markyen001/DR3-Resubmission/example images/20180928_162810.jpg

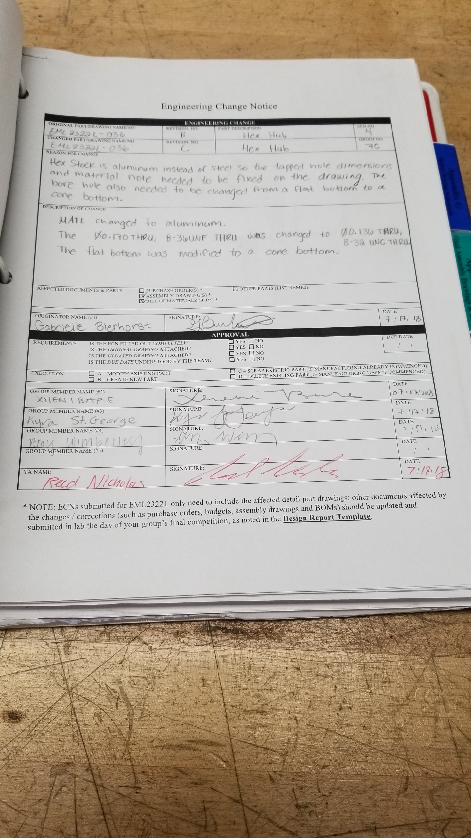
example images/20180928_162810.jpg
