markyen001/DR3-Resubmission/example images/20180928_162336.jpg

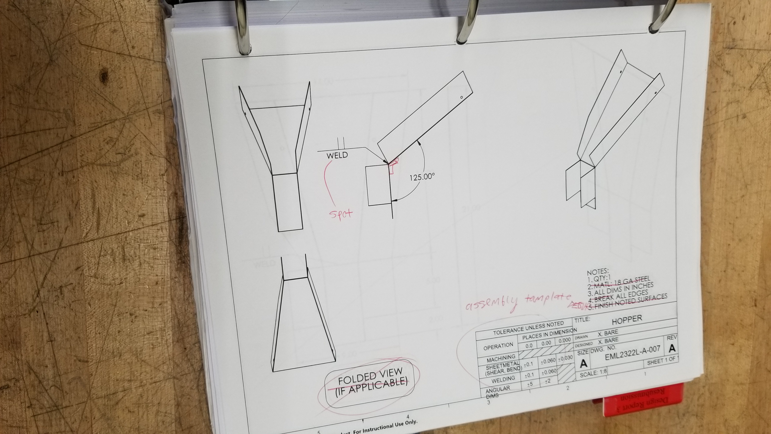
example images/20180928_162336.jpg
