markyen001/DR3-Resubmission/example images/20180928_162939.jpg

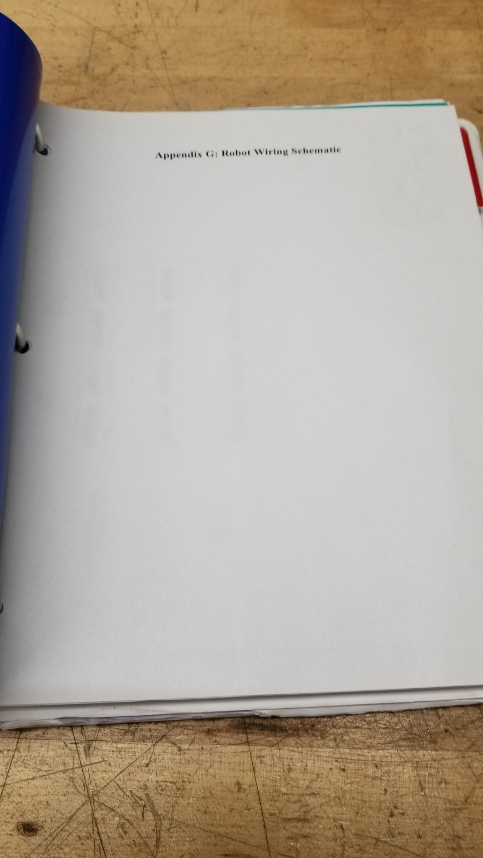
example images/20180928_162939.jpg
