markyen001/DR3-Resubmission/Documents Ready for Print/order of documents.docx

1. 0001 – 80/20 EXTRUSION
2. A9 – BALL MANIPULATOR TOTAL ASSEMBLY
  a. 0034 – BALL MANIPULATOR CHANNEL
  b. A6 – CLAW ASSEMBLY
    i. 0004 – 80/20 90 DEG ANGLE BRACKET
    ii. 0007 – 80/20 STRAIGHT BRACKET
    iii. 0036 – BALL MANIPULATOR CLAW – 5 in
    iv. 0037 – 80/20 LINEAR SLIDE
    v. 0038 – BALL MANIPULATOR CLAW – 4.5 in
    vi. 0039 – 10-24 LINEAR ACTUATOR MOUNT
    vii. 0040 – 30 IPM SPAL LINEAR ACTUATOR (2in)
  c. A7 – CLAW MOUNT
  d. A8 – GLOBE MOTOR BRACKET ASSEMBLY
  e. A19 – 4.5 RPM GLOBE MOTOR
3. A16 – PLATFORM WITH BOX/HOPPER/BUCKET
  a. A14 – HOPPER/BUCKET ASSEMBLY
    i. A5 – BUCKET MANIPULATOR TOTAL ASSEMBLY
      1. A4 – BUCKET MANIPULATOR
        a. A10 – 90-DEGREE BRACKET ASSEMBLY
        b. A11 – STRAIGHT BRACKET ASSEMBLY
        c. A18 – BUCKET GRABBER EXTRUSIONS
      2. A12 – BUCKET MANIPULATOR MOTOR ASSEMBLY
        a. 0025 – 15 RPM SEI GEAR MOTOR
        b. 0026 – BUCKET MANIPULATOR MOTOR HUB
        c. 0027 – BUCKET MANIPULATOR MOTOR MOUNT
    ii. A13 – HOPPER ASSEMBLY
      1. 0018 – BALL HOPPER – FOLDED
      2. 0019 – 11 in AL TUBING WITH HOLES FOR MOTOR
      3. 0021 – 10 in AL TUBING WITH HOLES FOR MOTOR
      4. 0022 – 10 in AL TUBING WITH NO HOLES
      5. 0023 – 11 in AL TUBING WITH NO HOLES
  b. A15 – PLATFORM WITH CONTROL BOX
    i. 0017 – CONTROL BOX
    ii. A3 – PLATFORM WITH WHEELS
      1. 0016 – 5 in CASTER WHEEL
      2. A1 – MOBILE PLATFORM FRAME
        a. A17 – MOBILE PLATFORM EXTRUSIONS
      3. A2 – WHEEL AND MOTOR ASSEMBLY
        a. 0008 – 44 RPM ENTSTORT RIGHT ANGLE MOTOR
        b. 0009 – ENTSTORT MOTOR MOUNT
        c. 0011 – DRIVE WHEEL HUB
        d. 0012 – 10 in WHEEL
