markyen001/DR3-Resubmission/Final Assembly Work/Work with This one/BM MASTER ASM.SLDASM

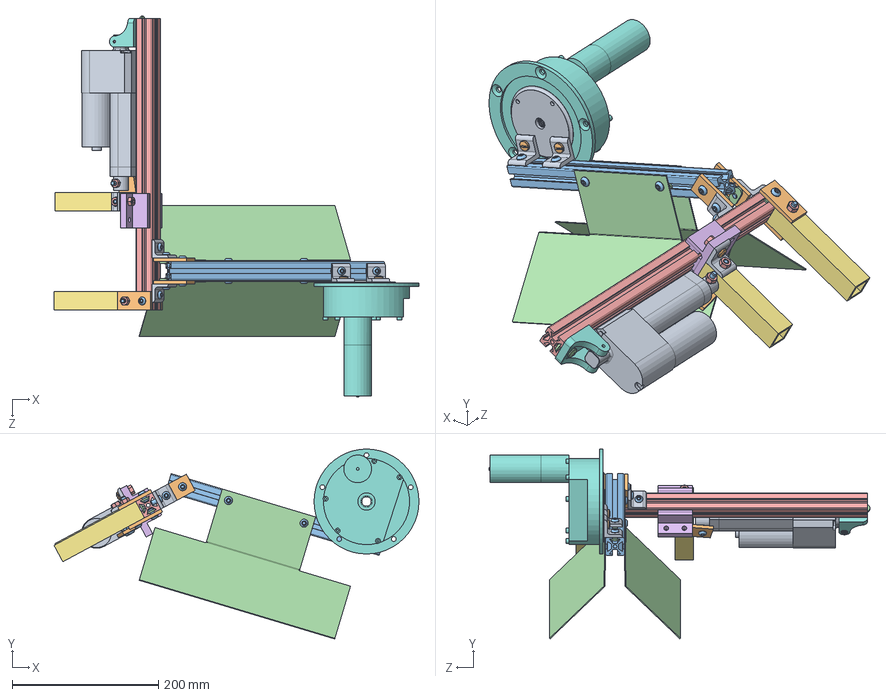
[picture p4: CAD file, 2018-10-10]
Final Assembly Work/Work with This one/BM MASTER ASM.SLDASM
499.5 x 259.9 x 521.4 mm
80-20 90 Degree Angle Bracket x 5
80-20 Straight Bracket x 5
0.25-20 Button Head Cap Screw (BHCS) x 14
80-20 0.25-20 T-NUT x 13
BM 8020
80-20 Linear Slide
BM 4.5in CLAW
Linear Actuator Mount (10-24)
30 IPM Spal Linear Actuator (2in)
90272A540_ZINC-PLTD STL PAN HEAD PHILLIPS MACHINE SCREW
91306A281_ZINC-PLATED ALLOY STEEL BUTTON-HEAD CAP SCREW x 3
90272A539_ZINC-PLTD STL PAN HEAD PHILLIPS MACHINE SCREW
94895A029_ZINC YELLOW-CHROMATE PLATED STEEL HEX NUT x 5
91251A249_BLACK-OXIDE ALLOY STEEL SOCKET HEAD SCREW
BM 5in CLAW
4.5 RPM Globe Gear Motor
4.5 RPM Globe Gear Motor Face Hub
M6x1 - 12mm GLOBE MOTOR SCREW x 2
BM ARM
BM ARM CHANNEL GM SIDE x 2
