markyen001/DR3-Resubmission/Final Assembly Work/Work with This one/GM ASM.SLDASM

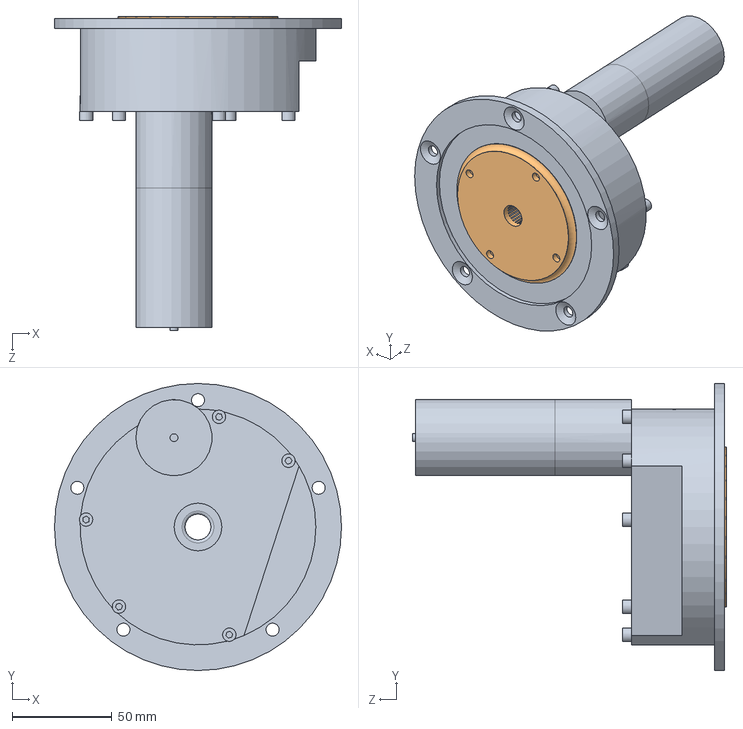
[picture p5: CAD file, 2018-10-10]
Final Assembly Work/Work with This one/GM ASM.SLDASM
143.6 x 143.6 x 157.2 mm
4.5 RPM Globe Gear Motor
4.5 RPM Globe Gear Motor Face Hub
