markyen001/DR3-Resubmission/Final Assembly Work/Work with This one/Wheel and Motor Total Assembly.SLDASM

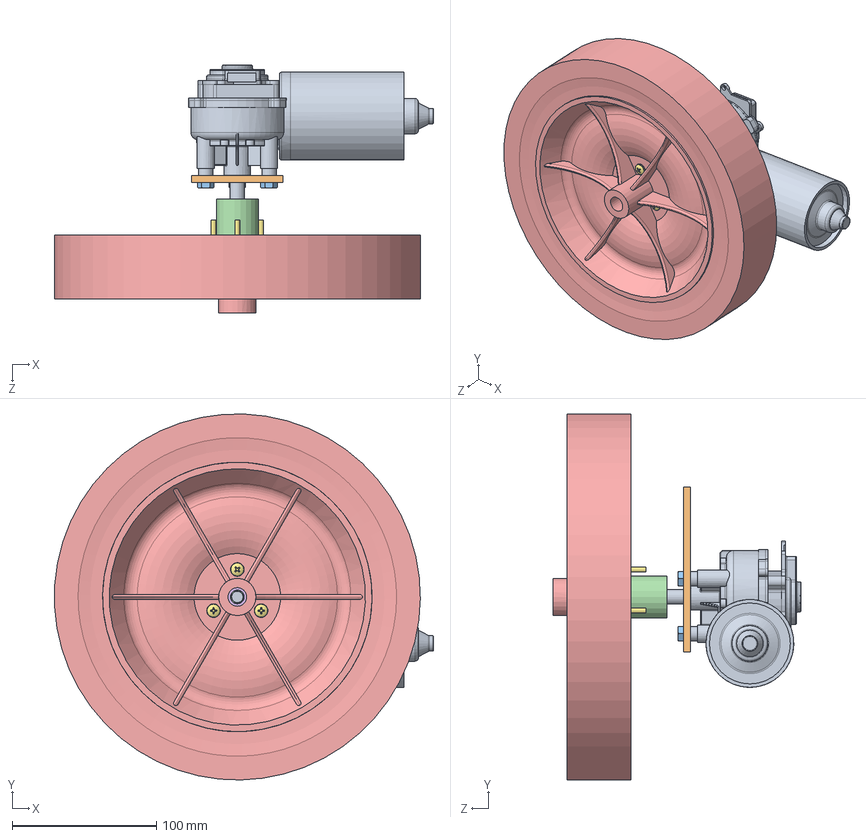
[picture p6: CAD file, 2018-10-10]
Final Assembly Work/Work with This one/Wheel and Motor Total Assembly.SLDASM
263.0 x 253.9 x 172.4 mm
44 RPM Entstort Right Angle Gear Motor
Motor Mount
Entstort Screw x 3
Wheel Hub
10 Inch Wheel
Entstort Shaft Nut
0013 10-24 x 1.25 in PHILIPS HEAD SCREW x 3
