markyen001/DR3-Resubmission/Final Assembly Work/Work with This one/MOBILE PLATFORM FRAME.SLDASM

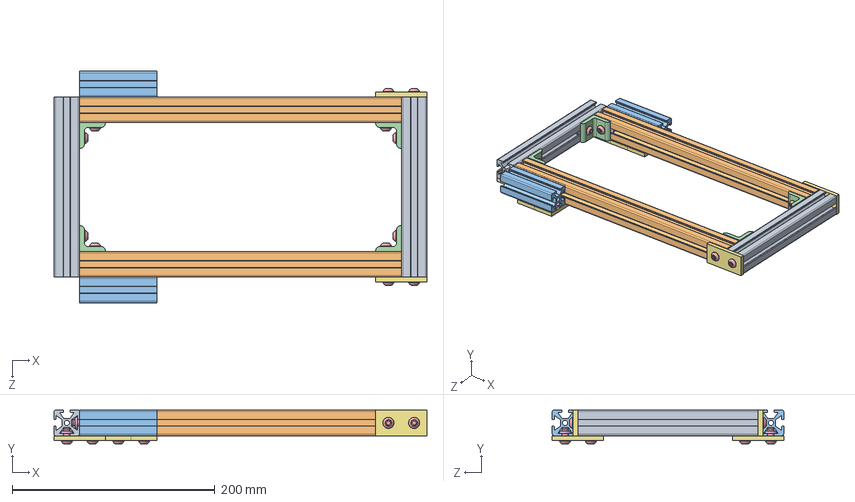
[picture p7: CAD file, 2018-10-10]
Final Assembly Work/Work with This one/MOBILE PLATFORM FRAME.SLDASM
368.3 x 33.5 x 228.6 mm
80-20 Extrusion 7 inch (simplified) x 2
80-20 Extrusion 12.5 inch (simplified) x 2
80-20 Extrusion 3 inch (simplified) x 2
80-20 90 Degree Angle Bracket x 4
0.25-20 Button Head Cap Screw (BHCS) x 24
80-20 0.25-20 T-NUT x 22
80-20 Straight Bracket x 8
