markyen001/DR3-Resubmission/Final Assembly Work/Work with This one/BM Mounting SUBASM.SLDASM

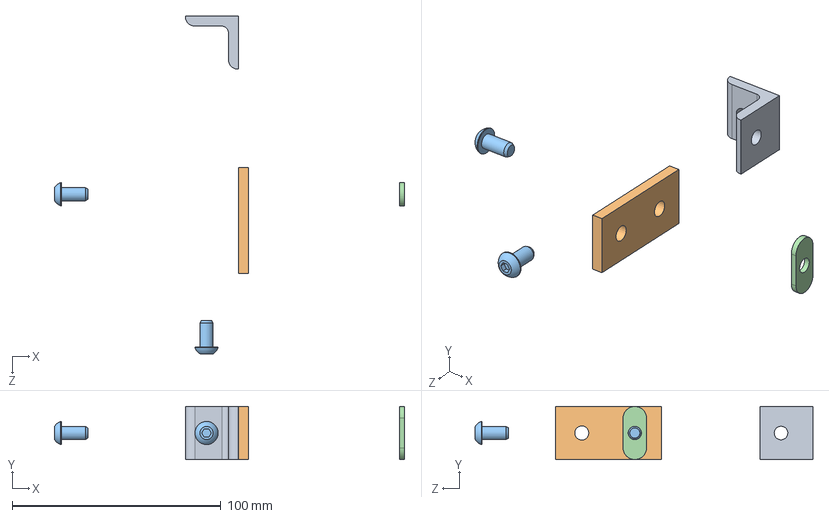
[picture p8: CAD file, 2018-10-10]
Final Assembly Work/Work with This one/BM Mounting SUBASM.SLDASM
167.6 x 25.4 x 161.7 mm
80-20 90 Degree Angle Bracket
80-20 Straight Bracket
0.25-20 Button Head Cap Screw (BHCS) x 2
80-20 0.25-20 T-NUT
