markyen001/DR3-Resubmission/Final Assembly Work/Work with This one/A013 HOPPER ASSEMBLY.SLDASM

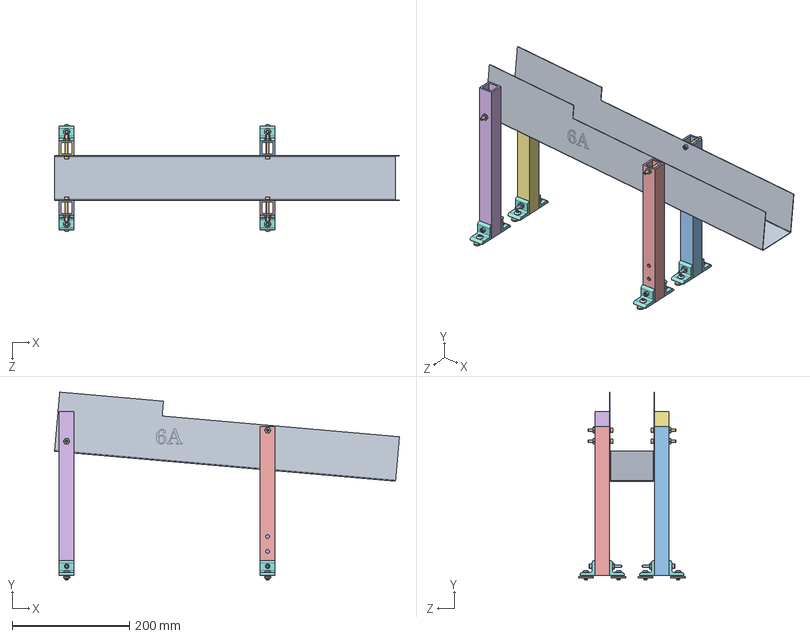
[picture p9: CAD file, 2018-10-10]
Final Assembly Work/Work with This one/A013 HOPPER ASSEMBLY.SLDASM
588.6 x 320.4 x 182.9 mm
0019 BALL HOPPER
10-24 Thread 1.5 Length Socket Head Screw x 4
10-inch AL tube - no motor holes
10-24 HEX NUT x 8
10-inch AL tube - with motor holes
11-inch AL tube - no motor hole
11-inch AL tube - with motor hole
80-20 90 Degree Angle Bracket x 8
0.25-20 Button Head Cap Screw (BHCS) x 8
80-20 0.25-20 T-NUT x 8
10-24 Thread 2 Length Socket Head Screw x 4
