markyen001/DR3-Resubmission/Final Assembly Work/Work with This one/Hopper and Bucket Manipulator Assembly.SLDASM

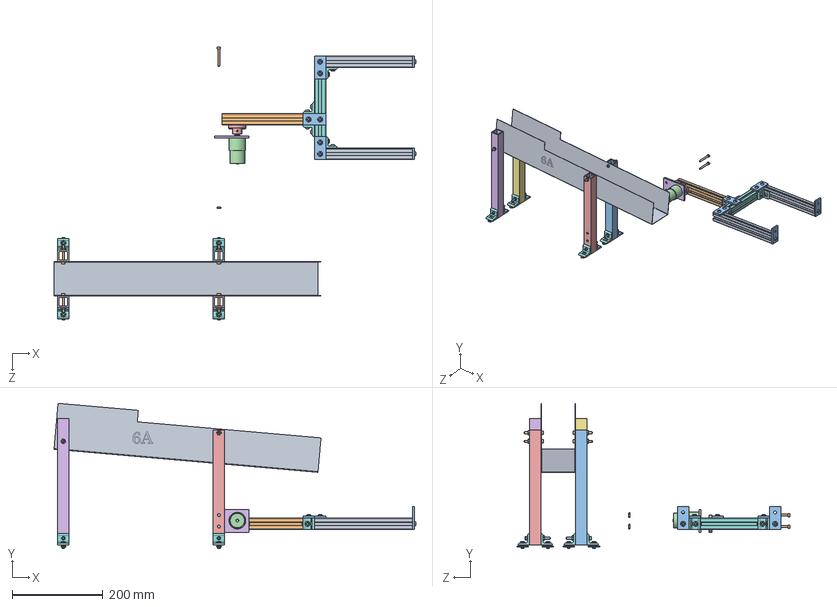
[picture p10: CAD file, 2018-10-10]
Final Assembly Work/Work with This one/Hopper and Bucket Manipulator Assembly.SLDASM
798.0 x 320.4 x 602.7 mm
0019 BALL HOPPER
10-24 Thread 1.5 Length Socket Head Screw x 6
10-inch AL tube - no motor holes
10-24 HEX NUT x 10
10-inch AL tube - with motor holes
11-inch AL tube - no motor hole
11-inch AL tube - with motor hole
80-20 90 Degree Angle Bracket x 12
0.25-20 Button Head Cap Screw (BHCS) x 24
80-20 0.25-20 T-NUT x 24
10-24 Thread 2 Length Socket Head Screw x 4
15 RPM SEI Gear Motor
Bucket Arm Hub
Bucket Motor Mount
10-24 Thread 0.25 Length Set Screw for Bucket Motor Shaft
80-20 Extrusion 7 inch (simplified)
80-20 Extrusion 8.5 inch (simplified) x 2
80-20 Extrusion 8 inch (simplified)
80-20 Straight Bracket x 5
10-24 Thread 0.5 Inch Length Screw for Motor Hub x 2
