markyen001/DR3-Resubmission/Final Assembly Work/Work with This one/STRAIGHT BRACKET ASSEMBLY.SLDASM

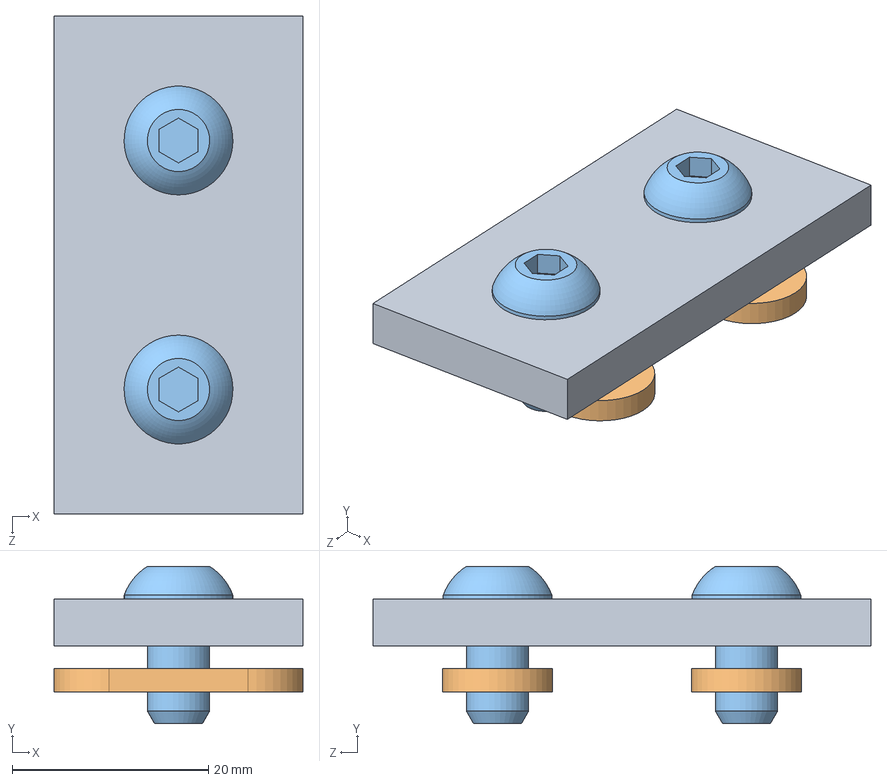
[picture p11: CAD file, 2018-10-10]
Final Assembly Work/Work with This one/STRAIGHT BRACKET ASSEMBLY.SLDASM
25.4 x 16.1 x 50.8 mm
80-20 Straight Bracket
80-20 0.25-20 T-NUT x 2
0.25-20 Button Head Cap Screw (BHCS) x 2
