markyen001/DR3-Resubmission/Final Assembly Work/Work with This one/90-DEGREE BRACKET ASSEMBLY.SLDASM

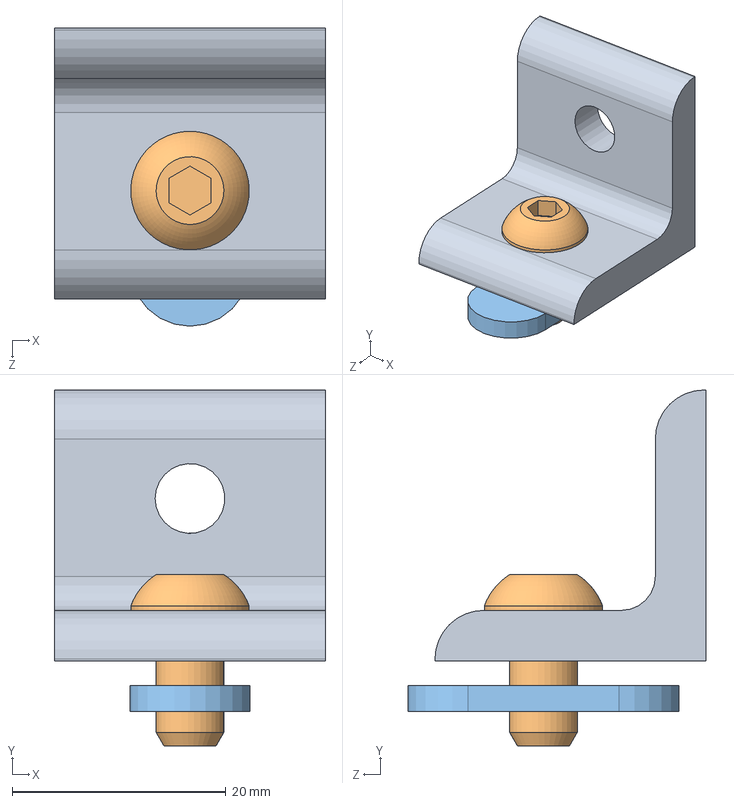
[picture p12: CAD file, 2018-10-10]
Final Assembly Work/Work with This one/90-DEGREE BRACKET ASSEMBLY.SLDASM
25.4 x 33.3 x 27.9 mm
80-20 90 Degree Angle Bracket
0.25-20 Button Head Cap Screw (BHCS)
80-20 0.25-20 T-NUT
