markyen001/DR3-Resubmission/Final Assembly Work/Work with This one/GM Mounting SUBASM.SLDASM

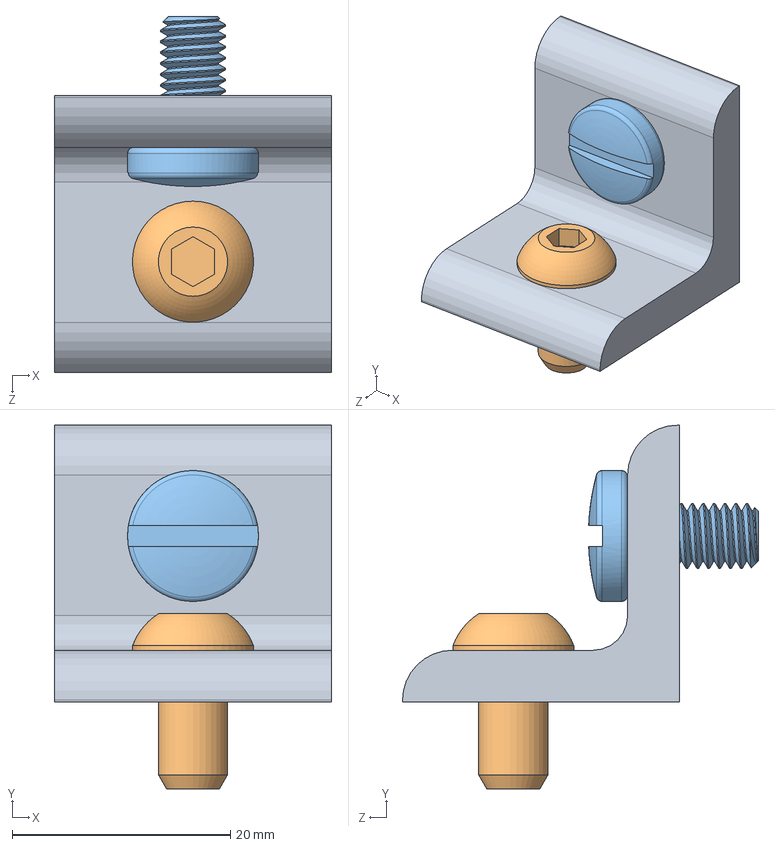
[picture p13: CAD file, 2018-10-10]
Final Assembly Work/Work with This one/GM Mounting SUBASM.SLDASM
25.4 x 33.3 x 32.6 mm
80-20 90 Degree Angle Bracket
0.25-20 Button Head Cap Screw (BHCS)
M6x1 - 12mm GLOBE MOTOR SCREW
