markyen001/DR3-Resubmission/Final Assembly Work/Work with This one/PLATFORM WITH WHEELS.SLDASM

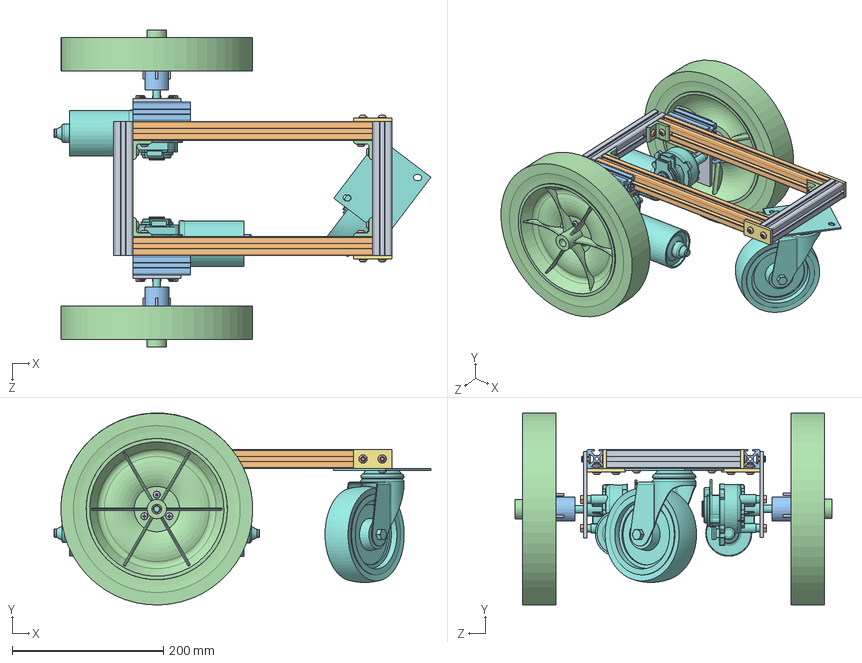
[picture p14: CAD file, 2018-10-10]
Final Assembly Work/Work with This one/PLATFORM WITH WHEELS.SLDASM
499.2 x 254.2 x 419.9 mm
80-20 Extrusion 7 inch (simplified) x 2
80-20 Extrusion 12.5 inch (simplified) x 2
80-20 Extrusion 3 inch (simplified) x 2
80-20 90 Degree Angle Bracket x 4
0.25-20 Button Head Cap Screw (BHCS) x 26
80-20 0.25-20 T-NUT x 28
80-20 Straight Bracket x 8
44 RPM Entstort Right Angle Gear Motor x 2
Motor Mount x 2
Entstort Screw x 6
Wheel Hub x 2
10 Inch Wheel x 2
Entstort Shaft Nut x 2
0013 10-24 x 1.25 in PHILIPS HEAD SCREW x 6
10-24 x 3-8 Socket Screw for Mount x 4
Caster Wheel
