markyen001/DR3-Resubmission/Final Assembly Work/Work with This one/BM Claw SUBASM.SLDASM

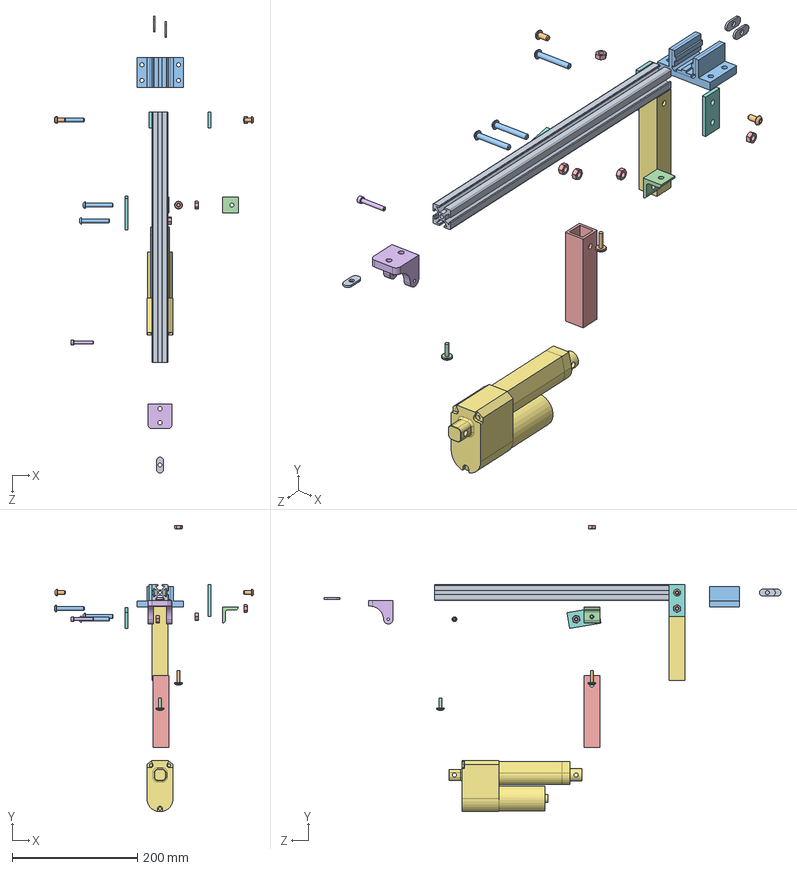
[picture p15: CAD file, 2018-10-10]
Final Assembly Work/Work with This one/BM Claw SUBASM.SLDASM
317.8 x 456.5 x 728.5 mm
BM 8020
0.25-20 Button Head Cap Screw (BHCS) x 2
80-20 Linear Slide
80-20 90 Degree Angle Bracket
BM 4.5in CLAW
Linear Actuator Mount (10-24)
30 IPM Spal Linear Actuator (2in)
80-20 Straight Bracket x 3
80-20 0.25-20 T-NUT x 3
90272A540_ZINC-PLTD STL PAN HEAD PHILLIPS MACHINE SCREW
91306A281_ZINC-PLATED ALLOY STEEL BUTTON-HEAD CAP SCREW x 3
90272A539_ZINC-PLTD STL PAN HEAD PHILLIPS MACHINE SCREW
94895A029_ZINC YELLOW-CHROMATE PLATED STEEL HEX NUT x 5
91251A249_BLACK-OXIDE ALLOY STEEL SOCKET HEAD SCREW
BM 5in CLAW
