markyen001/DR3-Resubmission/Final Assembly Work/Work with This one/BUCKET GRABBER ASSEMBLY.SLDASM

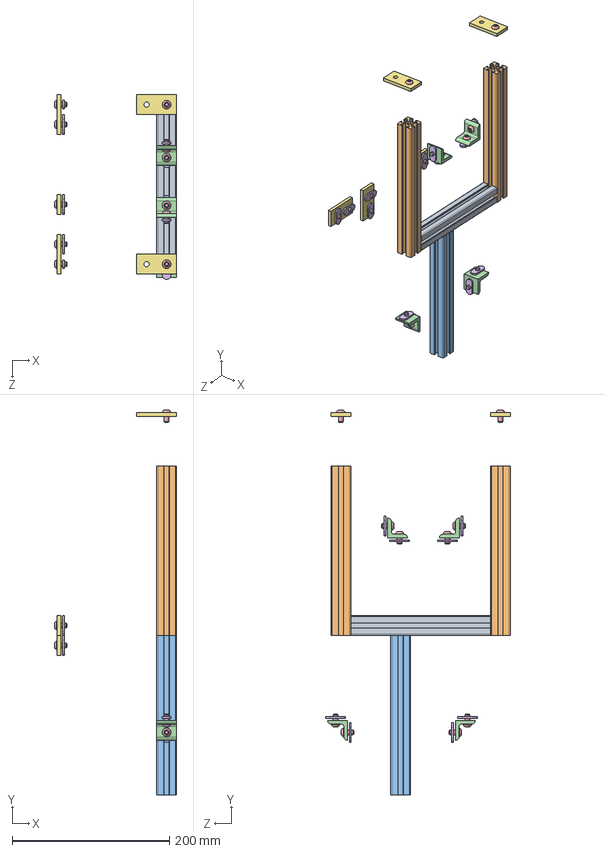
[picture p16: CAD file, 2018-10-10]
Final Assembly Work/Work with This one/BUCKET GRABBER ASSEMBLY.SLDASM
155.5 x 490.1 x 235.2 mm
80-20 Extrusion 7 inch (simplified)
80-20 Extrusion 8.5 inch (simplified) x 2
80-20 Extrusion 8 inch (simplified)
80-20 90 Degree Angle Bracket x 4
0.25-20 Button Head Cap Screw (BHCS) x 16
80-20 0.25-20 T-NUT x 14
80-20 Straight Bracket x 5
