markyen001/DR3-Resubmission/Final Assembly Work/Work with This one/Bucket Motor Total Assembly.SLDASM

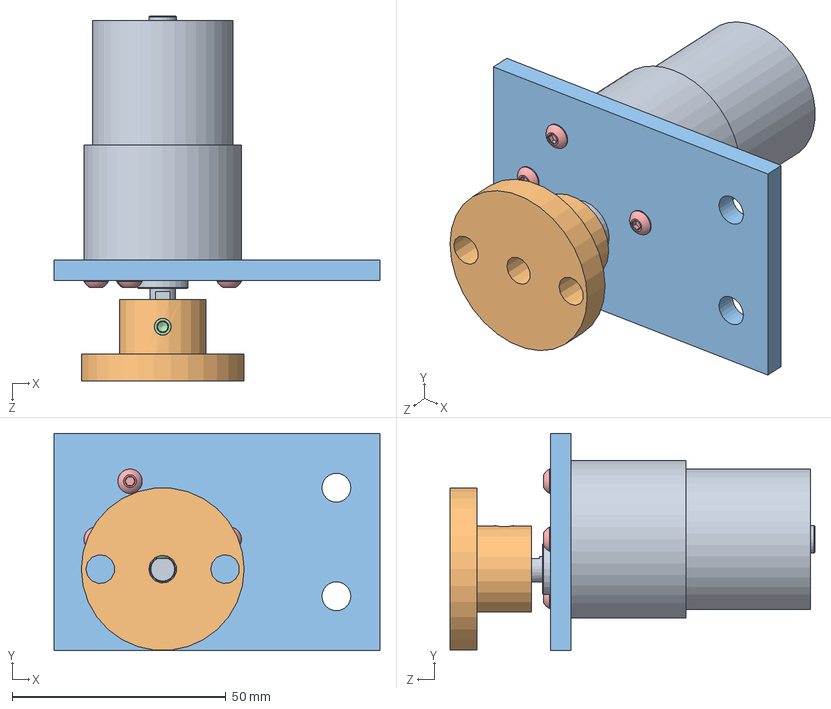
[picture p17: CAD file, 2018-10-10]
Final Assembly Work/Work with This one/Bucket Motor Total Assembly.SLDASM
76.2 x 50.8 x 85.4 mm
15 RPM SEI Gear Motor
Bucket Arm Hub
Bucket Motor Mount
10-24 Thread 0.25 Length Set Screw for Bucket Motor Shaft
M3 x 0.5 - 8 mm ROUND HEAD SCREW x 4
