markyen001/DR3-Resubmission/Final Assembly Work/Work with This one/Motor Mount Assembly.SLDASM

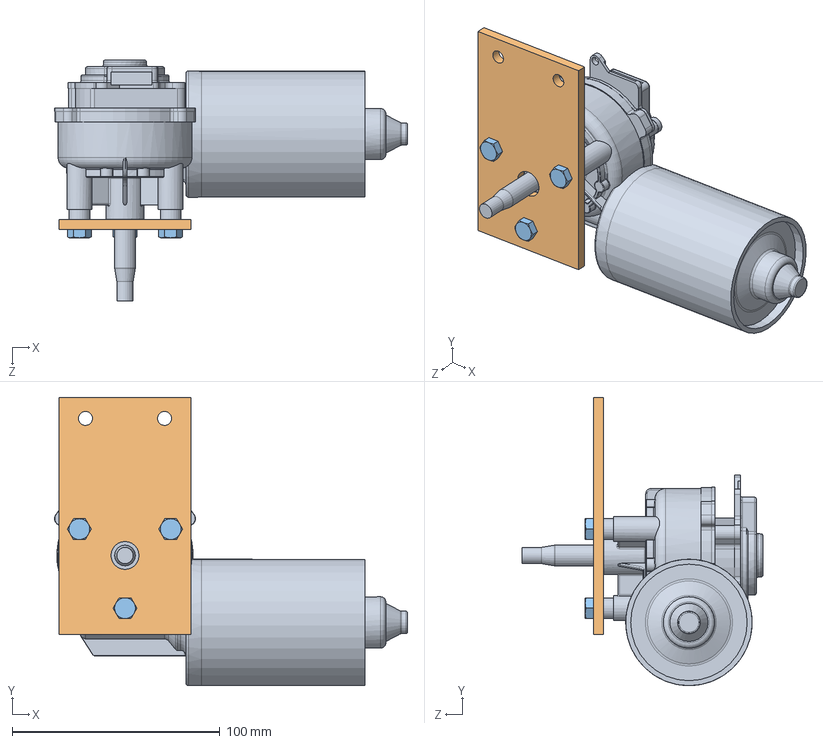
[picture p18: CAD file, 2018-10-10]
Final Assembly Work/Work with This one/Motor Mount Assembly.SLDASM
170.1 x 138.9 x 116.0 mm
44 RPM Entstort Right Angle Gear Motor
Motor Mount
Entstort Screw x 3
