markyen001/DR3-Resubmission/Final Assembly Work/Work with This one/BUCKET GRABBER EXTRUSIONS.SLDASM

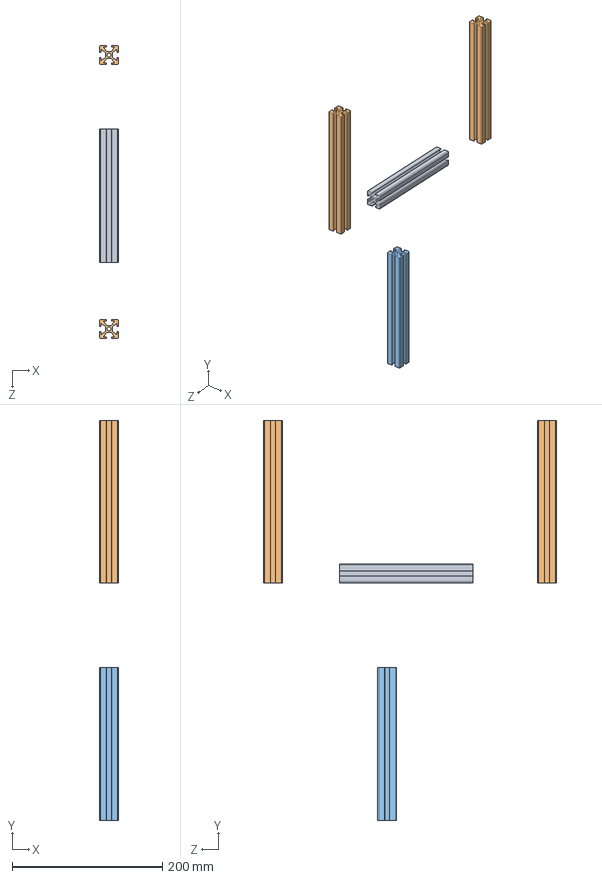
[picture p19: CAD file, 2018-10-10]
Final Assembly Work/Work with This one/BUCKET GRABBER EXTRUSIONS.SLDASM
25.4 x 531.7 x 389.6 mm
80-20 Extrusion 7 inch (simplified)
80-20 Extrusion 8.5 inch (simplified) x 2
80-20 Extrusion 8 inch (simplified)
