markyen001/DR3-Resubmission/Final Assembly Work/Work with This one/Bucket Manipulator Total Assembly.SLDASM

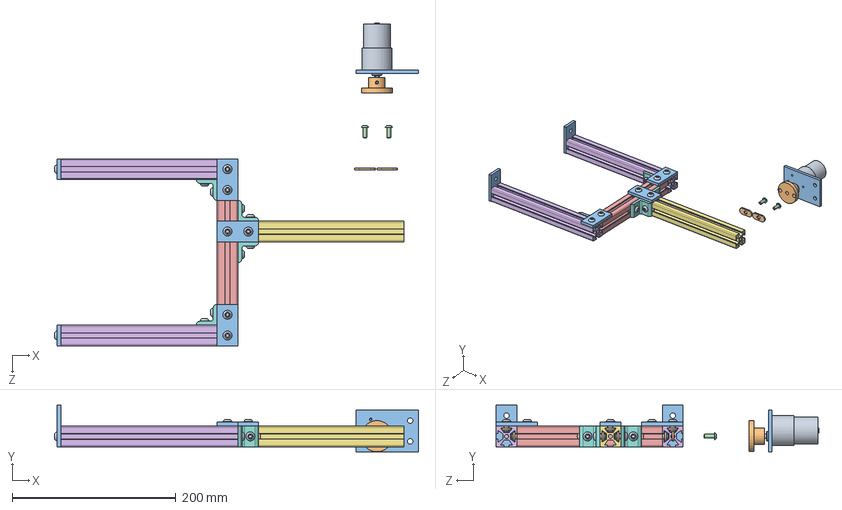
[picture p20: CAD file, 2018-10-10]
Final Assembly Work/Work with This one/Bucket Manipulator Total Assembly.SLDASM
444.6 x 56.9 x 394.3 mm
15 RPM SEI Gear Motor
Bucket Arm Hub
Bucket Motor Mount
10-24 Thread 0.25 Length Set Screw for Bucket Motor Shaft
80-20 Extrusion 7 inch (simplified)
80-20 Extrusion 8.5 inch (simplified) x 2
80-20 Extrusion 8 inch (simplified)
80-20 90 Degree Angle Bracket x 4
0.25-20 Button Head Cap Screw (BHCS) x 16
80-20 0.25-20 T-NUT x 16
80-20 Straight Bracket x 5
10-24 Thread 0.5 Inch Length Screw for Motor Hub x 2
