markyen001/DR3-Resubmission/Final Assembly Work/Work with This one/MOBILE PLATFORM EXTRUSIONS.SLDASM

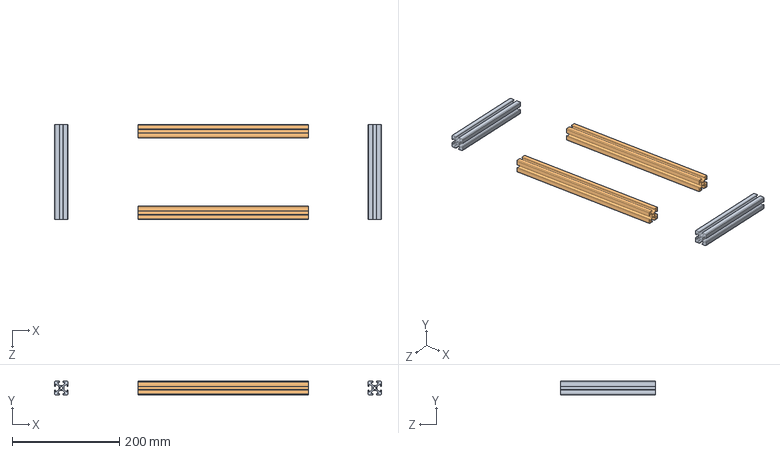
[picture p21: CAD file, 2018-10-10]
Final Assembly Work/Work with This one/MOBILE PLATFORM EXTRUSIONS.SLDASM
609.1 x 25.4 x 177.8 mm
80-20 Extrusion 7 inch (simplified) x 2
80-20 Extrusion 12.5 inch (simplified) x 2
