markyen001/DR3-Resubmission/Final Assembly Work/Work with This one/Wheel Hub Assembly.SLDASM

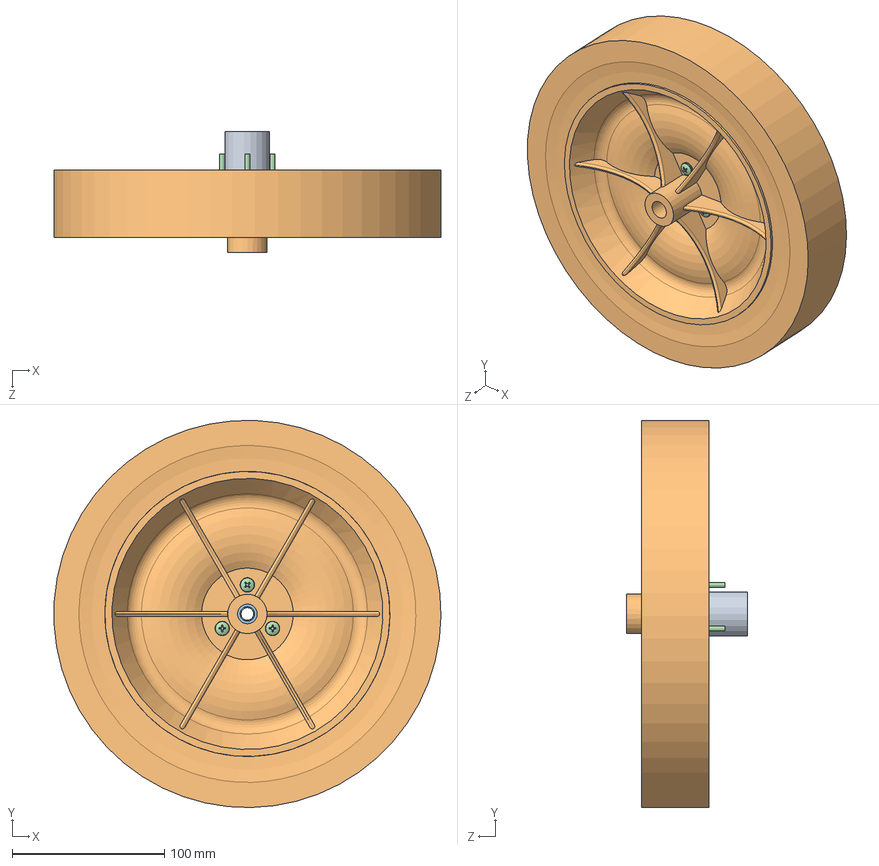
[picture p22: CAD file, 2018-10-10]
Final Assembly Work/Work with This one/Wheel Hub Assembly.SLDASM
253.8 x 253.9 x 79.4 mm
Wheel Hub
10 Inch Wheel
Entstort Shaft Nut
0013 10-24 x 1.25 in PHILIPS HEAD SCREW x 3
