markyen001/DR3-Resubmission/Part and Assembly Files/BM 5IN CLAW SUBASM.SLDASM

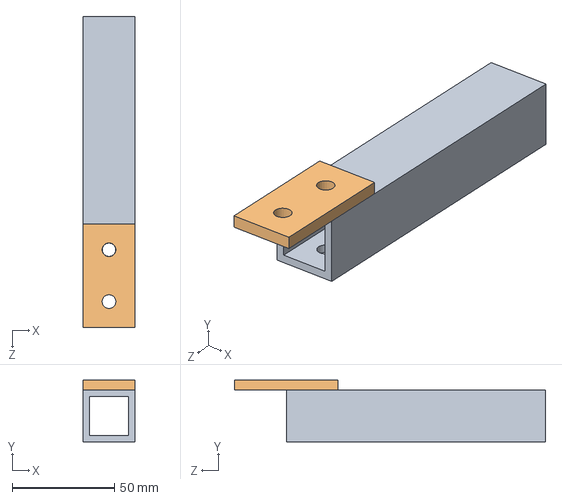
[picture p23: CAD file, 2018-10-06]
Part and Assembly Files/BM 5IN CLAW SUBASM.SLDASM
25.4 x 30.2 x 152.4 mm
BM 5in CLAW
80-20 Straight Bracket
