markyen001/DR3-Resubmission/Final Assembly Work/Work with This one/Linear Actuator Mount (10-24).SLDPRT

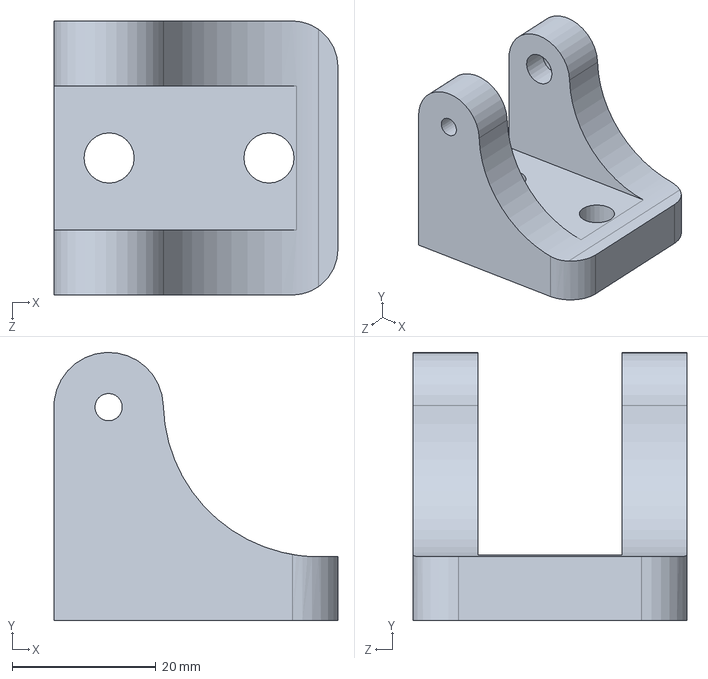
[picture p24: CAD file, 2018-10-09]
Final Assembly Work/Work with This one/Linear Actuator Mount (10-24).SLDPRT
39.5 x 37.3 x 38.1 mm
