markyen001/DR3-Resubmission/Final Assembly Work/Work with This one/4.5 RPM Globe Gear Motor Face Hub.SLDPRT

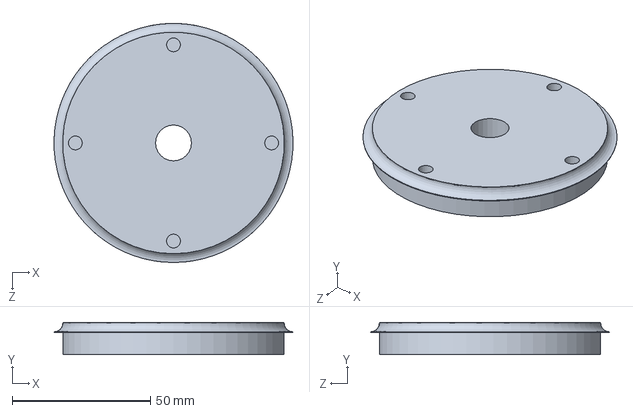
[picture p25: CAD file, 2018-10-09]
Final Assembly Work/Work with This one/4.5 RPM Globe Gear Motor Face Hub.SLDPRT
86.3 x 11.7 x 86.3 mm
