markyen001/DR3-Resubmission/Final Assembly Work/Work with This one/11-inch AL tube - no motor hole.SLDPRT

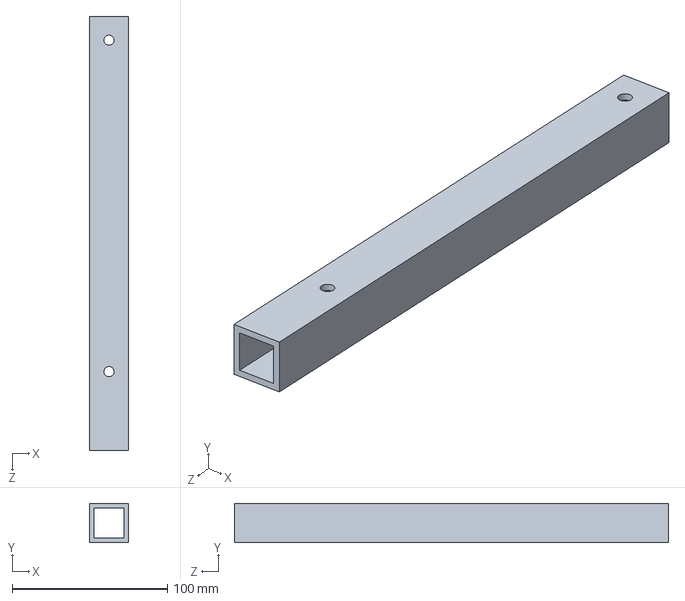
[picture p26: CAD file, 2018-10-09]
Final Assembly Work/Work with This one/11-inch AL tube - no motor hole.SLDPRT
25.4 x 25.4 x 279.4 mm
