markyen001/DR3-Resubmission/Final Assembly Work/Work with This one/10-inch AL tube - no motor holes.SLDPRT

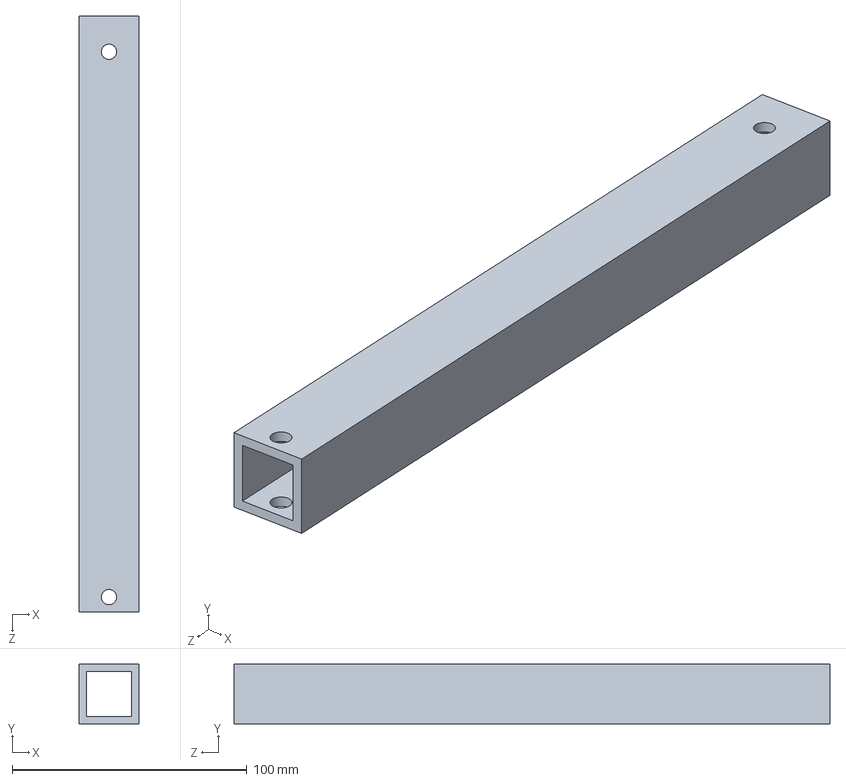
[picture p27: CAD file, 2018-10-09]
Final Assembly Work/Work with This one/10-inch AL tube - no motor holes.SLDPRT
25.4 x 25.4 x 254.0 mm
