markyen001/DR3-Resubmission/Part and Assembly Files/BM ARM CHANNEL.SLDPRT

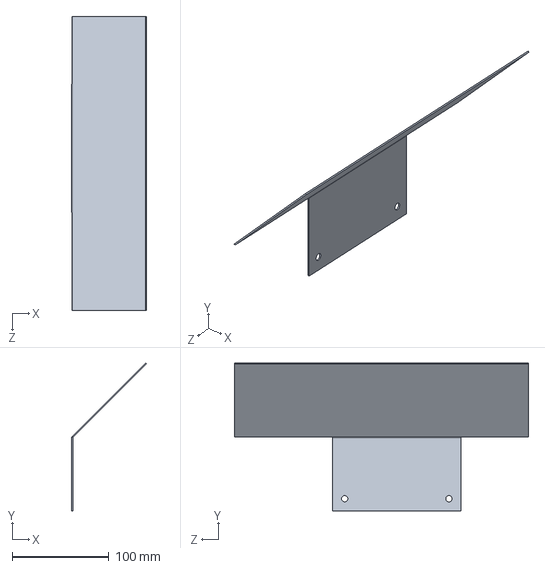
[picture p28: CAD file, 2018-10-06]
Part and Assembly Files/BM ARM CHANNEL.SLDPRT
77.4 x 153.3 x 304.8 mm
