markyen001/DR3-Resubmission/Final Assembly Work/Work with This one/Bucket Arm Hub.SLDPRT

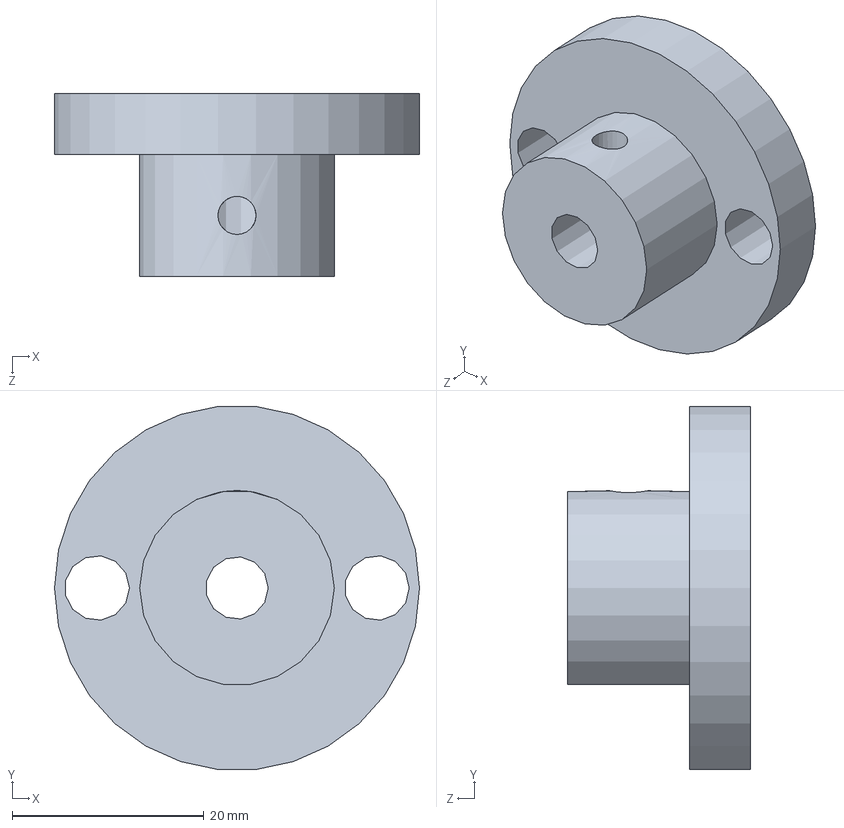
[picture p29: CAD file, 2018-10-09]
Final Assembly Work/Work with This one/Bucket Arm Hub.SLDPRT
38.1 x 37.9 x 19.1 mm
