markyen001/DR3-Resubmission/Part and Assembly Files/ALSQ TUBING.SLDPRT

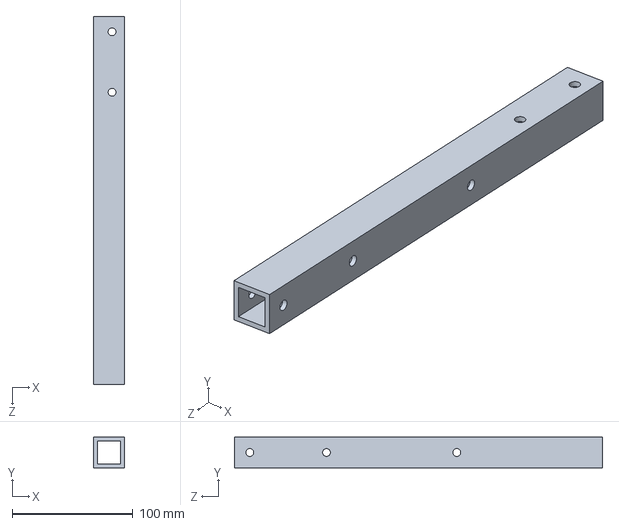
[picture p30: CAD file, 2018-10-05]
Part and Assembly Files/ALSQ TUBING.SLDPRT
25.4 x 25.4 x 304.8 mm
