markyen001/DR3-Resubmission/Final Assembly Work/Work with This one/80-20 Extrusion 8.5 inch (simplified).SLDPRT

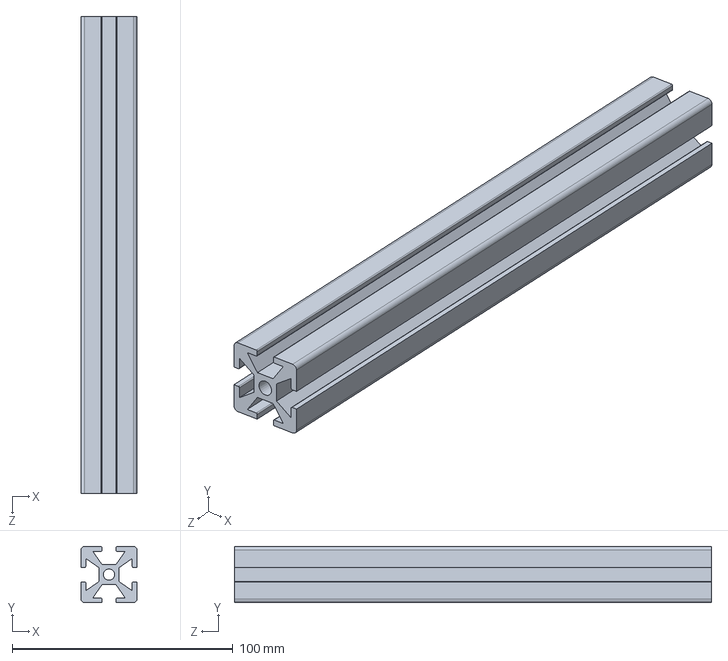
[picture p31: CAD file, 2018-10-08]
Final Assembly Work/Work with This one/80-20 Extrusion 8.5 inch (simplified).SLDPRT
25.4 x 25.4 x 215.9 mm
