markyen001/DR3-Resubmission/Final Assembly Work/Work with This one/80-20 Extrusion 8 inch (simplified).SLDPRT

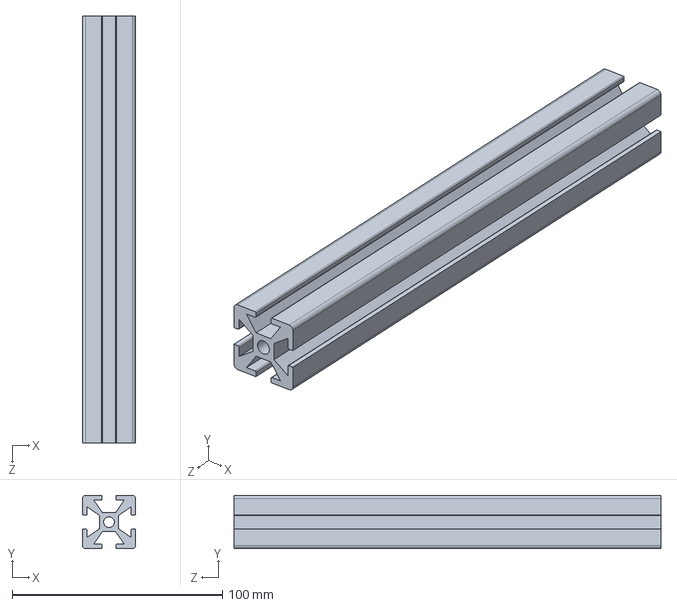
[picture p32: CAD file, 2018-10-08]
Final Assembly Work/Work with This one/80-20 Extrusion 8 inch (simplified).SLDPRT
25.4 x 25.4 x 203.2 mm
