markyen001/DR3-Resubmission/Final Assembly Work/Work with This one/0019 BALL HOPPER.SLDPRT

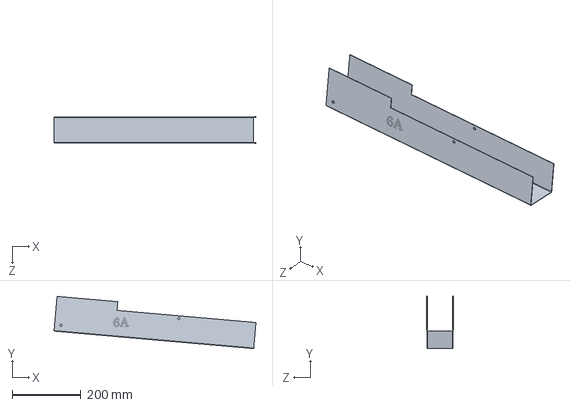
[picture p33: CAD file, 2018-10-08]
Final Assembly Work/Work with This one/0019 BALL HOPPER.SLDPRT
588.6 x 152.1 x 76.2 mm
