markyen001/DR3-Resubmission/Final Assembly Work/Work with This one/15 RPM SEI Gear Motor.SLDPRT

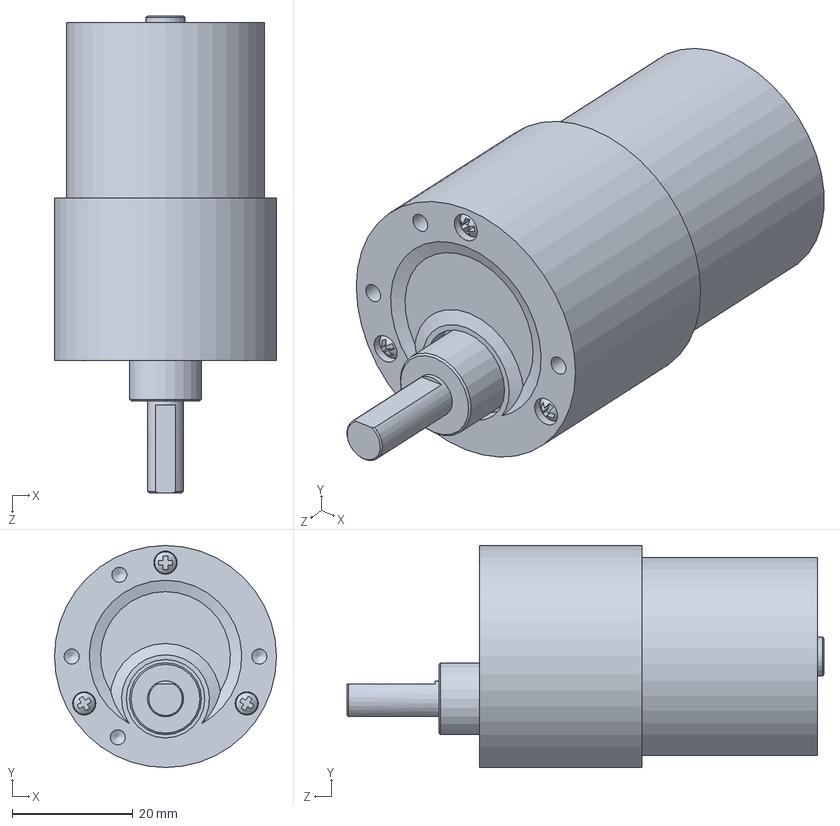
[picture p34: CAD file, 2018-10-08]
Final Assembly Work/Work with This one/15 RPM SEI Gear Motor.SLDPRT
36.8 x 36.8 x 79.1 mm
