markyen001/DR3-Resubmission/Final Assembly Work/Work with This one/BM ARM.SLDPRT

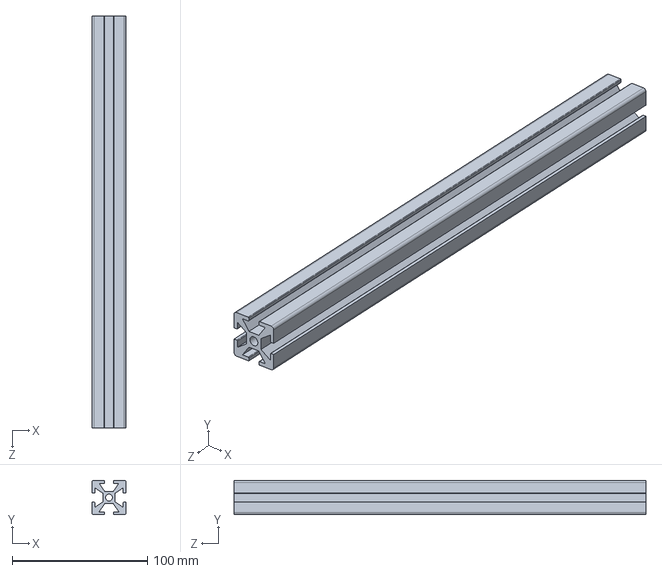
[picture p35: CAD file, 2018-10-08]
Final Assembly Work/Work with This one/BM ARM.SLDPRT
25.4 x 25.4 x 304.8 mm
