markyen001/DR3-Resubmission/Part and Assembly Files/5-inch AL tube.SLDPRT

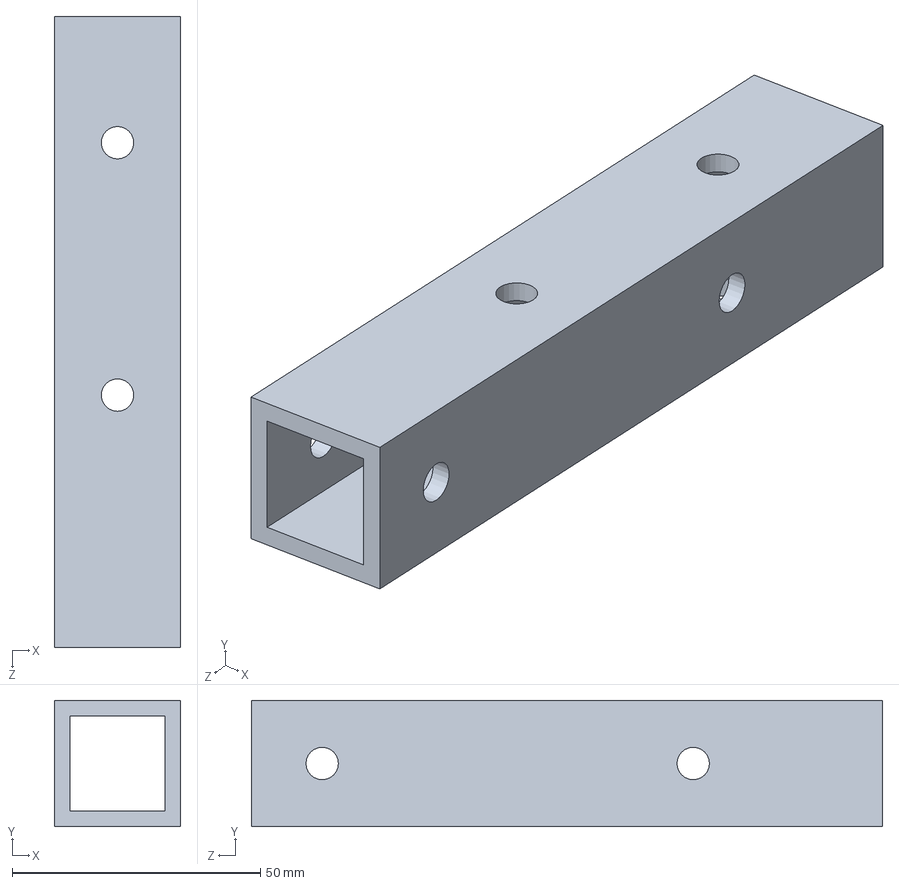
[picture p36: CAD file, 2018-10-04]
Part and Assembly Files/5-inch AL tube.SLDPRT
25.4 x 25.4 x 127.0 mm
