markyen001/DR3-Resubmission/Final Assembly Work/Work with This one/Bucket Motor Mount.SLDPRT

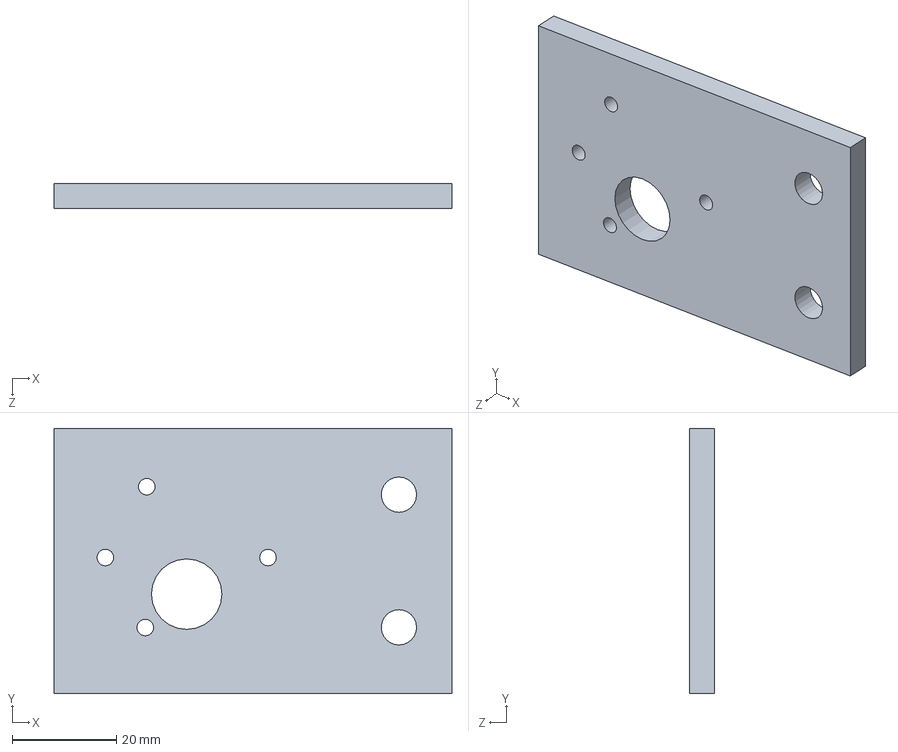
[picture p37: CAD file, 2018-10-06]
Final Assembly Work/Work with This one/Bucket Motor Mount.SLDPRT
76.2 x 50.8 x 4.76 mm
