markyen001/DR3-Resubmission/Final Assembly Work/Work with This one/BM ARM CHANNEL UNFOLDED.SLDPRT

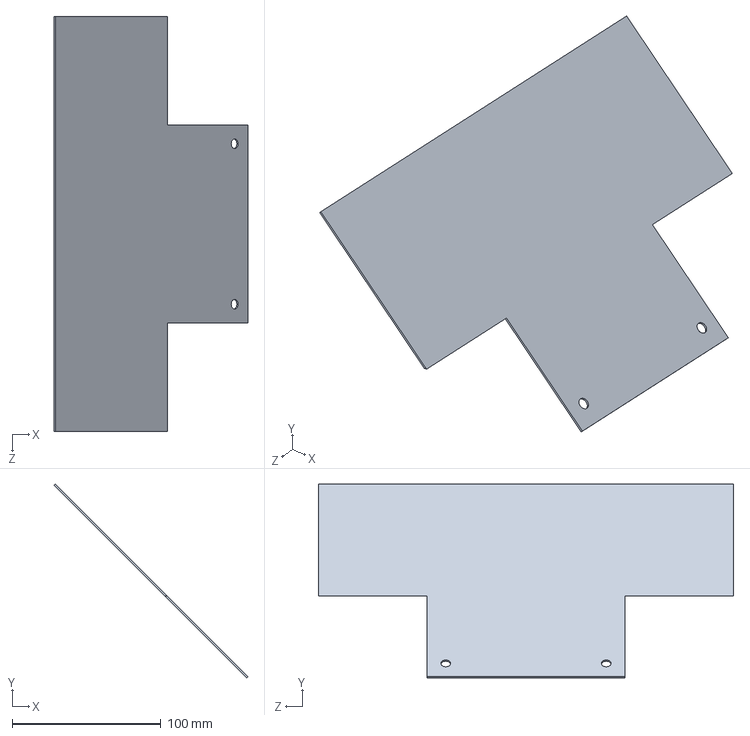
[picture p38: CAD file, 2018-10-06]
Final Assembly Work/Work with This one/BM ARM CHANNEL UNFOLDED.SLDPRT
130.5 x 130.5 x 279.4 mm
