markyen001/DR3-Resubmission/Final Assembly Work/Work with This one/BM ARM CHANNEL GM SIDE.SLDPRT

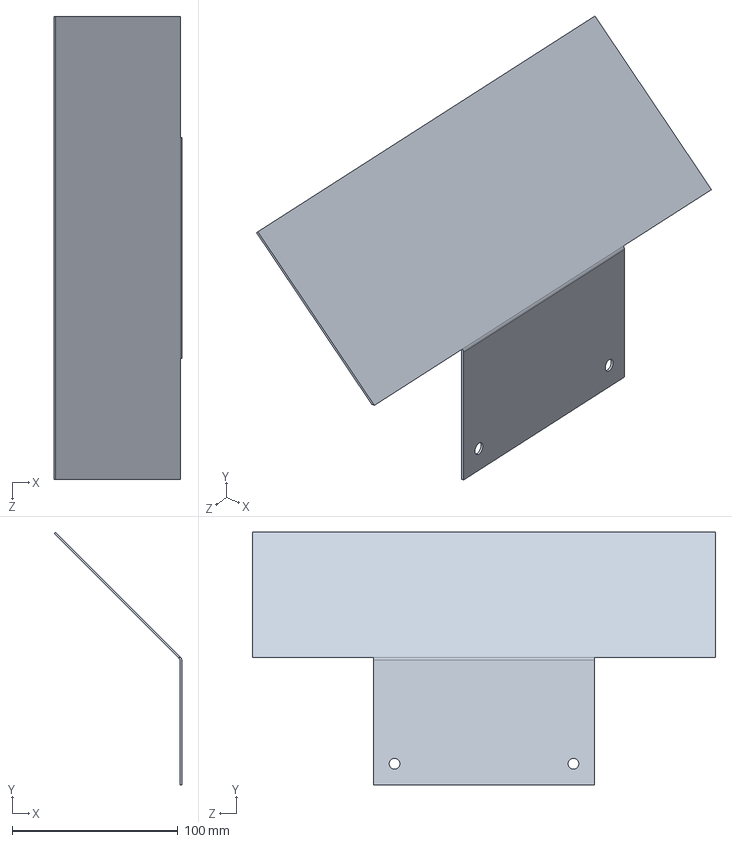
[picture p39: CAD file, 2018-10-06]
Final Assembly Work/Work with This one/BM ARM CHANNEL GM SIDE.SLDPRT
77.1 x 152.4 x 279.4 mm
