markyen001/DR3-Resubmission/Final Assembly Work/Work with This one/Caster Wheel.SLDPRT

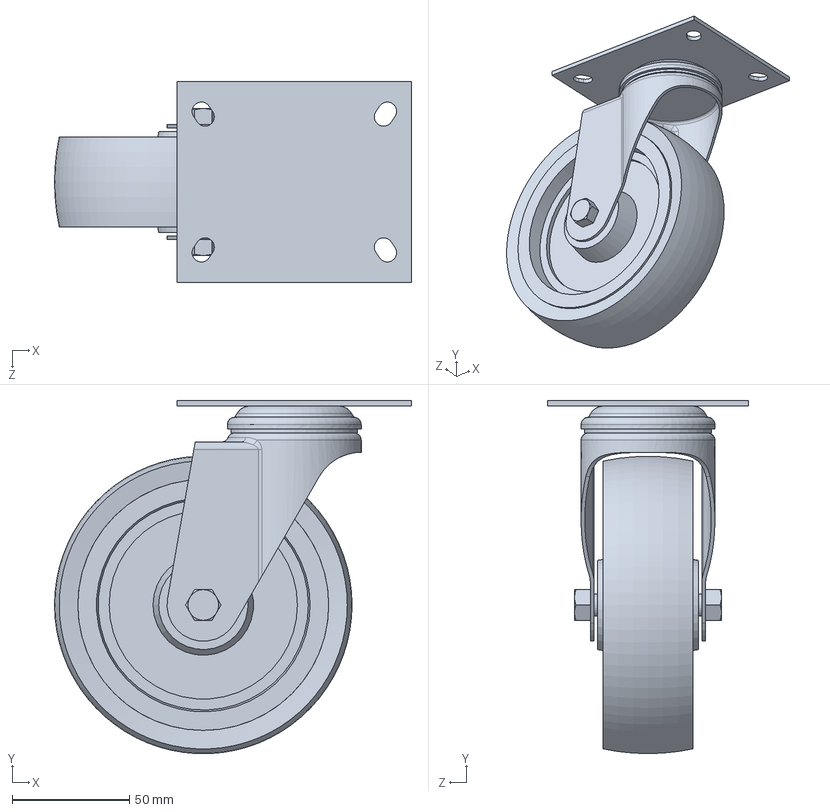
[picture p40: CAD file, 2018-10-06]
Final Assembly Work/Work with This one/Caster Wheel.SLDPRT
152.4 x 150.8 x 85.7 mm
