markyen001/DR3-Resubmission/Final Assembly Work/Work with This one/BM ARM CHANNEL GM SIDE UNFOLDED.SLDPRT

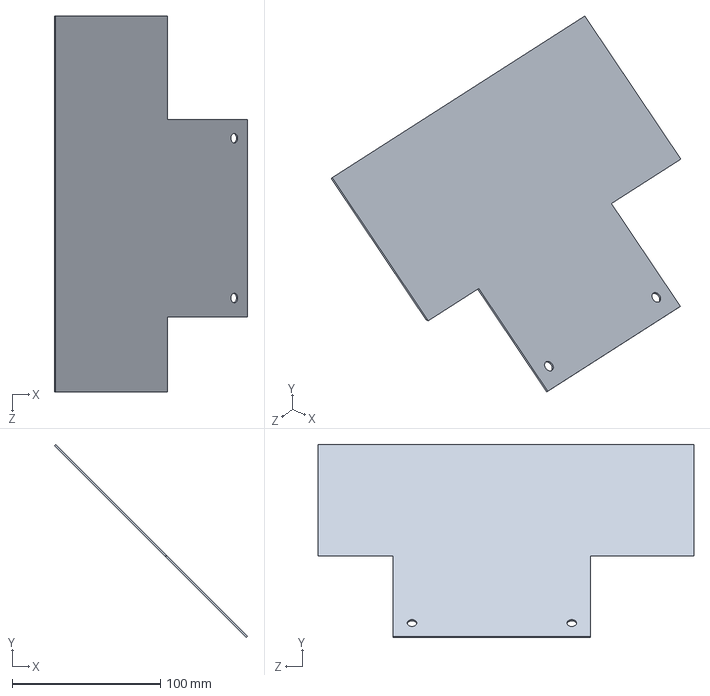
[picture p41: CAD file, 2018-10-06]
Final Assembly Work/Work with This one/BM ARM CHANNEL GM SIDE UNFOLDED.SLDPRT
130.5 x 130.5 x 254.0 mm
