markyen001/DR3-Resubmission/Final Assembly Work/Work with This one/Wheel Hub.SLDPRT

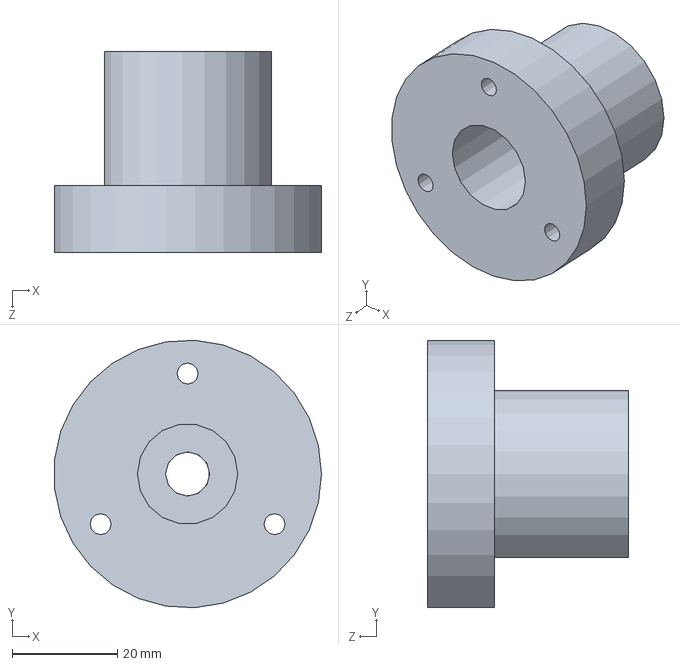
[picture p42: CAD file, 2018-10-06]
Final Assembly Work/Work with This one/Wheel Hub.SLDPRT
50.7 x 50.7 x 38.1 mm
