markyen001/DR3-Resubmission/Final Assembly Work/Work with This one/BM 8020.SLDPRT

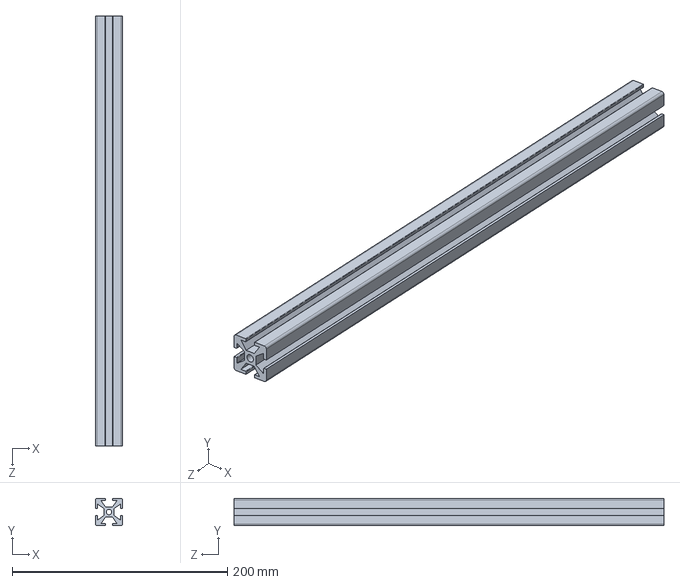
[picture p43: CAD file, 2018-10-05]
Final Assembly Work/Work with This one/BM 8020.SLDPRT
25.4 x 25.4 x 399.5 mm
