markyen001/DR3-Resubmission/Final Assembly Work/Work with This one/30 IPM Spal Linear Actuator (2in).SLDPRT

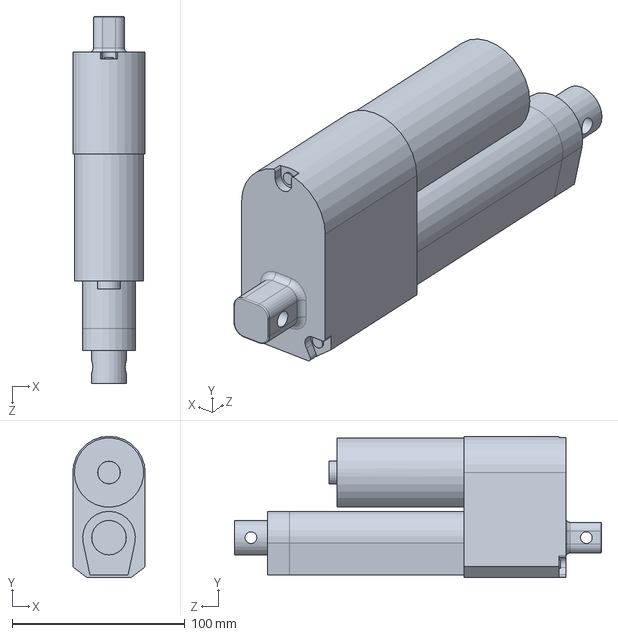
[picture p44: CAD file, 2018-10-05]
Final Assembly Work/Work with This one/30 IPM Spal Linear Actuator (2in).SLDPRT
41.9 x 81.8 x 212.2 mm
