markyen001/DR3-Resubmission/Final Assembly Work/Work with This one/4.5 RPM Globe Gear Motor.SLDPRT

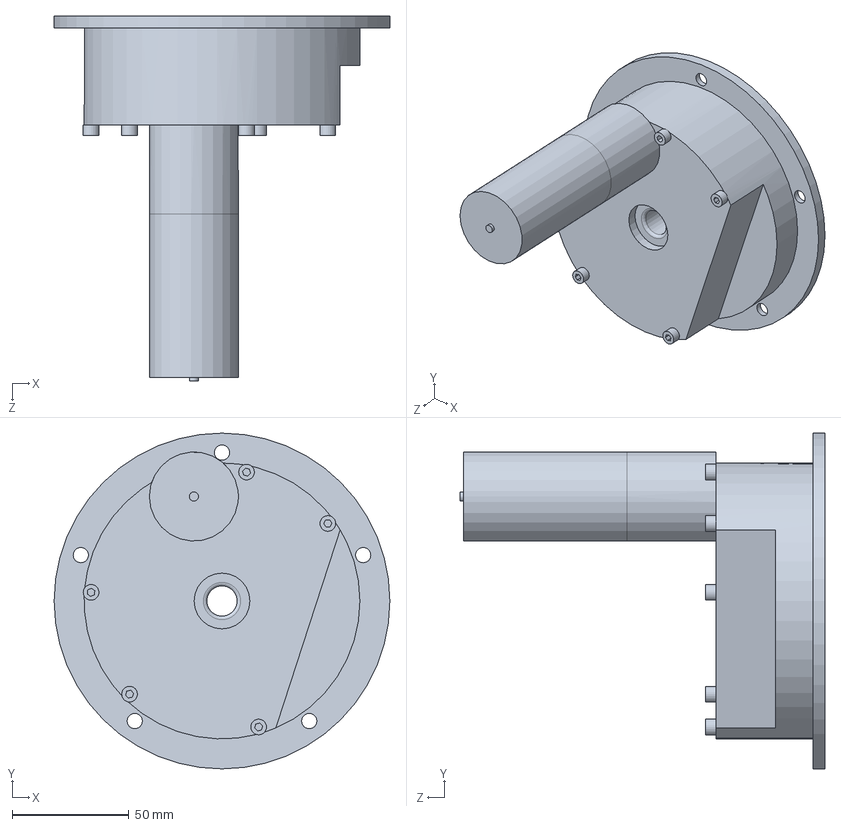
[picture p45: CAD file, 2018-10-05]
Final Assembly Work/Work with This one/4.5 RPM Globe Gear Motor.SLDPRT
143.6 x 143.6 x 156.1 mm
