markyen001/DR3-Resubmission/Final Assembly Work/Work with This one/80-20 Linear Slide.SLDPRT

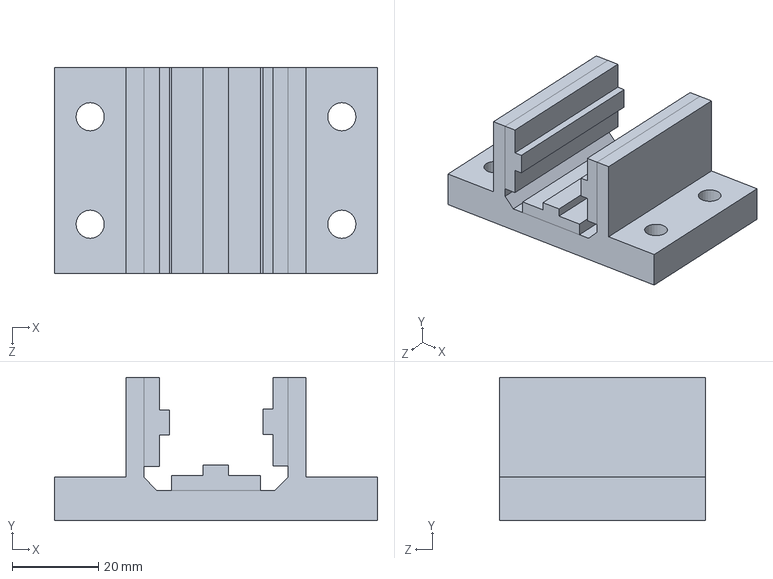
[picture p46: CAD file, 2018-10-05]
Final Assembly Work/Work with This one/80-20 Linear Slide.SLDPRT
74.8 x 33.2 x 47.8 mm
