markyen001/DR3-Resubmission/Final Assembly Work/Work with This one/BM 4.5in CLAW.SLDPRT

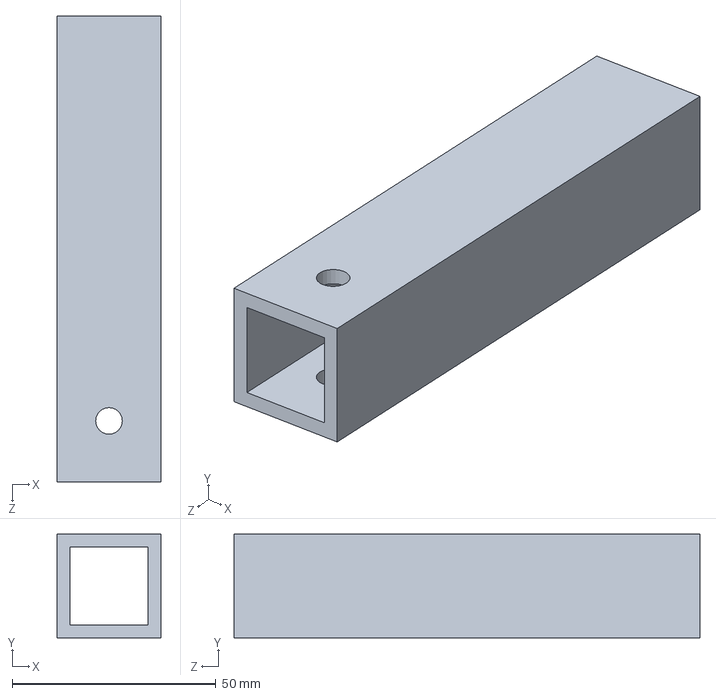
[picture p47: CAD file, 2018-10-05]
Final Assembly Work/Work with This one/BM 4.5in CLAW.SLDPRT
25.4 x 25.4 x 114.3 mm
