markyen001/DR3-Resubmission/Final Assembly Work/Work with This one/10 Inch Wheel.SLDPRT

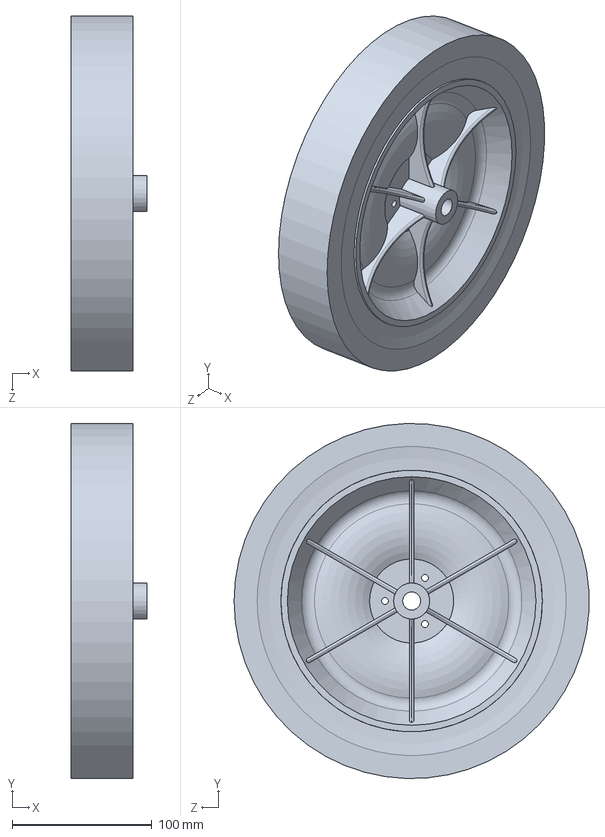
[picture p49: CAD file, 2018-10-05]
Final Assembly Work/Work with This one/10 Inch Wheel.SLDPRT
54.2 x 253.9 x 253.8 mm
