markyen001/DR3-Resubmission/Final Assembly Work/Work with This one/44 RPM Entstort Right Angle Gear Motor.SLDPRT

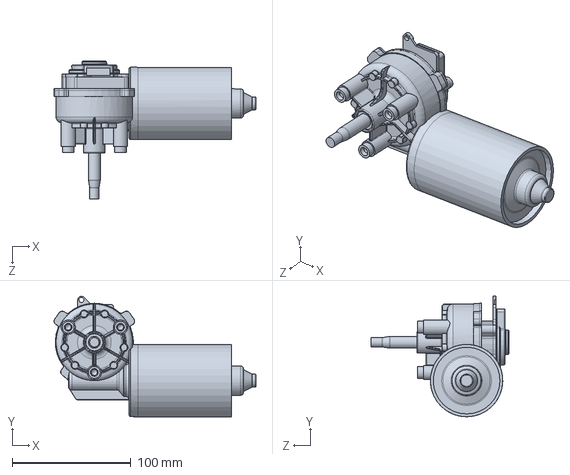
[picture p50: CAD file, 2018-10-05]
Final Assembly Work/Work with This one/44 RPM Entstort Right Angle Gear Motor.SLDPRT
170.1 x 101.5 x 116.0 mm
