markyen001/DR3-Resubmission/Final Assembly Work/Work with This one/Motor Mount.SLDPRT

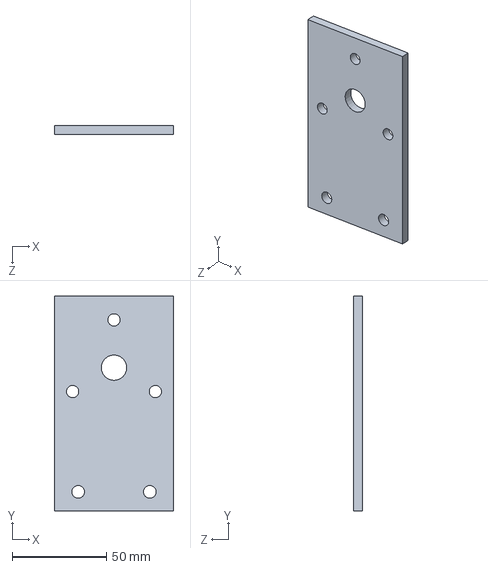
[picture p51: CAD file, 2018-10-05]
Final Assembly Work/Work with This one/Motor Mount.SLDPRT
63.5 x 114.3 x 4.83 mm
