markyen001/DR3-Resubmission/Final Assembly Work/Work with This one/80-20 Extrusion 12.5 inch (simplified).SLDPRT

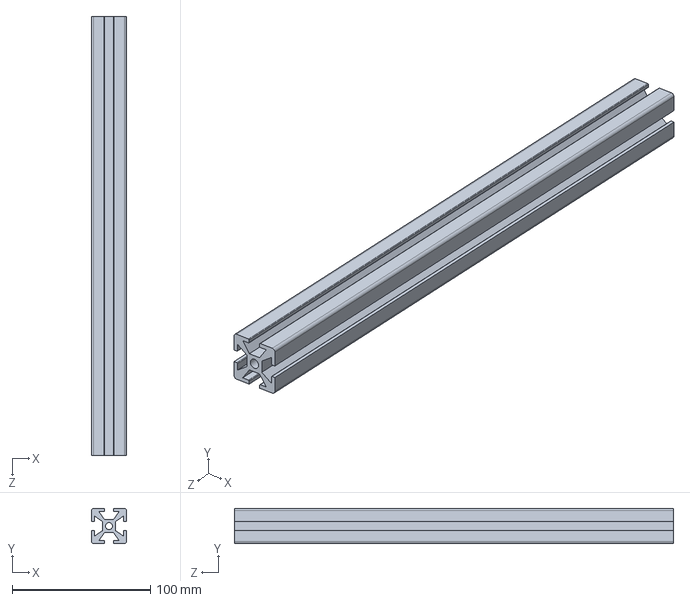
[picture p52: CAD file, 2018-10-05]
Final Assembly Work/Work with This one/80-20 Extrusion 12.5 inch (simplified).SLDPRT
25.4 x 25.4 x 317.5 mm
