markyen001/DR3-Resubmission/Final Assembly Work/Work with This one/80-20 Straight Bracket.SLDPRT

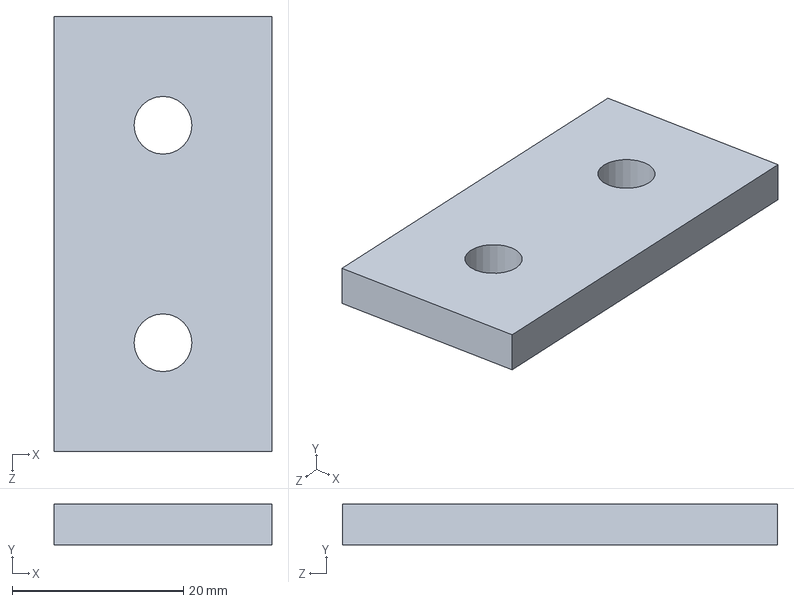
[picture p53: CAD file, 2018-10-05]
Final Assembly Work/Work with This one/80-20 Straight Bracket.SLDPRT
25.4 x 4.76 x 50.8 mm
