markyen001/DR3-Resubmission/Final Assembly Work/Work with This one/80-20 Extrusion 7 inch (simplified).SLDPRT

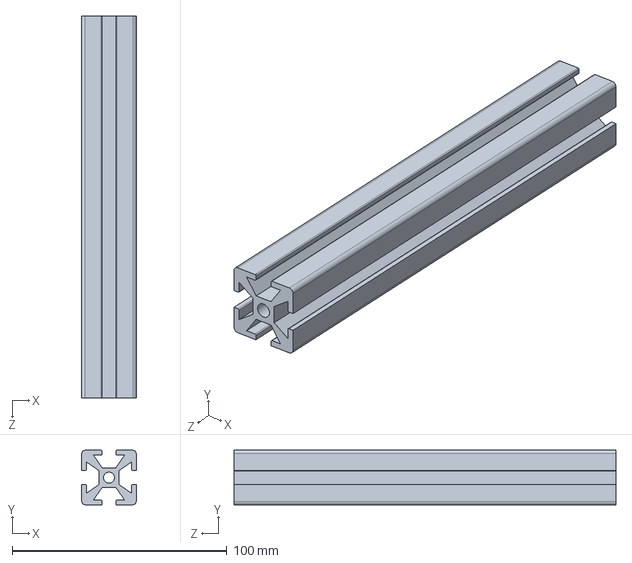
[picture p55: CAD file, 2018-10-05]
Final Assembly Work/Work with This one/80-20 Extrusion 7 inch (simplified).SLDPRT
25.4 x 25.4 x 177.8 mm
