markyen001/DR3-Resubmission/Final Assembly Work/Work with This one/80-20 90 Degree Angle Bracket.SLDPRT

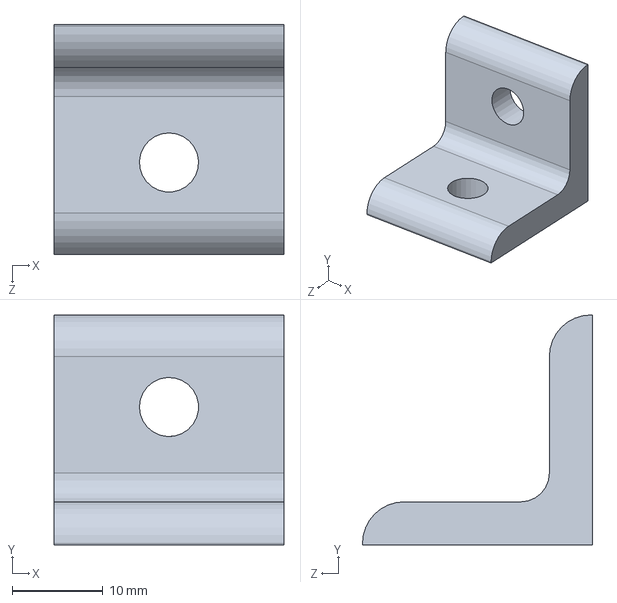
[picture p56: CAD file, 2018-10-05]
Final Assembly Work/Work with This one/80-20 90 Degree Angle Bracket.SLDPRT
25.4 x 25.4 x 25.4 mm
