markyen001/DR3-Resubmission/(list of files, cad)

Other CAD files:
Final Assembly Work/Work with This one/10-inch AL tube - with motor holes.SLDPRT
Final Assembly Work/Work with This one/11-inch AL tube - with motor hole.SLDPRT
Final Assembly Work/Work with This one/BM 5in CLAW.SLDPRT
Final Assembly Work/Work with This one/0.25-20 Button Head Cap Screw (BHCS).SLDPRT
Final Assembly Work/Work with This one/0013 10-24 x 1.25 in PHILIPS HEAD SCREW.SLDPRT
Final Assembly Work/Work with This one/0019 BALL HOPPER.SLDDRW
Final Assembly Work/Work with This one/10-24 HEX NUT.SLDPRT
Final Assembly Work/Work with This one/10-24 Thread 0.25 Length Set Screw for Bucket Motor Shaft.SLDPRT
Final Assembly Work/Work with This one/10-24 Thread 0.5 Inch Length Screw for Motor Hub.SLDPRT
Final Assembly Work/Work with This one/10-24 Thread 1.25 Length Socket Screw.SLDPRT
Final Assembly Work/Work with This one/10-24 Thread 1.5 Length Socket Head Screw.SLDPRT
Final Assembly Work/Work with This one/10-24 Thread 2 Length Socket Head Screw.SLDPRT
Final Assembly Work/Work with This one/10-24 thread 1.25 length flat head screw.SLDPRT
Final Assembly Work/Work with This one/10-24 x 3-8 Socket Screw for Mount.SLDPRT
Final Assembly Work/Work with This one/10-inch AL tube - no motor holes.SLDDRW
Final Assembly Work/Work with This one/10-inch AL tube - with motor holes.SLDDRW
Final Assembly Work/Work with This one/11-inch AL tube - no motor hole.SLDDRW
Final Assembly Work/Work with This one/11-inch AL tube - with motor hole.SLDDRW
Final Assembly Work/Work with This one/15 RPM SEI Gear Motor.SLDDRW
Final Assembly Work/Work with This one/44 RPM Entstort Right Angle Gear Motor.SLDDRW
Final Assembly Work/Work with This one/80-20 0.25-20 T-NUT.SLDPRT
Final Assembly Work/Work with This one/80-20 90 Degree Angle Bracket.SLDDRW
Final Assembly Work/Work with This one/80-20 Linear Slide.SLDDRW
Final Assembly Work/Work with This one/80-20 Straight Bracket.SLDDRW
Final Assembly Work/Work with This one/80-20 Straight Degree Bracket Assy.SLDDRW
Final Assembly Work/Work with This one/90 degree both parallel.SLDDRW
Final Assembly Work/Work with This one/90272A539_ZINC-PLTD STL PAN HEAD PHILLIPS MACHINE SCREW.SLDPRT
Final Assembly Work/Work with This one/90272A540_ZINC-PLTD STL PAN HEAD PHILLIPS MACHINE SCREW.SLDPRT
Final Assembly Work/Work with This one/91251A249_BLACK-OXIDE ALLOY STEEL SOCKET HEAD SCREW.SLDPRT
Final Assembly Work/Work with This one/91306A281_ZINC-PLATED ALLOY STEEL BUTTON-HEAD CAP SCREW.SLDPRT
Final Assembly Work/Work with This one/94895A029_ZINC YELLOW-CHROMATE PLATED STEEL HEX NUT.SLDPRT
Final Assembly Work/Work with This one/A014.SLDDRW
Final Assembly Work/Work with This one/BM Drawings.SLDDRW
Final Assembly Work/Work with This one/BUCKET GRABBER EXTRUSIONS.SLDDRW
Final Assembly Work/Work with This one/Bucket Arm Hub.SLDDRW
Final Assembly Work/Work with This one/Bucket Manipulator Total Assembly.SLDDRW
Final Assembly Work/Work with This one/Bucket Motor Mount.SLDDRW
Final Assembly Work/Work with This one/Bucket Motor Total Assembly.SLDDRW
Final Assembly Work/Work with This one/Caster Wheel.SLDDRW
Final Assembly Work/Work with This one/Control Box.SLDDRW
Final Assembly Work/Work with This one/Corrected bucketgrabber 2.SLDDRW
Final Assembly Work/Work with This one/Entstort Screw.SLDPRT
Final Assembly Work/Work with This one/Entstort Shaft Nut.SLDPRT
Final Assembly Work/Work with This one/FINAL TOTAL ASSEMBLY - EXPLODED.SLDDRW
Final Assembly Work/Work with This one/FINAL TOTAL ASSEMBLY - RETRACT.SLDDRW
Final Assembly Work/Work with This one/FINAL TOTAL ASSEMBLY - STRETCH.SLDDRW
Final Assembly Work/Work with This one/HOPPER AND BUCKET ASSEMBLY.SLDDRW
Final Assembly Work/Work with This one/Linear Actuaor Mount (10-24).SLDDRW
Final Assembly Work/Work with This one/M3 x 0.5 - 8 mm ROUND HEAD SCREW.SLDPRT
Final Assembly Work/Work with This one/M6x1 - 12mm GLOBE MOTOR SCREW.SLDPRT
Final Assembly Work/Work with This one/MOBILE PLATFORM FRAME.SLDDRW
Final Assembly Work/Work with This one/Motor Mount.SLDDRW
Final Assembly Work/Work with This one/PLATFORM WITH WHEELS.SLDDRW
Final Assembly Work/Work with This one/Platform Wheels Box Hopper Bucket Assembly.SLDDRW
Final Assembly Work/Work with This one/Platform with Wheels and Control Box.SLDDRW
Final Assembly Work/Work with This one/WASHER.SLDPRT
Final Assembly Work/Work with This one/Wheel Hub.SLDDRW
Final Assembly Work/Work with This one/Wheel and Motor Total Assembly.SLDDRW
Final Assembly Work/Work with This one/hopper assembly.SLDDRW
Part and Assembly Files/0019 BALL HOPPER.SLDDRW
Part and Assembly Files/10-inch AL tube - no motor holes.SLDDRW
Part and Assembly Files/10-inch AL tube - with motor holes.SLDDRW
Part and Assembly Files/11-inch AL tube - no motor hole.SLDDRW
Part and Assembly Files/11-inch AL tube - with motor hole.SLDDRW
Part and Assembly Files/15 RPM SEI Gear Motor.SLDDRW
Part and Assembly Files/30 IPM Spal Linear Actuator.SLDDRW
Part and Assembly Files/4.5 RPM Globe Gear Motor.SLDDRW
Part and Assembly Files/44 RPM Entstort Right Angle Gear Motor.SLDDRW
Part and Assembly Files/80-20 0.25-20 T-NUT.SLDPRT
Part and Assembly Files/80-20 90 Degree Angle Bracket.SLDDRW
Part and Assembly Files/80-20 Linear Slide.SLDDRW
Part and Assembly Files/80-20 Linear Slide.SLDPRT
Part and Assembly Files/80-20 Straight Bracket.SLDDRW
Part and Assembly Files/80-20 Straight Degree Bracket Assy.SLDDRW
Part and Assembly Files/90 degree both parallel.SLDDRW
Part and Assembly Files/90-DEGREE BRACKET ASSEMBLY.SLDASM
Part and Assembly Files/90272A539_ZINC-PLTD STL PAN HEAD PHILLIPS MACHINE SCREW.SLDPRT
Part and Assembly Files/90272A540_ZINC-PLTD STL PAN HEAD PHILLIPS MACHINE SCREW.SLDPRT
Part and Assembly Files/91306A281_ZINC-PLATED ALLOY STEEL BUTTON-HEAD CAP SCREW.SLDPRT
Part and Assembly Files/A013 HOPPER ASSEMBLY.SLDASM
Part and Assembly Files/A014.SLDDRW
Part and Assembly Files/BM 4.5in CLAW.SLDPRT
Part and Assembly Files/BM Claw SUBASM.SLDASM
Part and Assembly Files/BM Drawings.SLDDRW
Part and Assembly Files/BM MASTER ASM.SLDASM
Part and Assembly Files/BM Mounting SUBASM.SLDASM
Part and Assembly Files/BUCKET GRABBER ASSEMBLY.SLDASM
Part and Assembly Files/BUCKET GRABBER EXTRUSIONS.SLDASM
Part and Assembly Files/BUCKET GRABBER EXTRUSIONS.SLDDRW
Part and Assembly Files/Bucket Arm Hub.SLDDRW
Part and Assembly Files/Bucket Manipulator Total Assembly.SLDASM
Part and Assembly Files/Bucket Manipulator Total Assembly.SLDDRW
Part and Assembly Files/Bucket Motor Mount.SLDDRW
Part and Assembly Files/Bucket Motor Total Assembly.SLDASM
Part and Assembly Files/Bucket Motor Total Assembly.SLDDRW
Part and Assembly Files/Caster Wheel.SLDDRW
Part and Assembly Files/Control Box.SLDDRW
Part and Assembly Files/Corrected bucketgrabber 2.SLDDRW
Part and Assembly Files/Drive Wheel Hex Nut.SLDPRT
Part and Assembly Files/Drive Wheel Socket Screws.SLDPRT
Part and Assembly Files/FINAL TOTAL ASSEMBLY - EXPLODE.SLDDRW
Part and Assembly Files/FINAL TOTAL ASSEMBLY - RETRACT.SLDDRW
Part and Assembly Files/FINAL TOTAL ASSEMBLY - STRETCH.SLDDRW
Part and Assembly Files/GM ASM.SLDASM
Part and Assembly Files/GM Mounting SUBASM.SLDASM
Part and Assembly Files/Globe motor screw.SLDPRT
Part and Assembly Files/HOPPER AND BUCKET ASSEMBLY.SLDDRW
Part and Assembly Files/Hopper and Bucket Manipulator Assembly.SLDASM
Part and Assembly Files/Linear Actuaor Mount (10-24).SLDDRW
Part and Assembly Files/M3 x 0.5 - 10mm Button Screw for Bucket Motor Mount.SLDPRT
Part and Assembly Files/M6 X 14MM PHILLIPS SCREW.SLDPRT
Part and Assembly Files/M6x1 - 12mm GLOBE MOTOR SCREW.SLDPRT
Part and Assembly Files/M8 x 1.25 mm HEX NUT.SLDPRT
Part and Assembly Files/MOBILE PLATFORM EXTRUSIONS.SLDASM
Part and Assembly Files/MOBILE PLATFORM EXTRUSIONS.SLDDRW
Part and Assembly Files/MOBILE PLATFORM FRAME.SLDASM
Part and Assembly Files/MOBILE PLATFORM FRAME.SLDDRW
Part and Assembly Files/Motor Mount Assembly.SLDASM
Part and Assembly Files/Motor Mount.SLDDRW
Part and Assembly Files/PLATFORM WITH WHEELS.SLDASM
Part and Assembly Files/PLATFORM WITH WHEELS.SLDDRW
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
