markyen001/DR3-Resubmission/Documents Ready for Print/PRINT 0001 - A19.pdf

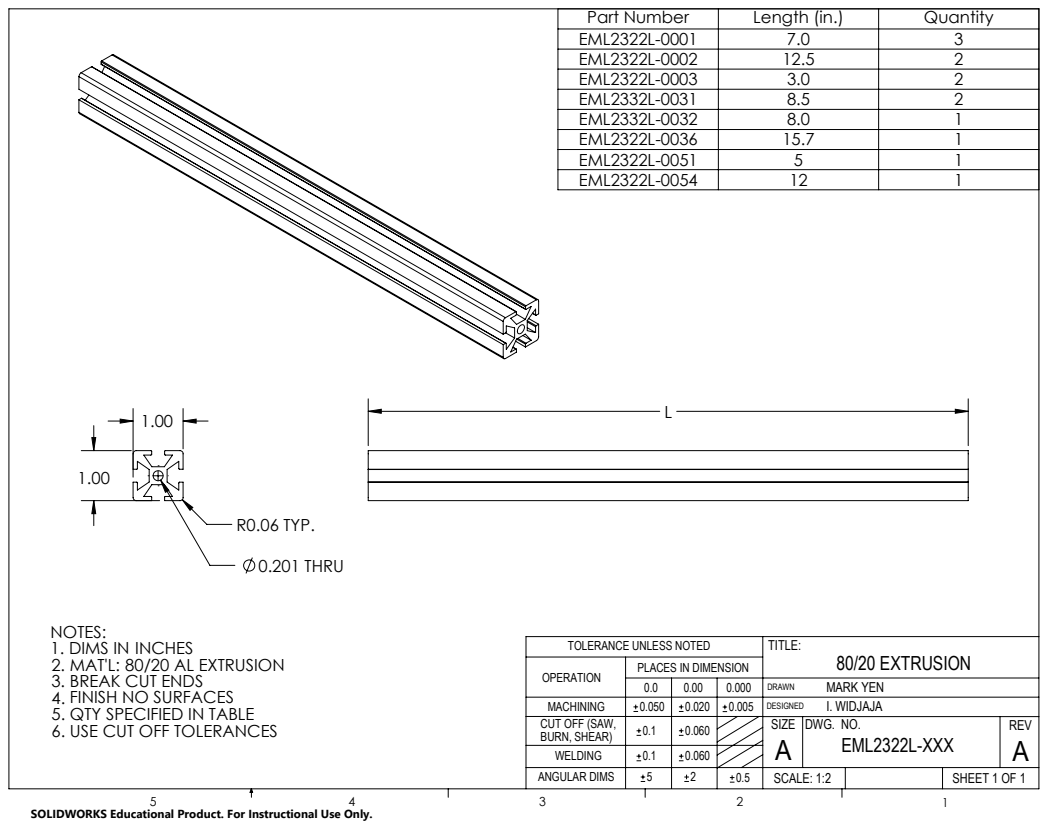
[picture p57: page 1]
R0.06 TYP.; 0.201 THRU; 80/20 EXTRUSION; SHEET 1 OF 1; DWG. NO.; MARK YEN I. WIDJAJA; SCALE: 1:2

Part Number | Length (in.) | Quantity
EML2322L-0001 | 7.0 | 3
EML2322L-0002 | 12.5 | 2
EML2322L-0003 | 3.0 | 2
EML2332L-0031 | 8.5 | 2
EML2332L-0032 | 8.0 | 1
EML2322L-0036 | 15.7 | 1
EML2322L-0051 | 5 | 1
EML2322L-0054 | 12 | 1

NOTES:
1. DIMS IN
2. MAT'L: 80/20 AL EXTRUSION
3. BREAK CUT ENDS
FINISH NO SURFACES
5. QTY SPECIFIED IN TABLE
6. USE CUT OFF TOLERANCES

TOLERANCE UNLESS NOTED
OPERATION
MACHINING
CUT OFF (SAW,
BURN, SHEAR)
WELDING
ANGULAR DIMS

PLACES IN DIMENSION

SOLIDWORKS Educational Product. For Instructional Use Only.

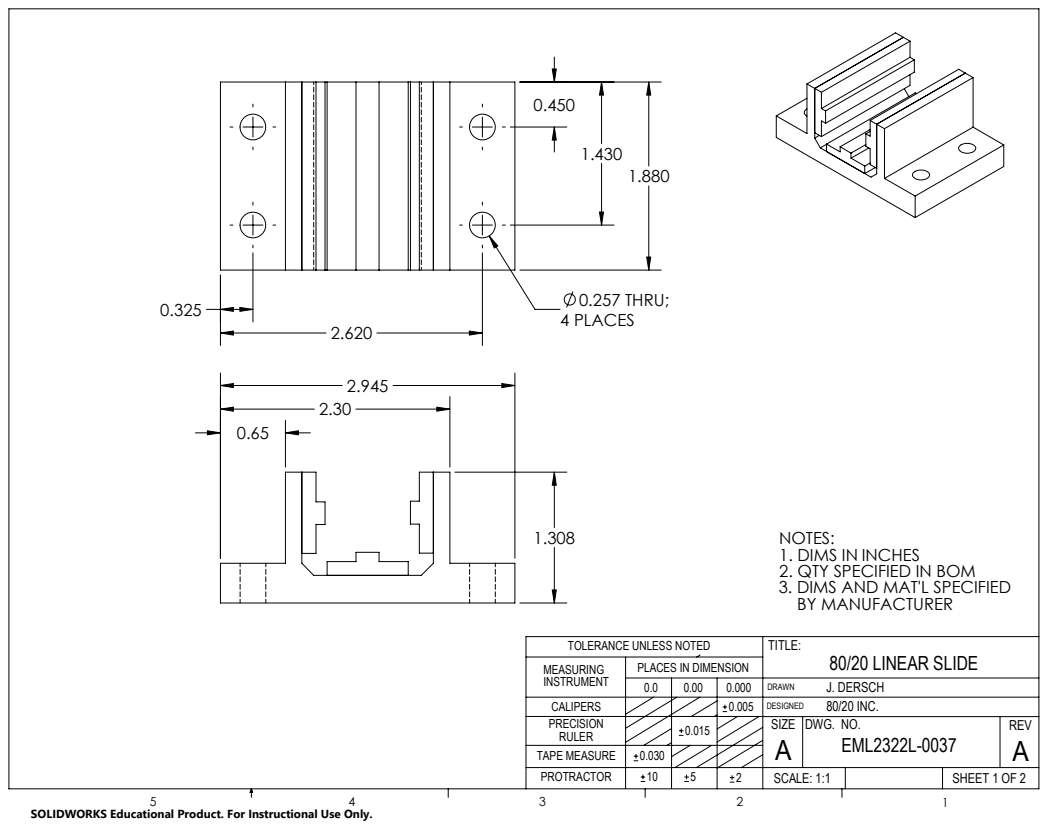
[picture p58: page 2]
0.257 THRU; 4 PLACES; 80/20 LINEAR SLIDE; SHEET 1 OF 2; DWG. NO.; J. DERSCH 80/20 INC.; TAPE MEASURE; TOLERANCE UNLESS NOTED; SCALE: 1:1

NOTES:
1. DIMS IN
2. QTY SPECIFIED IN BOM
3. DIMS AND MAT'L SPECIFIED
BY MANUFACTURER

PLACES IN DIMENSION

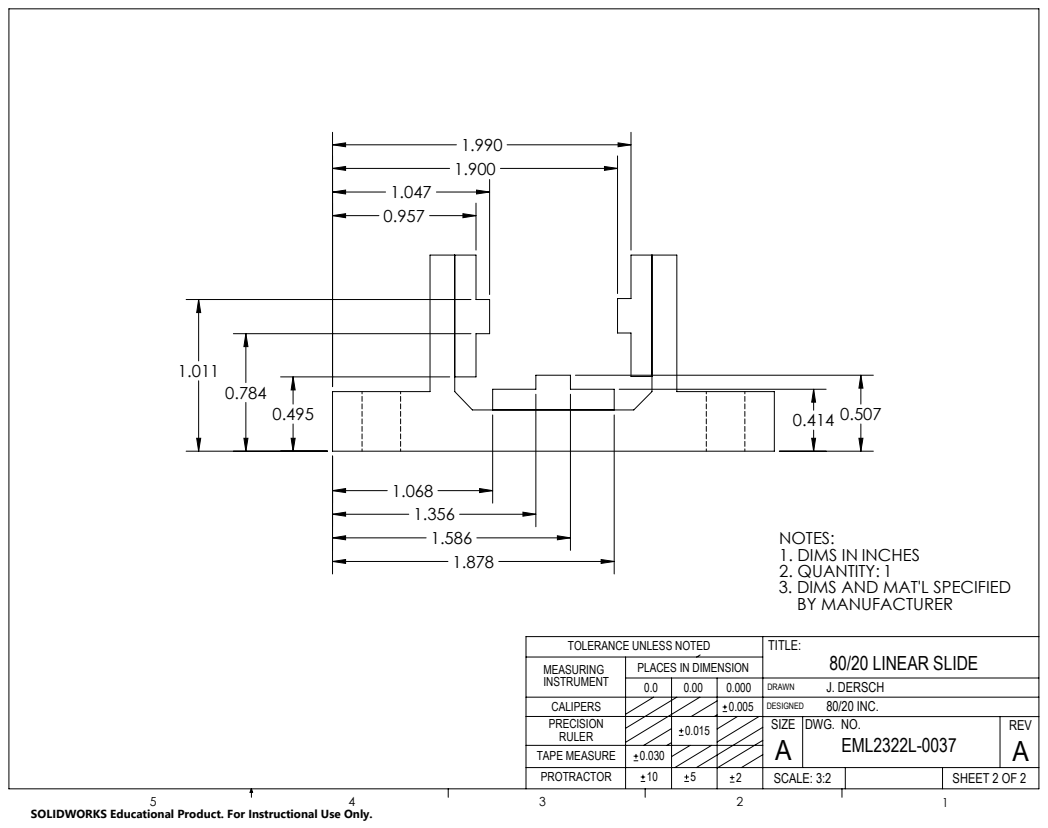
[picture p59: page 3]
80/20 LINEAR SLIDE; SHEET 2 OF 2; DWG. NO.; J. DERSCH 80/20 INC.; TAPE MEASURE; TOLERANCE UNLESS NOTED; SCALE: 3:2

NOTES:
1. DIMS IN
2. QUANTITY:
3. DIMS AND MAT'L SPECIFIED
BY MANUFACTURER

PLACES IN DIMENSION

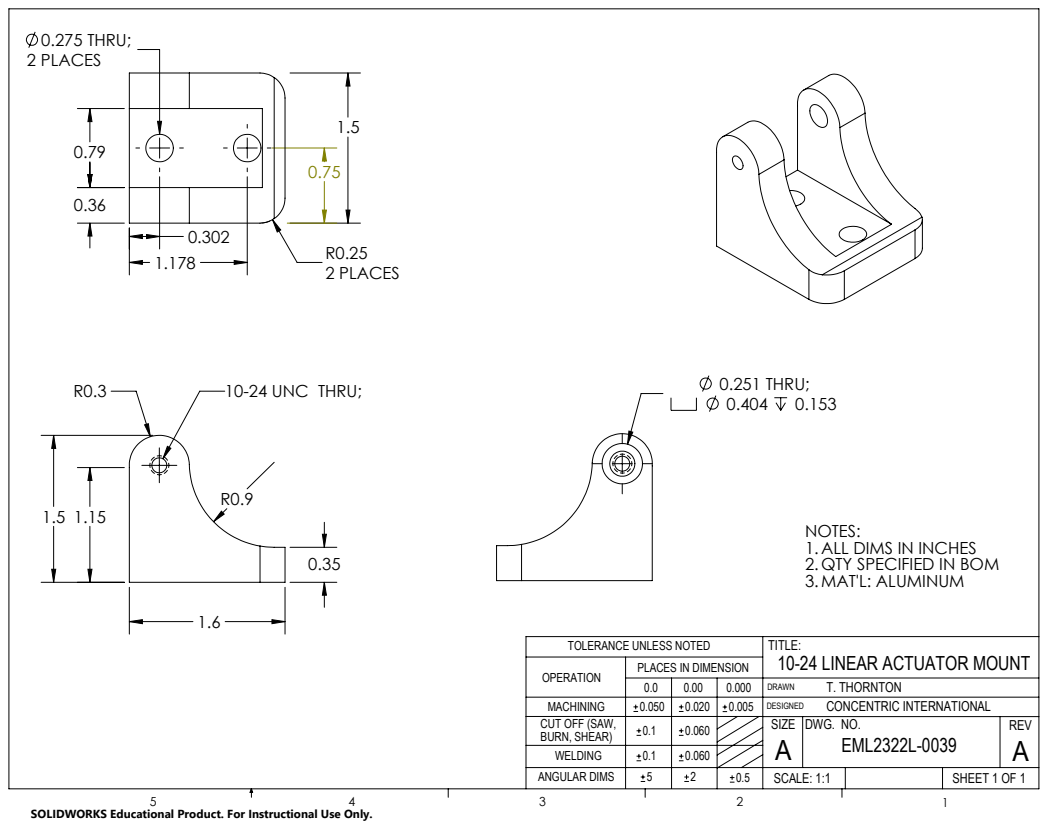
[picture p60: page 4]
10-24 UNC THRU;; 0.275 THRU; 2 PLACES; 2 PLACES; 0.251 THRU; 0.404 0.153; SCALE: 1:1

NOTES:
ALL DIMS IN INCHES
QTY SPECIFIED IN BOM
MAT'L: ALUMINUM

TOLERANCE UNLESS NOTED
OPERATION
MACHINING
CUT OFF (SAW,
BURN, SHEAR)
WELDING
ANGULAR DIMS

TITLE:
10-24 LINEAR ACTUATOR MOUNT
T. THORNTON
CONCENTRIC INTERNATIONAL
DWG. NO.

PLACES IN DIMENSION

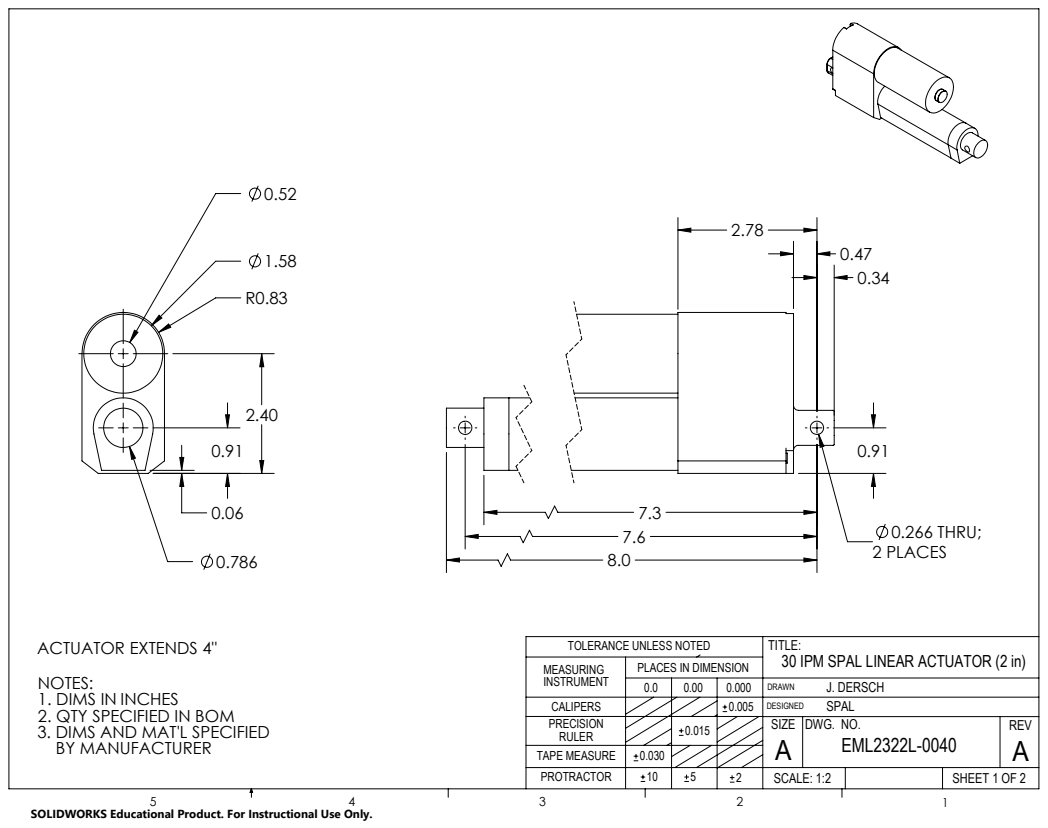
[picture p61: page 5]
0.266 THRU; 2 PLACES; SHEET 1 OF 2; TAPE MEASURE; TOLERANCE UNLESS NOTED; SCALE: 1:2

ACTUATOR EXTENDS 4"
NOTES:
1. DIMS IN
2. QTY SPECIFIED IN BOM
3. DIMS AND MAT'L SPECIFIED
BY MANUFACTURER

TITLE:
30 IPM SPAL LINEAR ACTUATOR (2 in)
J. DERSCH
SPAL
DWG. NO.

PLACES IN DIMENSION

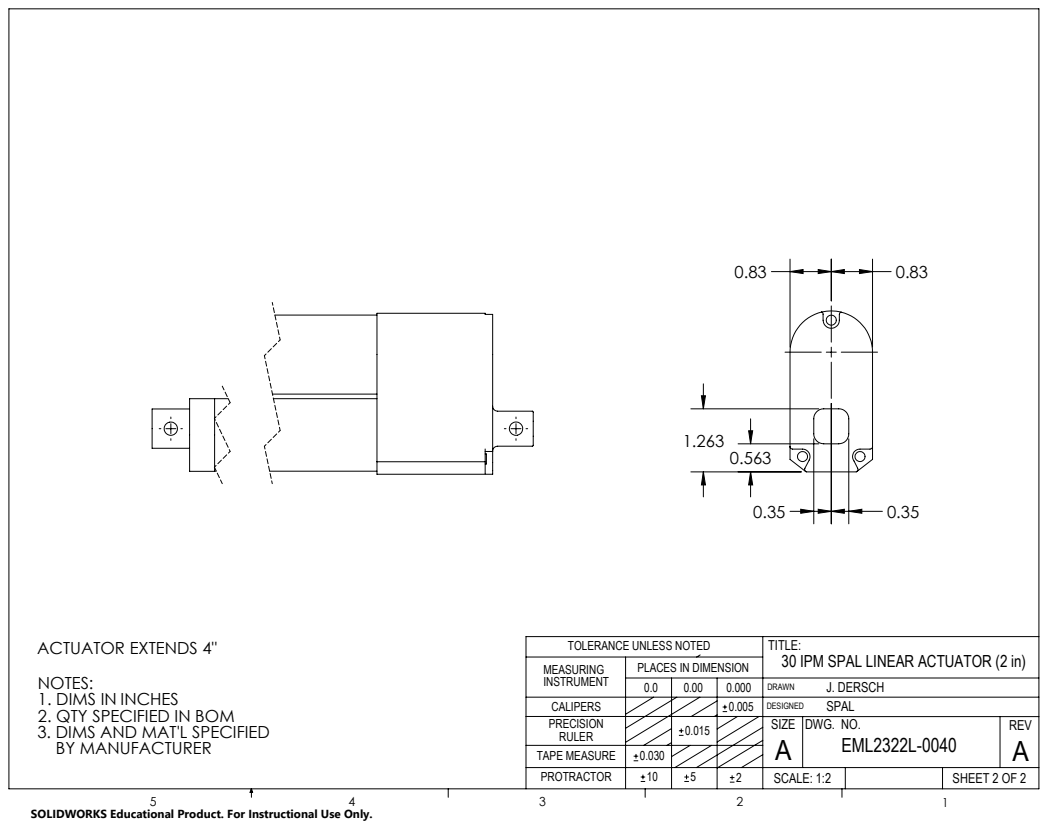
[picture p62: page 6]
SHEET 2 OF 2; TAPE MEASURE; TOLERANCE UNLESS NOTED; SCALE: 1:2

ACTUATOR EXTENDS 4"
NOTES:
1. DIMS IN
2. QTY SPECIFIED IN BOM
3. DIMS AND MAT'L SPECIFIED
BY MANUFACTURER

TITLE:
30 IPM SPAL LINEAR ACTUATOR (2 in)
J. DERSCH
SPAL
DWG. NO.

PLACES IN DIMENSION

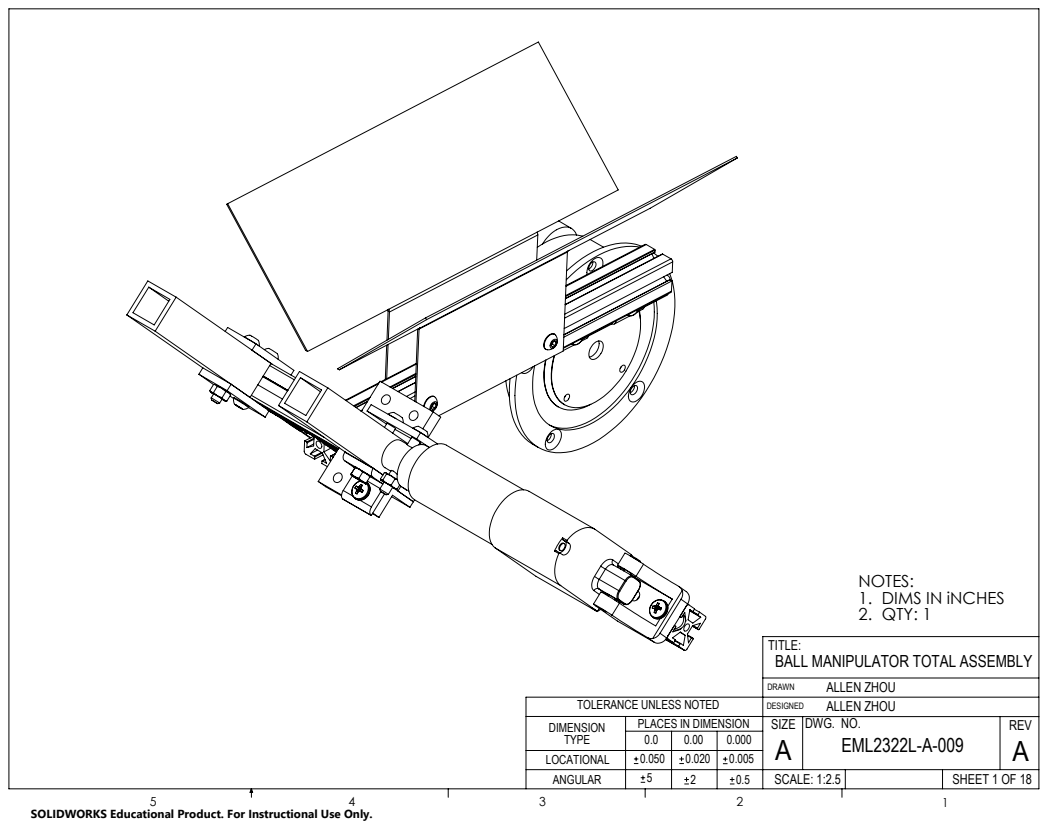
[picture p63: page 7]
TOLERANCE UNLESS NOTED; SCALE: 1:2.5; DIMS IN iNCHES 2. QTY: 1

TITLE:
BALL MANIPULATOR TOTAL ASSEMBLY
ALLEN ZHOU
DWG. NO.
SIZE

PLACES IN DIMENSION

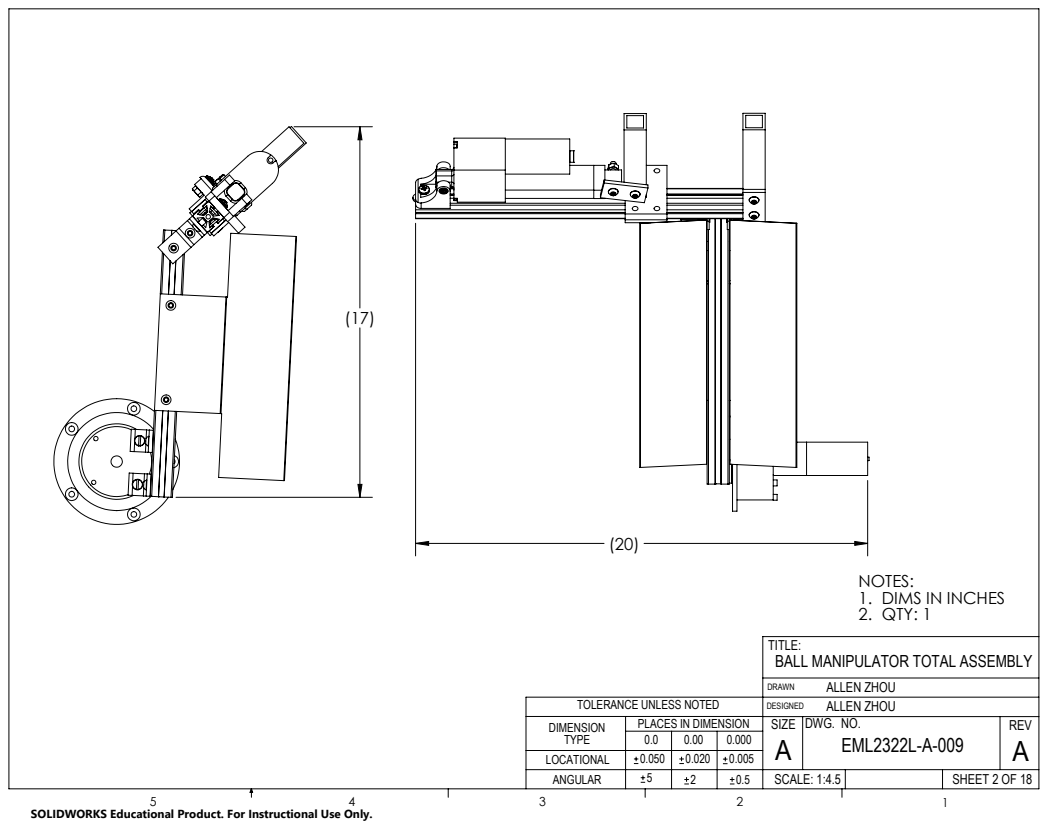
[picture p64: page 8]
SCALE: 1:4.5; DIMS IN INCHES 2. QTY: 1

TITLE:
BALL MANIPULATOR TOTAL ASSEMBLY
ALLEN ZHOU
DWG. NO.
SIZE

TOLERANCE UNLESS NOTED
DIMENSION
TYPE
LOCATIONAL

PLACES IN DIMENSION

ITEM NO. | PART NUMBER | DESCRIPTION | QTY.
5 | EML2322L-0005 | 1/4-20 x 1/2 in BUTTON HEAD CAP SCREW | 6
6 | EML2322L-0006 | 1/4-20 T-NUT | 8
34 | EML2322L-0034 | BALL MANIPULATOR CHANNEL | 2
54 | EML2322L-0054 | 80/20 EXTRUSION - 12 in | 1
A6 | EML2322L-A-006 | CLAW ASSEMBLY | 1
A7 | EML2322L-A-007 | CLAW MOUNT | 2
A8 | EML2322L-A-008 | GLOBE MOTOR BRACKET ASSEMBLY | 2
A19 | EML2322L-A-019 | 4.5 RPM GLOBE MOTOR | 1

BALL MANIPULATOR TOTAL ASSEMBLY

DWG. NO.

TITLE:

REV
A

SIZE

### A EML2322L-A-009

DRAWN
DESIGNED

ALLEN ZHOU
ALLEN ZHOU
0.0 | 0.00 | 0.000
0.050 0.020 0.005
LOCATIONAL

TOLERANCE UNLESS NOTED
DIMENSION
TYPE
5 | 2 | SCALE: 1:8

PLACES IN DIMENSION

DIMS IN INCHES

NOTES:
1.
2. QTY: 1

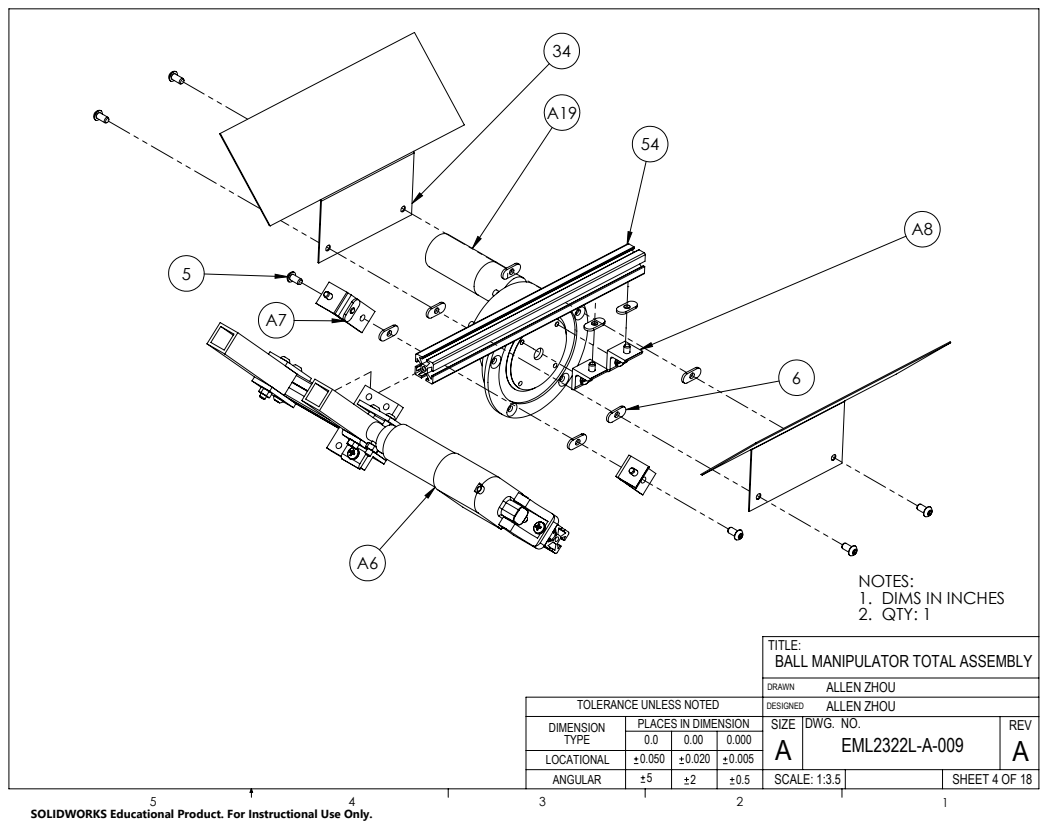
[picture p65: page 10]
SCALE: 1:3.5; DIMS IN INCHES 2. QTY: 1

TITLE:
BALL MANIPULATOR TOTAL ASSEMBLY
ALLEN ZHOU
DWG. NO.
SIZE

TOLERANCE UNLESS NOTED
DIMENSION
TYPE
LOCATIONAL

PLACES IN DIMENSION

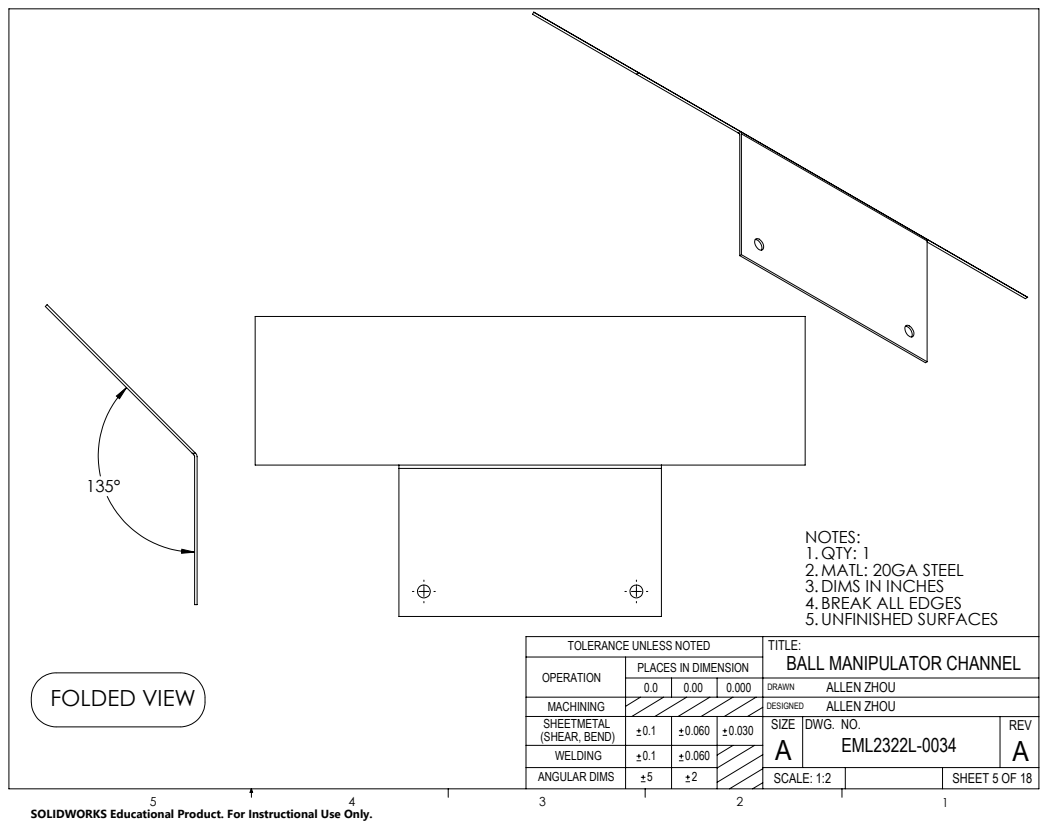
[picture p66: page 11]
BALL MANIPULATOR CHANNEL; SHEET 5 OF 18; DWG. NO.; ALLEN ZHOU ALLEN ZHOU; SCALE: 1:2; FOLDED VIEW; QTY: 1 DIMS IN INCHES BREAK ALL EDGES; MATL: 20GA STEEL; UNFINISHED SURFACES

TOLERANCE UNLESS NOTED
OPERATION
MACHINING
SHEETMETAL
(SHEAR, BEND)
WELDING
ANGULAR DIMS

PLACES IN DIMENSION

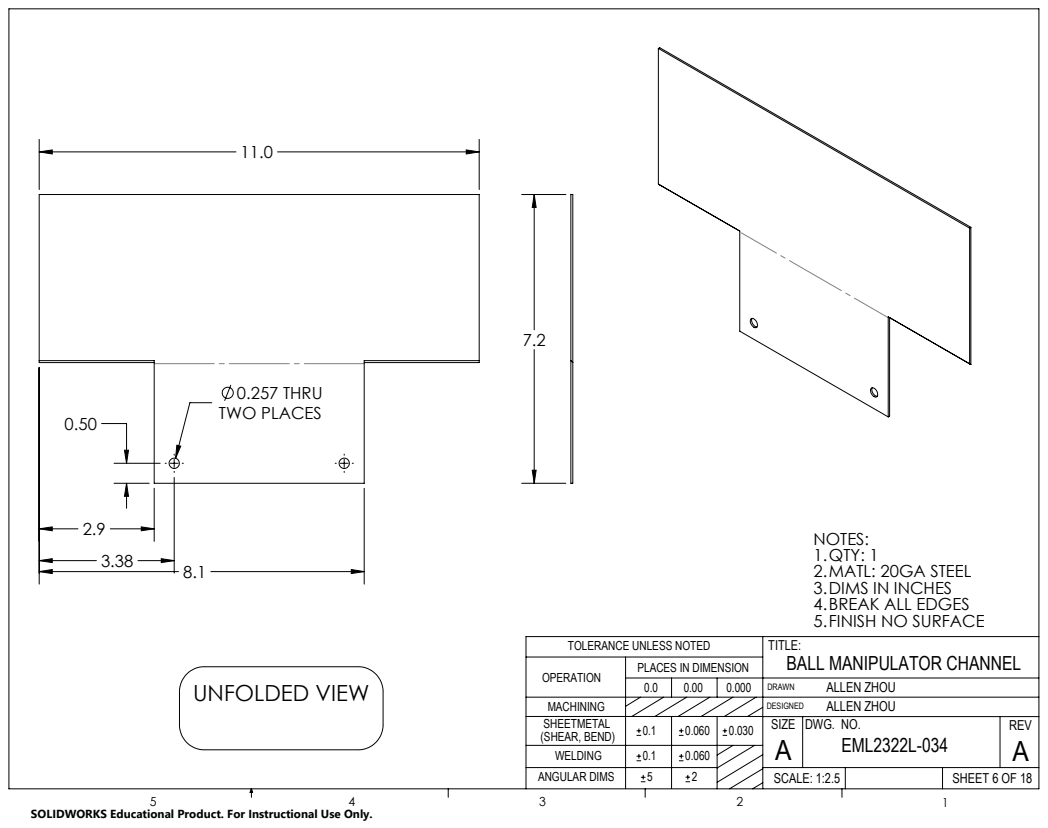
[picture p67: page 12]
0.257 THRU TWO PLACES; BALL MANIPULATOR CHANNEL; SHEET 6 OF 18; DWG. NO.; ALLEN ZHOU ALLEN ZHOU; SCALE: 1:2.5; UNFOLDED VIEW; QTY: 1; BREAK ALL EDGES; MATL: 20GA STEEL DIMS IN INCHES

FINISH NO SURFACE

TOLERANCE UNLESS NOTED
OPERATION
MACHINING
SHEETMETAL
(SHEAR, BEND)
WELDING
ANGULAR DIMS

PLACES IN DIMENSION

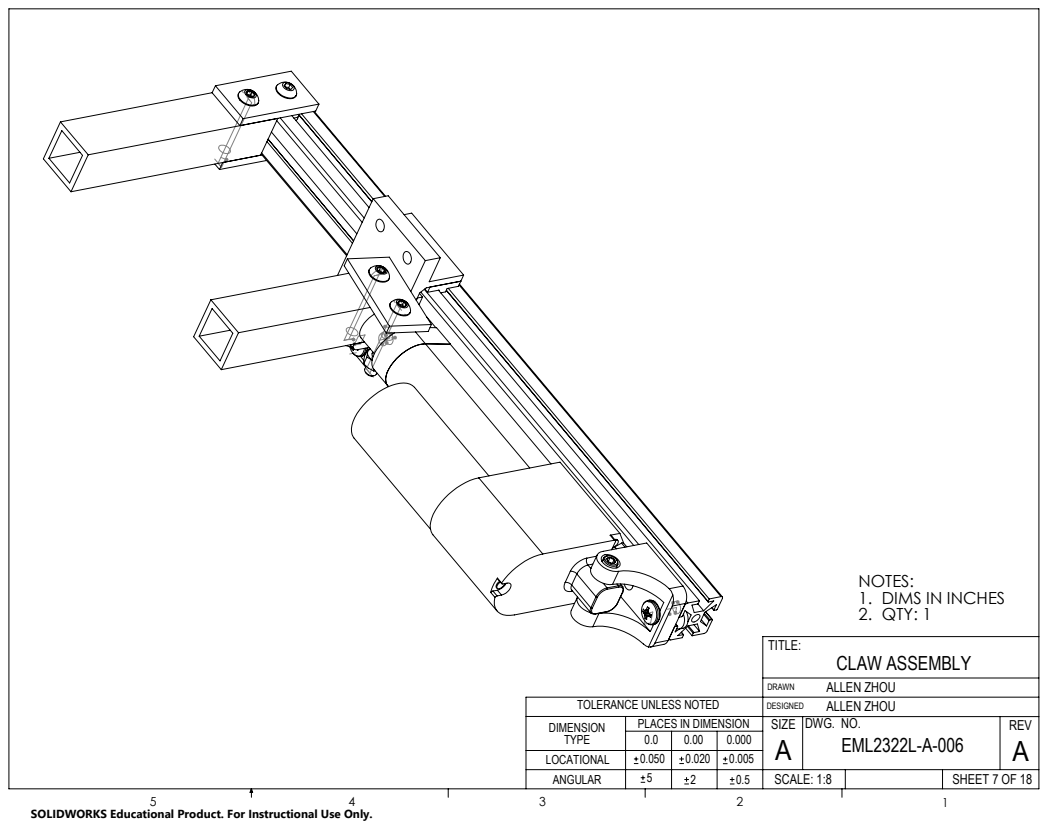
[picture p68: page 13]
SCALE: 1:8

NOTES:
DIMS IN INCHES
2. QTY: 1
CLAW ASSEMBLY
ALLEN ZHOU
DWG. NO.
SIZE

TOLERANCE UNLESS NOTED
DIMENSION
TYPE
LOCATIONAL

PLACES IN DIMENSION

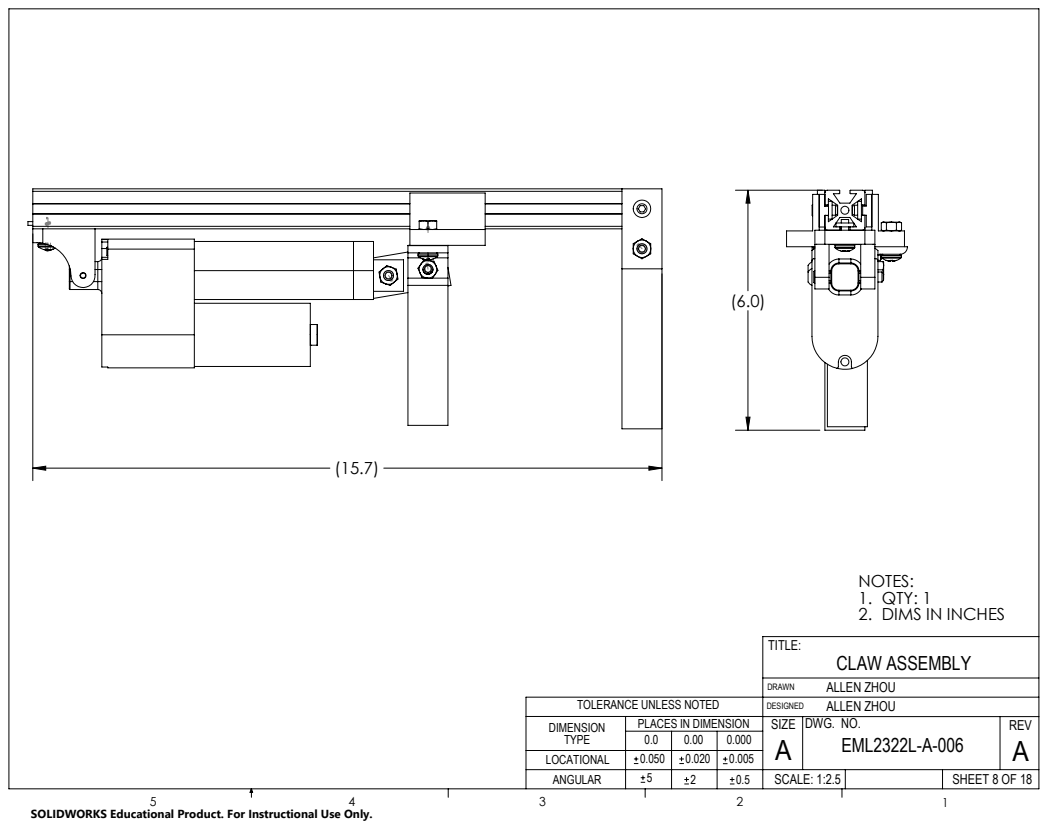
[picture p69: page 14]
SCALE: 1:2.5

NOTES:
QTY: 1
2. DIMS IN INCHES
CLAW ASSEMBLY
ALLEN ZHOU
DWG. NO.
SIZE

TOLERANCE UNLESS NOTED
DIMENSION
TYPE
LOCATIONAL

PLACES IN DIMENSION

ITEM NO. | PART NUMBER | DESCRIPTION | QTY.
4 | EML2322L-0004 | 80/20 90 DEG ANGLE BRACKET | 1
5 | EML2322L-0005 | 1/4-20 x 1/2 in BUTTON HEAD CAP SCREW | 2
6 | EML2322L-0006 | 1/4-20 T-NUT | 3
7 | EML2322L-0007 | 80/20 STRAIGHT BRACKET | 3
35 | EML2322L-0035 | 80/20 EXTRUSION - 15.7 in | 1
36 | EML2322L-0036 | BALL MANIPULATOR CLAW - 5 in | 1
37 | EML2322L-0037 | 80/20 LINEAR SLIDE | 1
38 | EML2322L-0038 | BALL MANIPULATOR CLAW - 4.5 in | 1
39 | EML2322L-0039 | 10-24 LINEAR ACTUATOR MOUNT | 1
40 | EML2322L-0040 | 30 IPM SPAL LINEAR ACTUATOR (2in) | 1
41 | EML2322L-0041 | 1/4-20 x 3/4 in PAN HEAD SCREW | 1
42 | EML2322L-0042 | 1/4-20 x 1.75 in BUTTON HEAD SCREW | 3
43 | EML2322L-0043 | 1/4-20 x 5/8 in PAN HEAD SCREW | 1
44 | EML2322L-0044 | 1/4-20 in HEX NUT | 5
45 | EML2322L-0045 | 10-24 x 1.25 in SOCKET HEAD - PARTIAL THREAD | 1

### CLAW ASSEMBLY

DWG. NO.

TITLE:

REV
A

SIZE

### A EML2322L-A-006

DRAWN
DESIGNED

ALLEN ZHOU
ALLEN ZHOU
0.0 | 0.00 | 0.000
0.050 0.020 0.005
LOCATIONAL

TOLERANCE UNLESS NOTED
DIMENSION
TYPE
5 | 2 | SCALE: 1:8

PLACES IN DIMENSION

QTY: 1

NOTES:
1.
2. ALL DIMS IN INCHES

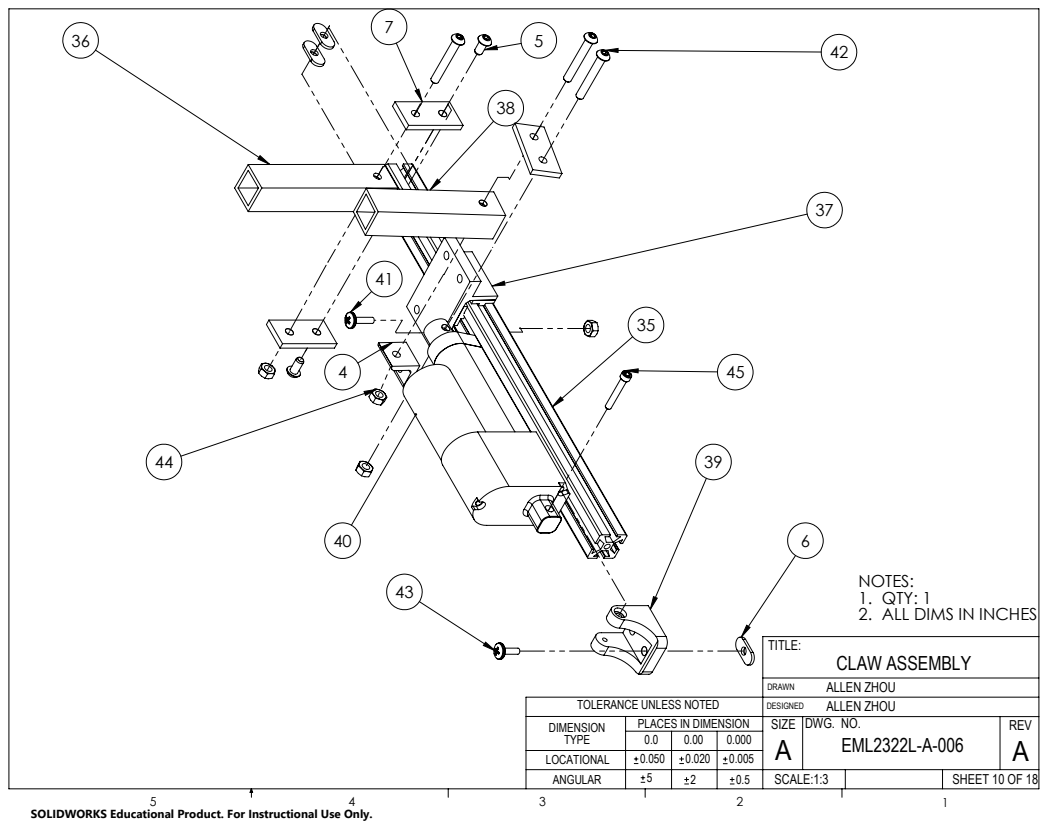
[picture p70: page 16]

NOTES:
QTY: 1
2. ALL DIMS IN INCHES
CLAW ASSEMBLY
ALLEN ZHOU
DWG. NO.
SIZE

TOLERANCE UNLESS NOTED
DIMENSION
TYPE
LOCATIONAL

PLACES IN DIMENSION

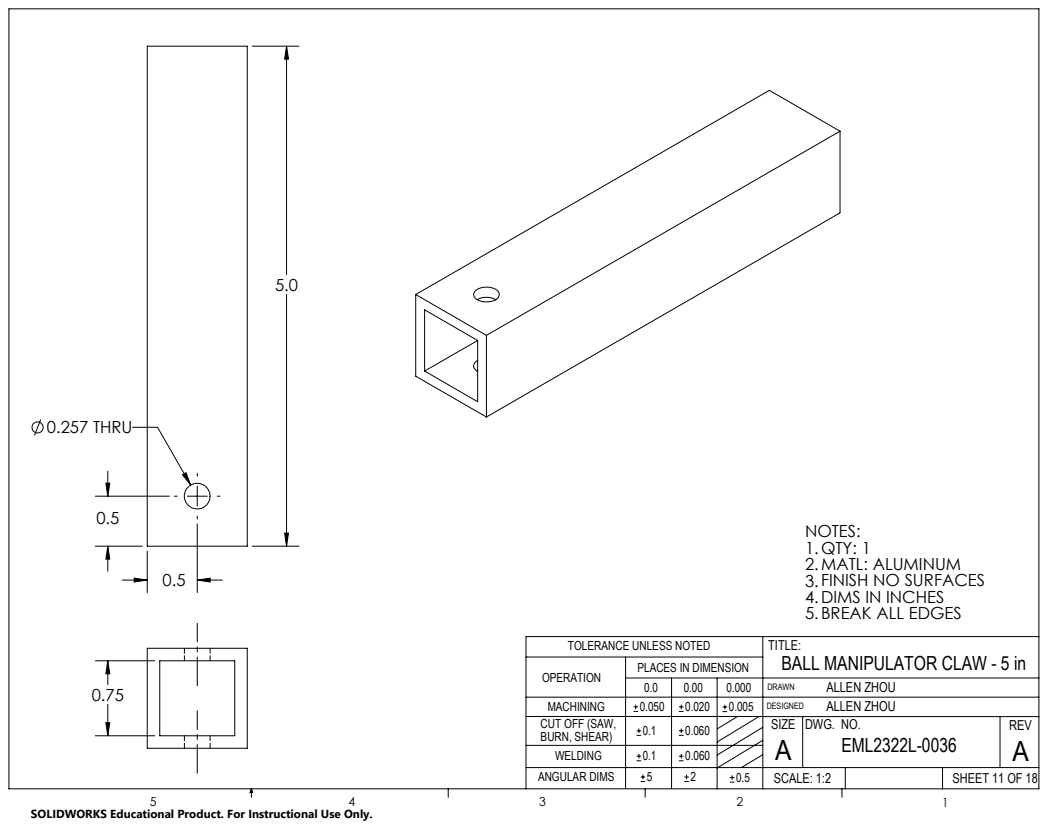
[picture p71: page 17]
0.257 THRU; SCALE: 1:2

NOTES:
QTY: 1
MATL: ALUMINUM
FINISH NO SURFACES
DIMS IN INCHES
BREAK ALL EDGES
TITLE:
BALL MANIPULATOR CLAW - 5 in
ALLEN ZHOU
DWG. NO.

TOLERANCE UNLESS NOTED
OPERATION
MACHINING
CUT OFF (SAW,
BURN, SHEAR)
WELDING
ANGULAR DIMS

PLACES IN DIMENSION

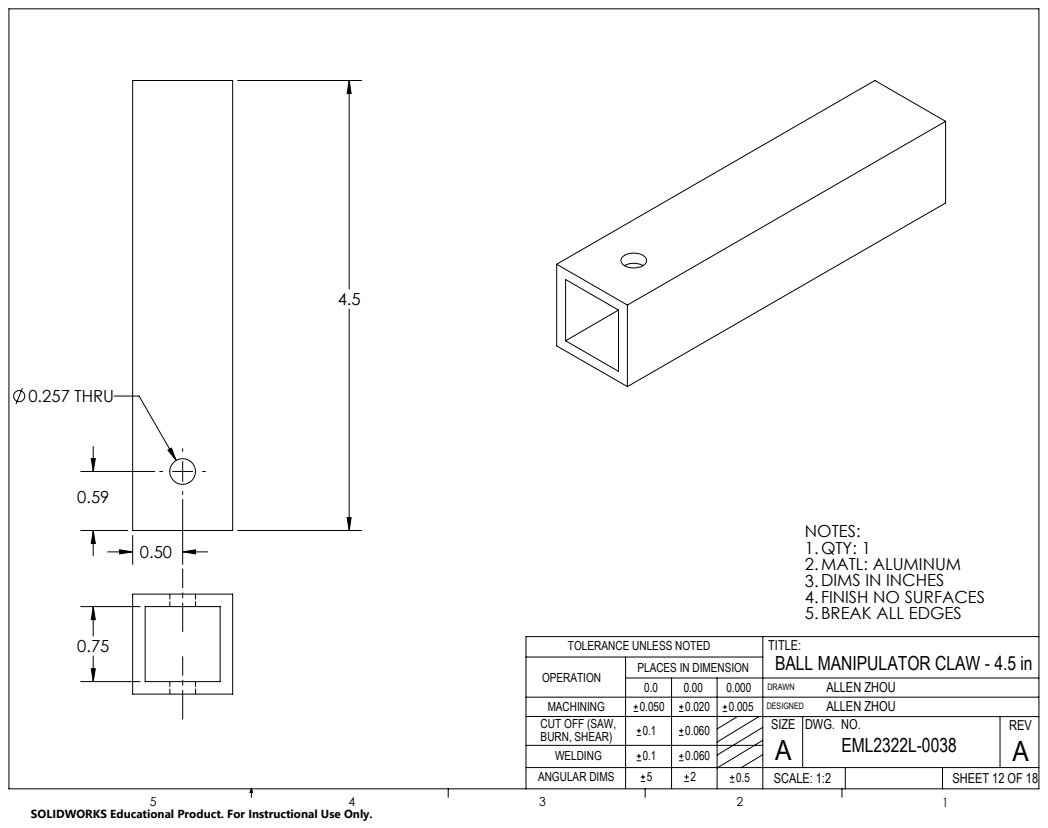
[picture p72: page 18]
0.257 THRU; SCALE: 1:2

NOTES:
QTY: 1
MATL: ALUMINUM
DIMS IN INCHES
FINISH NO SURFACES
BREAK ALL EDGES
TITLE:
BALL MANIPULATOR CLAW - 4.5 in
ALLEN ZHOU
DWG. NO.

TOLERANCE UNLESS NOTED
OPERATION
MACHINING
CUT OFF (SAW,
BURN, SHEAR)
WELDING
ANGULAR DIMS

PLACES IN DIMENSION

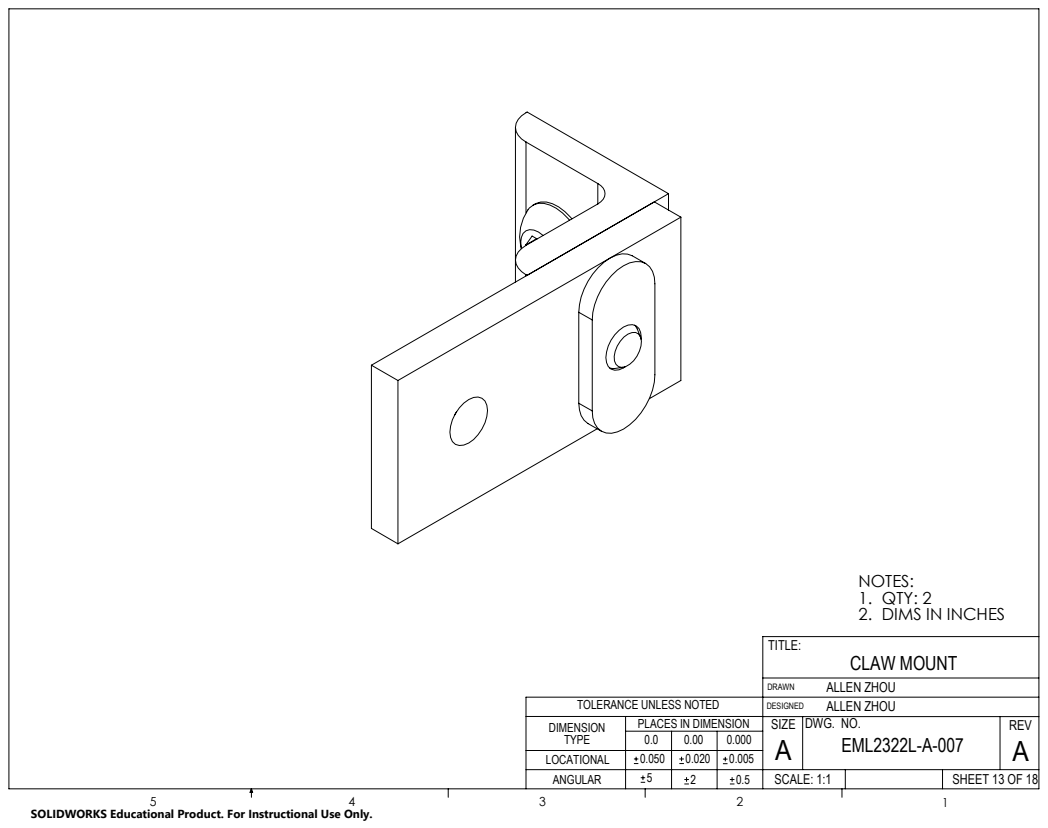
[picture p73: page 19]
SCALE: 1:1

NOTES:
QTY: 2
2. DIMS IN INCHES
CLAW MOUNT
ALLEN ZHOU
DWG. NO.
SIZE

TOLERANCE UNLESS NOTED
DIMENSION
TYPE
LOCATIONAL

PLACES IN DIMENSION

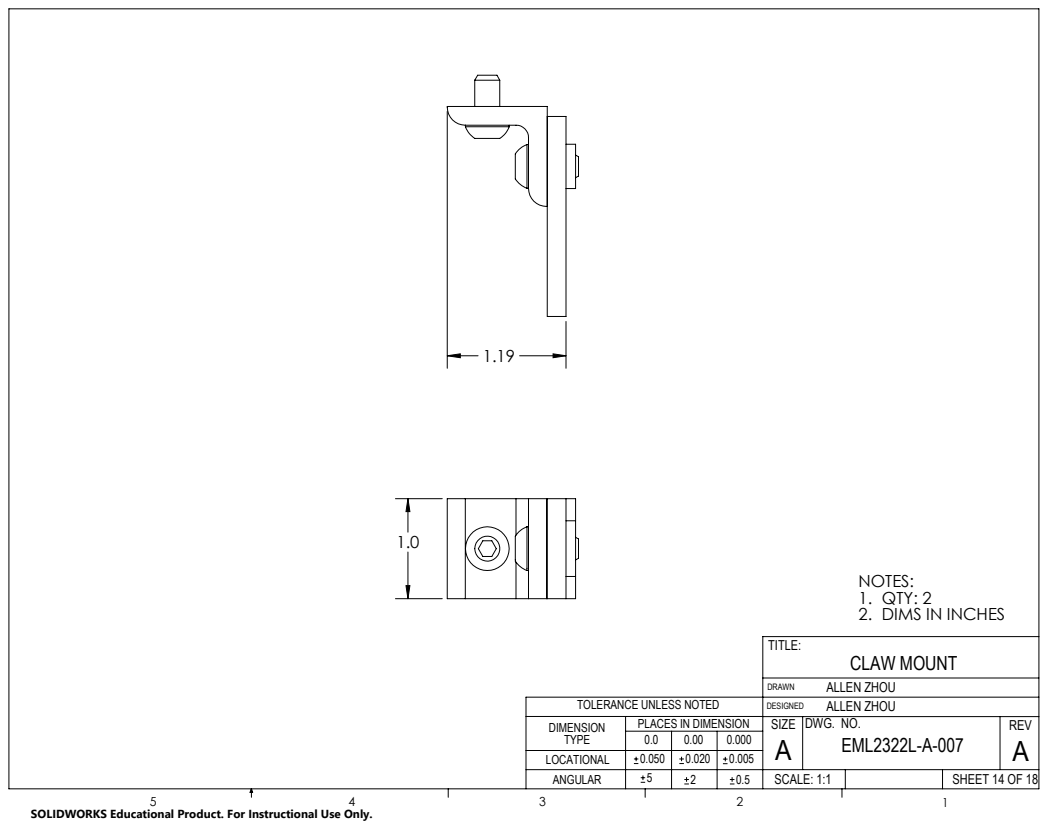
[picture p74: page 20]
SCALE: 1:1

NOTES:
QTY: 2
2. DIMS IN INCHES
CLAW MOUNT
ALLEN ZHOU
DWG. NO.
SIZE

TOLERANCE UNLESS NOTED
DIMENSION
TYPE
LOCATIONAL

PLACES IN DIMENSION

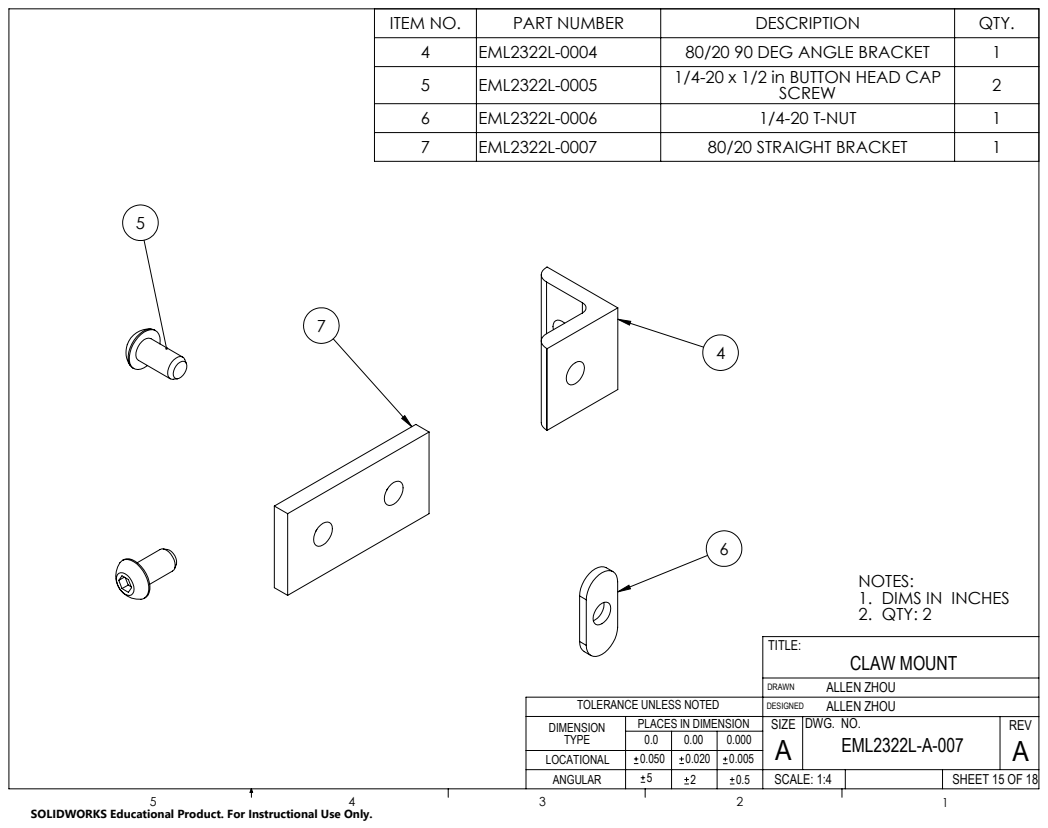
[picture p75: page 21]
SCALE: 1:4

ITEM NO. | PART NUMBER | DESCRIPTION | QTY.
4 | EML2322L-0004 | 80/20 90 DEG ANGLE BRACKET | 1
5 | EML2322L-0005 | 1/4-20 x 1/2 in BUTTON HEAD CAP SCREW | 2
6 | EML2322L-0006 | 1/4-20 T-NUT | 1
7 | EML2322L-0007 | 80/20 STRAIGHT BRACKET | 1

NOTES:
DIMS IN INCHES
2. QTY: 2
CLAW MOUNT
ALLEN ZHOU
DWG. NO.
SIZE

TOLERANCE UNLESS NOTED
DIMENSION
TYPE
LOCATIONAL

PLACES IN DIMENSION

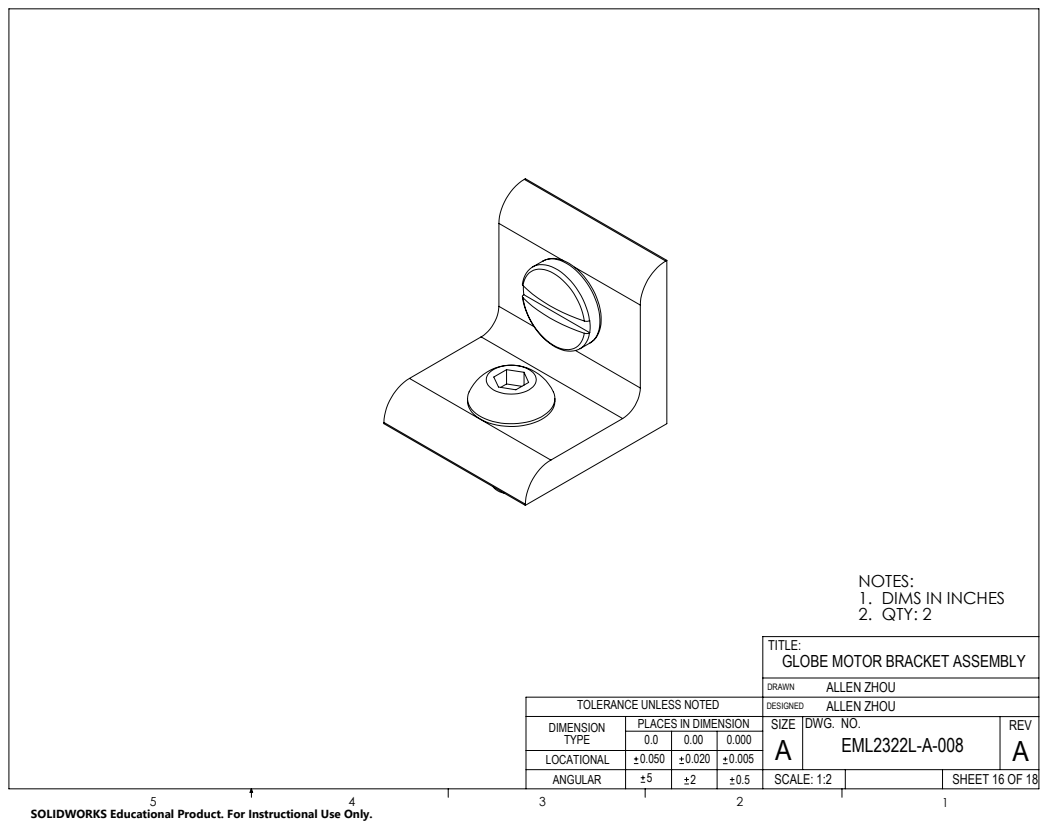
[picture p76: page 22]
SCALE: 1:2; DIMS IN INCHES 2. QTY: 2

TITLE:
GLOBE MOTOR BRACKET ASSEMBLY
ALLEN ZHOU
DWG. NO.
SIZE

TOLERANCE UNLESS NOTED
DIMENSION
TYPE
LOCATIONAL

PLACES IN DIMENSION

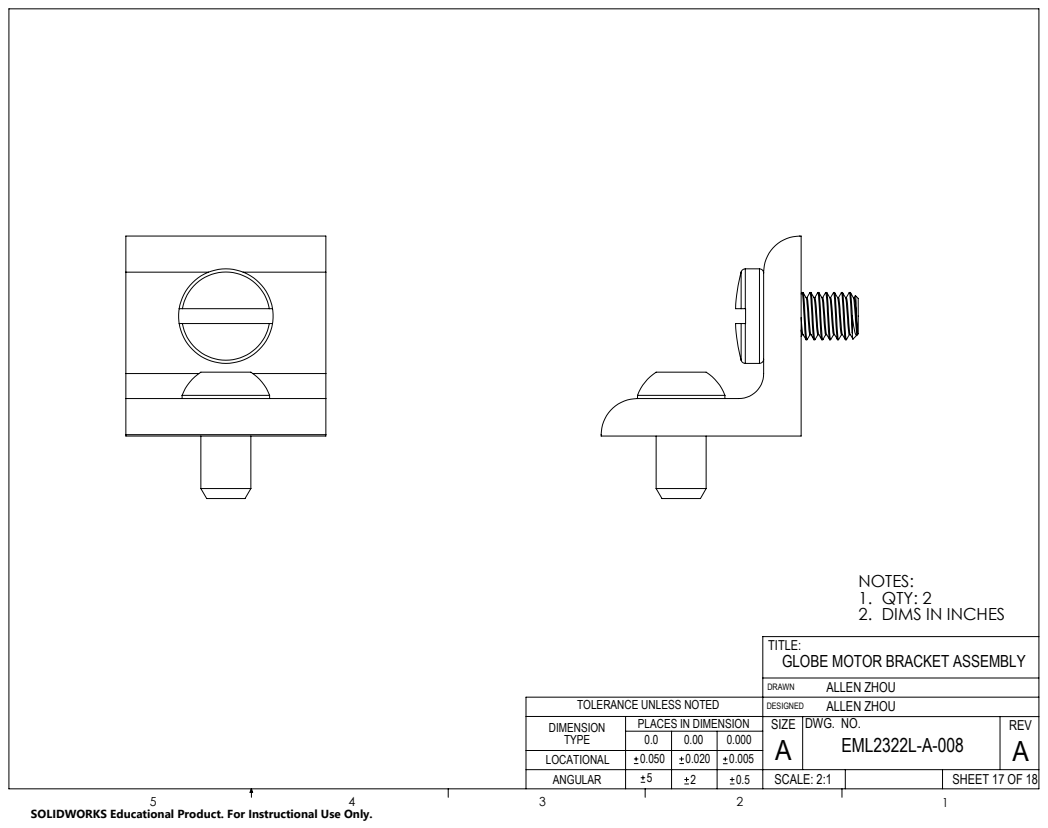
[picture p77: page 23]
SCALE: 2:1; QTY: 2 2. DIMS IN INCHES

TITLE:
GLOBE MOTOR BRACKET ASSEMBLY
ALLEN ZHOU
DWG. NO.
SIZE

TOLERANCE UNLESS NOTED
DIMENSION
TYPE
LOCATIONAL

PLACES IN DIMENSION

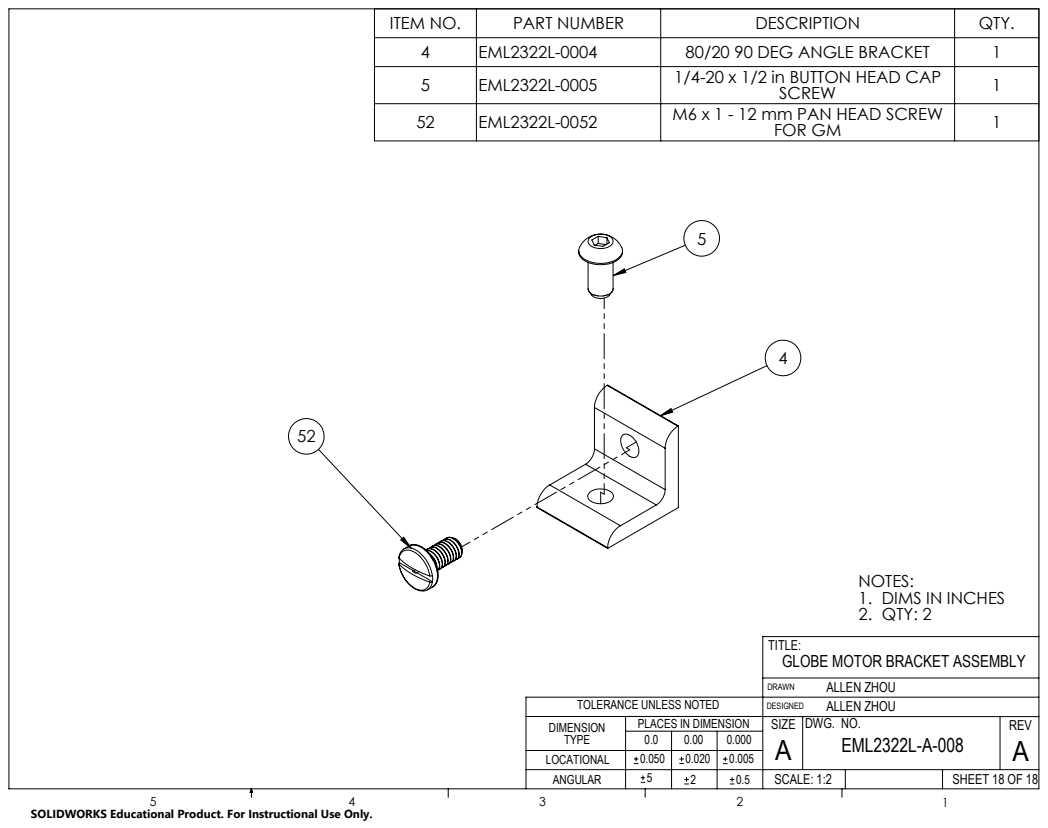
[picture p78: page 24]
SCALE: 1:2; DIMS IN INCHES 2. QTY: 2

ITEM NO. | PART NUMBER | DESCRIPTION | QTY.
4 | EML2322L-0004 | 80/20 90 DEG ANGLE BRACKET | 1
5 | EML2322L-0005 | 1/4-20 x 1/2 in BUTTON HEAD CAP SCREW | 1
52 | EML2322L-0052 | M6 x 1 - 12 mm PAN HEAD SCREW FOR GM | 1

TITLE:
GLOBE MOTOR BRACKET ASSEMBLY
ALLEN ZHOU
DWG. NO.
SIZE

TOLERANCE UNLESS NOTED
DIMENSION
TYPE
LOCATIONAL

PLACES IN DIMENSION

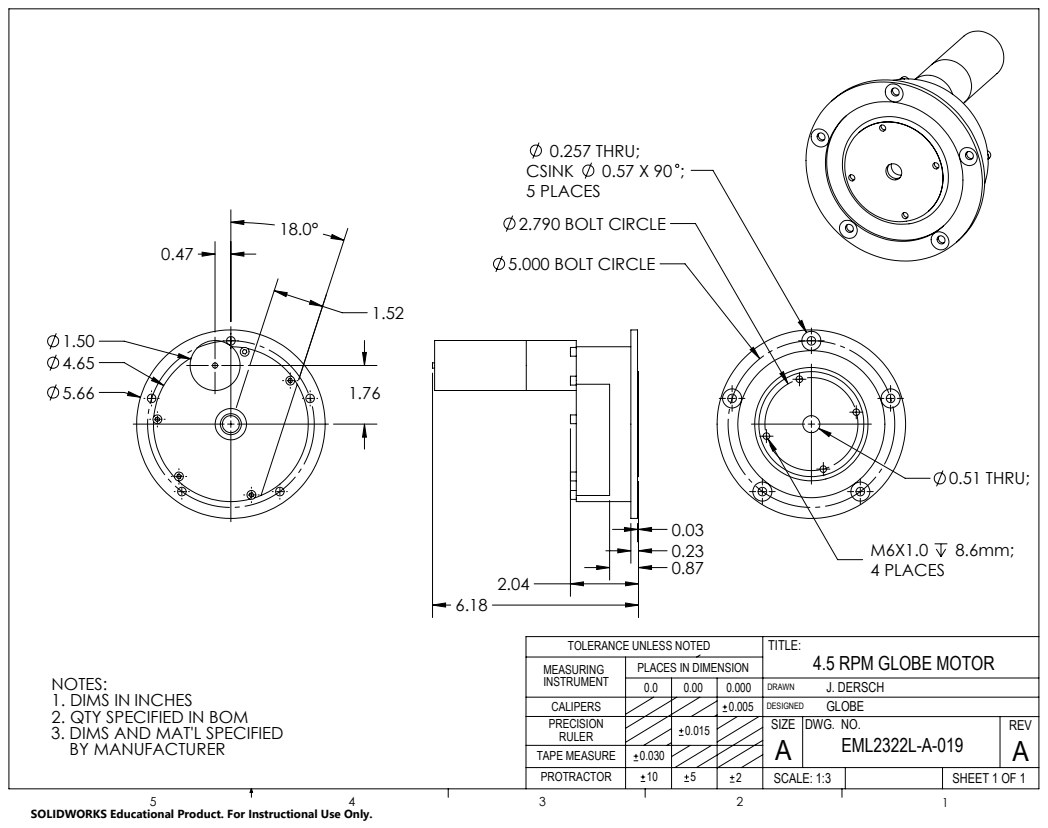
[picture p79: page 25]
0.257 THRU;; CSINK; 5 PLACES; 0.51 THRU;; M6X1.0 8.6mm; 4 PLACES; 2.790 BOLT CIRCLE; 5.000 BOLT CIRCLE; SHEET 1 OF 1; TAPE MEASURE; TOLERANCE UNLESS NOTED; SCALE: 1:3

TITLE:
4.5 RPM GLOBE MOTOR
J. DERSCH
GLOBE
DWG. NO.

PLACES IN DIMENSION

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
