markyen001/DR3-Resubmission/Documents Ready for Print/PRINT 1-9.pdf

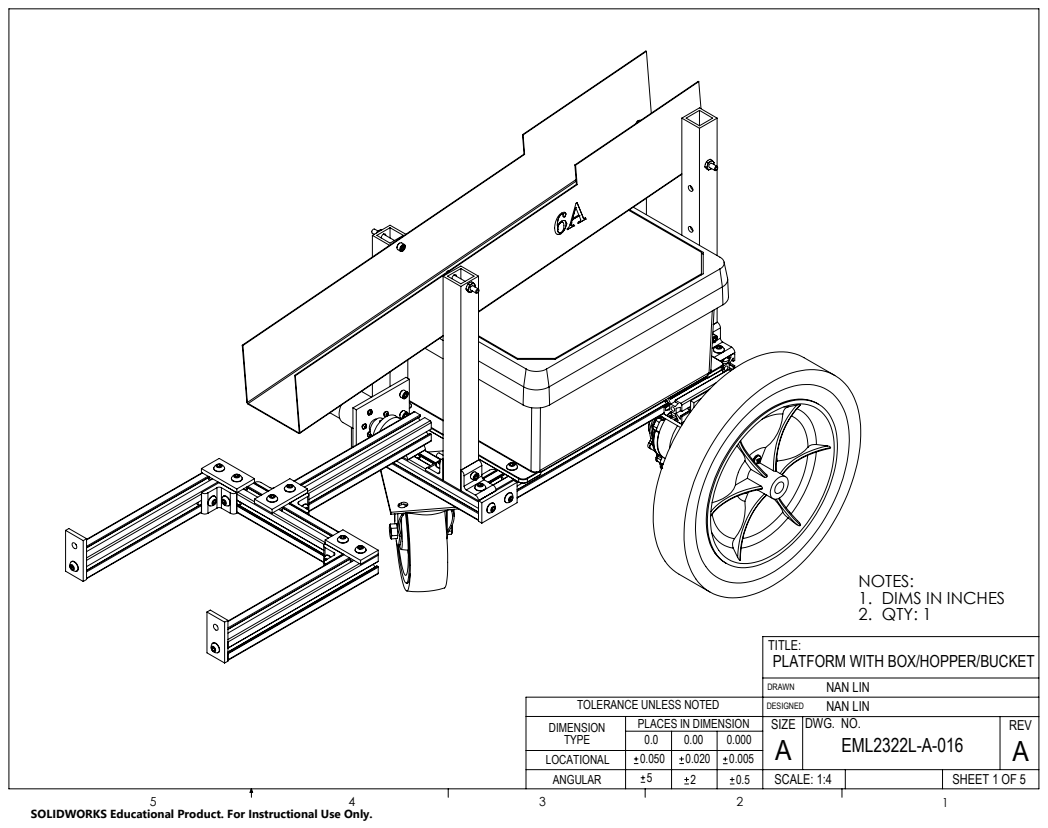
[picture p80: page 1]
SHEET 1 OF 5; TOLERANCE UNLESS NOTED; SCALE: 1:4; DIMS IN INCHES 2. QTY: 1

TITLE:
PLATFORM WITH BOX/HOPPER/BUCKET
NAN LIN
DWG. NO.
SIZE

PLACES IN DIMENSION

SOLIDWORKS Educational Product. For Instructional Use Only.

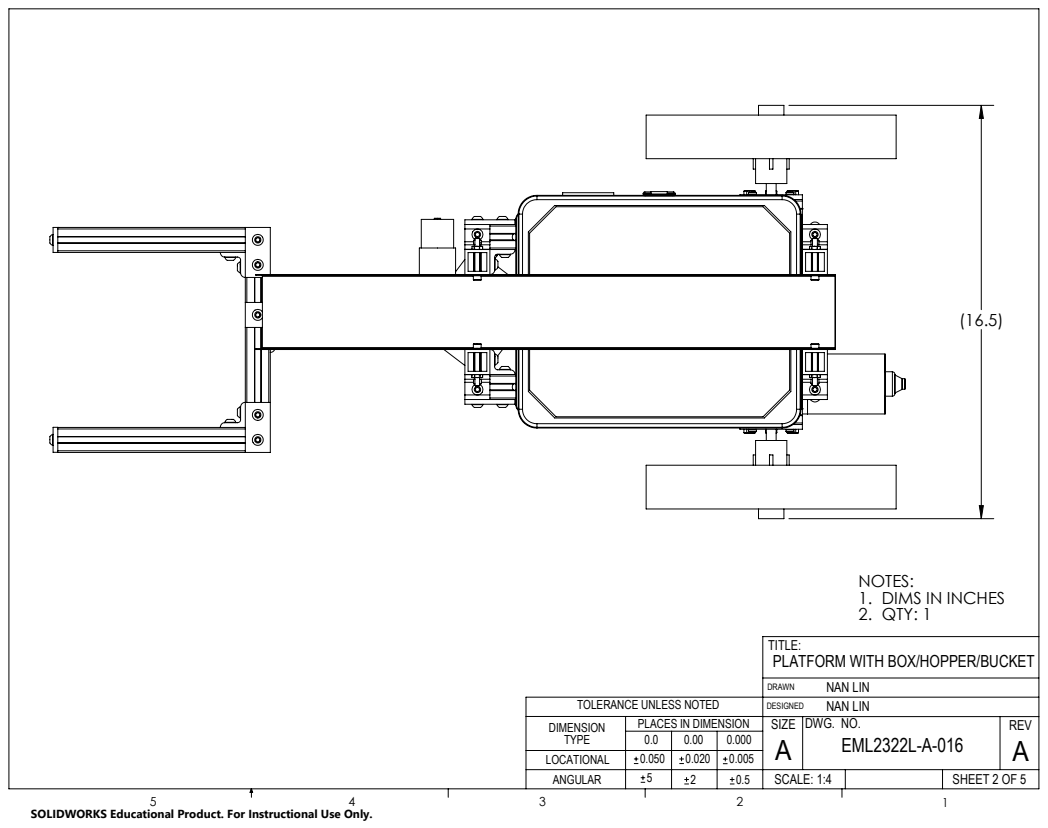
[picture p81: page 2]
DIMS IN INCHES 2. QTY: 1

TITLE:
PLATFORM WITH BOX/HOPPER/BUCKET
NAN LIN
DWG. NO.
SIZE

TOLERANCE UNLESS NOTED
DIMENSION
TYPE
LOCATIONAL

PLACES IN DIMENSION

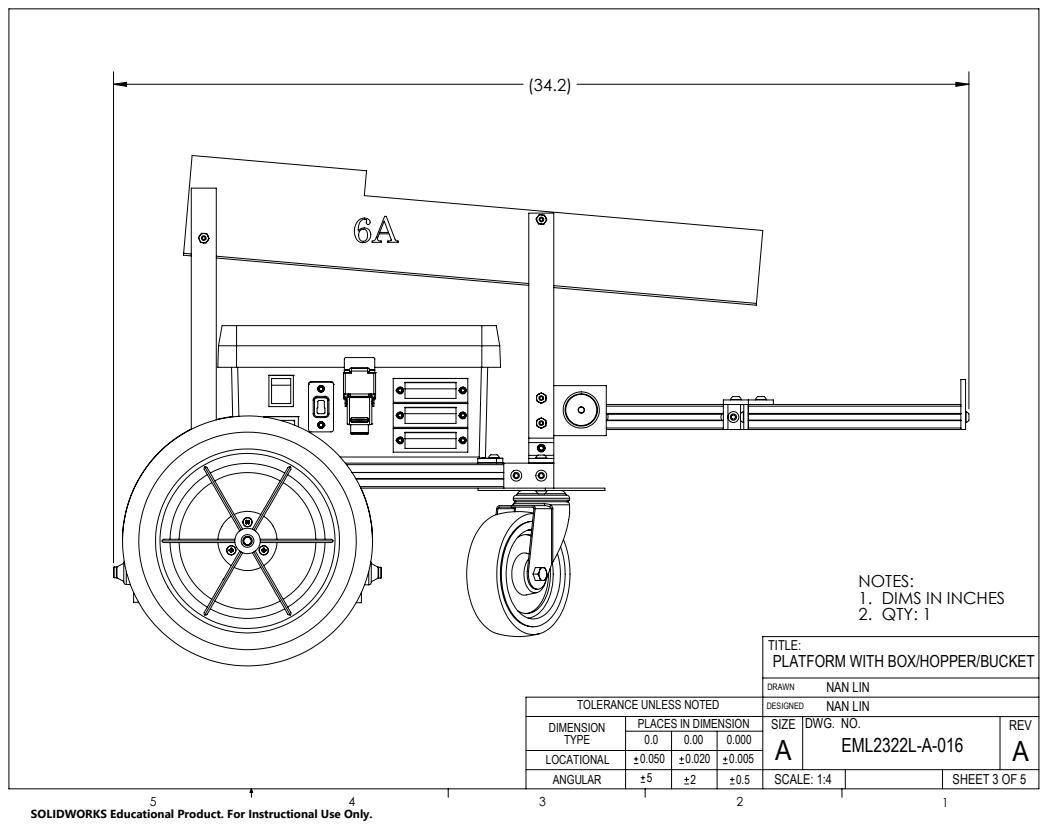
[picture p82: page 3]
DIMS IN INCHES 2. QTY: 1

TITLE:
PLATFORM WITH BOX/HOPPER/BUCKET
NAN LIN
DWG. NO.
SIZE

TOLERANCE UNLESS NOTED
DIMENSION
TYPE
LOCATIONAL

PLACES IN DIMENSION

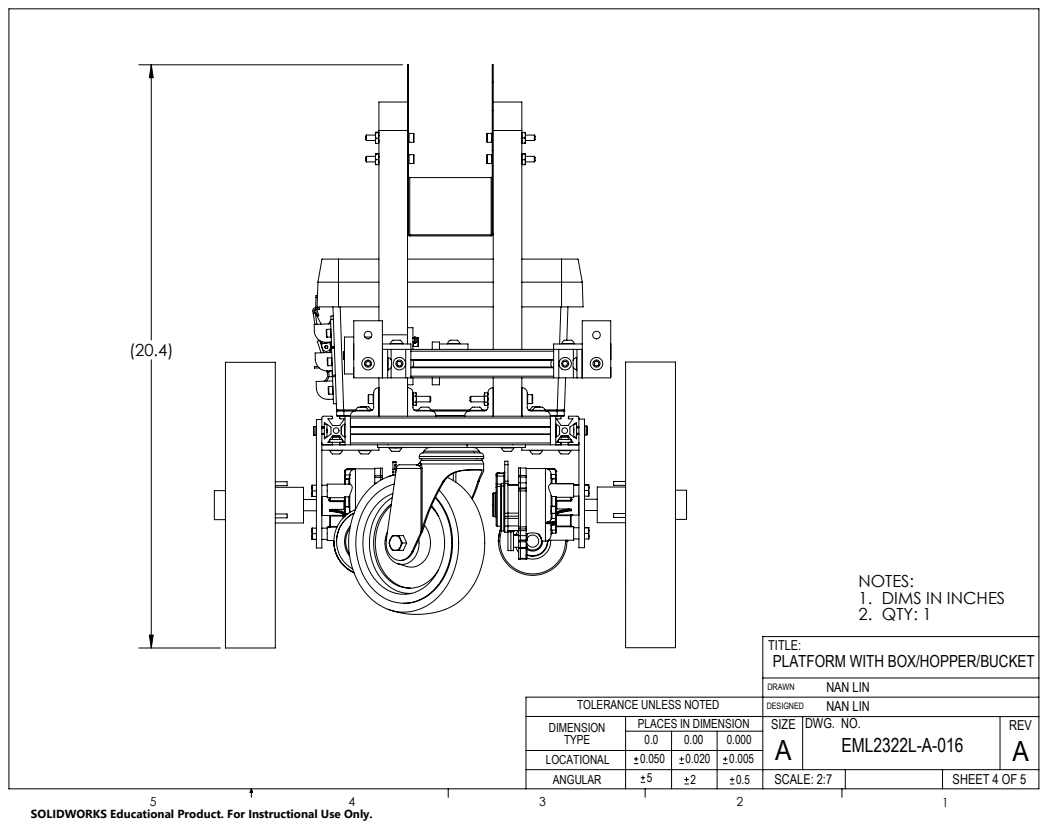
[picture p83: page 4]
SCALE: 2:7; DIMS IN INCHES 2. QTY: 1

TITLE:
PLATFORM WITH BOX/HOPPER/BUCKET
NAN LIN
DWG. NO.
SIZE

TOLERANCE UNLESS NOTED
DIMENSION
TYPE
LOCATIONAL

PLACES IN DIMENSION

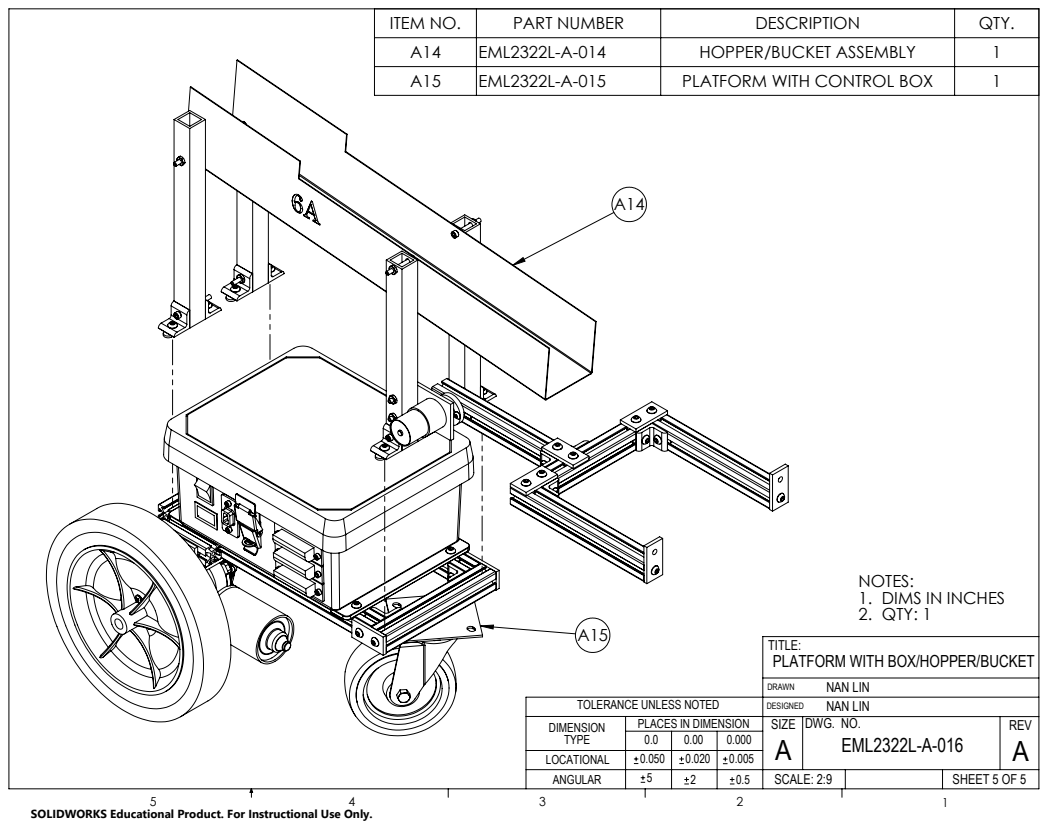
[picture p84: page 5]
SCALE: 2:9; DIMS IN INCHES 2. QTY: 1

ITEM NO. | PART NUMBER | DESCRIPTION | QTY.
A14 | EML2322L-A-014 | HOPPER/BUCKET ASSEMBLY | 1
A15 | EML2322L-A-015 | PLATFORM WITH CONTROL BOX | 1

TITLE:
PLATFORM WITH BOX/HOPPER/BUCKET
NAN LIN
DWG. NO.
SIZE

TOLERANCE UNLESS NOTED
DIMENSION
TYPE
LOCATIONAL

PLACES IN DIMENSION

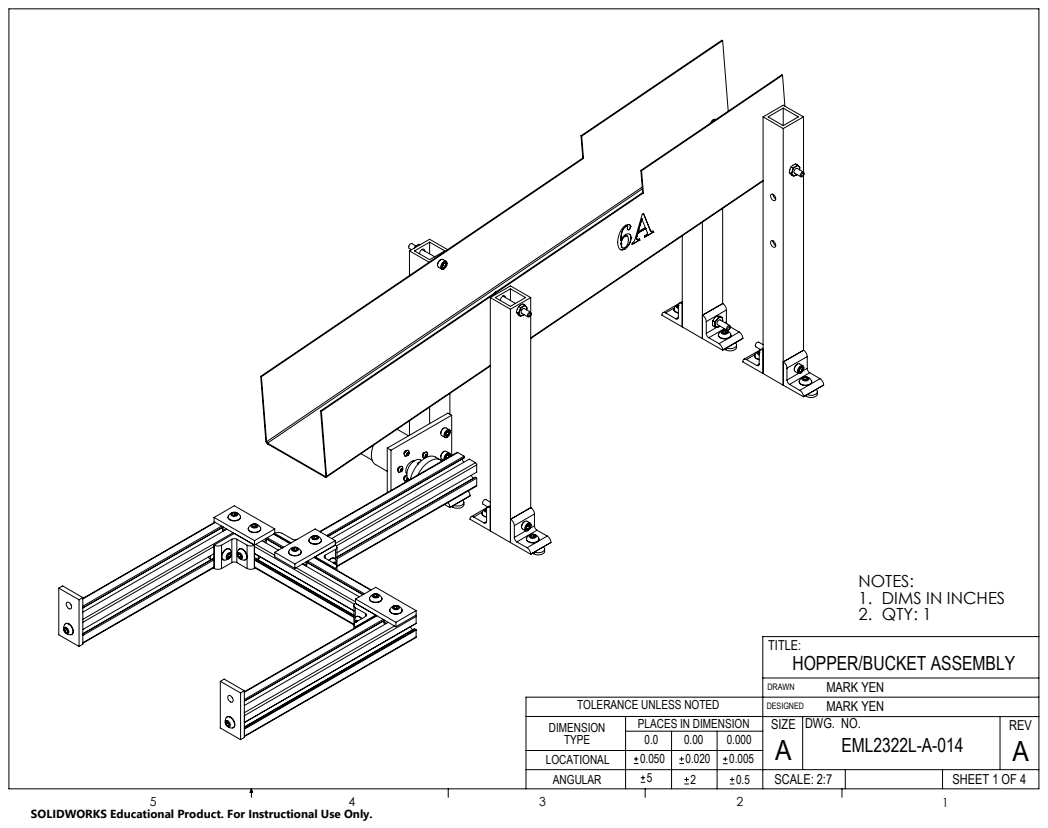
[picture p85: page 6]
SCALE: 2:7

NOTES:
DIMS IN INCHES
2. QTY: 1
HOPPER/BUCKET ASSEMBLY
MARK YEN
DWG. NO.
SIZE

TOLERANCE UNLESS NOTED
DIMENSION
TYPE
LOCATIONAL

PLACES IN DIMENSION

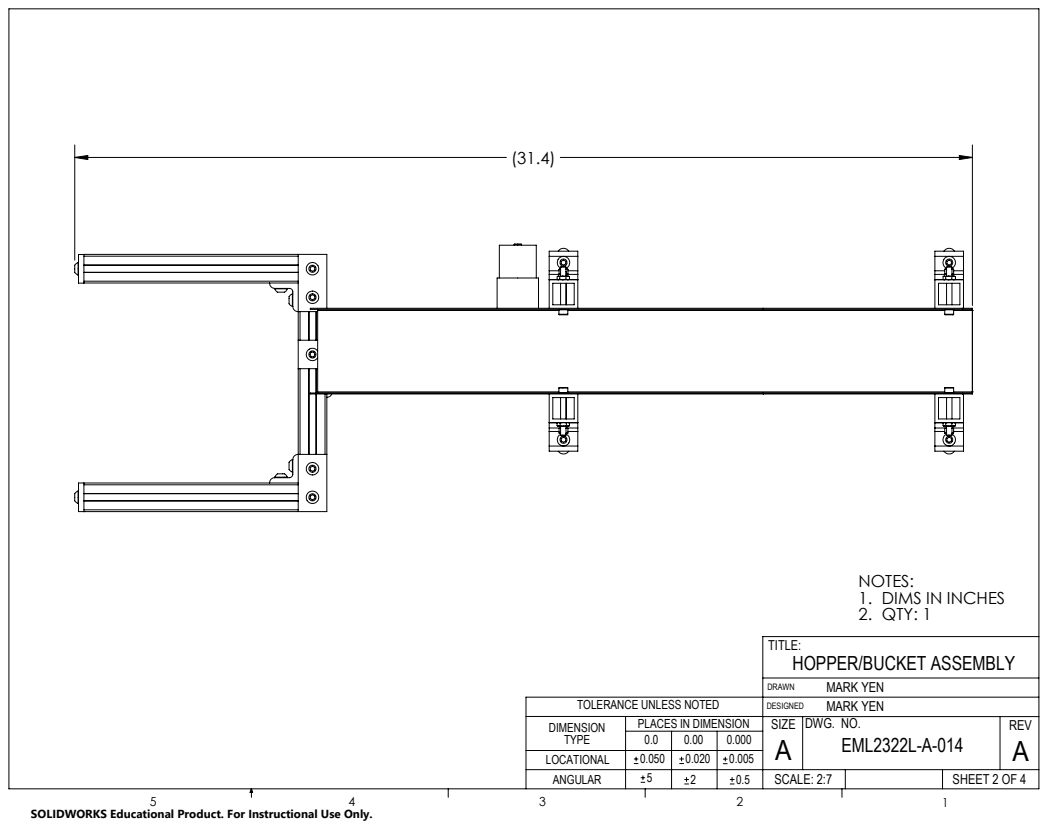
[picture p86: page 7]
SCALE: 2:7

NOTES:
DIMS IN INCHES
2. QTY: 1
HOPPER/BUCKET ASSEMBLY
MARK YEN
DWG. NO.
SIZE

TOLERANCE UNLESS NOTED
DIMENSION
TYPE
LOCATIONAL

PLACES IN DIMENSION

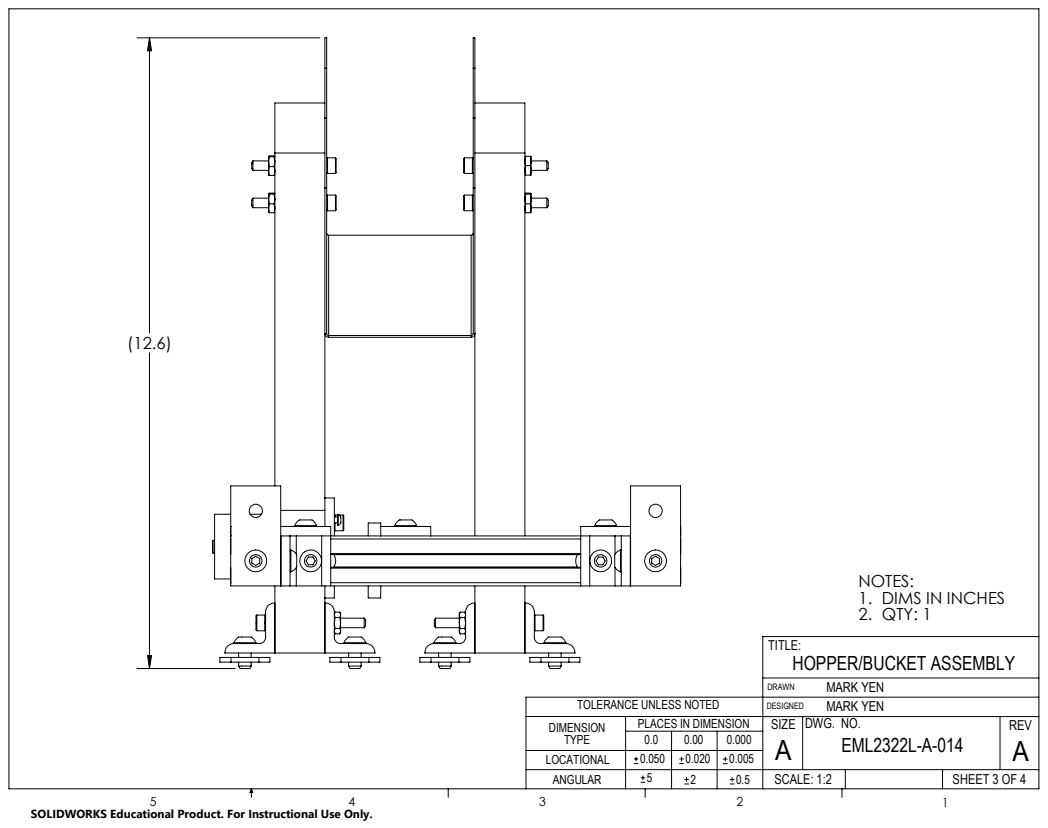
[picture p87: page 8]

NOTES:
DIMS IN INCHES
2. QTY: 1
HOPPER/BUCKET ASSEMBLY
MARK YEN
DWG. NO.
SIZE

TOLERANCE UNLESS NOTED
DIMENSION
TYPE
LOCATIONAL

PLACES IN DIMENSION

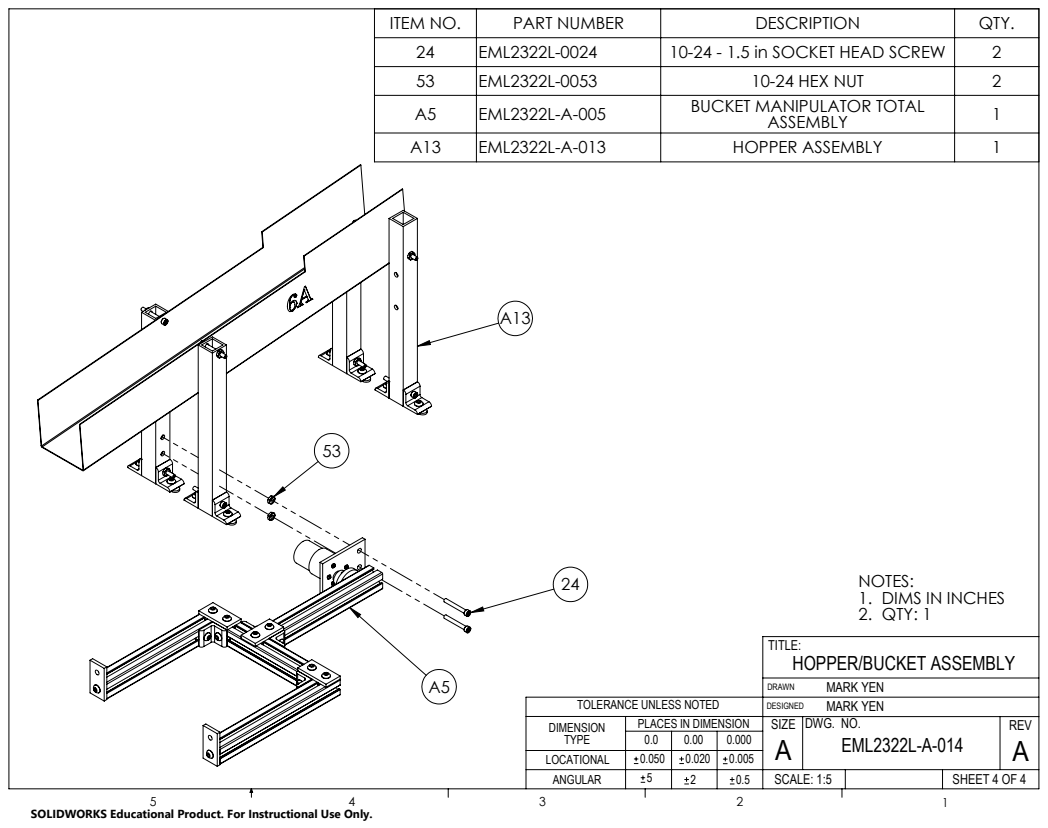
[picture p88: page 9]

ITEM NO. | PART NUMBER | DESCRIPTION | QTY.
24 | EML2322L-0024 | 10-24 - 1.5 in SOCKET HEAD SCREW | 2
53 | EML2322L-0053 | 10-24 HEX NUT | 2
A5 | EML2322L-A-005 | BUCKET MANIPULATOR TOTAL ASSEMBLY | 1
A13 | EML2322L-A-013 | HOPPER ASSEMBLY | 1

NOTES:
DIMS IN INCHES
2. QTY: 1
HOPPER/BUCKET ASSEMBLY
MARK YEN
DWG. NO.
SIZE

TOLERANCE UNLESS NOTED
DIMENSION
TYPE
LOCATIONAL

PLACES IN DIMENSION

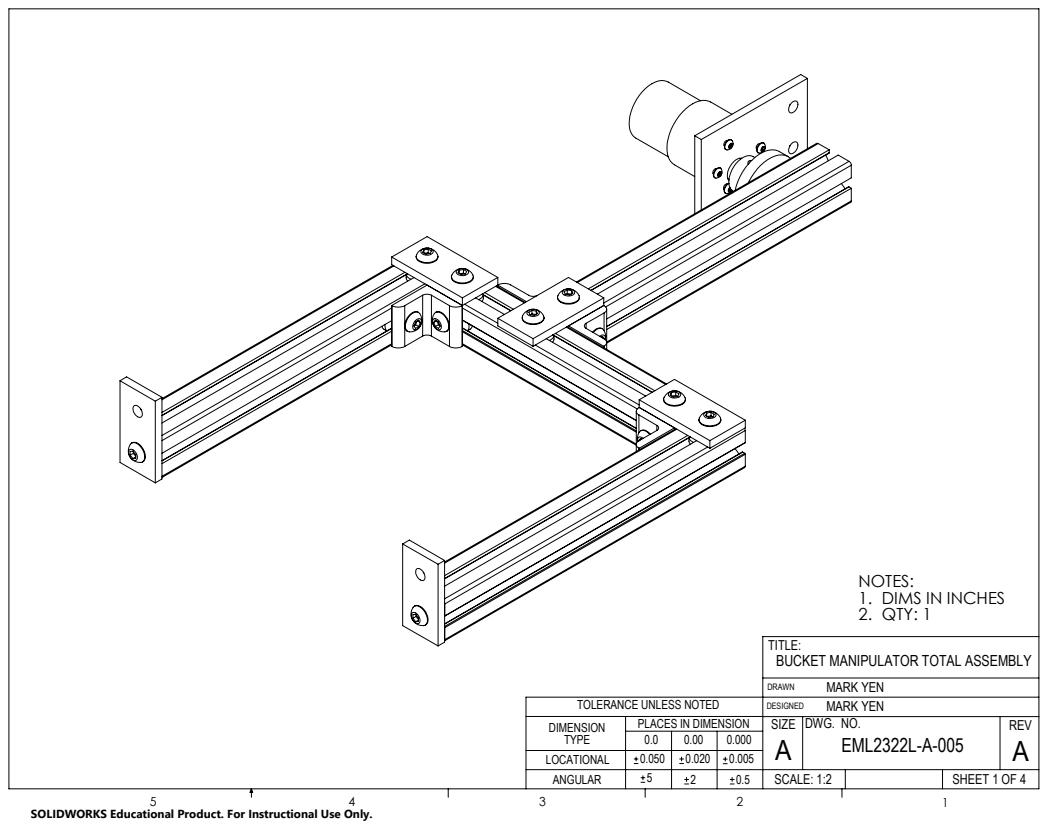
[picture p89: page 10]
DIMS IN INCHES 2. QTY: 1

TITLE:
BUCKET MANIPULATOR TOTAL ASSEMBLY
MARK YEN
DWG. NO.
SIZE

TOLERANCE UNLESS NOTED
DIMENSION
TYPE
LOCATIONAL

PLACES IN DIMENSION

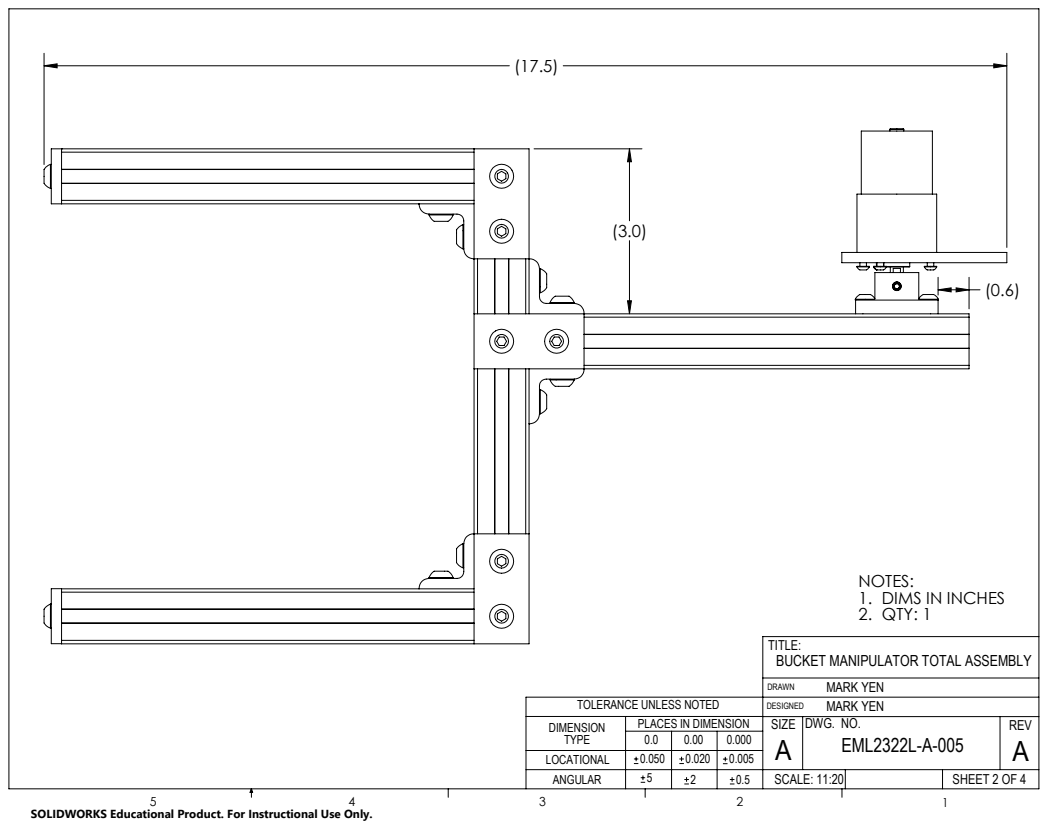
[picture p90: page 11]
SCALE: 11:20; DIMS IN INCHES 2. QTY: 1

TITLE:
BUCKET MANIPULATOR TOTAL ASSEMBLY
MARK YEN
DWG. NO.
SIZE

TOLERANCE UNLESS NOTED
DIMENSION
TYPE
LOCATIONAL

PLACES IN DIMENSION

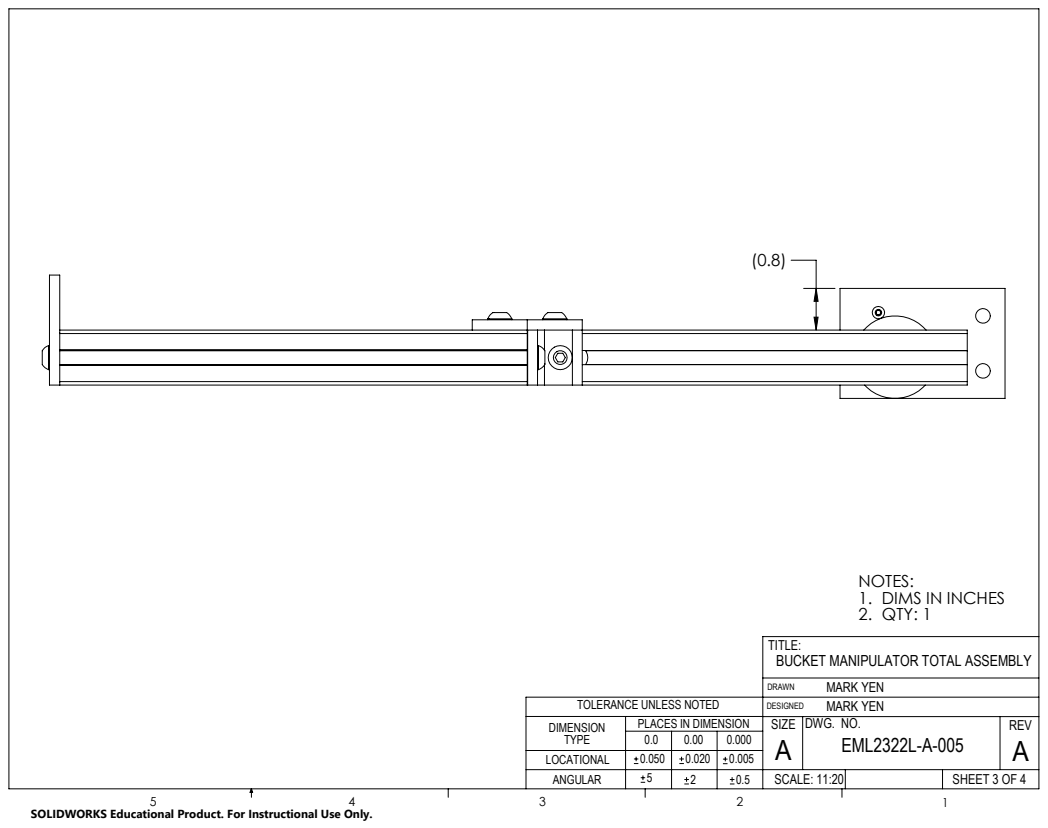
[picture p91: page 12]
SCALE: 11:20; DIMS IN INCHES 2. QTY: 1

TITLE:
BUCKET MANIPULATOR TOTAL ASSEMBLY
MARK YEN
DWG. NO.
SIZE

TOLERANCE UNLESS NOTED
DIMENSION
TYPE
LOCATIONAL

PLACES IN DIMENSION

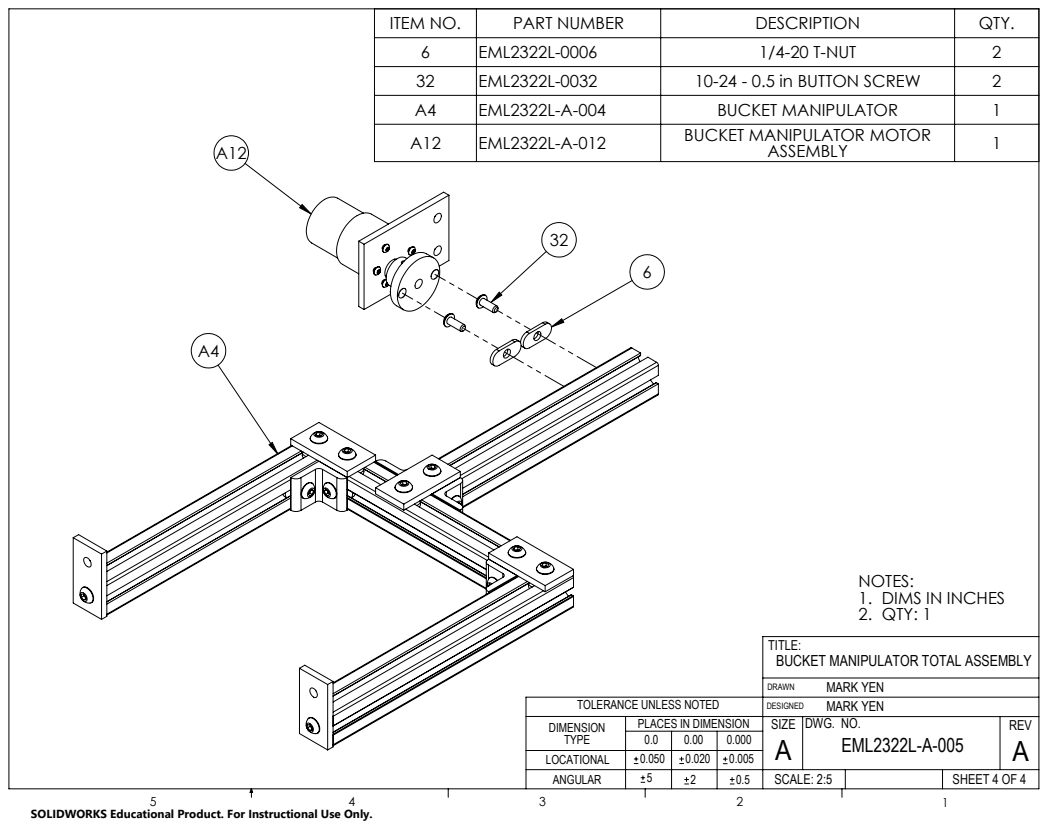
[picture p92: page 13]
SCALE: 2:5; DIMS IN INCHES 2. QTY: 1

ITEM NO. | PART NUMBER | DESCRIPTION | QTY.
6 | EML2322L-0006 | 1/4-20 T-NUT | 2
32 | EML2322L-0032 | 10-24 - 0.5 in BUTTON SCREW | 2
A4 | EML2322L-A-004 | BUCKET MANIPULATOR | 1
A12 | EML2322L-A-012 | BUCKET MANIPULATOR MOTOR ASSEMBLY | 1

TITLE:
BUCKET MANIPULATOR TOTAL ASSEMBLY
MARK YEN
DWG. NO.
SIZE

TOLERANCE UNLESS NOTED
DIMENSION
TYPE
LOCATIONAL

PLACES IN DIMENSION

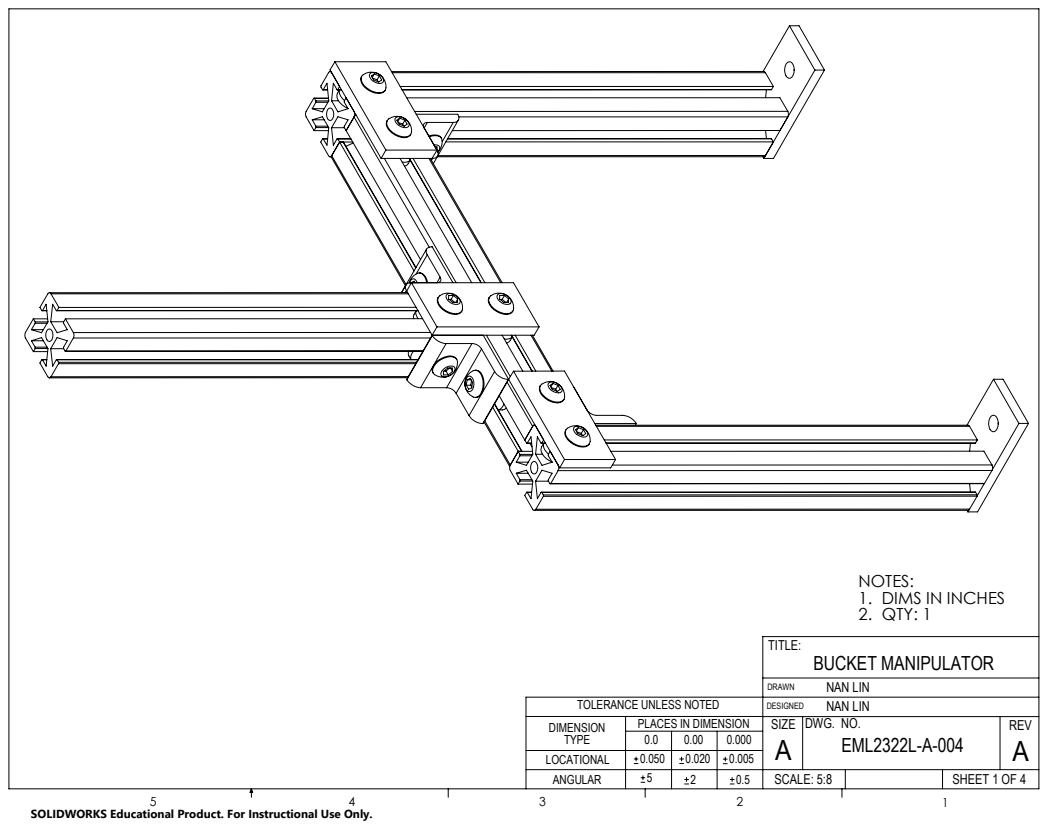
[picture p93: page 14]
SCALE: 5:8

NOTES:
DIMS IN INCHES
2. QTY: 1
BUCKET MANIPULATOR
NAN LIN
DWG. NO.
SIZE

TOLERANCE UNLESS NOTED
DIMENSION
TYPE
LOCATIONAL

PLACES IN DIMENSION

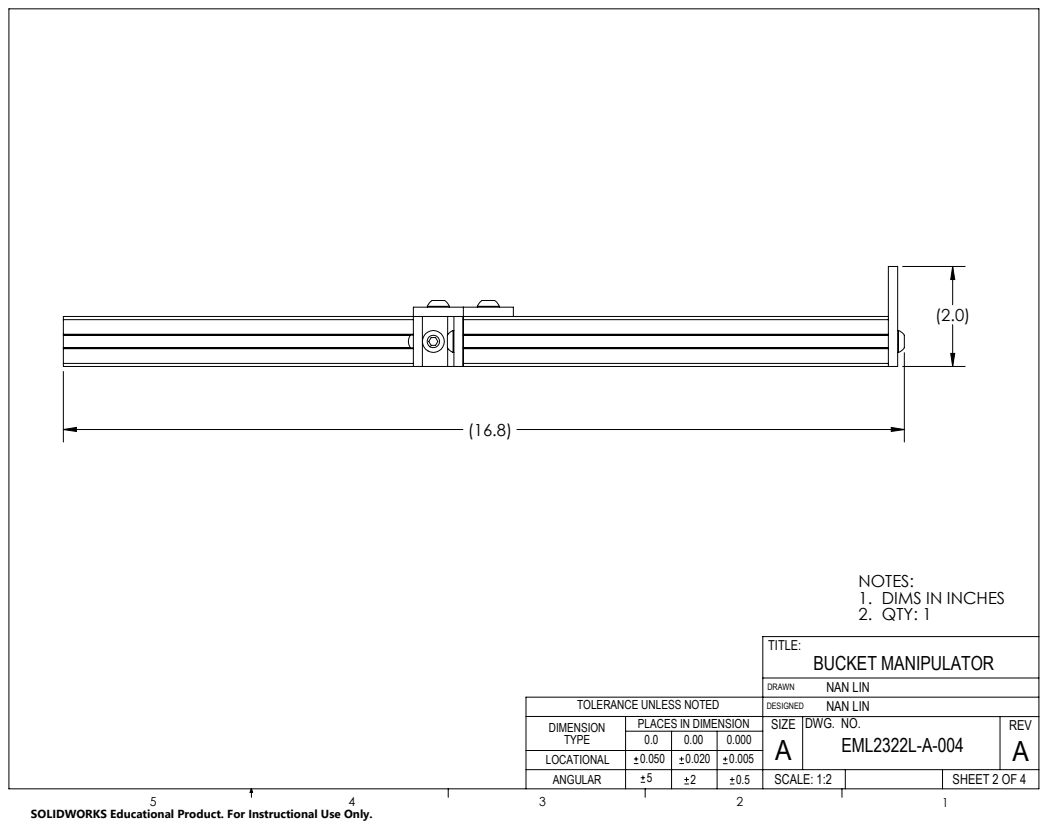
[picture p94: page 15]

NOTES:
DIMS IN INCHES
2. QTY: 1
BUCKET MANIPULATOR
NAN LIN
DWG. NO.
SIZE

TOLERANCE UNLESS NOTED
DIMENSION
TYPE
LOCATIONAL

PLACES IN DIMENSION

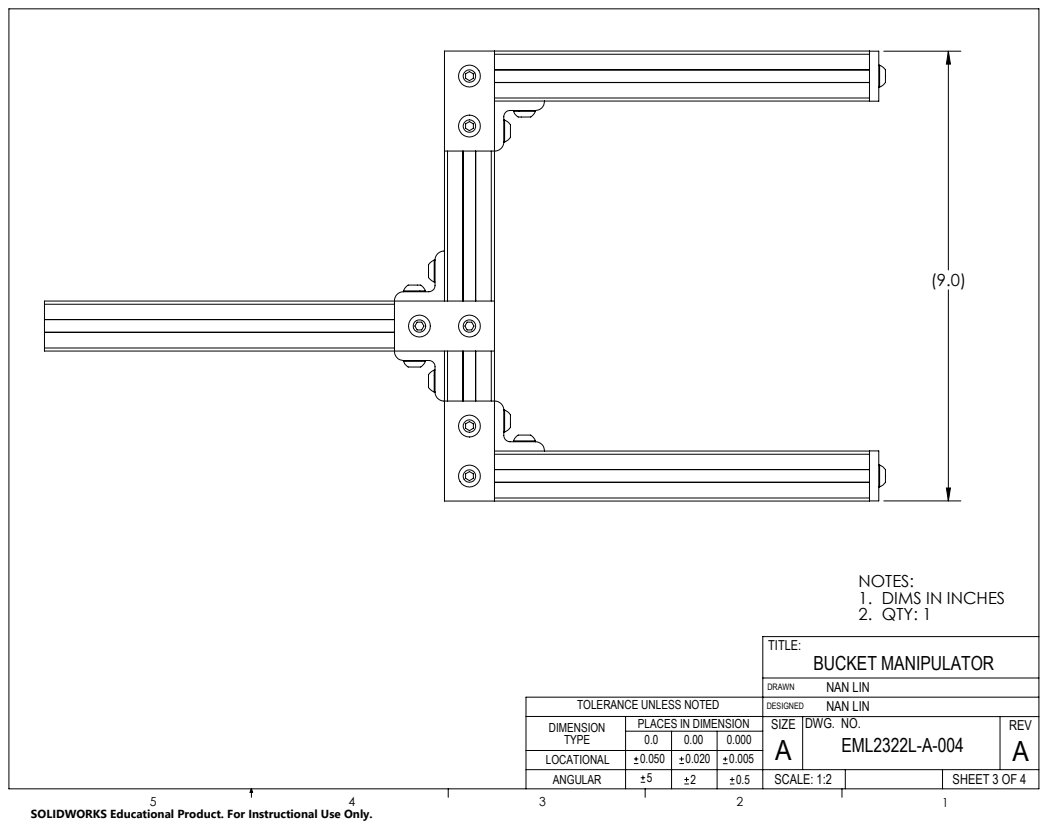
[picture p95: page 16]

NOTES:
DIMS IN INCHES
2. QTY: 1
BUCKET MANIPULATOR
NAN LIN
DWG. NO.
SIZE

TOLERANCE UNLESS NOTED
DIMENSION
TYPE
LOCATIONAL

PLACES IN DIMENSION

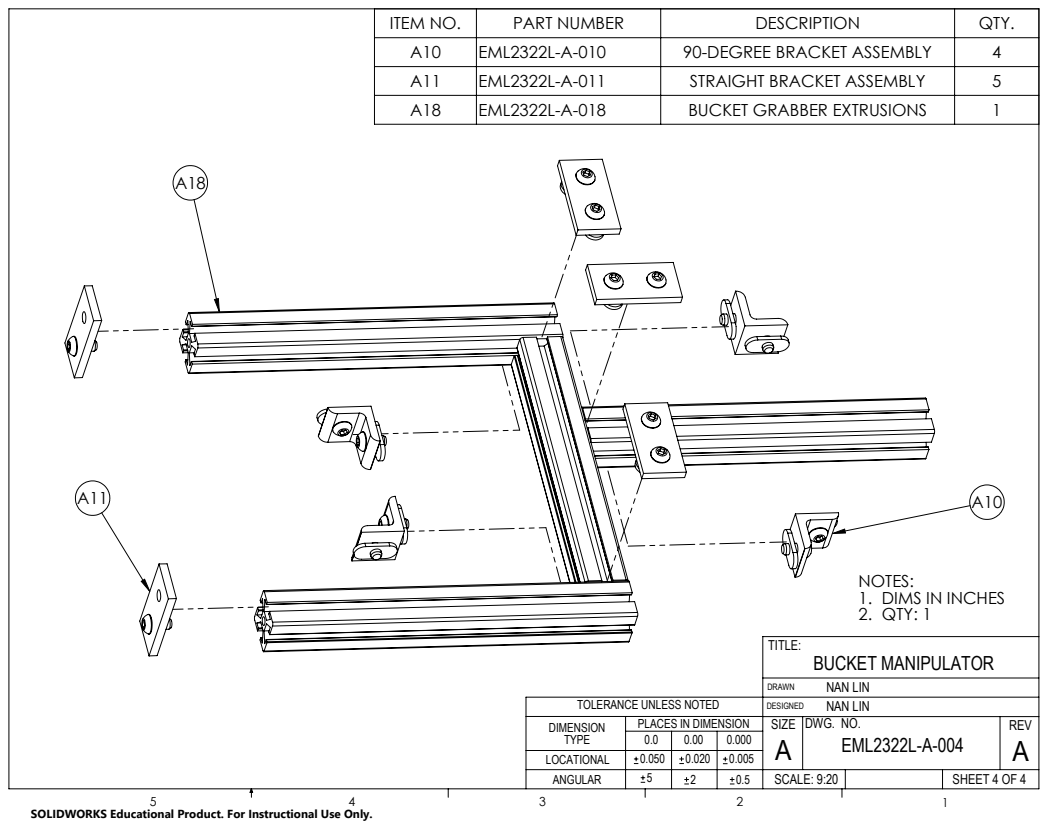
[picture p96: page 17]
SCALE: 9:20

ITEM NO. | PART NUMBER | DESCRIPTION | QTY.
A10 | EML2322L-A-010 | 90-DEGREE BRACKET ASSEMBLY | 4
A11 | EML2322L-A-011 | STRAIGHT BRACKET ASSEMBLY | 5
A18 | EML2322L-A-018 | BUCKET GRABBER EXTRUSIONS | 1

NOTES:
DIMS IN INCHES
2. QTY: 1
BUCKET MANIPULATOR
NAN LIN
DWG. NO.
SIZE

TOLERANCE UNLESS NOTED
DIMENSION
TYPE
LOCATIONAL

PLACES IN DIMENSION

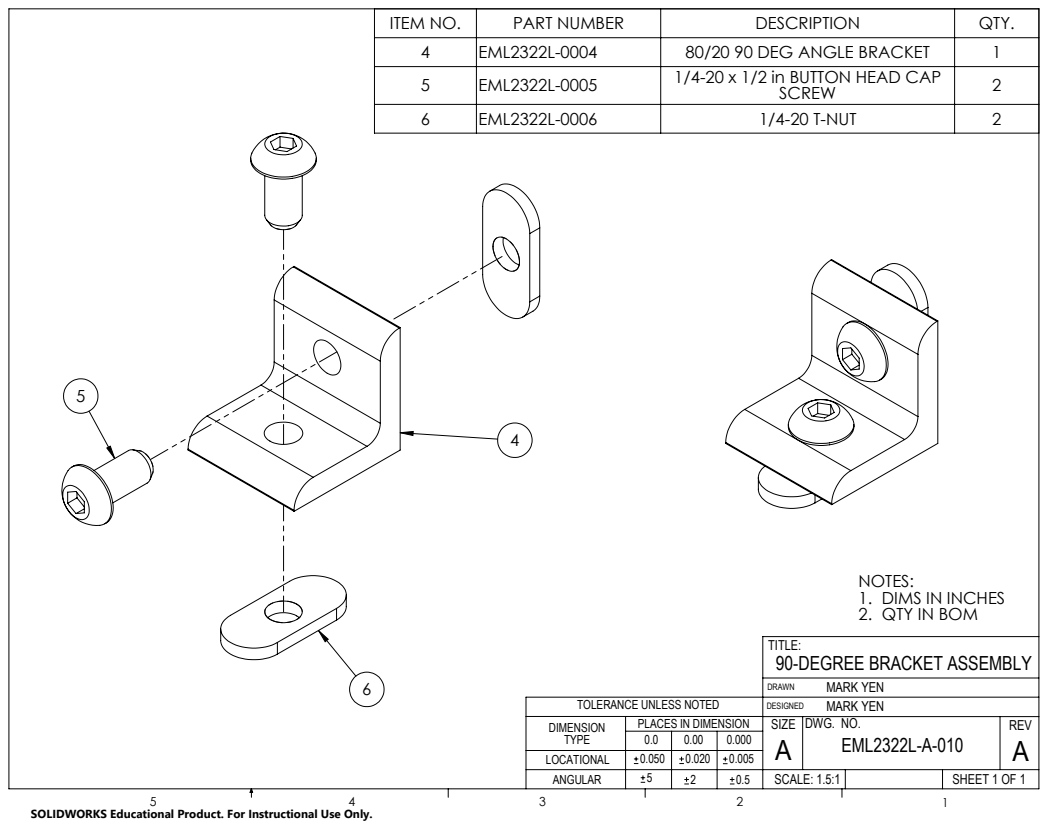
[picture p97: page 18]
SCALE: 1.5:1

ITEM NO. | PART NUMBER | DESCRIPTION | QTY.
4 | EML2322L-0004 | 80/20 90 DEG ANGLE BRACKET | 1
5 | EML2322L-0005 | 1/4-20 x 1/2 in BUTTON HEAD CAP SCREW | 2
6 | EML2322L-0006 | 1/4-20 T-NUT | 2

NOTES:
DIMS IN INCHES
2. QTY IN BOM

TITLE:
90-DEGREE BRACKET ASSEMBLY
MARK YEN
DWG. NO.
SIZE

TOLERANCE UNLESS NOTED
DIMENSION
TYPE
LOCATIONAL

PLACES IN DIMENSION

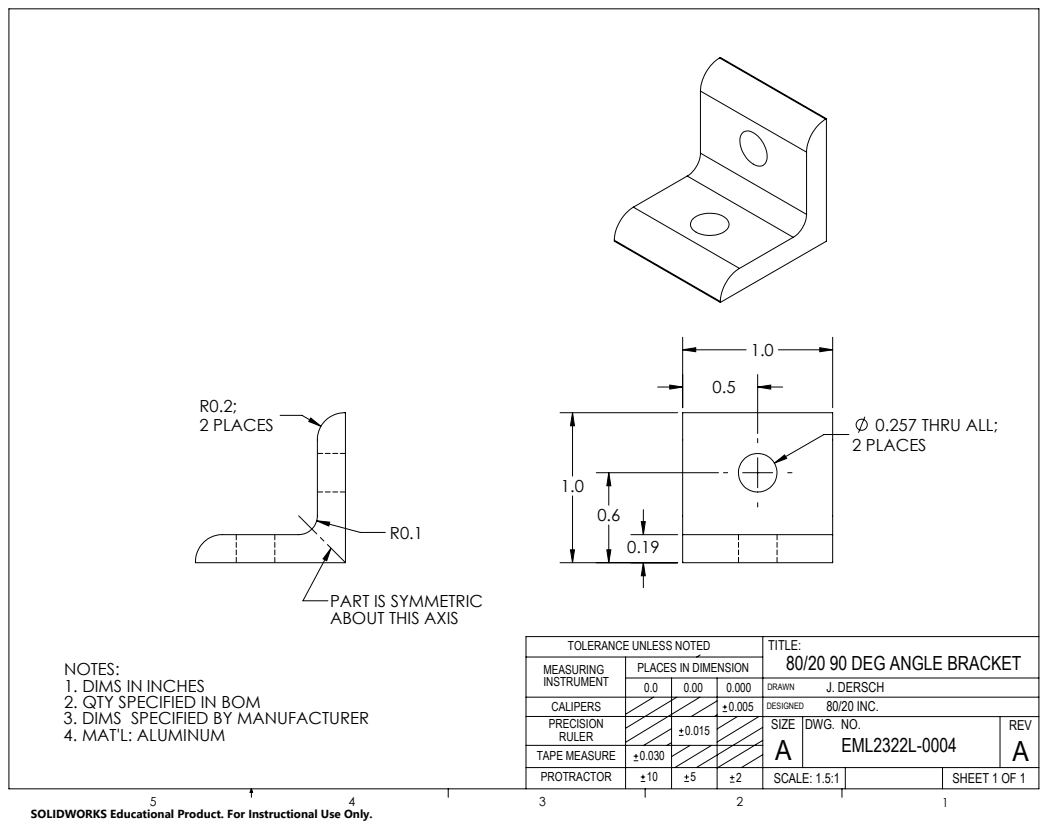
[picture p98: page 19]
2 PLACES; 0.257 THRU ALL; 2 PLACES; SHEET 1 OF 1; TAPE MEASURE; TOLERANCE UNLESS NOTED; SCALE: 1.5:1

PART IS SYMMETRIC
ABOUT THIS AXIS

TITLE:
80/20 90 DEG ANGLE BRACKET
J. DERSCH
80/20 INC.
DWG. NO.

NOTES:
1. DIMS IN
2. QTY SPECIFIED IN BOM
3. DIMS SPECIFIED BY MANUFACTURER
4. MAT'L: ALUMINUM

PLACES IN DIMENSION

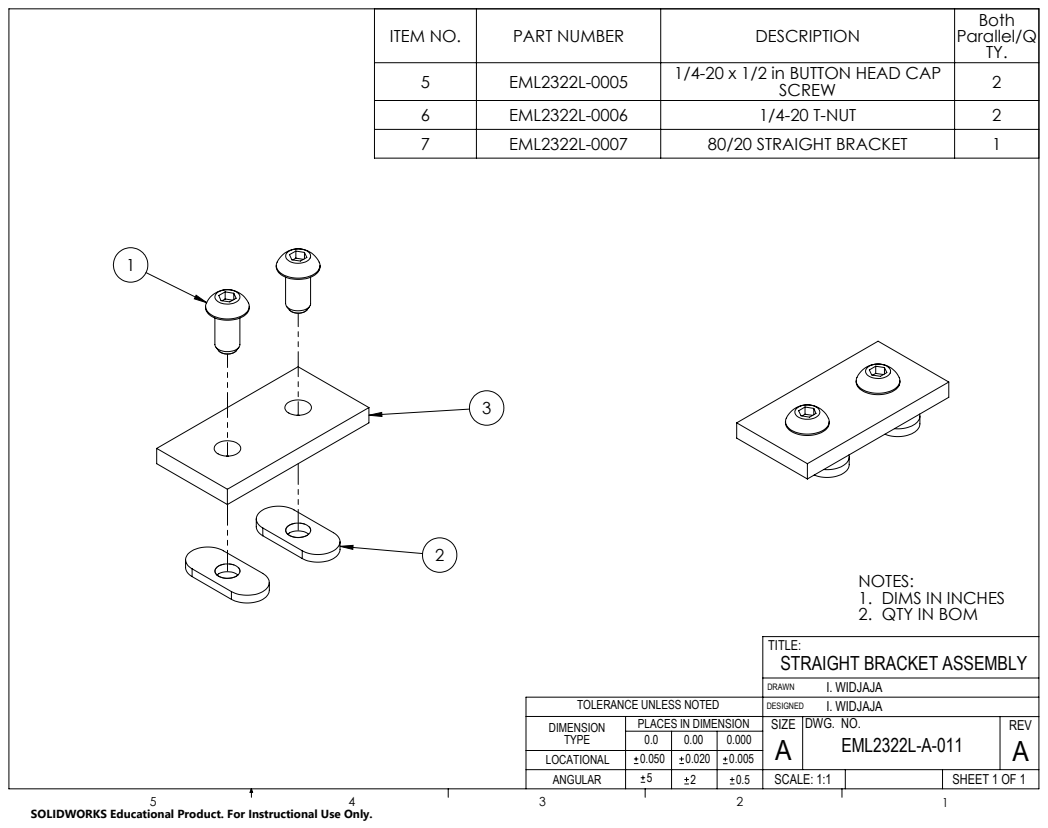
[picture p99: page 20]

ITEM NO. | PART NUMBER | DESCRIPTION | Both Parallel/Q TY.

5 | EML2322L-0005 | 1/4-20 x 1/2 in BUTTON HEAD CAP SCREW | 2
6 | EML2322L-0006 | 1/4-20 T-NUT | 2
7 | EML2322L-0007 | 80/20 STRAIGHT BRACKET | 1

NOTES:
DIMS IN INCHES
2. QTY IN BOM
STRAIGHT BRACKET ASSEMBLY
I. WIDJAJA
DWG. NO.
SIZE

TOLERANCE UNLESS NOTED
DIMENSION
TYPE
LOCATIONAL

PLACES IN DIMENSION

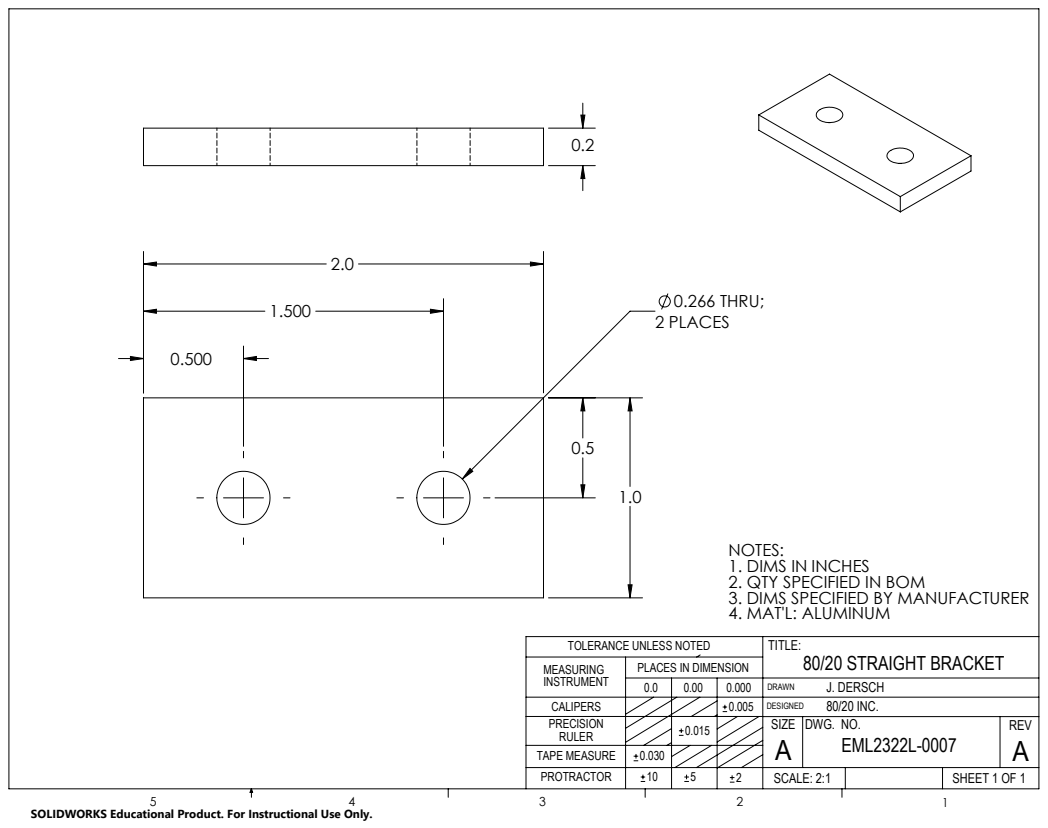
[picture p100: page 21]
0.266 THRU; 2 PLACES; SHEET 1 OF 1; TAPE MEASURE; TOLERANCE UNLESS NOTED; SCALE: 2:1

NOTES:
1. DIMS IN
2. QTY SPECIFIED IN BOM
3. DIMS SPECIFIED BY MANUFACTURER
4. MAT'L: ALUMINUM
TITLE:
80/20 STRAIGHT BRACKET
J. DERSCH
80/20 INC.
DWG. NO.

PLACES IN DIMENSION

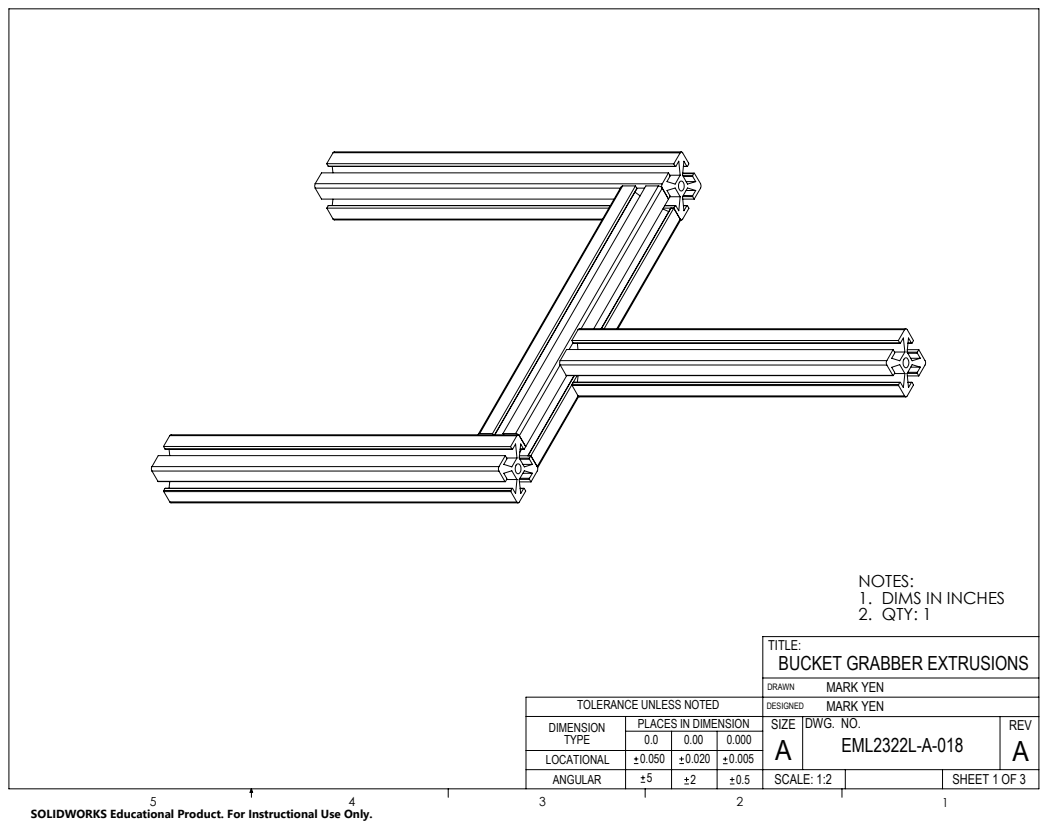
[picture p101: page 22]

NOTES:
DIMS IN INCHES
2. QTY: 1
BUCKET GRABBER EXTRUSIONS
MARK YEN
DWG. NO.
SIZE

TOLERANCE UNLESS NOTED
DIMENSION
TYPE
LOCATIONAL

PLACES IN DIMENSION

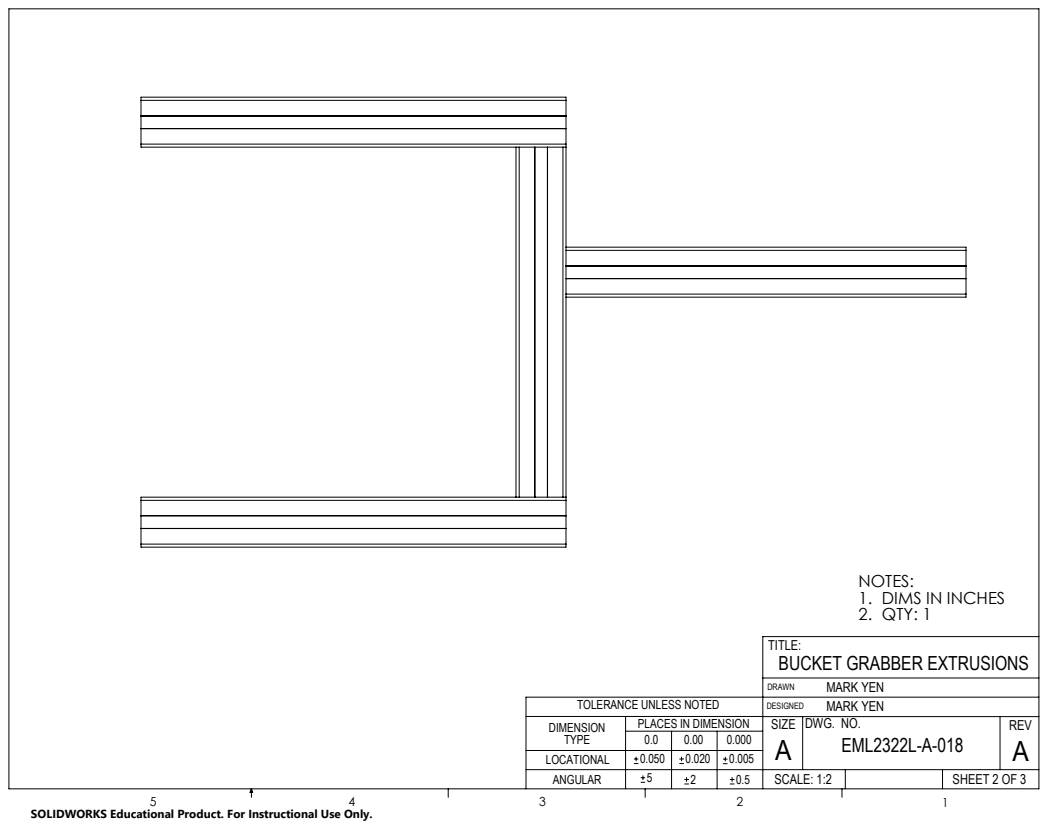
[picture p102: page 23]

NOTES:
DIMS IN INCHES
2. QTY: 1
BUCKET GRABBER EXTRUSIONS
MARK YEN
DWG. NO.
SIZE

TOLERANCE UNLESS NOTED
DIMENSION
TYPE
LOCATIONAL

PLACES IN DIMENSION

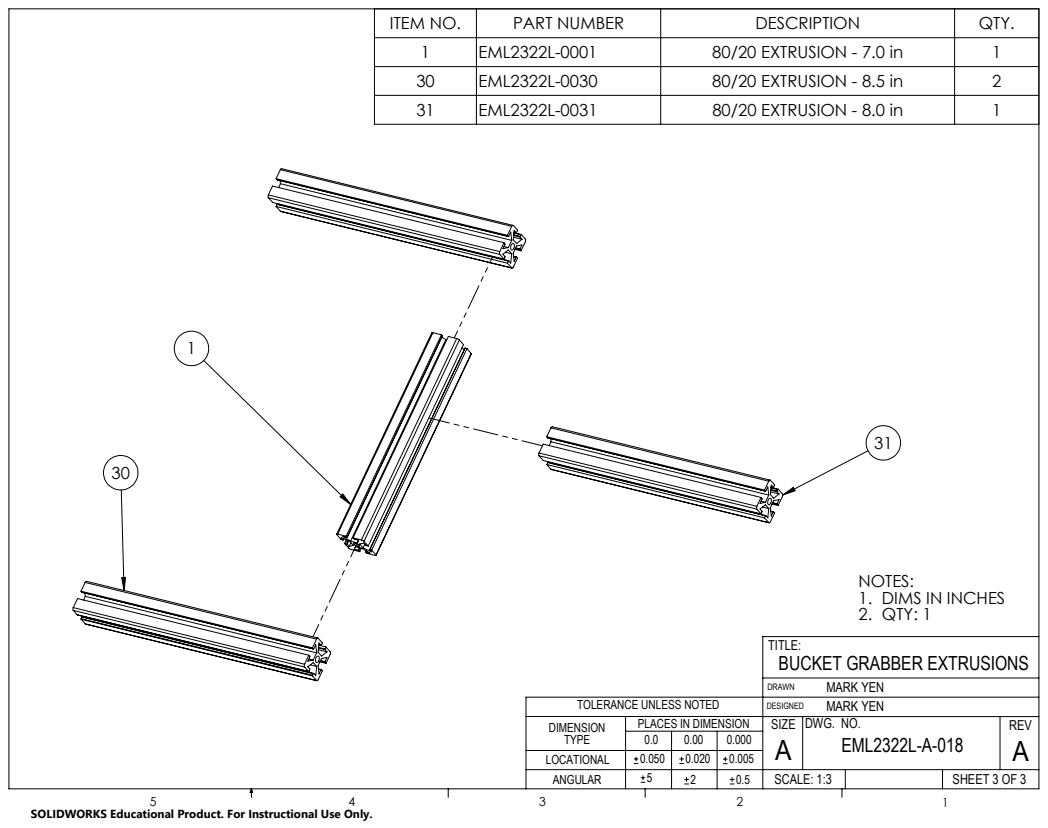
[picture p103: page 24]

ITEM NO. | PART NUMBER | DESCRIPTION | QTY.
1 | EML2322L-0001 | 80/20 EXTRUSION - 7.0 in | 1
30 | EML2322L-0030 | 80/20 EXTRUSION - 8.5 in | 2
31 | EML2322L-0031 | 80/20 EXTRUSION - 8.0 in | 1

NOTES:
DIMS IN INCHES
2. QTY: 1
BUCKET GRABBER EXTRUSIONS
MARK YEN
DWG. NO.
SIZE

TOLERANCE UNLESS NOTED
DIMENSION
TYPE
LOCATIONAL

PLACES IN DIMENSION
