markyen001/DR3-Resubmission/Documents Ready for Print/PRINT 11-20.pdf

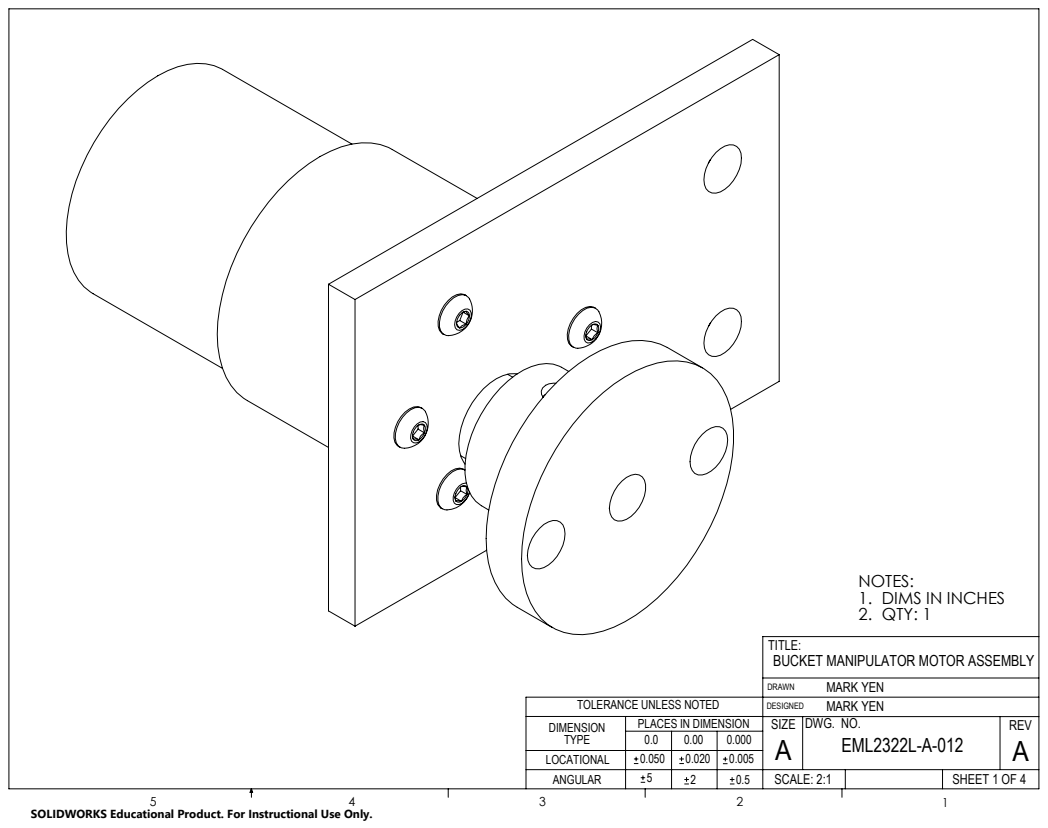
[picture p104: page 1]
SHEET 1 OF 4; TOLERANCE UNLESS NOTED; SCALE: 2:1; DIMS IN INCHES 2. QTY: 1

TITLE:
BUCKET MANIPULATOR MOTOR ASSEMBLY
MARK YEN
DWG. NO.
SIZE

PLACES IN DIMENSION

SOLIDWORKS Educational Product. For Instructional Use Only.

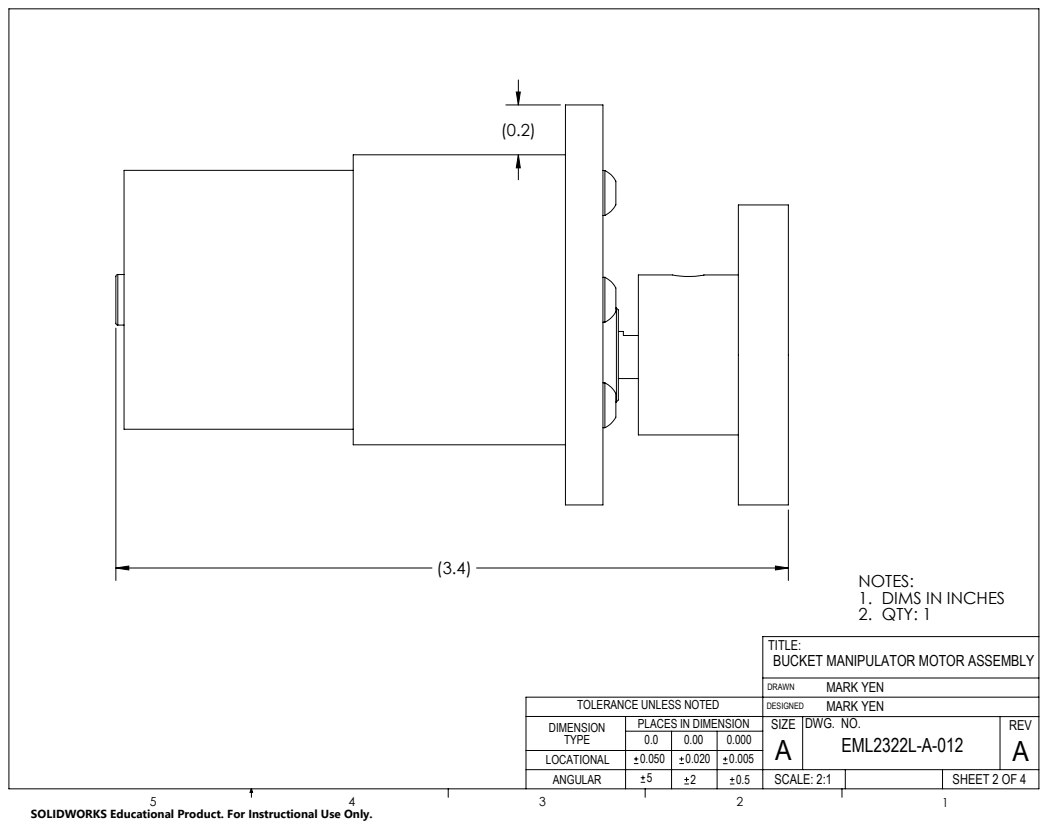
[picture p105: page 2]
SCALE: 2:1; DIMS IN INCHES 2. QTY: 1

TITLE:
BUCKET MANIPULATOR MOTOR ASSEMBLY
MARK YEN
DWG. NO.
SIZE

TOLERANCE UNLESS NOTED
DIMENSION
TYPE
LOCATIONAL

PLACES IN DIMENSION

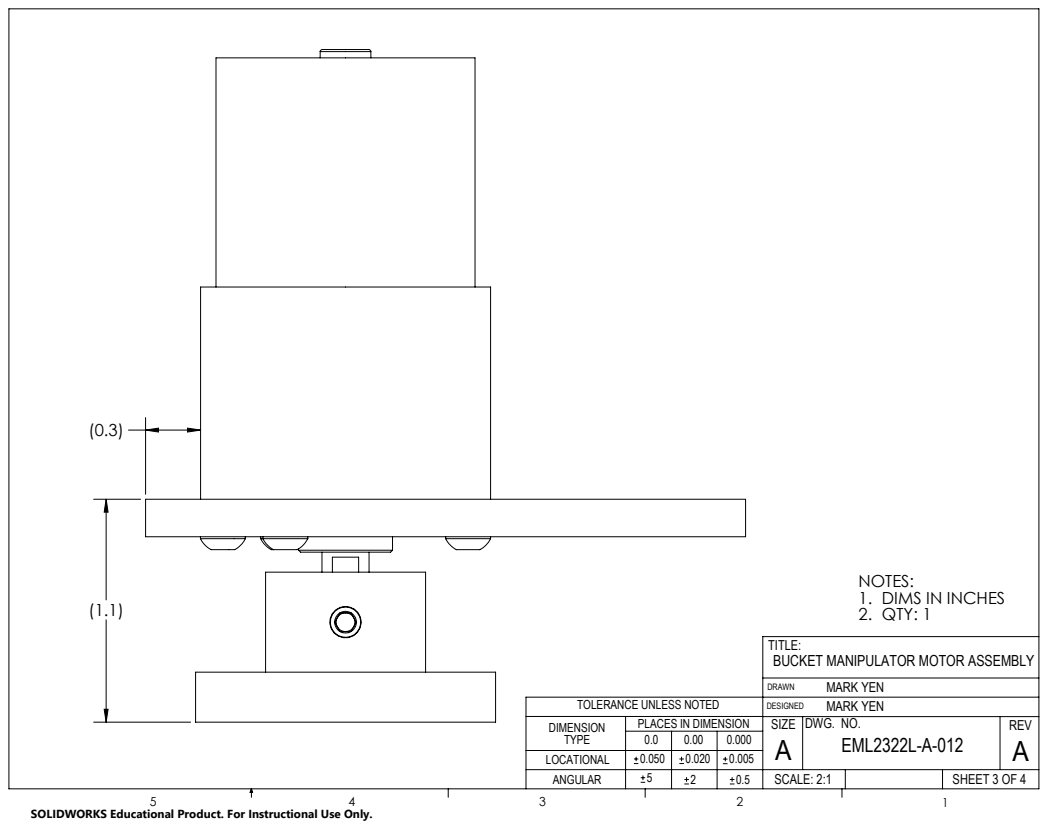
[picture p106: page 3]
SCALE: 2:1; DIMS IN INCHES 2. QTY: 1

TITLE:
BUCKET MANIPULATOR MOTOR ASSEMBLY
MARK YEN
DWG. NO.
SIZE

TOLERANCE UNLESS NOTED
DIMENSION
TYPE
LOCATIONAL

PLACES IN DIMENSION

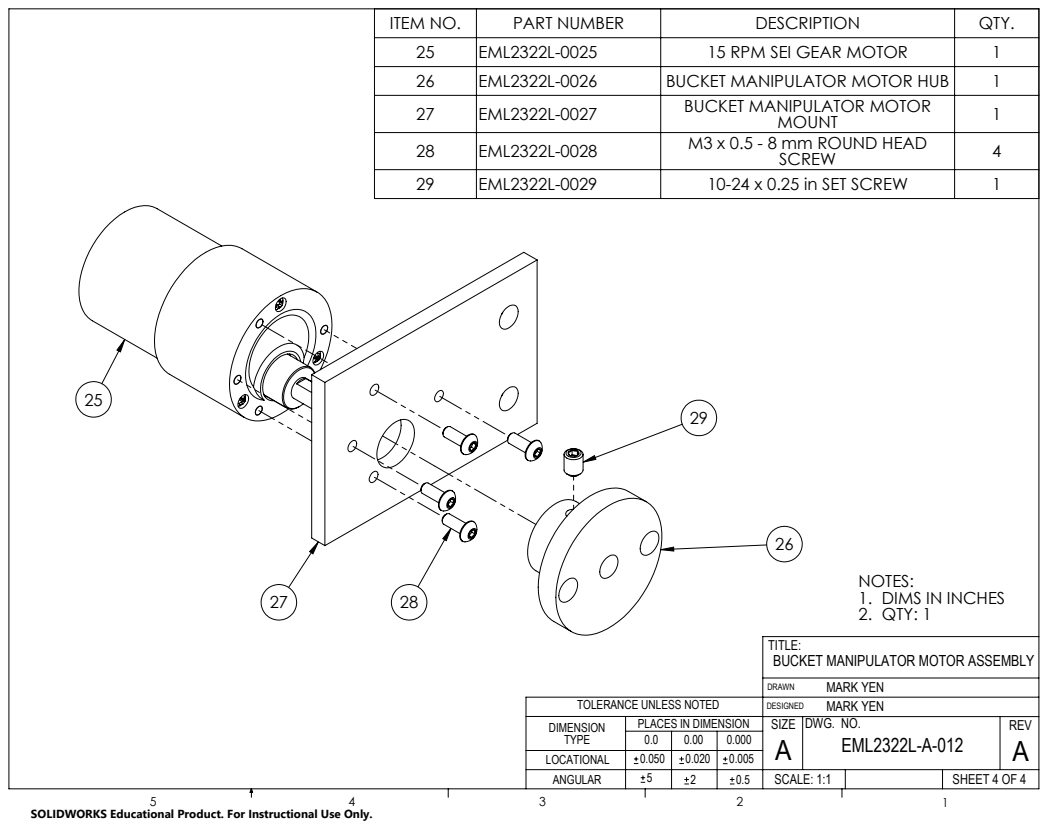
[picture p107: page 4]
SCALE: 1:1; DIMS IN INCHES 2. QTY: 1

ITEM NO. | PART NUMBER | DESCRIPTION | QTY.
25 | EML2322L-0025 | 15 RPM SEI GEAR MOTOR | 1
26 | EML2322L-0026 | BUCKET MANIPULATOR MOTOR HUB | 1
27 | EML2322L-0027 | BUCKET MANIPULATOR MOTOR MOUNT | 1
28 | EML2322L-0028 | M3 x 0.5 - 8 mm ROUND HEAD SCREW | 4
29 | EML2322L-0029 | 10-24 x 0.25 in SET SCREW | 1

TITLE:
BUCKET MANIPULATOR MOTOR ASSEMBLY
MARK YEN
DWG. NO.
SIZE

TOLERANCE UNLESS NOTED
DIMENSION
TYPE
LOCATIONAL

PLACES IN DIMENSION

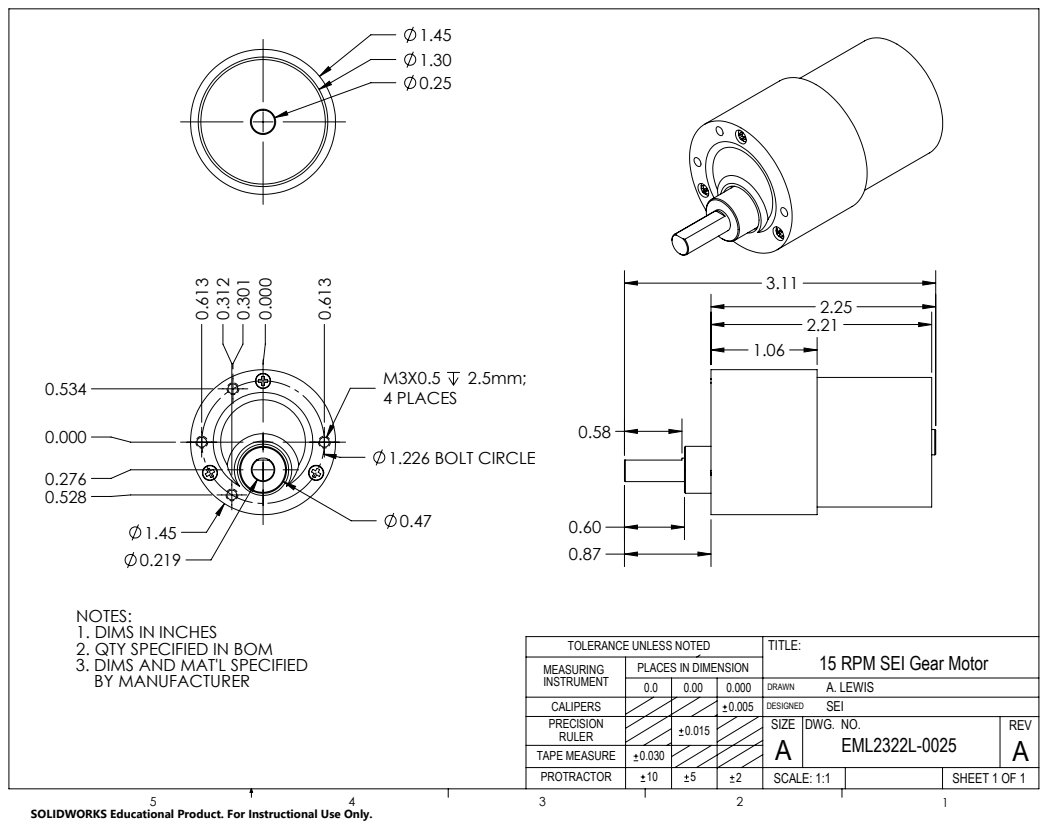
[picture p108: page 5]
M3X0.5 2.5mm; 4 PLACES; 1.226 BOLT CIRCLE; SHEET 1 OF 1; TAPE MEASURE; TOLERANCE UNLESS NOTED; SCALE: 1:1

NOTES:
1. DIMS IN
2. QTY SPECIFIED IN BOM
3. DIMS AND MAT'L SPECIFIED
BY MANUFACTURER

TITLE:
15 RPM SEI Gear Motor
A. LEWIS
SEI
DWG. NO.

PLACES IN DIMENSION

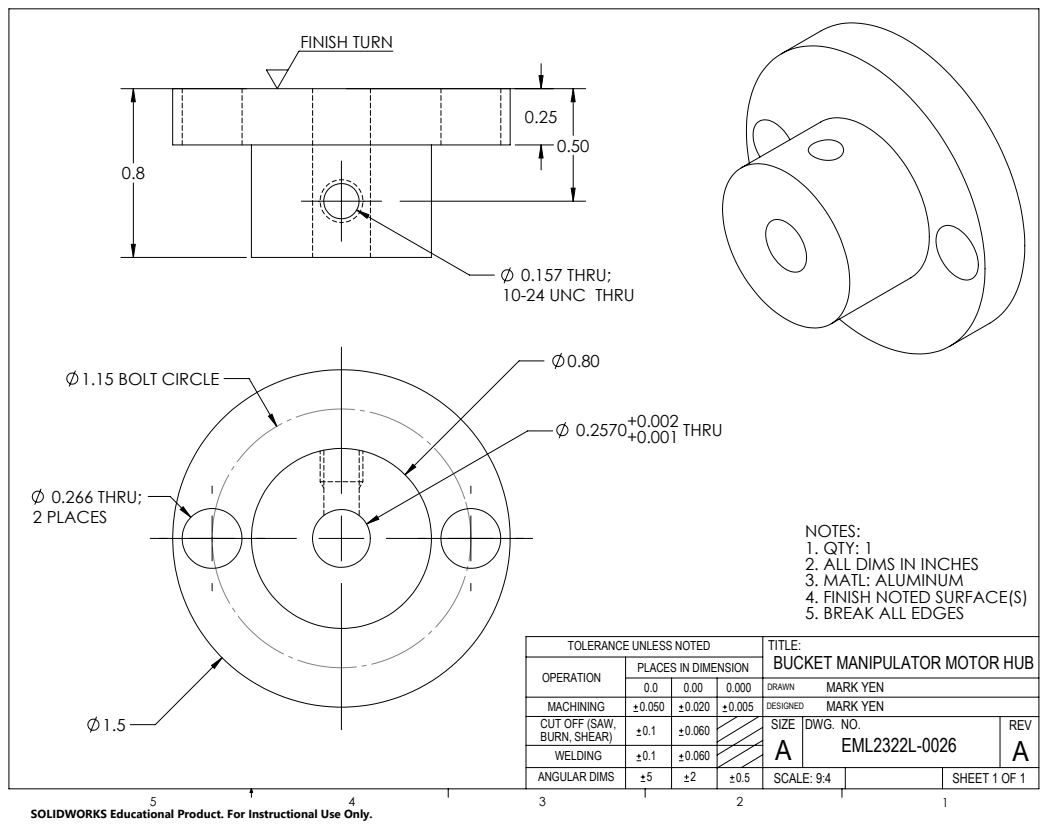
[picture p109: page 6]
0.001 THRU; 0.266 THRU; 2 PLACES; 1.15 BOLT CIRCLE; 0.157 THRU; 10-24 UNC THRU; FINISH TURN; SCALE: 9:4

NOTES:
1. QTY: 1
2. ALL DIMS IN INCHES
3. MATL: ALUMINUM
4. FINISH NOTED SURFACE(S)
5. BREAK ALL EDGES
TITLE:
BUCKET MANIPULATOR MOTOR HUB
MARK YEN
DWG. NO.

TOLERANCE UNLESS NOTED
OPERATION
MACHINING
CUT OFF (SAW,
BURN, SHEAR)
WELDING
ANGULAR DIMS

PLACES IN DIMENSION

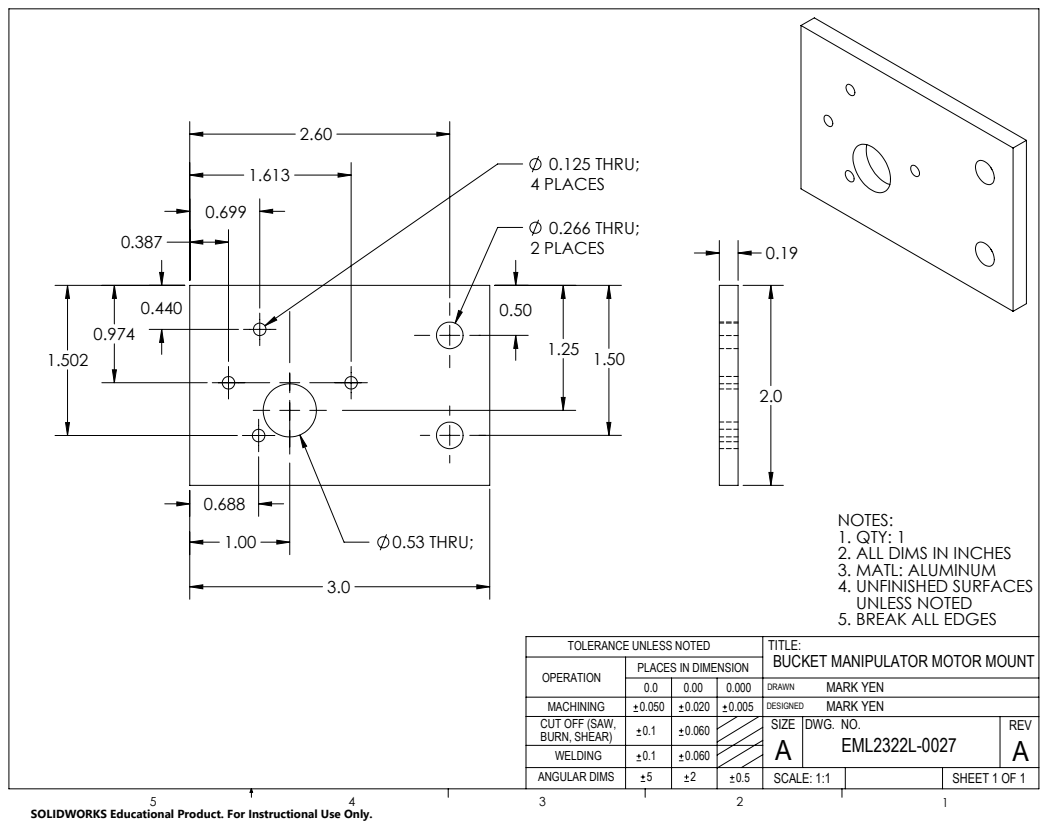
[picture p110: page 7]
0.125 THRU; 4 PLACES; 0.266 THRU; 2 PLACES; 0.53 THRU;; SCALE: 1:1

NOTES:
1. QTY: 1
2. ALL DIMS IN INCHES
3. MATL: ALUMINUM
4. UNFINISHED SURFACES
UNLESS NOTED
5. BREAK ALL EDGES
BUCKET MANIPULATOR MOTOR MOUNT
MARK YEN
DWG. NO.

TOLERANCE UNLESS NOTED
OPERATION
MACHINING
CUT OFF (SAW,
BURN, SHEAR)
WELDING

PLACES IN DIMENSION

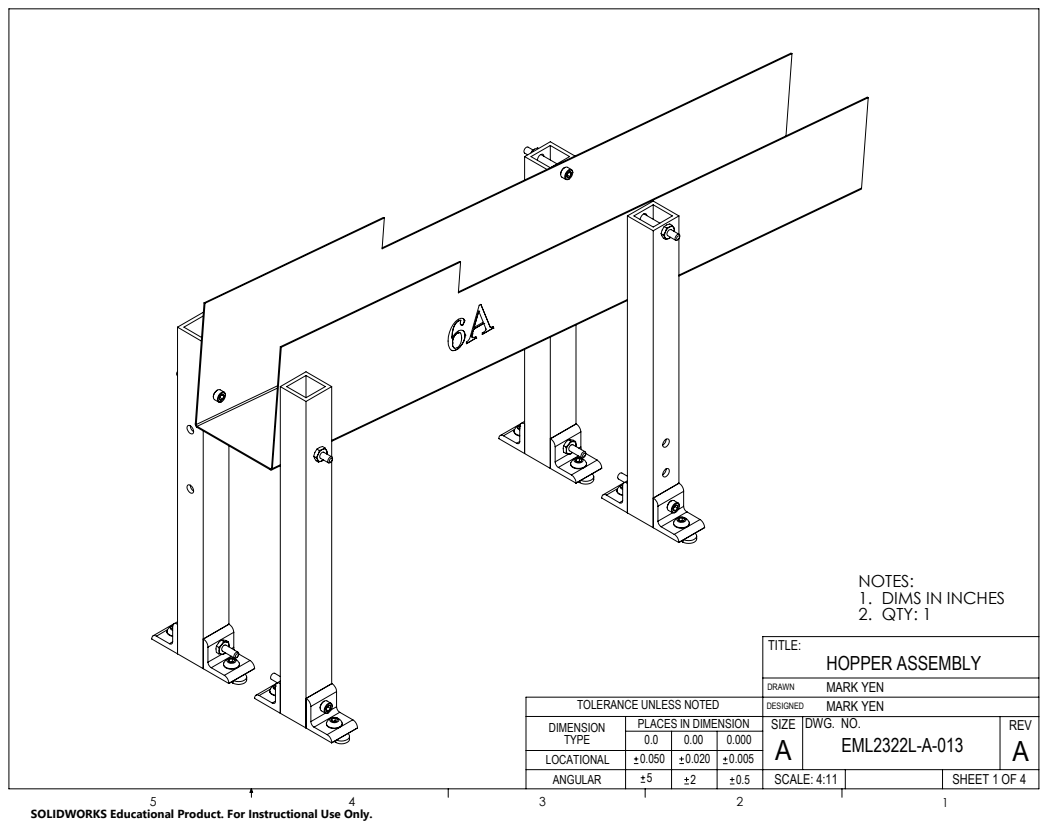
[picture p111: page 8]
SCALE: 4:11

NOTES:
DIMS IN INCHES
2. QTY: 1
HOPPER ASSEMBLY
MARK YEN
DWG. NO.
SIZE

TOLERANCE UNLESS NOTED
DIMENSION
TYPE
LOCATIONAL

PLACES IN DIMENSION

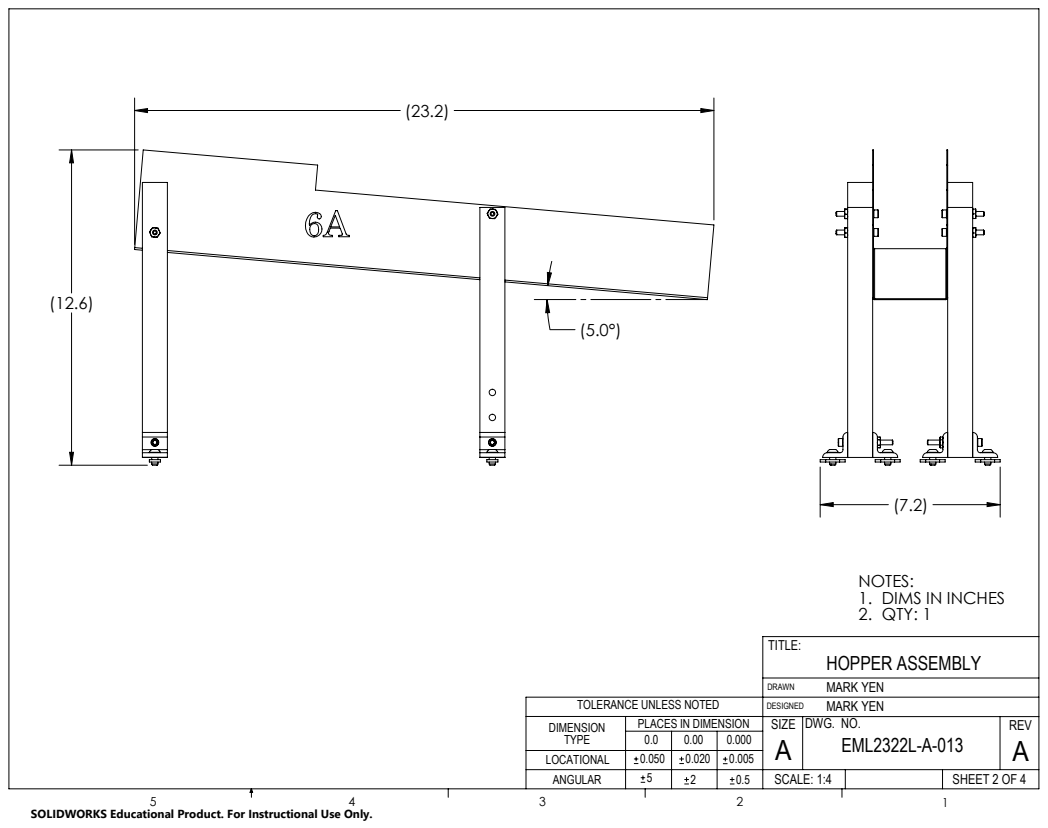
[picture p112: page 9]
SCALE: 1:4

NOTES:
DIMS IN INCHES
2. QTY: 1
HOPPER ASSEMBLY
MARK YEN
DWG. NO.
SIZE

TOLERANCE UNLESS NOTED
DIMENSION
TYPE
LOCATIONAL

PLACES IN DIMENSION

ITEM NO. | PART NUMBER | DESCRIPTION | QTY.
18 | EML2322L-0018 | BALL HOPPER - FOLDED | 1
19 | EML2322L-0019 | 11 in AL TUBING WITH HOLES FOR MOTOR | 1
20 | EML2322L-0020 | 10-24 x 2 in SOCKET HEAD SCREW | 4
21 | EML2322L-0021 | 10 in AL TUBING WITH HOLES FOR MOTOR | 1
22 | EML2322L-0022 | 10 in AL TUBING WITH NO HOLES | 1
23 | EML2322L-0023 | 11 in AL TUBING WITH NO HOLES | 1
24 | EML2322L-0024 | 10-24 x 1.5 in SOCKET HEAD SCREW | 4
53 | EML2322L-0053 | 10-24 HEX NUT | 8
A10 | EML2322L-A-010 | 90-DEGREE BRACKET ASSEMBLY | 8

### HOPPER ASSEMBLY

DWG. NO.

TITLE:

REV
A

SIZE

### A EML2322L-A-013

DRAWN
DESIGNED

MARK YEN
MARK YEN
0.0 | 0.00 | 0.000
0.050 0.020 0.005
LOCATIONAL

TOLERANCE UNLESS NOTED
DIMENSION
TYPE
5 | 2 | SCALE: 1:8

PLACES IN DIMENSION

DIMS IN INCHES

NOTES:
1.
2. QTY: 1

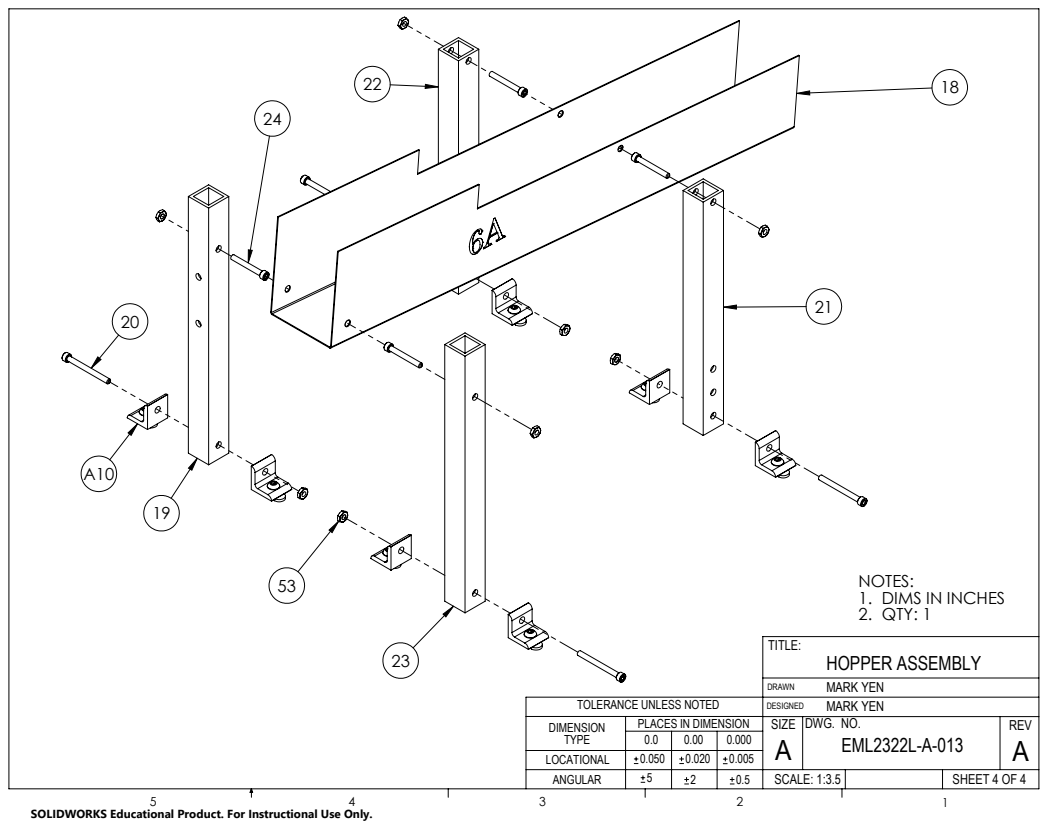
[picture p113: page 11]
SCALE: 1:3.5

NOTES:
DIMS IN INCHES
2. QTY: 1
HOPPER ASSEMBLY
MARK YEN
DWG. NO.
SIZE

TOLERANCE UNLESS NOTED
DIMENSION
TYPE
LOCATIONAL

PLACES IN DIMENSION

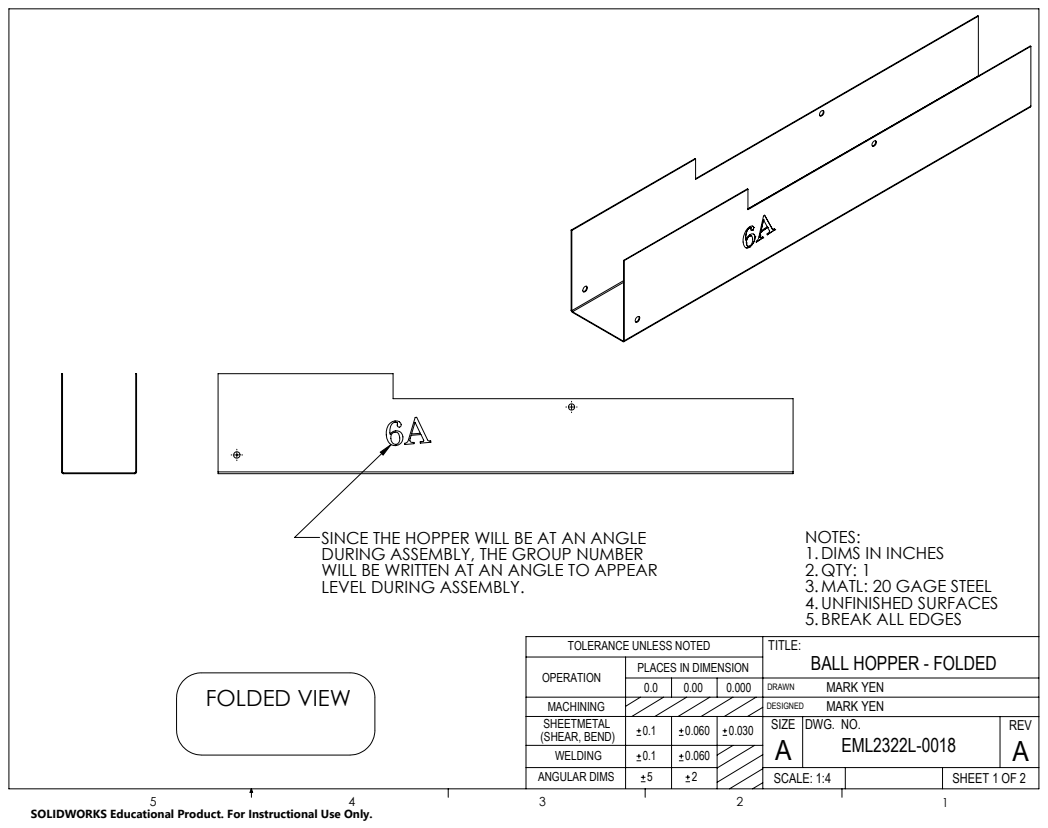
[picture p114: page 12]
BALL HOPPER - FOLDED; SHEET 1 OF 2; DWG. NO.; MARK YEN MARK YEN; SCALE: 1:4; FOLDED VIEW; DIMS IN INCHES MATL: 20 GAGE STEEL UNFINISHED SURFACES; QTY: 1

SINCE THE HOPPER WILL BE AT AN ANGLE
DURING ASSEMBLY, THE GROUP NUMBER
WILL BE WRITTEN AT AN ANGLE TO APPEAR
LEVEL DURING ASSEMBLY.

BREAK ALL EDGES

TOLERANCE UNLESS NOTED
OPERATION
MACHINING
SHEETMETAL
(SHEAR, BEND)
WELDING

PLACES IN DIMENSION

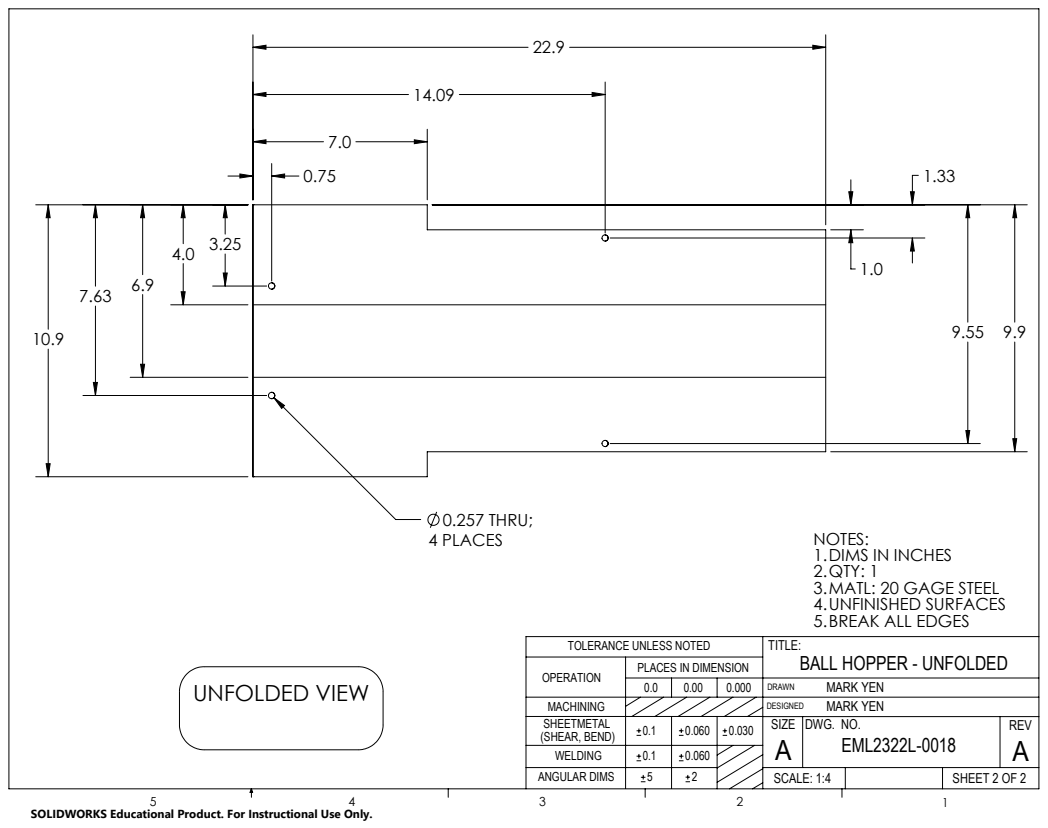
[picture p115: page 13]
0.257 THRU; 4 PLACES; SHEET 2 OF 2; SCALE: 1:4; UNFOLDED VIEW

NOTES:
DIMS IN INCHES
QTY: 1
MATL: 20 GAGE STEEL
UNFINISHED SURFACES
BREAK ALL EDGES
BALL HOPPER - UNFOLDED
MARK YEN
SIZE
DWG. NO.

TOLERANCE UNLESS NOTED
OPERATION
MACHINING
SHEETMETAL
(SHEAR, BEND)
WELDING

PLACES IN DIMENSION

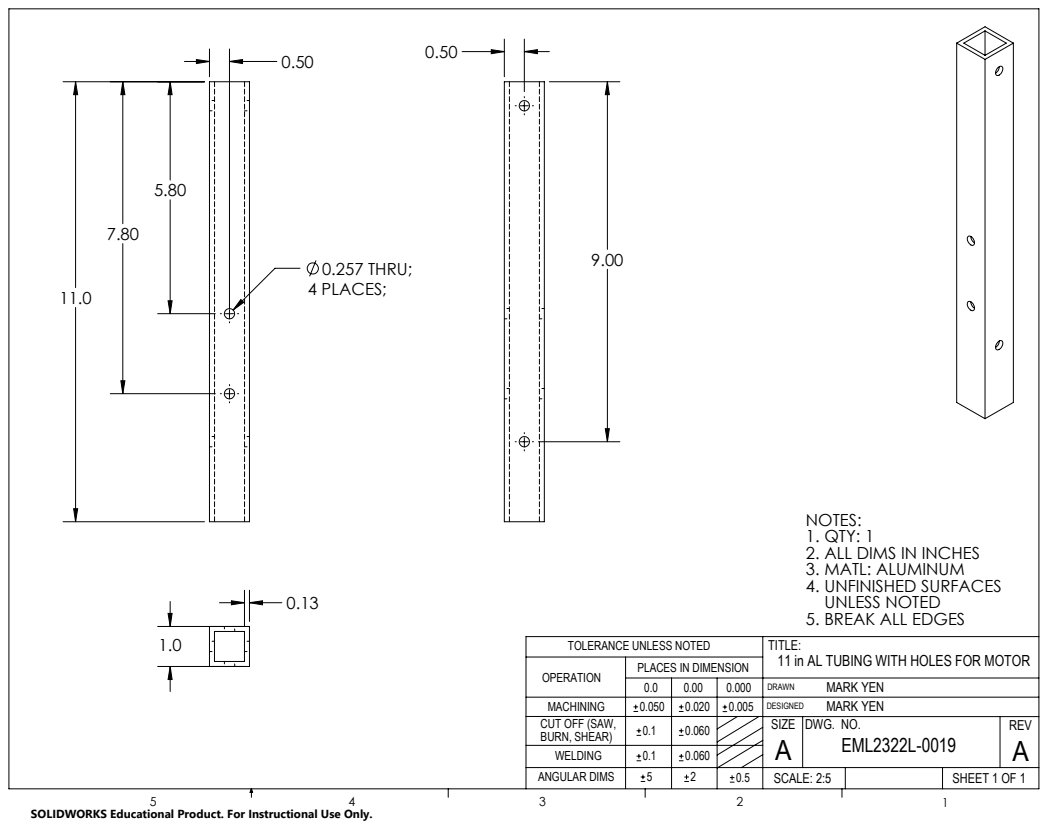
[picture p116: page 14]
0.257 THRU; 4 PLACES;; SCALE: 2:5

NOTES:
1. QTY: 1
2. ALL DIMS IN INCHES
3. MATL: ALUMINUM
4. UNFINISHED SURFACES
UNLESS NOTED
5. BREAK ALL EDGES
TITLE:
11 in AL TUBING WITH HOLES FOR MOTOR
MARK YEN
DWG. NO.

TOLERANCE UNLESS NOTED
OPERATION
MACHINING
CUT OFF (SAW,
BURN, SHEAR)
WELDING

PLACES IN DIMENSION

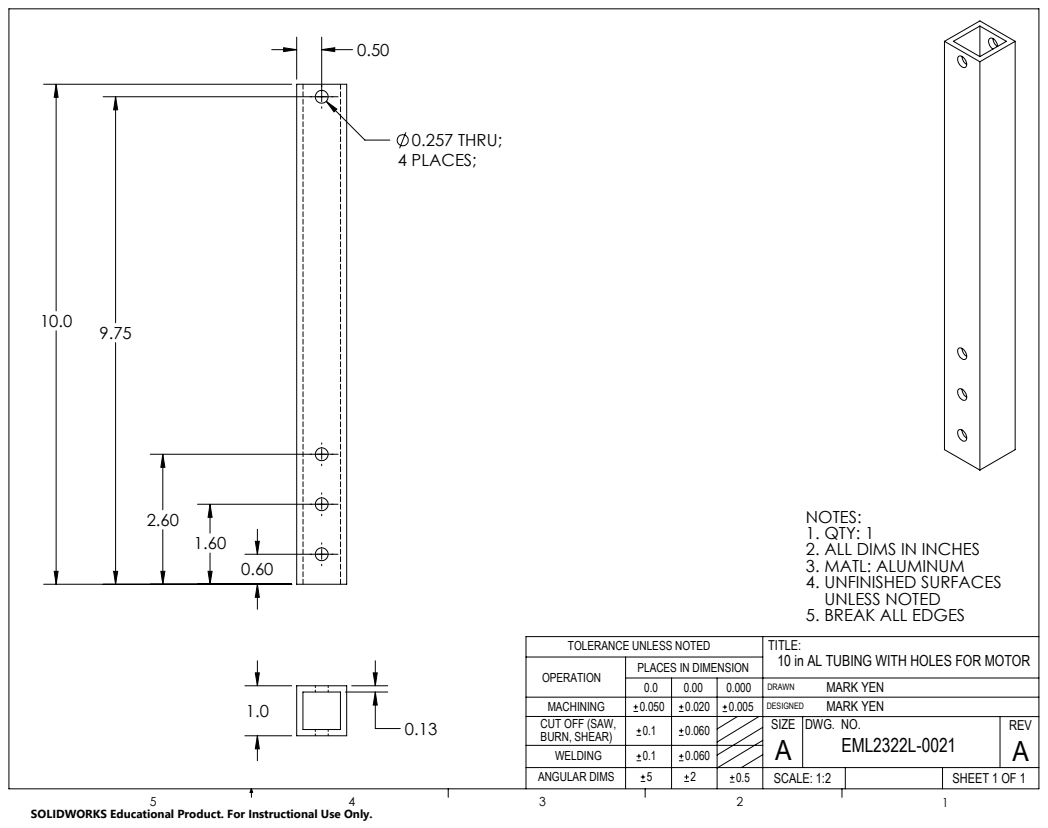
[picture p117: page 15]
0.257 THRU; 4 PLACES;; SCALE: 1:2

NOTES:
1. QTY: 1
2. ALL DIMS IN INCHES
3. MATL: ALUMINUM
4. UNFINISHED SURFACES
UNLESS NOTED
5. BREAK ALL EDGES
TITLE:
10 in AL TUBING WITH HOLES FOR MOTOR
MARK YEN
DWG. NO.

TOLERANCE UNLESS NOTED
OPERATION
MACHINING
CUT OFF (SAW,
BURN, SHEAR)
WELDING

PLACES IN DIMENSION

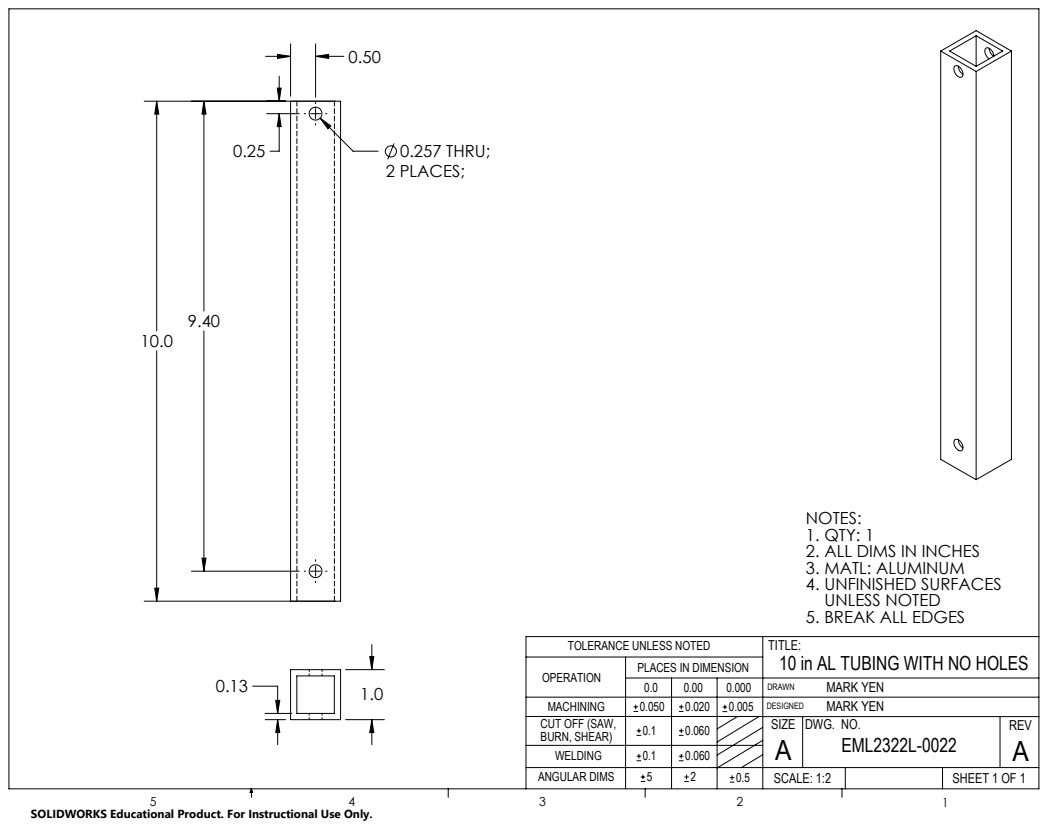
[picture p118: page 16]
0.257 THRU; 2 PLACES;; SCALE: 1:2

NOTES:
1. QTY: 1
2. ALL DIMS IN INCHES
3. MATL: ALUMINUM
4. UNFINISHED SURFACES
UNLESS NOTED
5. BREAK ALL EDGES
TITLE:
10 in AL TUBING WITH NO HOLES
MARK YEN
DWG. NO.

TOLERANCE UNLESS NOTED
OPERATION
MACHINING
CUT OFF (SAW,
BURN, SHEAR)
WELDING

PLACES IN DIMENSION

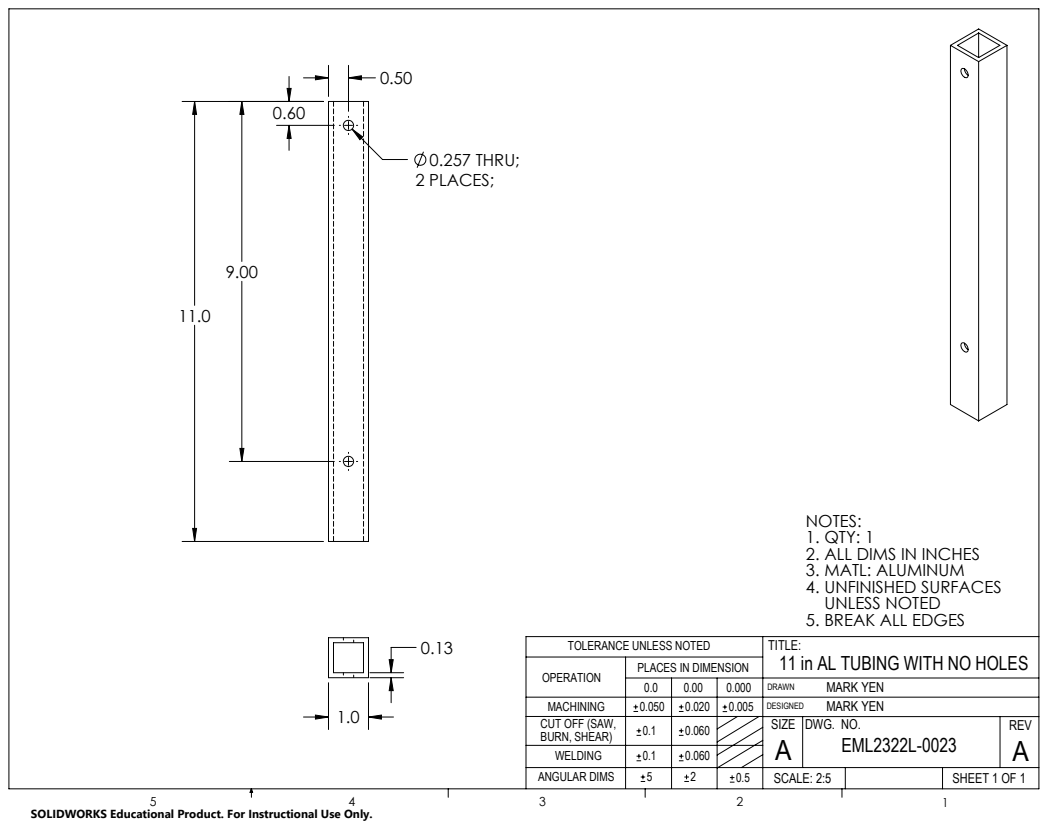
[picture p119: page 17]
0.257 THRU; 2 PLACES;; SCALE: 2:5

NOTES:
1. QTY: 1
2. ALL DIMS IN INCHES
3. MATL: ALUMINUM
4. UNFINISHED SURFACES
UNLESS NOTED
5. BREAK ALL EDGES
TITLE:
11 in AL TUBING WITH NO HOLES
MARK YEN
DWG. NO.

TOLERANCE UNLESS NOTED
OPERATION
MACHINING
CUT OFF (SAW,
BURN, SHEAR)
WELDING

PLACES IN DIMENSION
