markyen001/DR3-Resubmission/Documents Ready for Print/PRINT 21-31.pdf

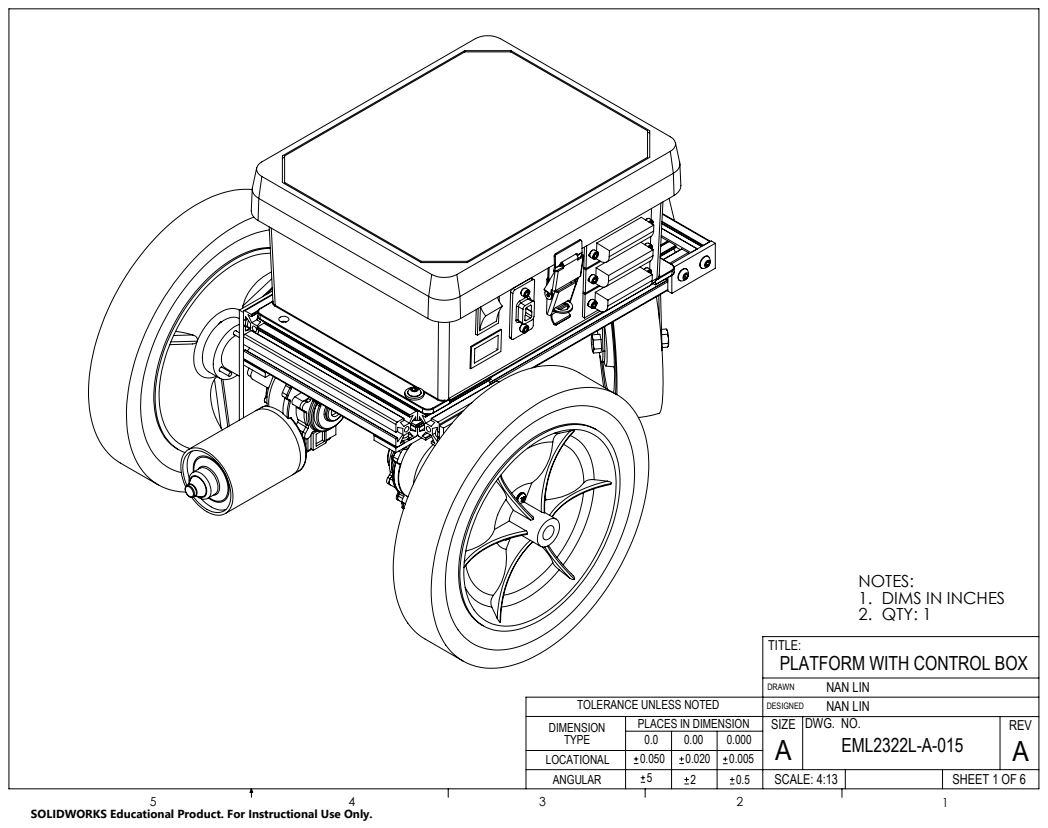
[picture p120: page 1]
SHEET 1 OF 6; TOLERANCE UNLESS NOTED; SCALE: 4:13

NOTES:
DIMS IN INCHES
2. QTY: 1
PLATFORM WITH CONTROL BOX
NAN LIN
DWG. NO.
SIZE

PLACES IN DIMENSION

SOLIDWORKS Educational Product. For Instructional Use Only.

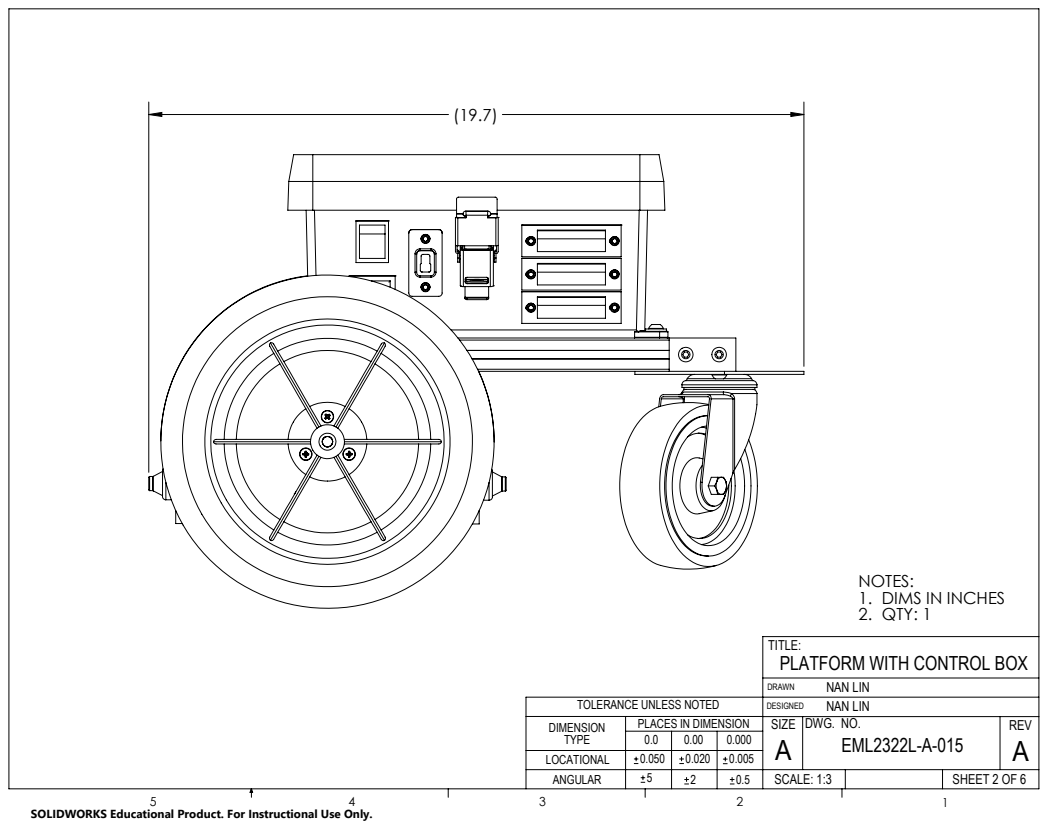
[picture p121: page 2]
SCALE: 1:3

NOTES:
DIMS IN INCHES
2. QTY: 1
PLATFORM WITH CONTROL BOX
NAN LIN
DWG. NO.
SIZE

TOLERANCE UNLESS NOTED
DIMENSION
TYPE
LOCATIONAL

PLACES IN DIMENSION

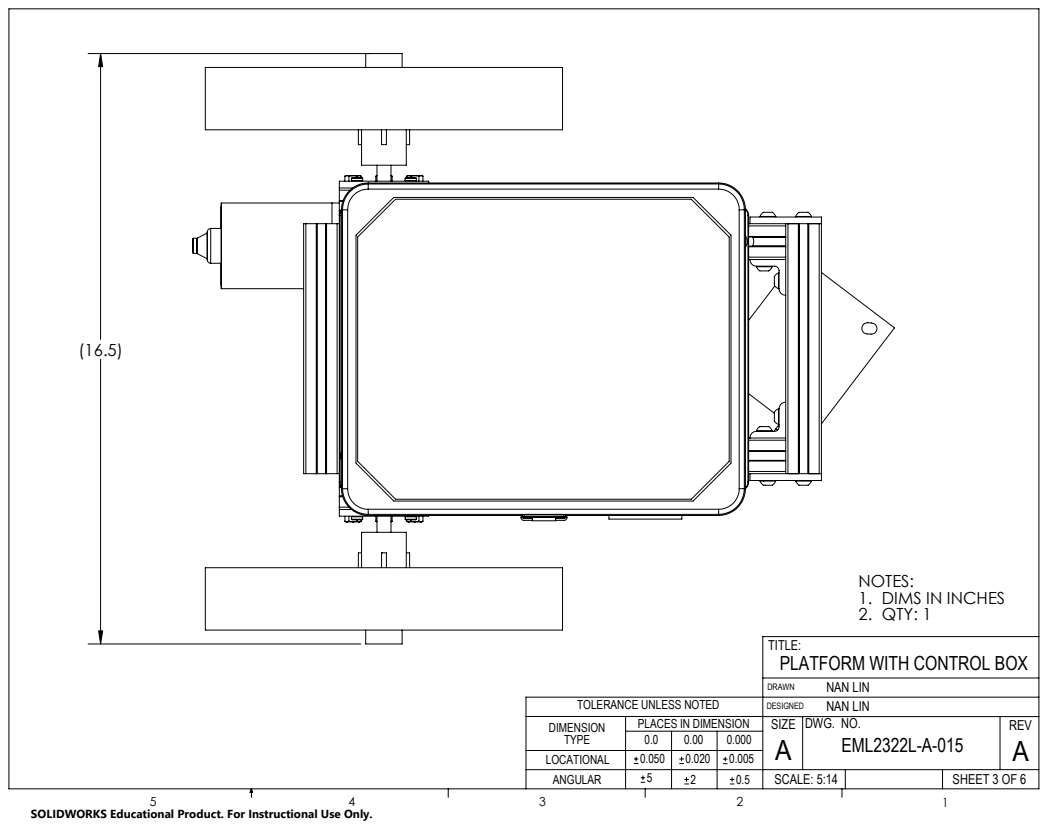
[picture p122: page 3]
SCALE: 5:14

NOTES:
DIMS IN INCHES
2. QTY: 1
PLATFORM WITH CONTROL BOX
NAN LIN
DWG. NO.
SIZE

TOLERANCE UNLESS NOTED
DIMENSION
TYPE
LOCATIONAL

PLACES IN DIMENSION

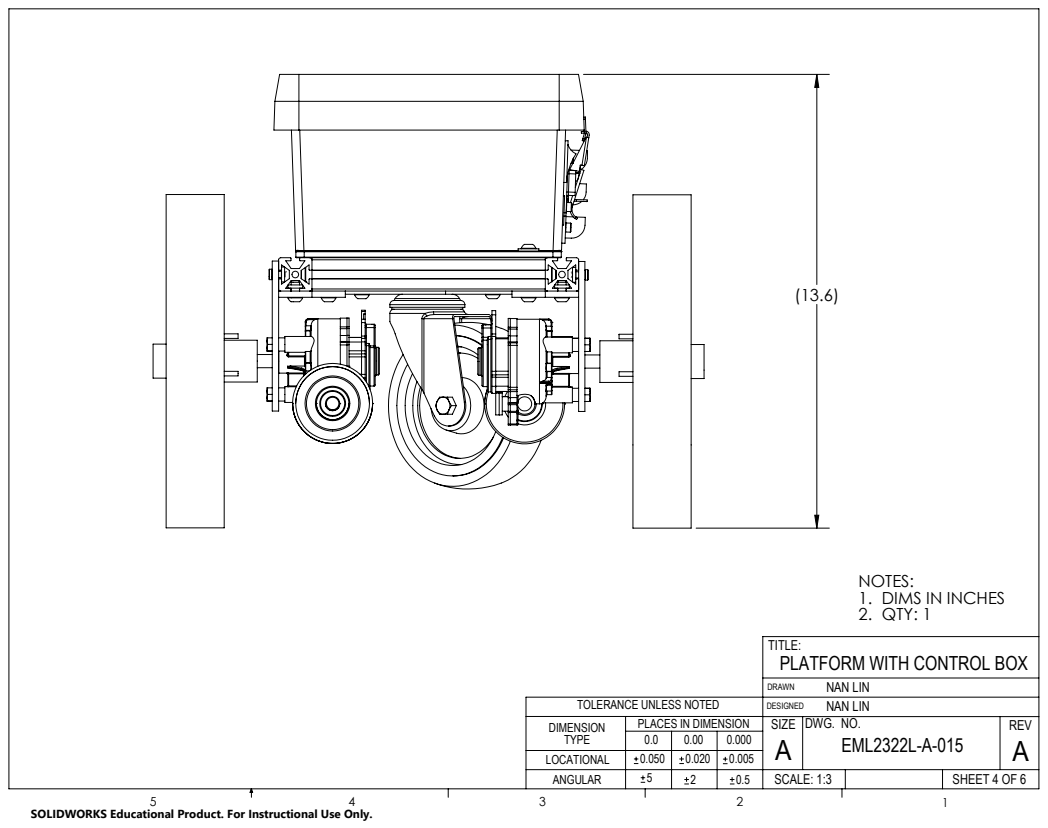
[picture p123: page 4]
SCALE: 1:3

NOTES:
DIMS IN INCHES
2. QTY: 1
PLATFORM WITH CONTROL BOX
NAN LIN
DWG. NO.
SIZE

TOLERANCE UNLESS NOTED
DIMENSION
TYPE
LOCATIONAL

PLACES IN DIMENSION

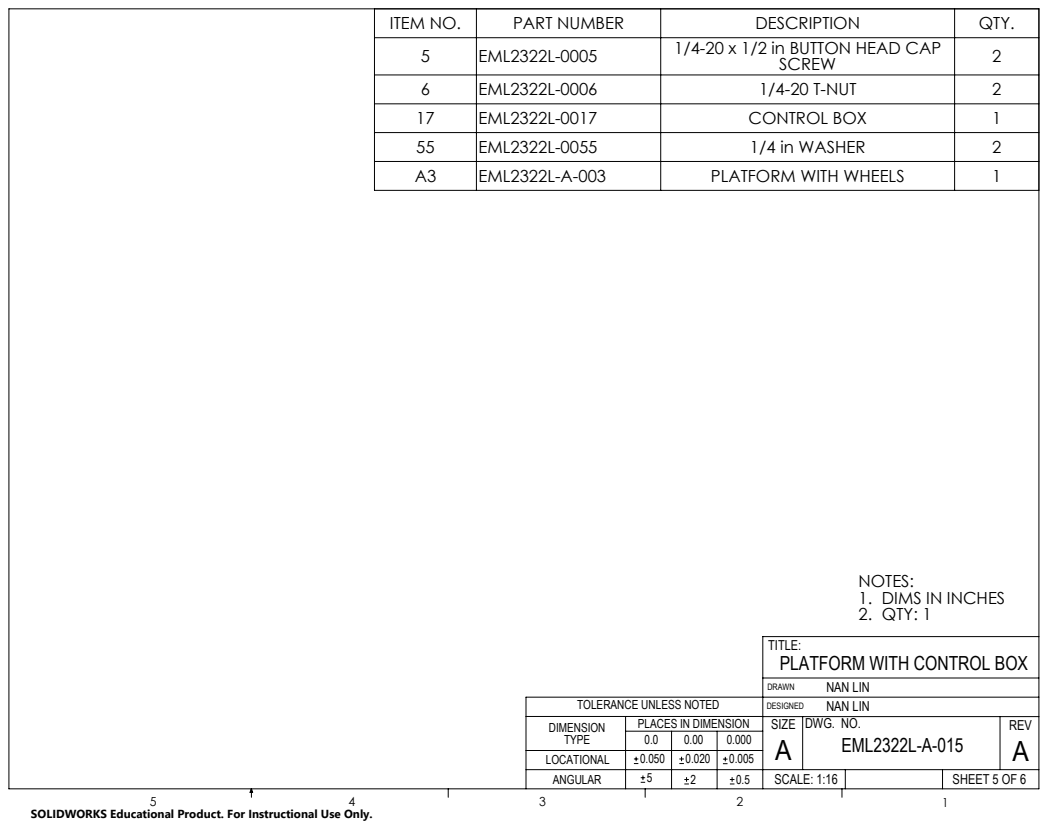
[picture p124: page 5]
SCALE: 1:16

ITEM NO. | PART NUMBER | DESCRIPTION | QTY.
5 | EML2322L-0005 | 1/4-20 x 1/2 in BUTTON HEAD CAP SCREW | 2
6 | EML2322L-0006 | 1/4-20 T-NUT | 2
17 | EML2322L-0017 | CONTROL BOX | 1
55 | EML2322L-0055 | 1/4 in WASHER | 2
A3 | EML2322L-A-003 | PLATFORM WITH WHEELS | 1

NOTES:
DIMS IN INCHES
2. QTY: 1
PLATFORM WITH CONTROL BOX
NAN LIN
DWG. NO.
SIZE

TOLERANCE UNLESS NOTED
DIMENSION
TYPE
LOCATIONAL

PLACES IN DIMENSION

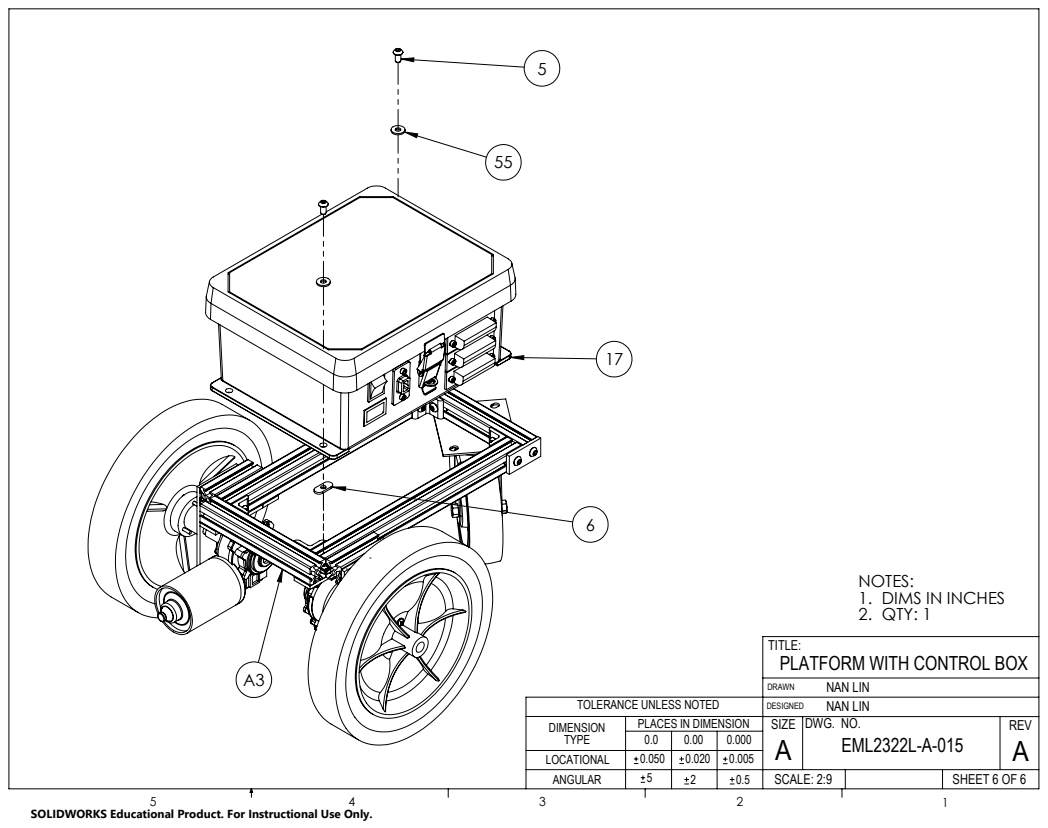
[picture p125: page 6]
SCALE: 2:9

NOTES:
DIMS IN INCHES
2. QTY: 1
PLATFORM WITH CONTROL BOX
NAN LIN
DWG. NO.
SIZE

TOLERANCE UNLESS NOTED
DIMENSION
TYPE
LOCATIONAL

PLACES IN DIMENSION

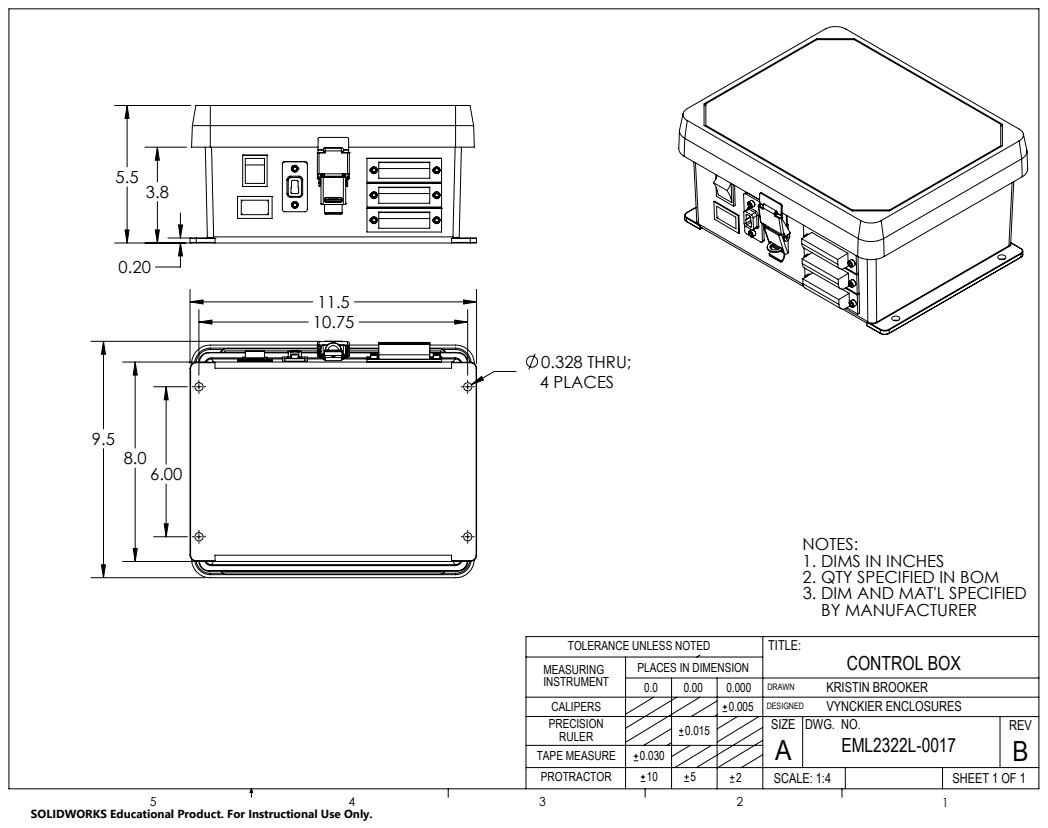
[picture p126: page 7]
0.328 THRU; 4 PLACES; SHEET 1 OF 1; TAPE MEASURE; TOLERANCE UNLESS NOTED; SCALE: 1:4

NOTES:
DIMS IN INCHES
QTY SPECIFIED IN BOM
3. DIM AND MAT'L SPECIFIED
BY MANUFACTURER
CONTROL BOX
KRISTIN BROOKER
VYNCKIER ENCLOSURES
DWG. NO.

PLACES IN DIMENSION

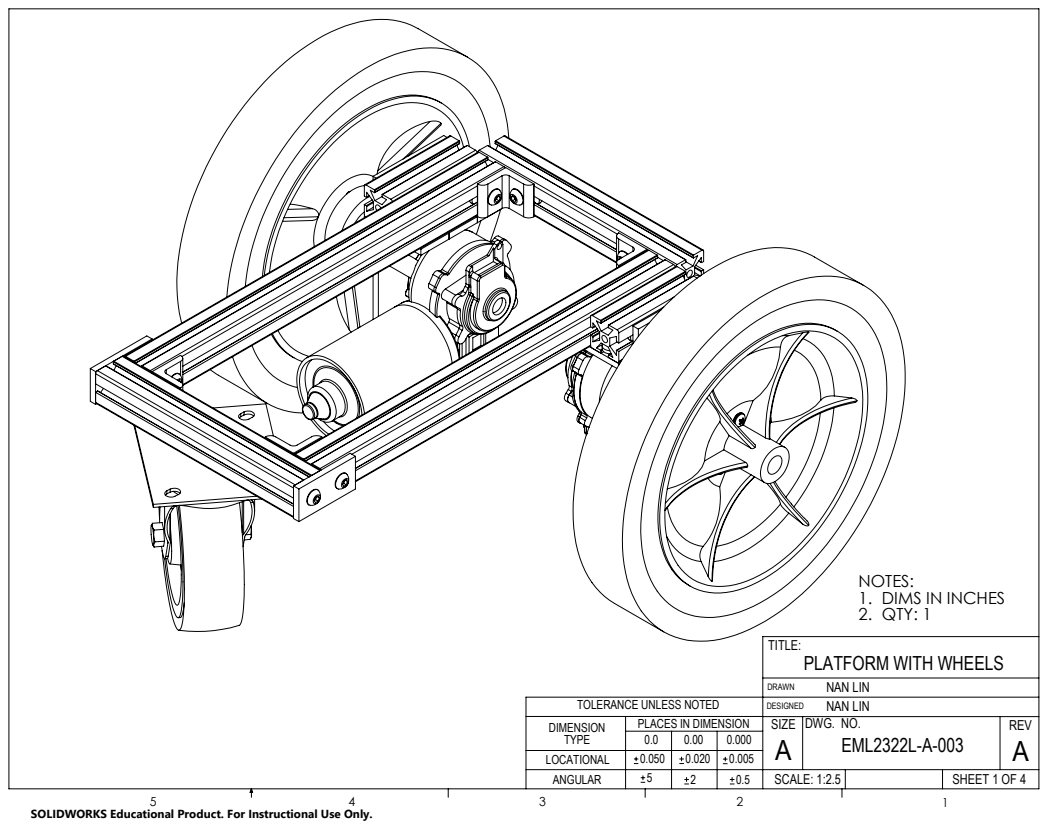
[picture p127: page 8]
SCALE: 1:2.5

NOTES:
DIMS IN INCHES
2. QTY: 1
PLATFORM WITH WHEELS
NAN LIN
DWG. NO.
SIZE

TOLERANCE UNLESS NOTED
DIMENSION
TYPE
LOCATIONAL

PLACES IN DIMENSION

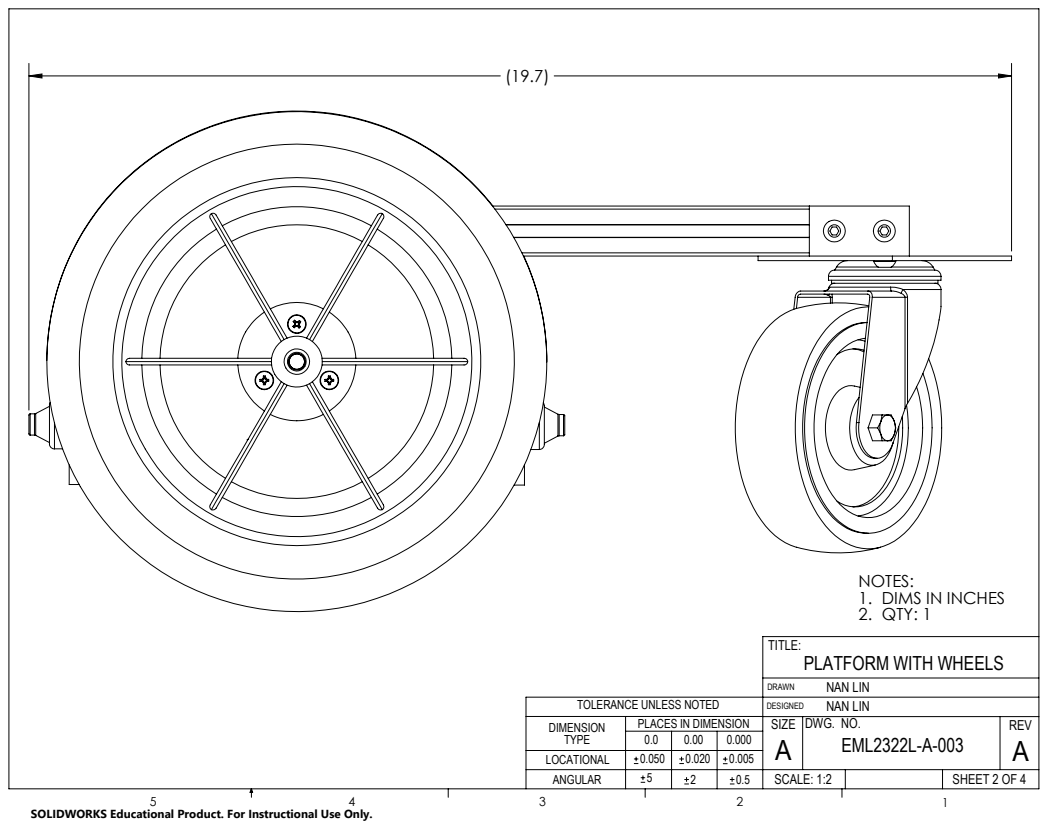
[picture p128: page 9]
SCALE: 1:2

NOTES:
DIMS IN INCHES
2. QTY: 1
PLATFORM WITH WHEELS
NAN LIN
DWG. NO.
SIZE

TOLERANCE UNLESS NOTED
DIMENSION
TYPE
LOCATIONAL

PLACES IN DIMENSION

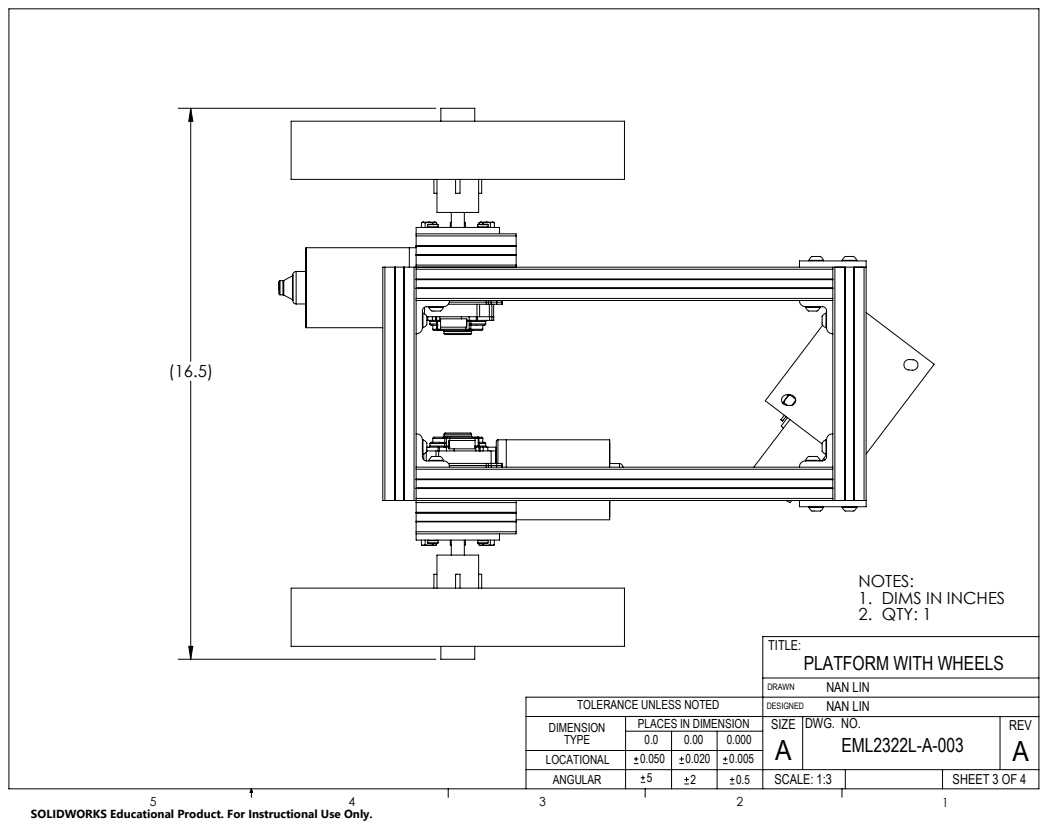
[picture p129: page 10]
SCALE: 1:3

NOTES:
DIMS IN INCHES
2. QTY: 1
PLATFORM WITH WHEELS
NAN LIN
DWG. NO.
SIZE

TOLERANCE UNLESS NOTED
DIMENSION
TYPE
LOCATIONAL

PLACES IN DIMENSION

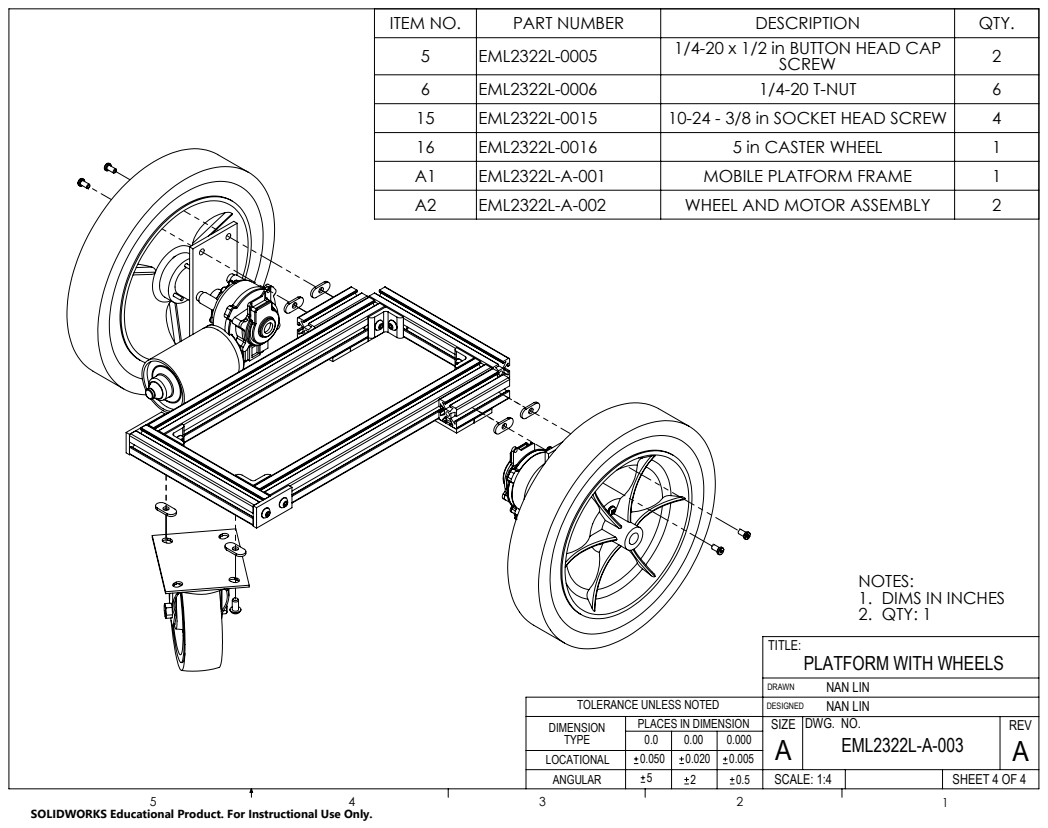
[picture p130: page 11]
SCALE: 1:4

ITEM NO. | PART NUMBER | DESCRIPTION | QTY.
5 | EML2322L-0005 | 1/4-20 x 1/2 in BUTTON HEAD CAP SCREW | 2
6 | EML2322L-0006 | 1/4-20 T-NUT | 6
15 | EML2322L-0015 | 10-24 - 3/8 in SOCKET HEAD SCREW | 4
16 | EML2322L-0016 | 5 in CASTER WHEEL | 1
A1 | EML2322L-A-001 | MOBILE PLATFORM FRAME | 1
A2 | EML2322L-A-002 | WHEEL AND MOTOR ASSEMBLY | 2

NOTES:
DIMS IN INCHES
2. QTY: 1
PLATFORM WITH WHEELS
NAN LIN
DWG. NO.
SIZE

TOLERANCE UNLESS NOTED
DIMENSION
TYPE
LOCATIONAL

PLACES IN DIMENSION

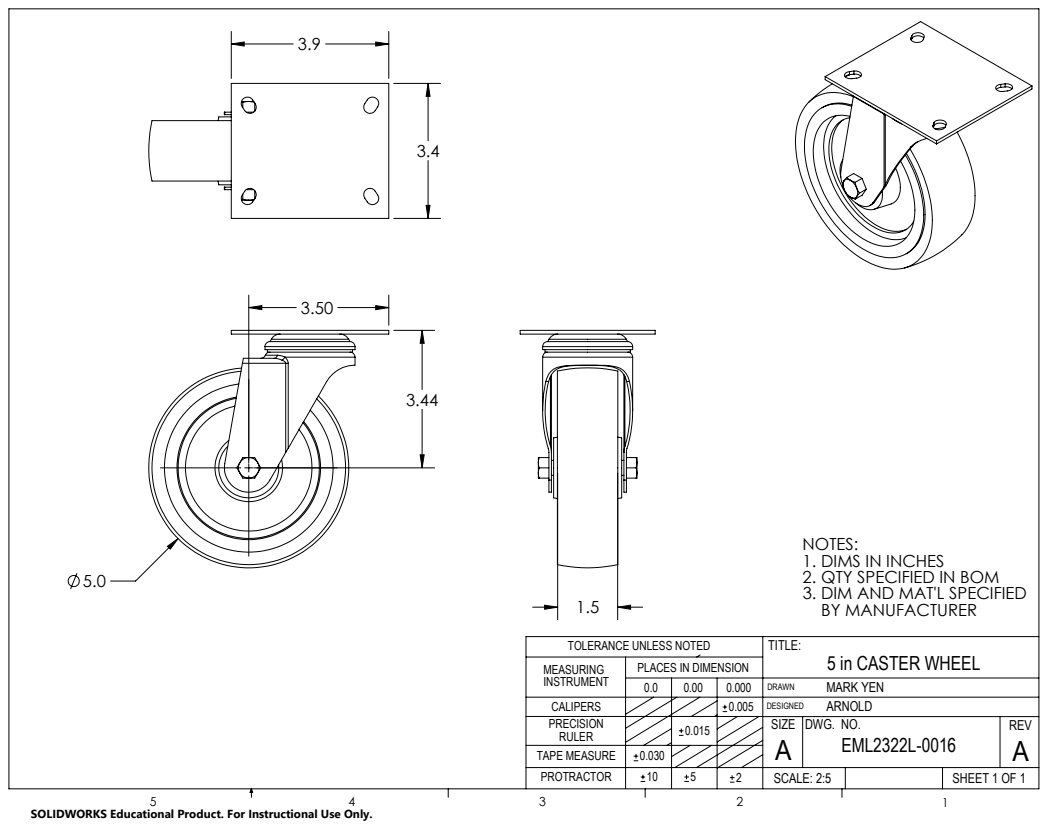
[picture p131: page 12]
SHEET 1 OF 1; TAPE MEASURE; TOLERANCE UNLESS NOTED; SCALE: 2:5

NOTES:
DIMS IN INCHES
QTY SPECIFIED IN BOM
3. DIM AND MAT'L SPECIFIED
BY MANUFACTURER
5 in CASTER WHEEL
MARK YEN
ARNOLD
DWG. NO.

PLACES IN DIMENSION

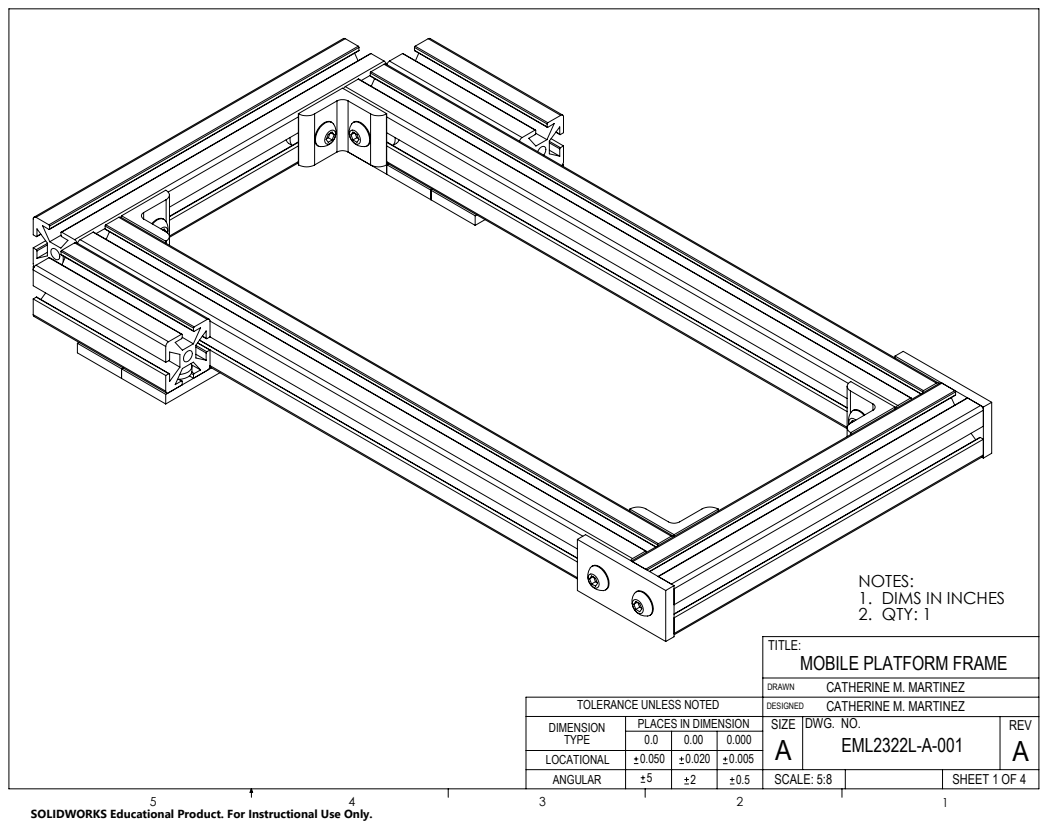
[picture p132: page 13]
SCALE: 5:8

NOTES:
DIMS IN INCHES
2. QTY: 1
MOBILE PLATFORM FRAME
CATHERINE M. MARTINEZ
DWG. NO.
SIZE

TOLERANCE UNLESS NOTED
DIMENSION
TYPE
LOCATIONAL

PLACES IN DIMENSION

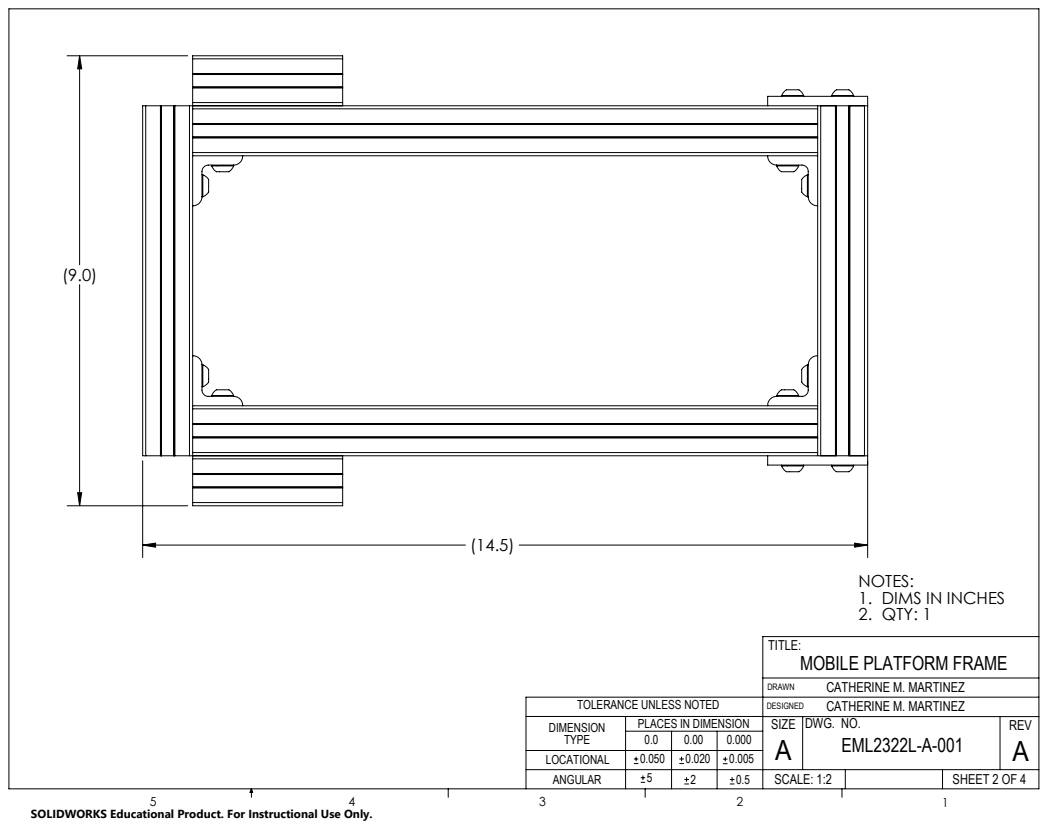
[picture p133: page 14]
SCALE: 1:2

NOTES:
DIMS IN INCHES
2. QTY: 1
MOBILE PLATFORM FRAME
CATHERINE M. MARTINEZ
DWG. NO.
SIZE

TOLERANCE UNLESS NOTED
DIMENSION
TYPE
LOCATIONAL

PLACES IN DIMENSION

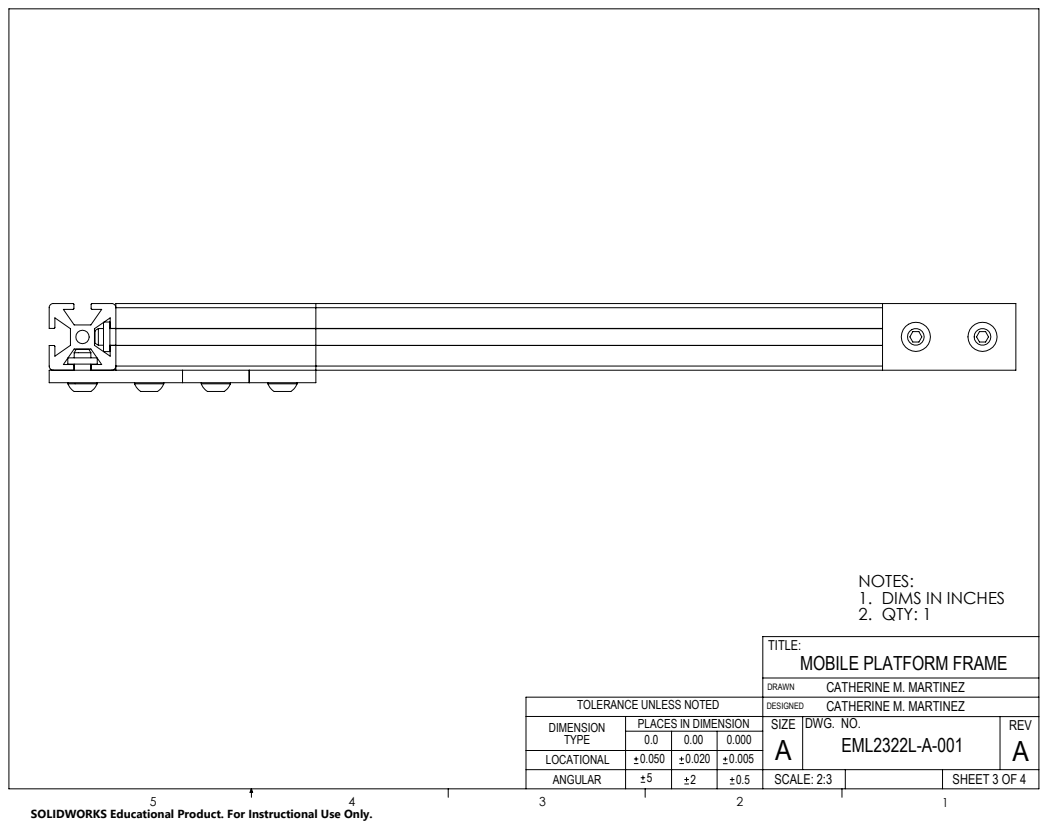
[picture p134: page 15]
SCALE: 2:3

NOTES:
DIMS IN INCHES
2. QTY: 1
MOBILE PLATFORM FRAME
CATHERINE M. MARTINEZ
DWG. NO.
SIZE

TOLERANCE UNLESS NOTED
DIMENSION
TYPE
LOCATIONAL

PLACES IN DIMENSION

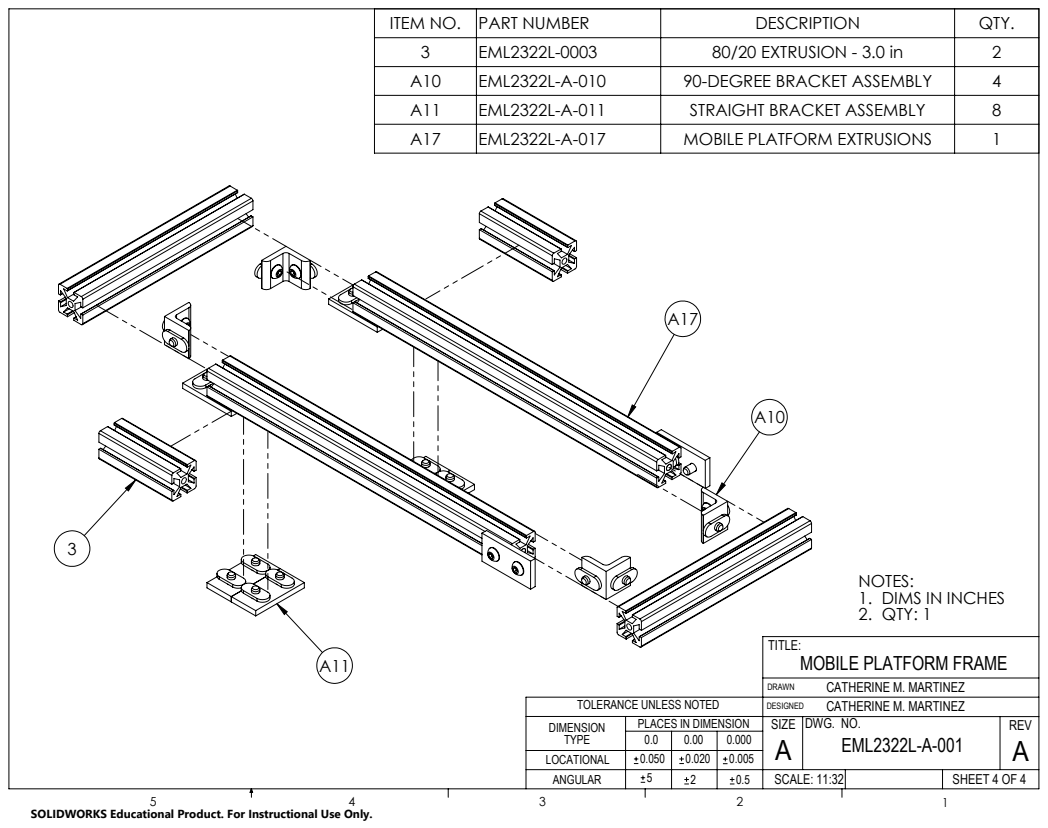
[picture p135: page 16]
SCALE: 11:32

ITEM NO. | PART NUMBER | DESCRIPTION | QTY.
3 | EML2322L-0003 | 80/20 EXTRUSION - 3.0 in | 2
A10 | EML2322L-A-010 | 90-DEGREE BRACKET ASSEMBLY | 4
A11 | EML2322L-A-011 | STRAIGHT BRACKET ASSEMBLY | 8
A17 | EML2322L-A-017 | MOBILE PLATFORM EXTRUSIONS | 1

NOTES:
DIMS IN INCHES
2. QTY: 1
MOBILE PLATFORM FRAME
CATHERINE M. MARTINEZ
DWG. NO.
SIZE

TOLERANCE UNLESS NOTED
DIMENSION
TYPE
LOCATIONAL

PLACES IN DIMENSION

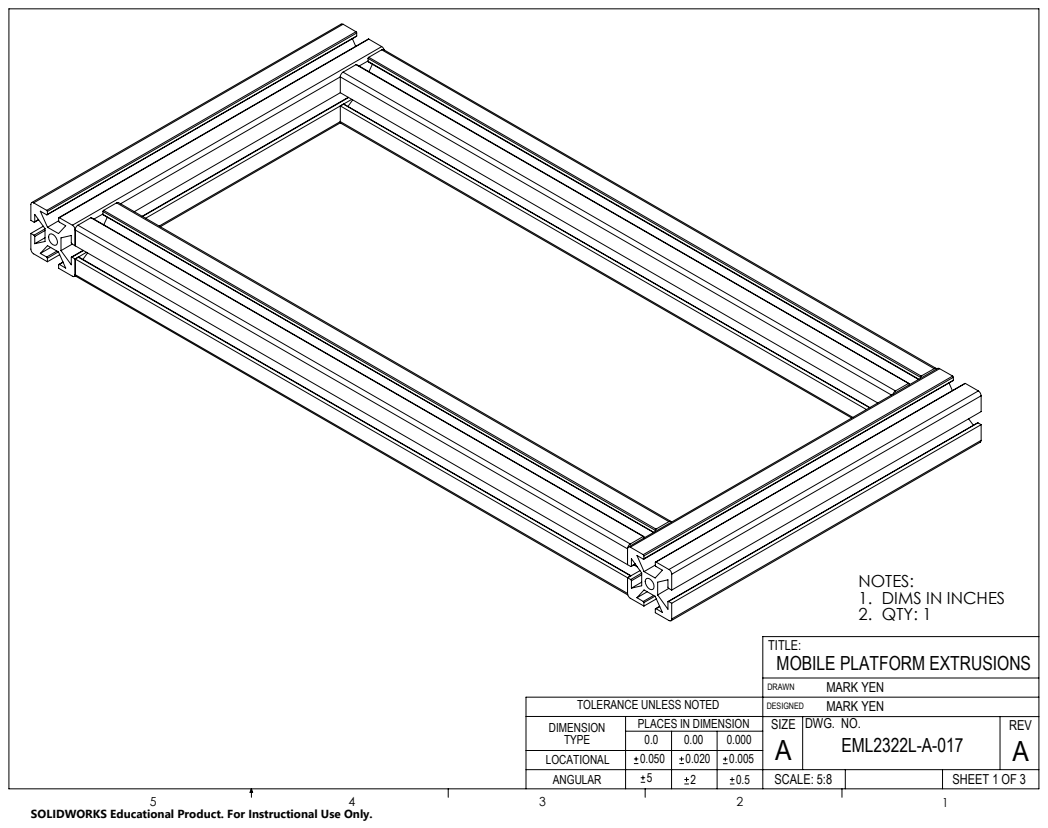
[picture p136: page 17]
SCALE: 5:8; DIMS IN INCHES 2. QTY: 1

TITLE:
MOBILE PLATFORM EXTRUSIONS
MARK YEN
DWG. NO.
SIZE

TOLERANCE UNLESS NOTED
DIMENSION
TYPE
LOCATIONAL

PLACES IN DIMENSION

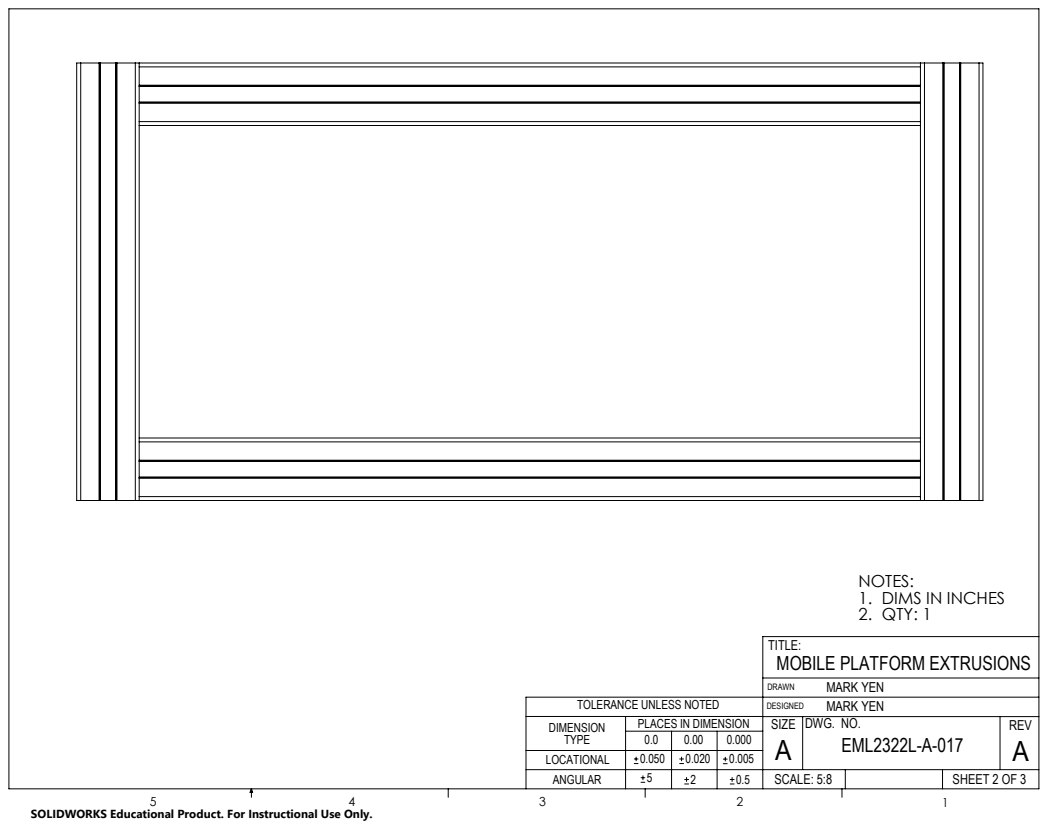
[picture p137: page 18]
SCALE: 5:8; DIMS IN INCHES 2. QTY: 1

TITLE:
MOBILE PLATFORM EXTRUSIONS
MARK YEN
DWG. NO.
SIZE

TOLERANCE UNLESS NOTED
DIMENSION
TYPE
LOCATIONAL

PLACES IN DIMENSION

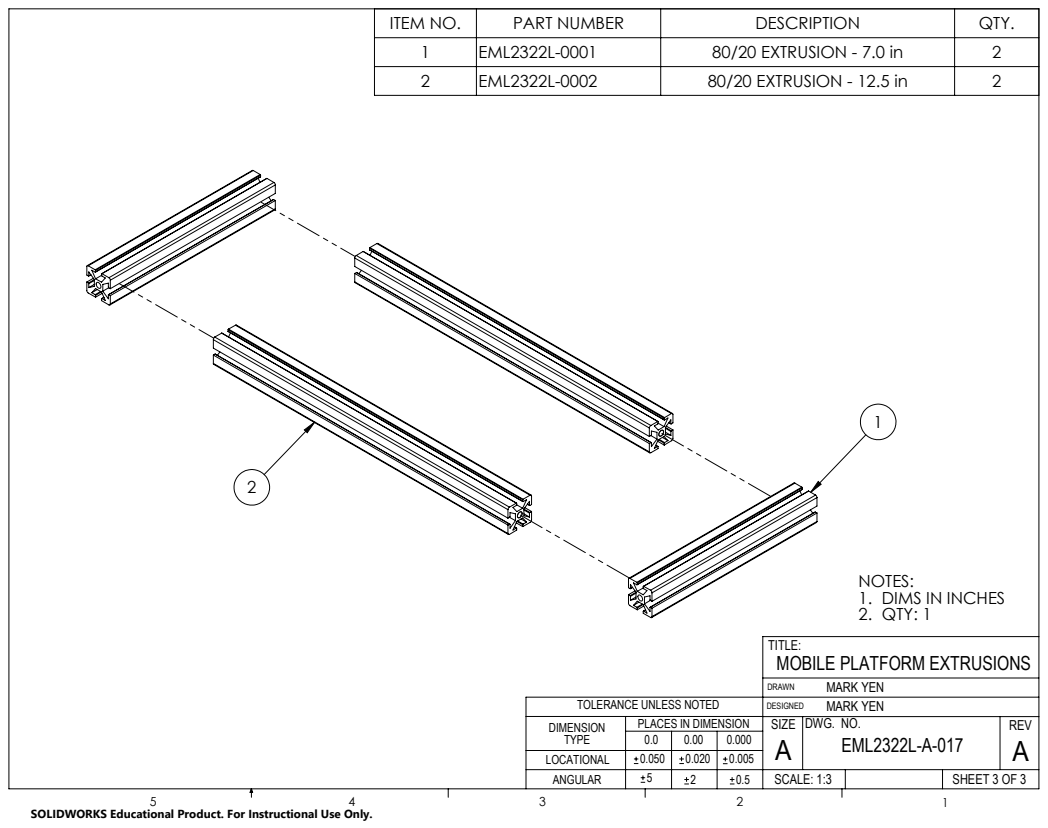
[picture p138: page 19]
SCALE: 1:3; DIMS IN INCHES 2. QTY: 1

ITEM NO. | PART NUMBER | DESCRIPTION | QTY.
1 | EML2322L-0001 | 80/20 EXTRUSION - 7.0 in | 2
2 | EML2322L-0002 | 80/20 EXTRUSION - 12.5 in | 2

TITLE:
MOBILE PLATFORM EXTRUSIONS
MARK YEN
DWG. NO.
SIZE

TOLERANCE UNLESS NOTED
DIMENSION
TYPE
LOCATIONAL

PLACES IN DIMENSION

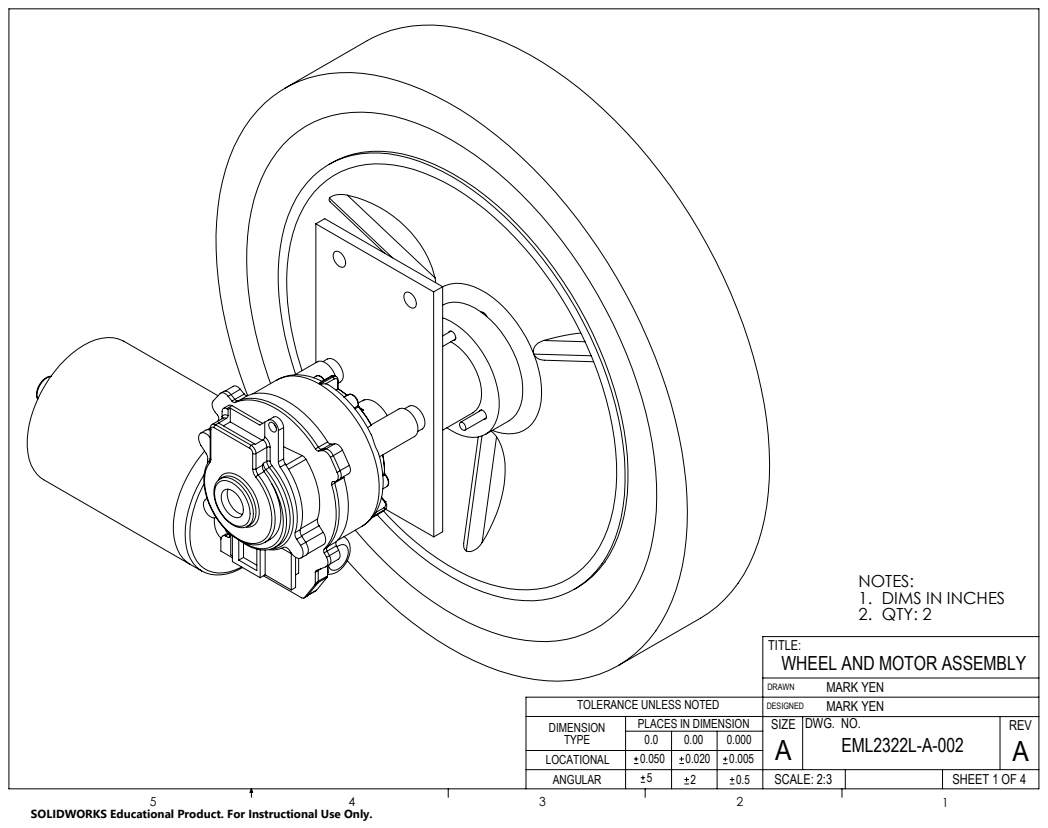
[picture p139: page 20]
SCALE: 2:3

NOTES:
DIMS IN INCHES
2. QTY: 2
WHEEL AND MOTOR ASSEMBLY
MARK YEN
DWG. NO.
SIZE

TOLERANCE UNLESS NOTED
DIMENSION
TYPE
LOCATIONAL

PLACES IN DIMENSION

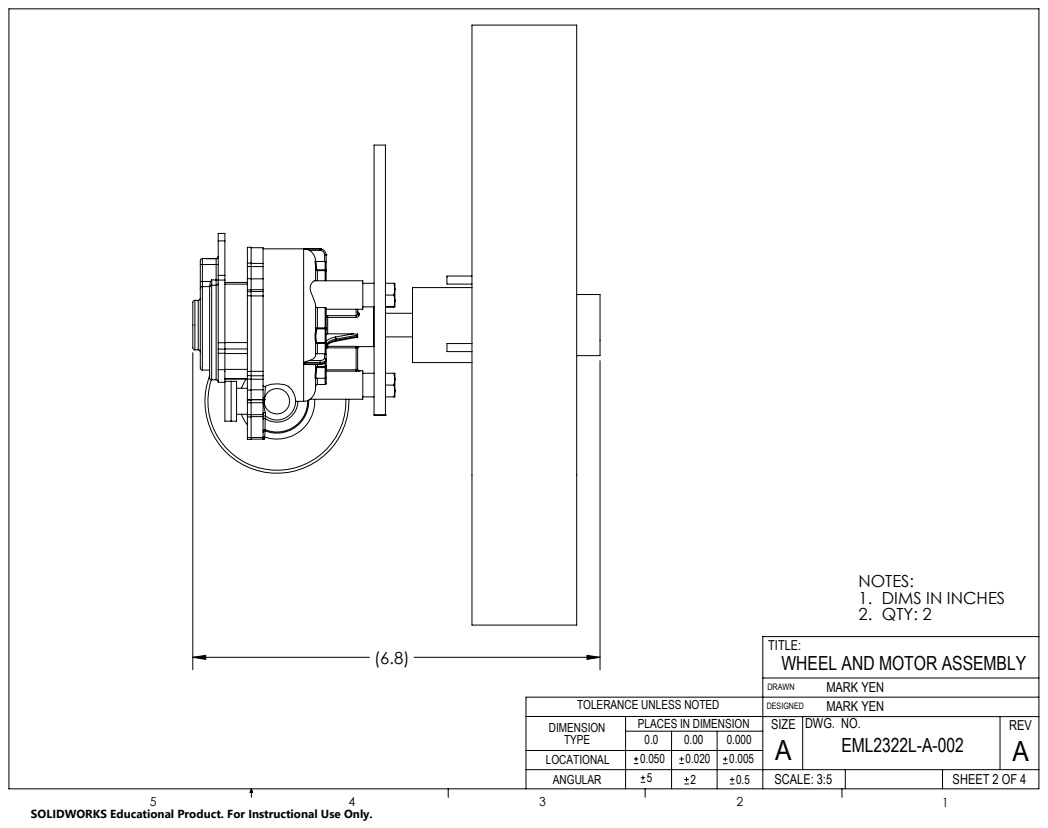
[picture p140: page 21]
DWG. NO.; MARK YEN MARK YEN; SCALE: 3:5; DIMS IN INCHES 2. QTY: 2

(6.8) WHEEL AND MOTOR ASSEMBLY

TOLERANCE UNLESS NOTED
DIMENSION
TYPE
LOCATIONAL

PLACES IN DIMENSION

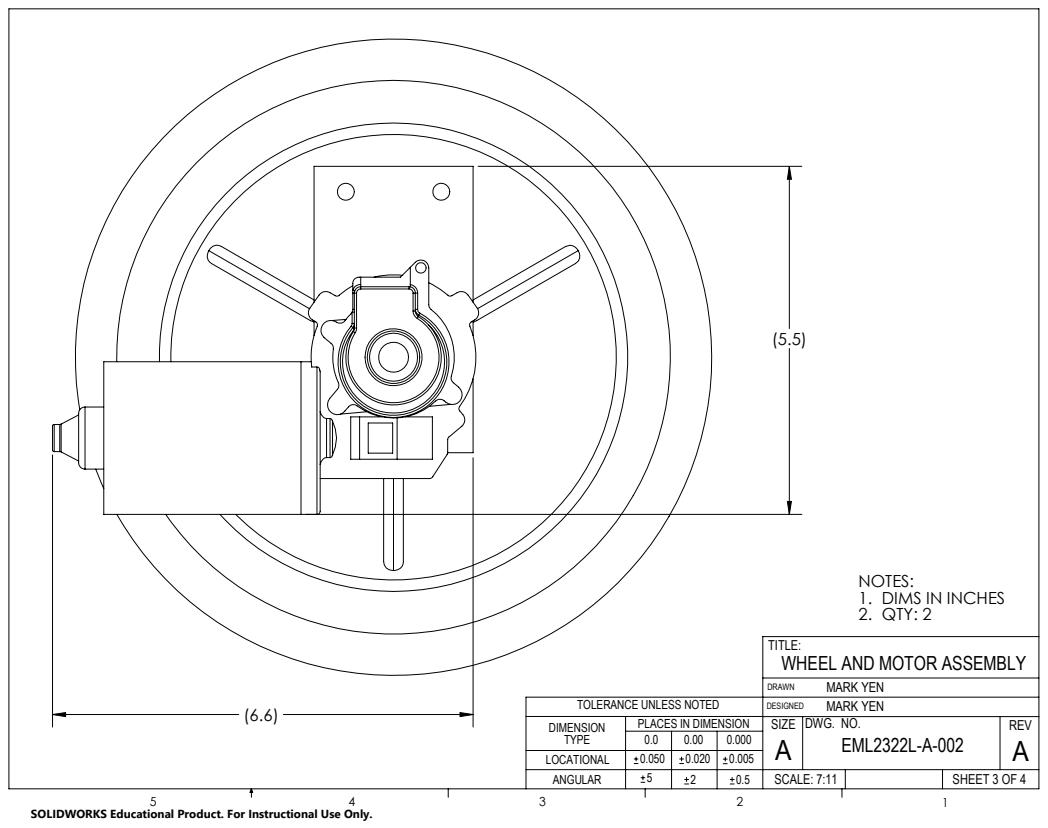
[picture p141: page 22]
SCALE: 7:11

NOTES:
DIMS IN INCHES
2. QTY: 2
WHEEL AND MOTOR ASSEMBLY
MARK YEN
DWG. NO.
SIZE

TOLERANCE UNLESS NOTED
DIMENSION
TYPE
LOCATIONAL

PLACES IN DIMENSION

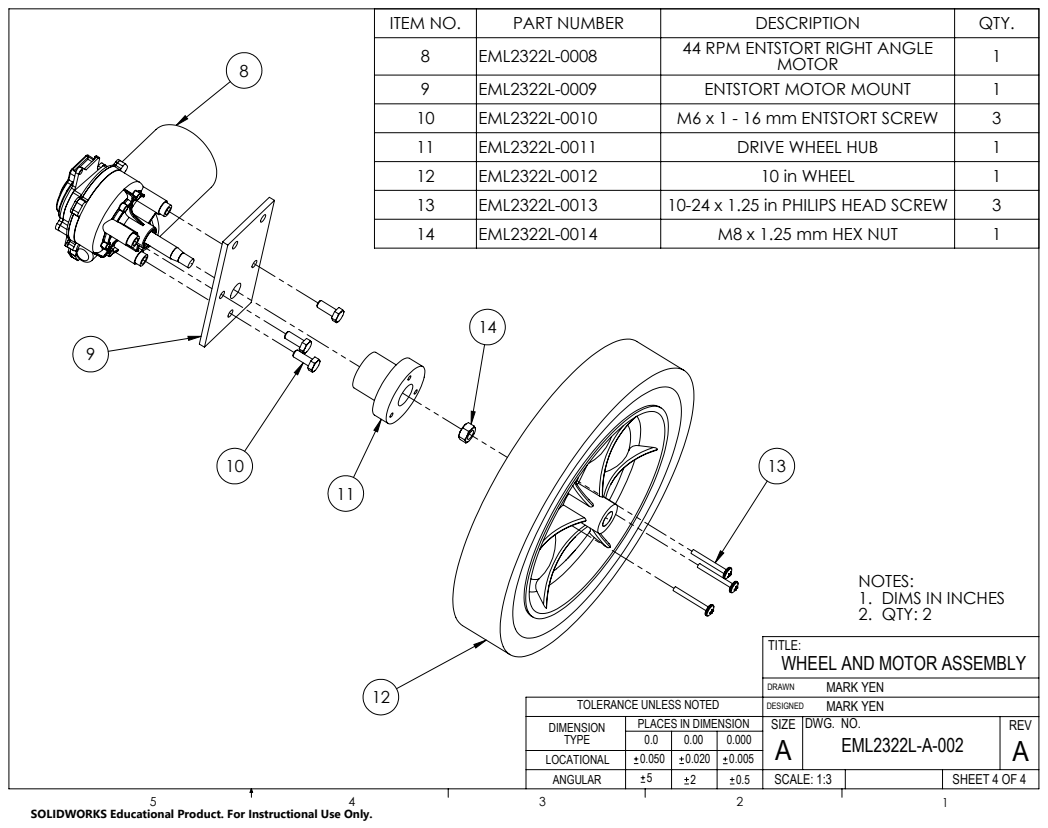
[picture p142: page 23]
SCALE: 1:3

ITEM NO. | PART NUMBER | DESCRIPTION | QTY.
8 | EML2322L-0008 | 44 RPM ENTSTORT RIGHT ANGLE MOTOR | 1
9 | EML2322L-0009 | ENTSTORT MOTOR MOUNT | 1
10 | EML2322L-0010 | M6 x 1 - 16 mm ENTSTORT SCREW | 3
11 | EML2322L-0011 | DRIVE WHEEL HUB | 1
12 | EML2322L-0012 | 10 in WHEEL | 1
13 | EML2322L-0013 | 10-24 x 1.25 in PHILIPS HEAD SCREW | 3
14 | EML2322L-0014 | M8 x 1.25 mm HEX NUT | 1

NOTES:
DIMS IN INCHES
2. QTY: 2
WHEEL AND MOTOR ASSEMBLY
MARK YEN
DWG. NO.
SIZE

TOLERANCE UNLESS NOTED
DIMENSION
TYPE
LOCATIONAL

PLACES IN DIMENSION

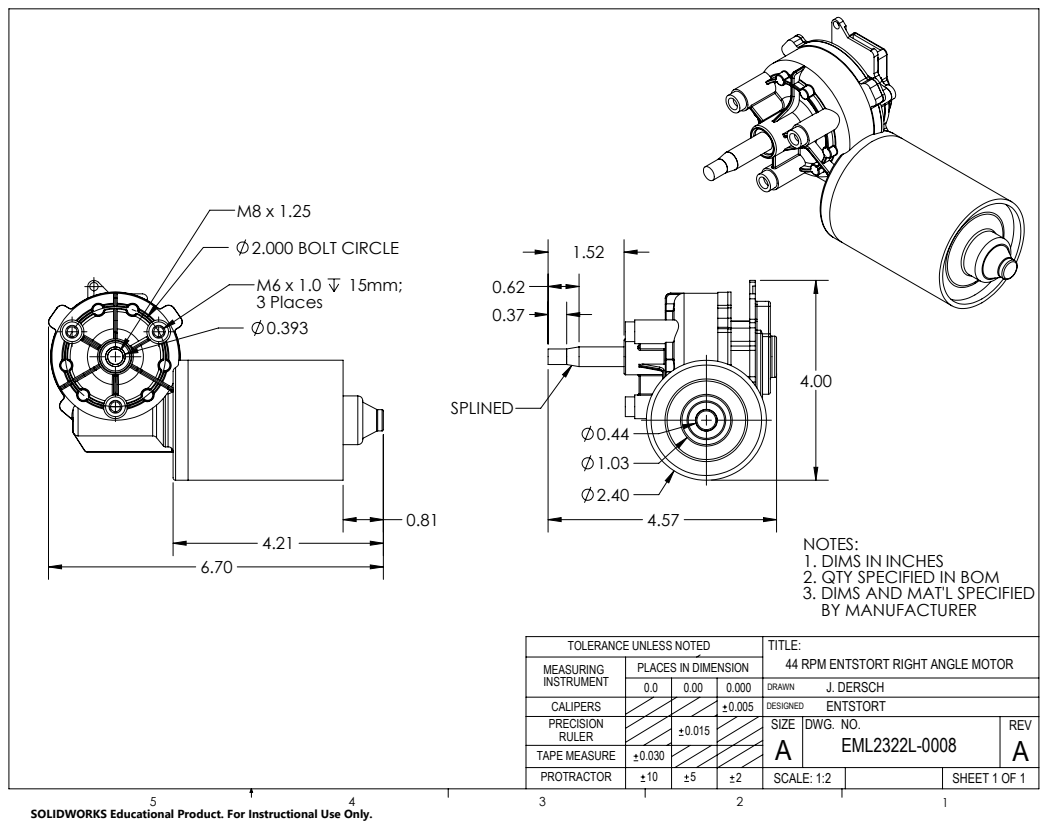
[picture p143: page 24]
2.000 BOLT CIRCLE; M6 x 1.0 15mm; 3 Places; SHEET 1 OF 1; TAPE MEASURE; TOLERANCE UNLESS NOTED; SCALE: 1:2

NOTES:
1. DIMS IN
2. QTY SPECIFIED IN BOM
3. DIMS AND MAT'L SPECIFIED
BY MANUFACTURER

TITLE:
44 RPM ENTSTORT RIGHT ANGLE MOTOR
J. DERSCH
ENTSTORT
DWG. NO.

PLACES IN DIMENSION

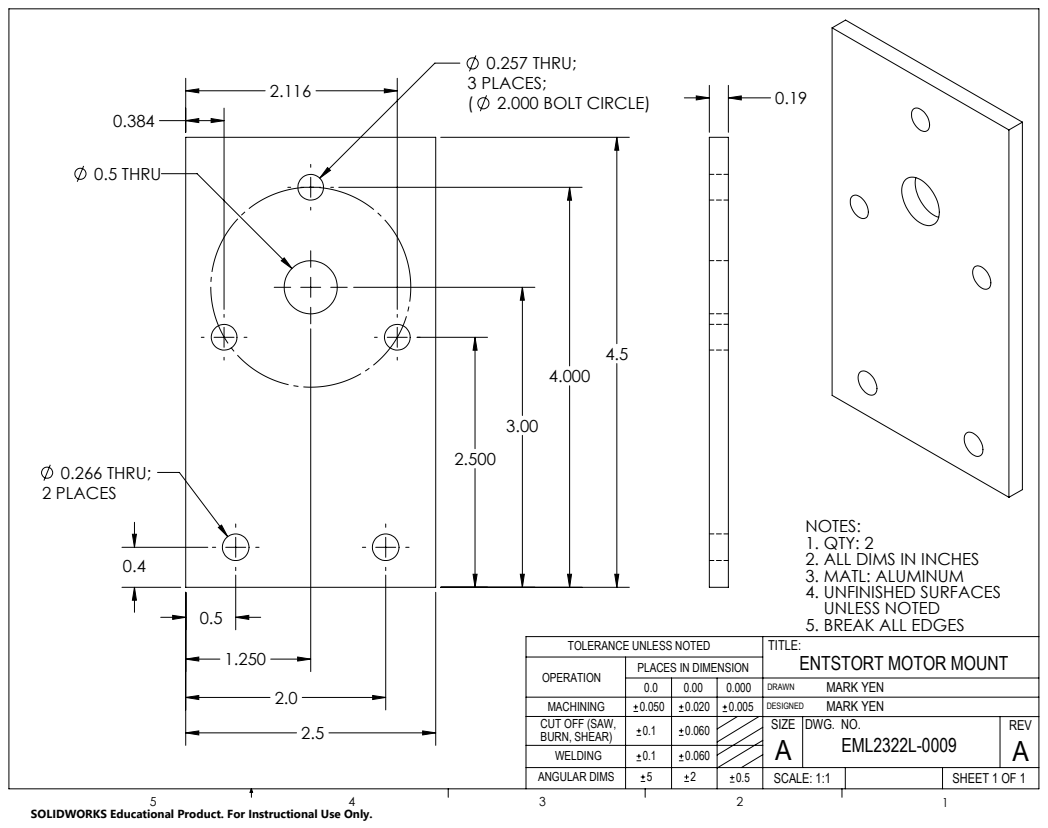
[picture p144: page 25]
0.266 THRU; 2 PLACES; 0.257 THRU; 3 PLACES; ( 2.000 BOLT CIRCLE); 0.5 THRU; SCALE: 1:1

NOTES:
1. QTY: 2
2. ALL DIMS IN INCHES
3. MATL: ALUMINUM
4. UNFINISHED SURFACES
UNLESS NOTED
5. BREAK ALL EDGES
TITLE:
ENTSTORT MOTOR MOUNT
MARK YEN
DWG. NO.

TOLERANCE UNLESS NOTED
OPERATION
MACHINING
CUT OFF (SAW,
BURN, SHEAR)
WELDING
ANGULAR DIMS

PLACES IN DIMENSION

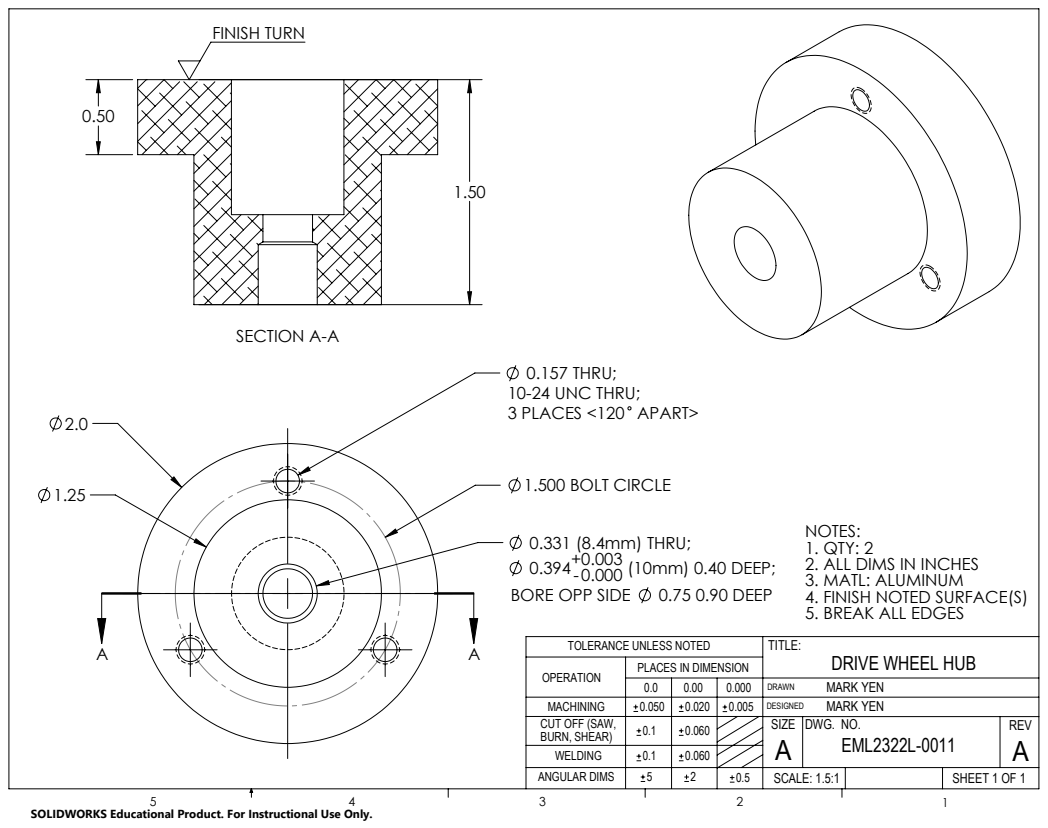
[picture p145: page 26]
0.157 THRU; 10-24 UNC THRU; 3 PLACES <120 APART>; 0.331 (8.4mm) THRU; 0.000 (10mm) 0.40 DEEP;; BORE OPP SIDE; 0.75 0.90 DEEP; 1.500 BOLT CIRCLE; SECTION A-A; FINISH TURN; SCALE: 1.5:1

NOTES:
1. QTY: 2
2. ALL DIMS IN INCHES
3. MATL: ALUMINUM
4. FINISH NOTED SURFACE(S)
5. BREAK ALL EDGES
TITLE:
DRIVE WHEEL HUB
MARK YEN
DWG. NO.

TOLERANCE UNLESS NOTED
OPERATION
MACHINING
CUT OFF (SAW,
BURN, SHEAR)
WELDING
ANGULAR DIMS

PLACES IN DIMENSION

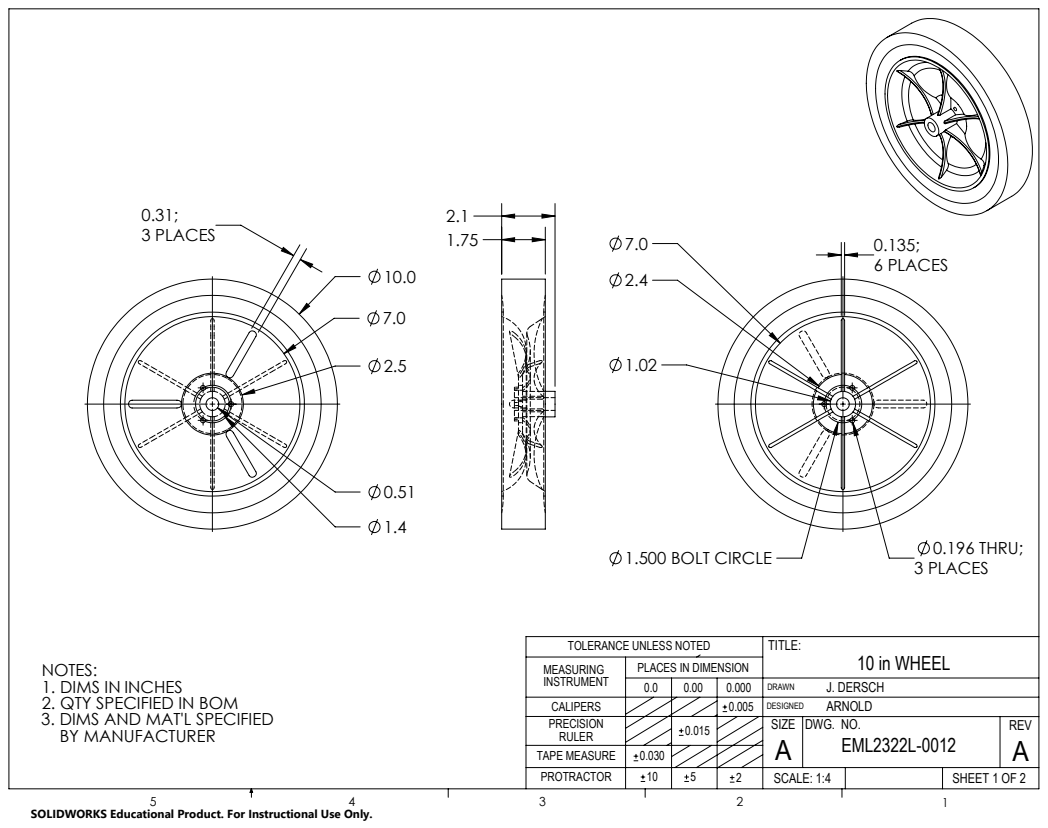
[picture p146: page 27]
6 PLACES; 0.196 THRU;; 3 PLACES; 10 in WHEEL; SHEET 1 OF 2; DWG. NO.; J. DERSCH; TAPE MEASURE; TOLERANCE UNLESS NOTED; SCALE: 1:4

3 PLACES 1.500 BOLT CIRCLE

NOTES:
1. DIMS IN
2. QTY SPECIFIED IN BOM
3. DIMS AND MAT'L SPECIFIED
BY MANUFACTURER

PLACES IN DIMENSION

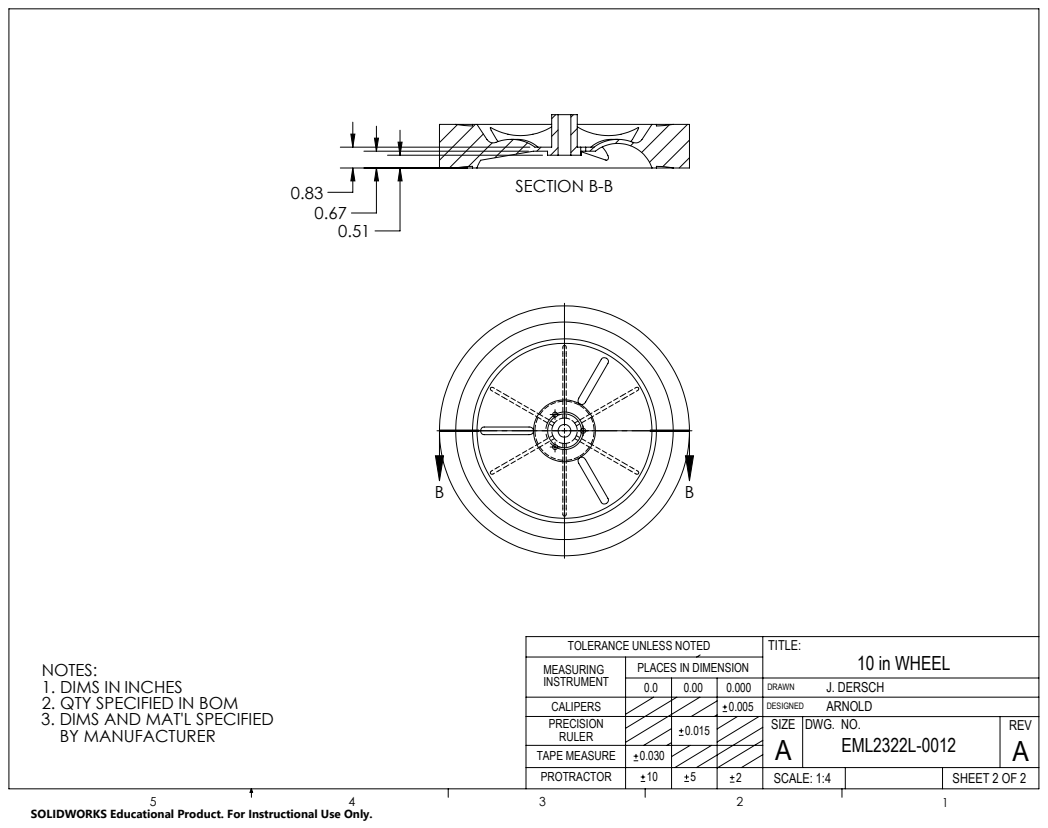
[picture p147: page 28]
SECTION B-B; 10 in WHEEL; SHEET 2 OF 2; DWG. NO.; J. DERSCH; TAPE MEASURE; TOLERANCE UNLESS NOTED; SCALE: 1:4

NOTES:
1. DIMS IN
2. QTY SPECIFIED IN BOM
3. DIMS AND MAT'L SPECIFIED
BY MANUFACTURER

PLACES IN DIMENSION
