markyen001/DR3-Resubmission/Documents Ready for Print/Tabs.docx

Detailed Design | Detailed Design
Appendix D | Appendix D
Appendix I | Appendix I
