markyen001/DR3-Resubmission/Final Assembly Work/A0 - a.PDF

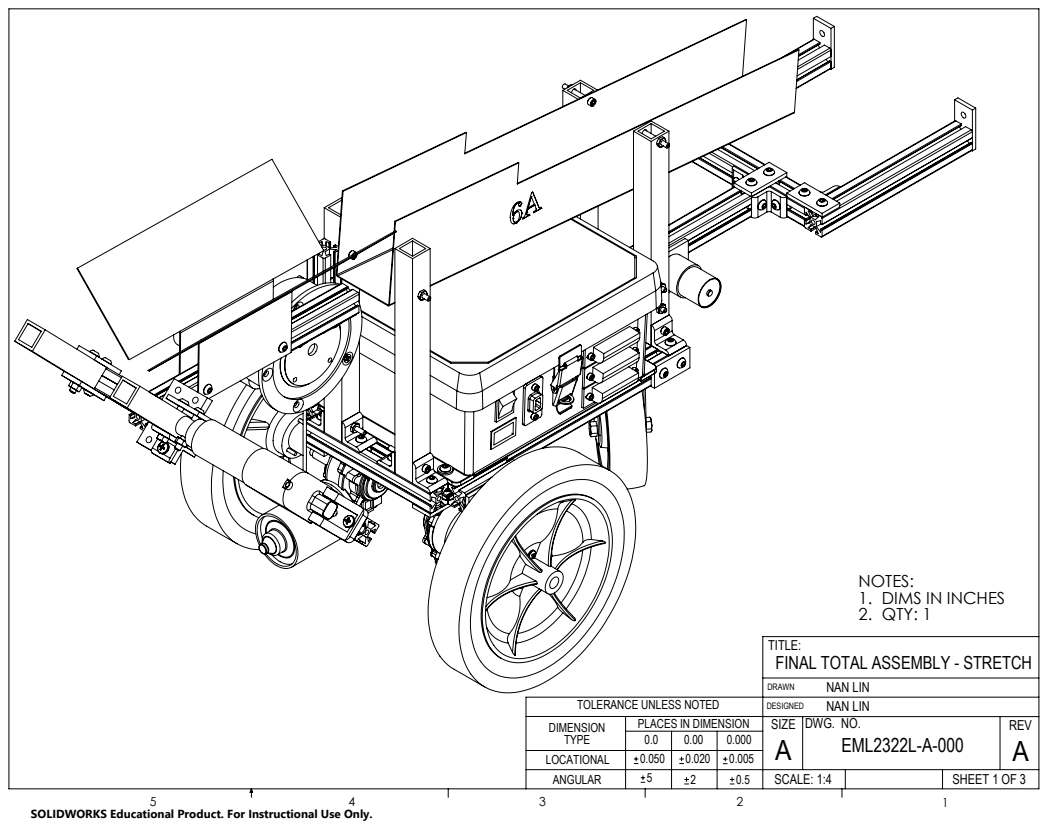
[picture p148: page 1]
SHEET 1 OF 3; TOLERANCE UNLESS NOTED; SCALE: 1:4; DIMS IN INCHES 2. QTY: 1

TITLE:
FINAL TOTAL ASSEMBLY - STRETCH
NAN LIN
DWG. NO.
SIZE

PLACES IN DIMENSION

SOLIDWORKS Educational Product. For Instructional Use Only.

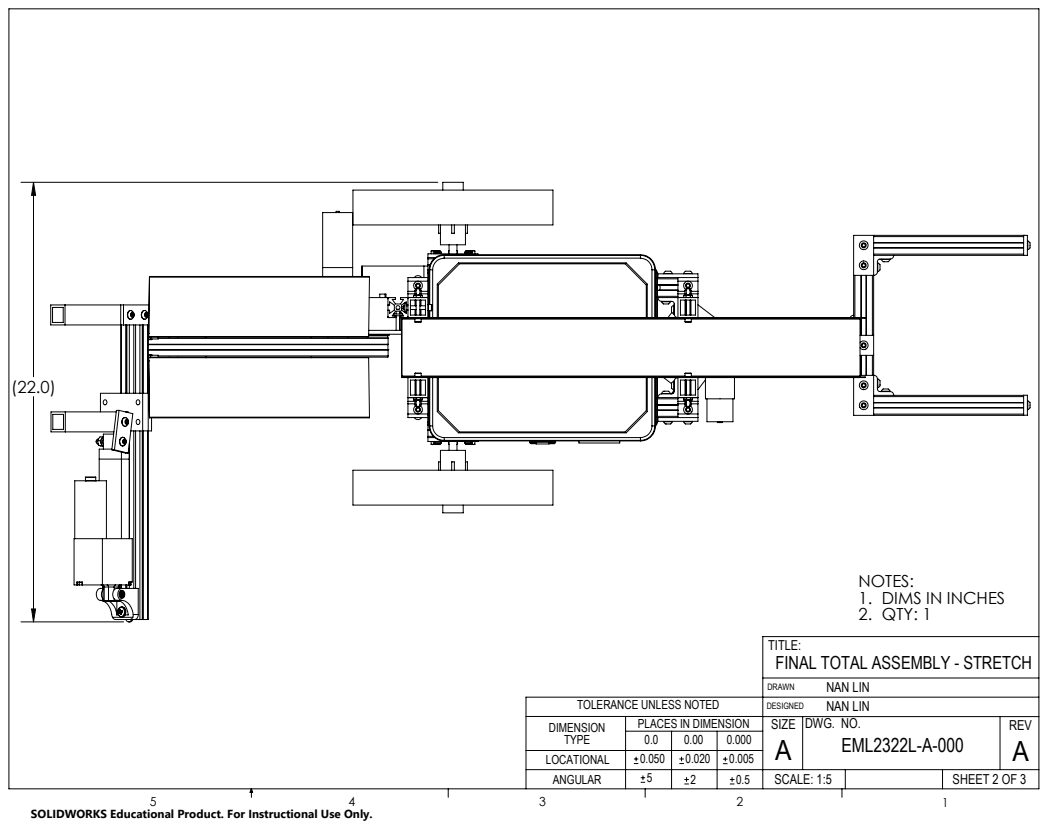
[picture p149: page 2]
DIMS IN INCHES 2. QTY: 1

TITLE:
FINAL TOTAL ASSEMBLY - STRETCH
NAN LIN
DWG. NO.
SIZE

TOLERANCE UNLESS NOTED
DIMENSION
TYPE
LOCATIONAL

PLACES IN DIMENSION

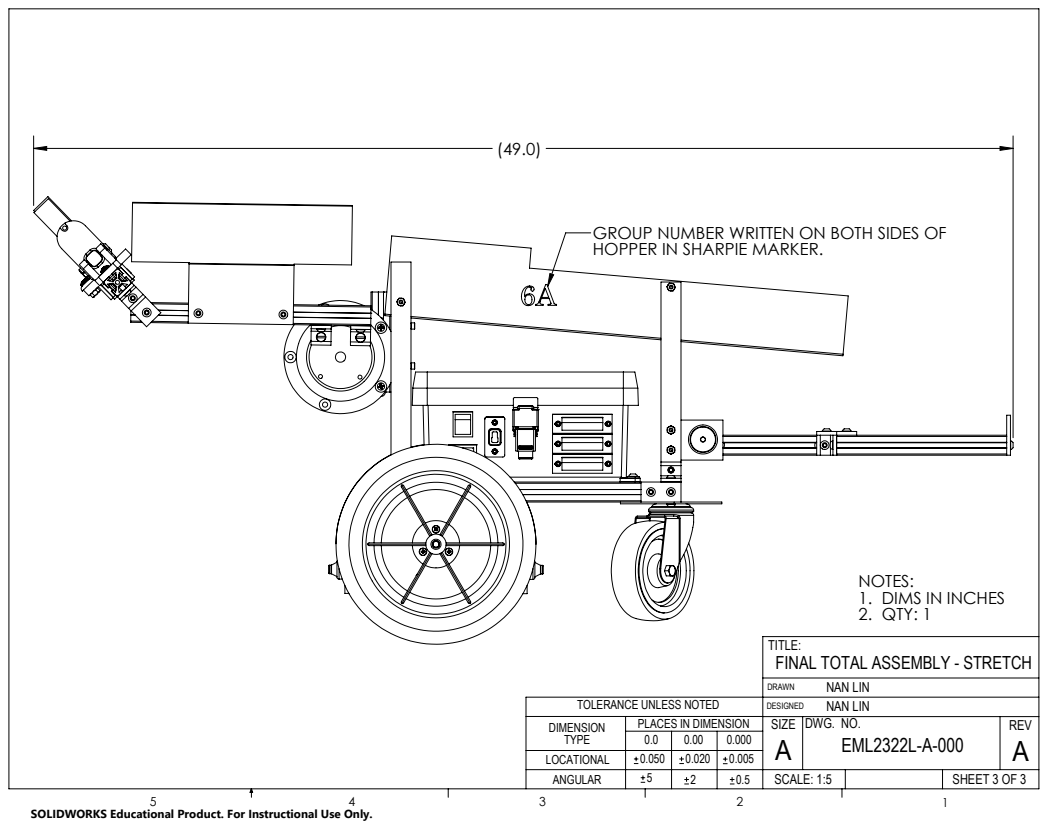
[picture p150: page 3]
DIMS IN INCHES 2. QTY: 1

GROUP NUMBER WRITTEN ON BOTH SIDES OF
HOPPER IN SHARPIE MARKER.

TITLE:
FINAL TOTAL ASSEMBLY - STRETCH
NAN LIN
DWG. NO.
SIZE

TOLERANCE UNLESS NOTED
DIMENSION
TYPE
LOCATIONAL

PLACES IN DIMENSION
