markyen001/DR3-Resubmission/Final Assembly Work/A0 - b.PDF

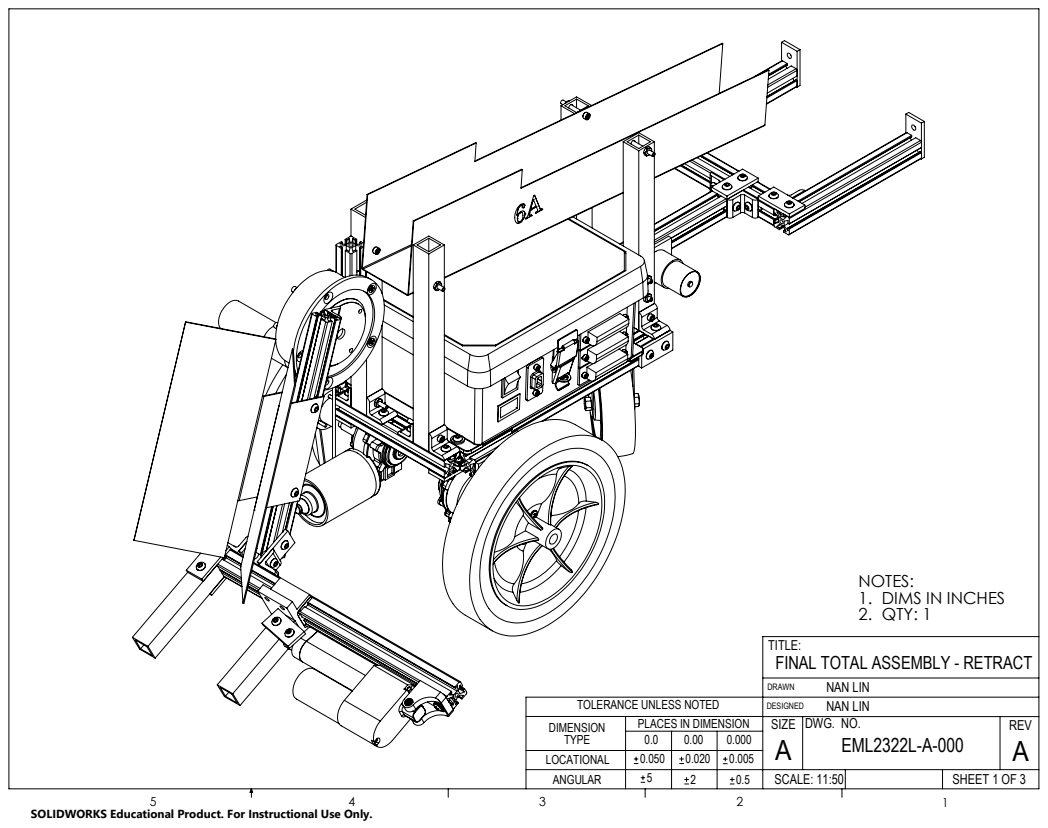
[picture p151: page 1]
SHEET 1 OF 3; TOLERANCE UNLESS NOTED; SCALE: 11:50; DIMS IN INCHES 2. QTY: 1

TITLE:
FINAL TOTAL ASSEMBLY - RETRACT
NAN LIN
DWG. NO.
SIZE

PLACES IN DIMENSION

SOLIDWORKS Educational Product. For Instructional Use Only.

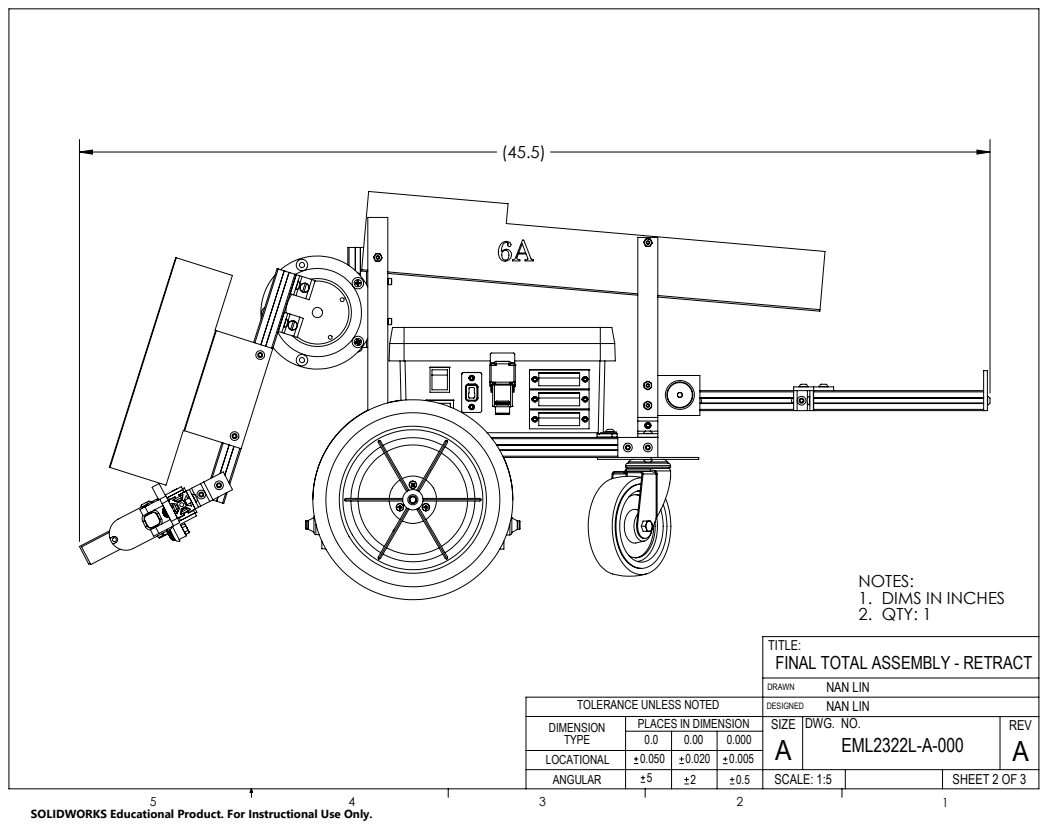
[picture p152: page 2]
SCALE: 1:5; DIMS IN INCHES 2. QTY: 1

TITLE:
FINAL TOTAL ASSEMBLY - RETRACT
NAN LIN
DWG. NO.
SIZE

TOLERANCE UNLESS NOTED
DIMENSION
TYPE
LOCATIONAL

PLACES IN DIMENSION

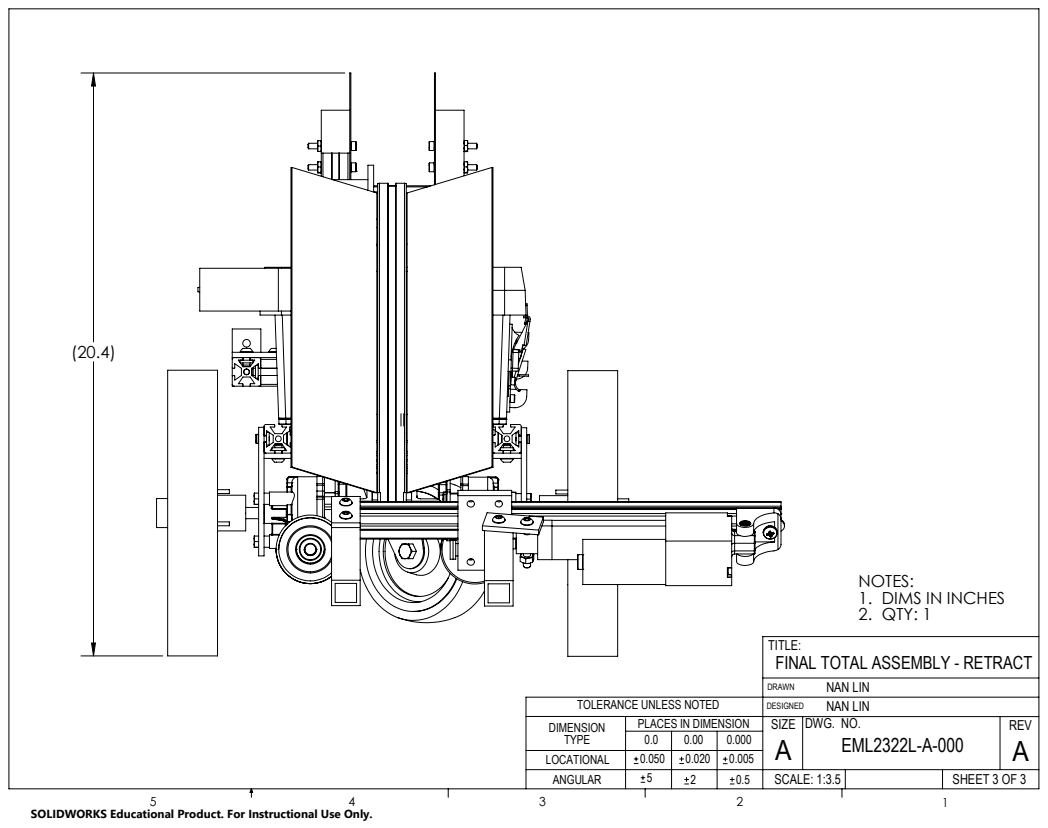
[picture p153: page 3]
SCALE: 1:3.5; DIMS IN INCHES 2. QTY: 1

TITLE:
FINAL TOTAL ASSEMBLY - RETRACT
NAN LIN
DWG. NO.
SIZE

TOLERANCE UNLESS NOTED
DIMENSION
TYPE
LOCATIONAL

PLACES IN DIMENSION
