markyen001/DR3-Resubmission/Final Assembly Work/A0 - c.PDF

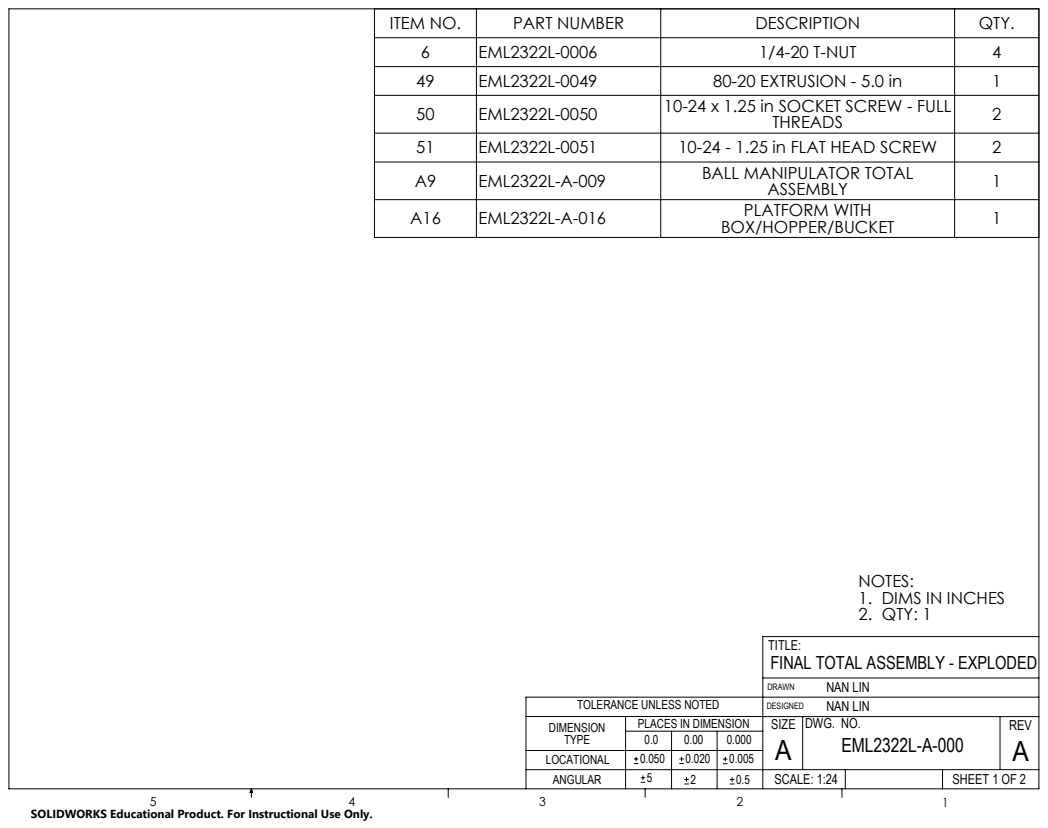
[picture p154: page 1]
SHEET 1 OF 2; TOLERANCE UNLESS NOTED; SCALE: 1:24; DIMS IN INCHES 2. QTY: 1

ITEM NO. | PART NUMBER | DESCRIPTION | QTY.
6 | EML2322L-0006 | 1/4-20 T-NUT | 4
49 | EML2322L-0049 | 80-20 EXTRUSION - 5.0 in | 1
50 | EML2322L-0050 | 10-24 x 1.25 in SOCKET SCREW - FULL THREADS | 2
51 | EML2322L-0051 | 10-24 - 1.25 in FLAT HEAD SCREW | 2
A9 | EML2322L-A-009 | BALL MANIPULATOR TOTAL ASSEMBLY | 1
A16 | EML2322L-A-016 | PLATFORM WITH BOX/HOPPER/BUCKET | 1

TITLE:
FINAL TOTAL ASSEMBLY - EXPLODED
NAN LIN
DWG. NO.
SIZE

PLACES IN DIMENSION

SOLIDWORKS Educational Product. For Instructional Use Only.

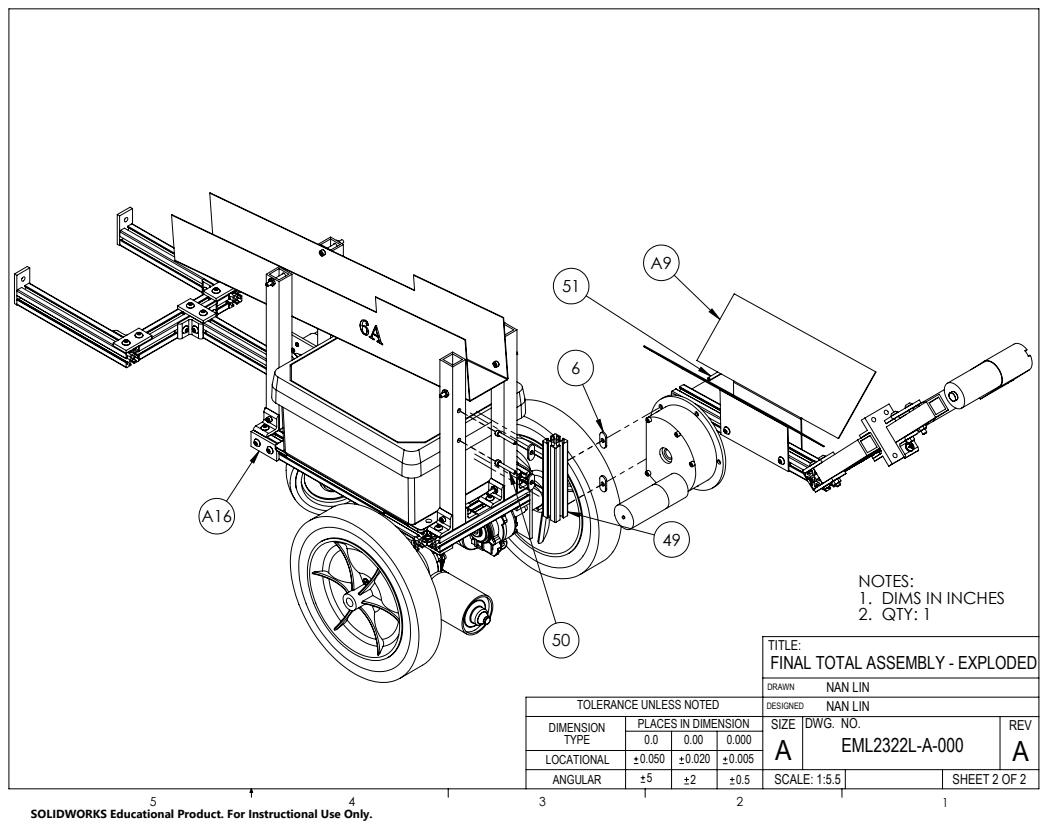
[picture p155: page 2]
SHEET 2 OF 2; TOLERANCE UNLESS NOTED; SCALE: 1:5.5; DIMS IN INCHES 2. QTY: 1

TITLE:
FINAL TOTAL ASSEMBLY - EXPLODED
NAN LIN
DWG. NO.
SIZE

PLACES IN DIMENSION

SOLIDWORKS Educational Product. For Instructional Use Only.
