markyen001/DR3-Resubmission/Documents Ready for Print/4 - A4.PDF

SHEET 1 OF 4; TOLERANCE UNLESS NOTED; SCALE: 5:8

NOTES:
DIMS IN INCHES
2. QTY: 1
BUCKET MANIPULATOR
NAN LIN
DWG. NO.
SIZE

PLACES IN DIMENSION

SOLIDWORKS Educational Product. For Instructional Use Only.

SCALE: 1:2

NOTES:
DIMS IN INCHES
2. QTY: 1
BUCKET MANIPULATOR
NAN LIN
DWG. NO.
SIZE

TOLERANCE UNLESS NOTED
DIMENSION
TYPE
LOCATIONAL

PLACES IN DIMENSION

SCALE: 1:2

NOTES:
DIMS IN INCHES
2. QTY: 1
BUCKET MANIPULATOR
NAN LIN
DWG. NO.
SIZE

TOLERANCE UNLESS NOTED
DIMENSION
TYPE
LOCATIONAL

PLACES IN DIMENSION

SCALE: 9:20

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

NOTES:
DIMS IN INCHES
2. QTY: 1
BUCKET MANIPULATOR
NAN LIN
DWG. NO.
SIZE

TOLERANCE UNLESS NOTED
DIMENSION
TYPE
LOCATIONAL

PLACES IN DIMENSION
