markyen001/DR3-Resubmission/(commit log)

2018-10-04 Added initial files
    [0.25-20 Button Head Cap Screw (BHCS).SLDPRT, 0019 BALL HOPPER.SLDPRT, 10 Inch Wheel.SLDPRT, 10-24 Thread 0.25 Length Set Screw for Bucket Motor Shaft.SLDPRT, 10-24 Thread 0.5 Inch Length Screw for Motor Hub.SLDPRT, 10-24 Thread 1.25 Length Socket Screw.SLDPRT, 10-24 Thread 1.5 Length Socket Head Screw.SLDPRT, 10-24 Thread 2 Length Socket Head Screw.SLDPRT]
2018-10-04 removed threads
    [10-24 Thread 0.5 Inch Length Screw for Motor Hub.SLDPRT]
2018-10-05 removed more threads
    [10-24 Thread 0.25 Length Set Screw for Bucket Motor Shaft.SLDPRT, 10-24 Thread 1.25 Length Socket Screw.SLDPRT, 10-24 Thread 1.5 Length Socket Head Screw.SLDPRT, 10-24 Thread 2 Length Socket Head Screw.SLDPRT, 10-24 thread 1.25 length flat head screw.SLDPRT, 10-24 x 3-8 Socket Screw for Mount.SLDPRT, Drive Wheel Socket Screws.SLDPRT]
2018-10-05 hid more threads and updated assemblies
    [91306A281_ZINC-PLATED ALLOY STEEL BUTTON-HEAD CAP SCREW.SLDPRT]
2018-10-05 Fixed Ball Manipulator Angle
    [10-inch AL tube assembly - no motor holes.SLDASM, 10-inch AL tube assembly - with motor holes.SLDASM, 11-inch AL tube assembly - no motor hole.SLDASM, 11-inch AL tube assembly - with motor hole.SLDASM, 94895A029_ZINC YELLOW-CHROMATE PLATED STEEL HEX NUT.SLDPRT, A013 HOPPER ASSEMBLY.SLDASM, BM Claw SUBASM.SLDASM, BM MASTER ASM.SLDASM]
2018-10-05 hid more threads and updated assembly
    [90272A539_ZINC-PLTD STL PAN HEAD PHILLIPS MACHINE SCREW.SLDPRT, Entstort Shaft Nut.SLDPRT, Wheel Hub.SLDPRT]
2018-10-05 updated assemblies
    [10-24 Thread 2 Length Socket Head Screw.SLDPRT, 15 RPM SEI Gear Motor.SLDPRT, 90272A539_ZINC-PLTD STL PAN HEAD PHILLIPS MACHINE SCREW.SLDPRT, 90272A540_ZINC-PLTD STL PAN HEAD PHILLIPS MACHINE SCREW.SLDPRT, BM Claw SUBASM.SLDASM, BM MASTER ASM.SLDASM, Bucket Arm Hub.SLDPRT, Bucket Manipulator Total Assembly.SLDASM]
2018-10-05 added control box drawing
    [Control Box.SLDDRW]
2018-10-05 added drawings
    [15 RPM SEI Gear Motor Specs.SLDDRW, 15 RPM SEI Gear Motor.SLDDRW, 80-20 Linear Slide.SLDDRW, 80-20 Linear Slide.SLDPRT, Control Box.SLDDRW, Linear Actuaor Mount (10-24).SLDDRW]
2018-10-05 added images
    [30 IPM Spal Linear Actuator.SLDDRW]
2018-10-05 FIXED BOM
    [Entstort Screw.SLDPRT]
2018-10-05 UPDATED BOM
    [0.25-20 Button Head Cap Screw (BHCS).SLDPRT, 44 RPM Entstort Right Angle Gear Motor.SLDPRT, 80-20 90 Degree Angle Bracket.SLDPRT, 80-20 Extrusion 12.5 inch (simplified).SLDPRT, 80-20 Extrusion 3 inch (simplified).SLDPRT, 80-20 Extrusion 7 inch (simplified).SLDPRT, 80-20 Straight Bracket.SLDPRT, Bucket Manipulator Total Assembly.SLDASM]
2018-10-05 A002 COMPLETED
    [0013 10-24 x 1.25 in PHILIPS HEAD SCREW.SLDPRT, Entstort Shaft Nut.SLDPRT, Wheel Hub Assembly.SLDASM, Wheel and Motor Total Assembly.SLDASM, Wheel and Motor Total Assembly.SLDDRW, platform with wheels only.SLDASM]
2018-10-05 completed more drawings
    [80-20 90 Degree Angle Bracket.SLDDRW, 80-20 Straight Bracket.SLDDRW]
2018-10-05 edited all item numbers
    with the exception of globe motor screw
    [0019 BALL HOPPER.SLDPRT, 10-24 Thread 0.25 Length Set Screw for Bucket Motor Shaft.SLDPRT, 10-24 Thread 0.5 Inch Length Screw for Motor Hub.SLDPRT, 10-24 Thread 1.25 Length Socket Screw.SLDPRT, 10-24 Thread 1.5 Length Socket Head Screw.SLDPRT, 10-24 Thread 2 Length Socket Head Screw.SLDPRT, 10-24 thread 1.25 length flat head screw.SLDPRT, 10-24 x 3-8 Socket Screw for Mount.SLDPRT]
2018-10-06 RANDOM WORD
    [BM ARM CHANNEL GM SIDE UNFOLDED.SLDPRT, BM ARM CHANNEL.SLDPRT, BM Drawings.SLDDRW, BM MASTER ASM.SLDASM, GM Mounting SUBASM.SLDASM, M6 X 14MM PHILLIPS SCREW.SLDPRT, M6x1 - 12mm GLOBE MOTOR SCREW.SLDPRT]
2018-10-06 Revert "Merge branch 'master' of https://github.com/markyen001/DR3-Resubmission"
    This reverts commit 7762d37f937d75d341f9c4e5b20abca96ef258e8, reversing
    changes made to 42c121be6dd01c673544aef9a6143267c80b4d19.
    [80-20 90 Degree Bracket Assy - only 1 fastener.SLDASM, 80-20 Straight Degree Bracket Assy - only 1 fastener.SLDASM, 8020 straight bracket both parallel.SLDASM, 8020 straight bracket one parallel one perpendicular.SLDASM, 90 degree both parallel.SLDASM, 90 degree both parallel.SLDDRW, 90-DEGREE BRACKET ASSEMBLY.SLDDRW, MOBILE PLATFORM EXTRUSIONS.SLDASM]
2018-10-06 Revert "RANDOM WORD"
    This reverts commit 42c121be6dd01c673544aef9a6143267c80b4d19.
    [BM ARM CHANNEL GM SIDE UNFOLDED.SLDPRT, BM ARM CHANNEL.SLDPRT, BM MASTER ASM.SLDASM, M6 X 14MM PHILLIPS SCREW.SLDPRT]
2018-10-06 Revert "adsf"
    This reverts commit 8711f0d55156d83b5e1697a80c5a8de093b2b814.
    [GM Mounting SUBASM.SLDASM]
2018-10-06 Revert "eqw3"
    This reverts commit a75338b47f56868713d01057647350261962a9be.
    [10-inch AL tube assembly - no motor holes.SLDASM, 10-inch AL tube assembly - with motor holes.SLDASM, 11-inch AL tube assembly - no motor hole.SLDASM, 11-inch AL tube assembly - with motor hole.SLDASM, A013 HOPPER ASSEMBLY.SLDASM, Corrected bucketgrabber 2.SLDASM, Hopper and Bucket Manipulator Assembly.SLDASM, MOBILE PLATFORM FRAME.SLDDRW]
2018-10-06 deleted old gm screw
2018-10-06 FINISHED A001
    [90-DEGREE BRACKET ASSEMBLY.SLDASM, MOBILE PLATFORM FRAME.SLDASM, MOBILE PLATFORM FRAME.SLDDRW, STRAIGHT BRACKET ASSEMBLY.SLDASM]
2018-10-06 RENAMED FILES
    [FINAL TOTAL ASSEMBLY - EXPLODE.SLDDRW, FINAL TOTAL ASSEMBLY - RETRACT.SLDDRW]
2018-10-06 REMOVED OLD FRAMES
    [FINAL TOTAL ASSEMBLY - RETRACT.SLDDRW, FINAL TOTAL ASSEMBLY - STRETCH.SLDDRW, PLATFORM WITH WHEELS.SLDASM, mobileplatform 1.SLDASM, mobileplatform 2.SLDASM]
2018-10-06 UPDATE 1
    [8020 straight bracket both parallel.SLDASM, 8020 straight bracket one parallel one perpendicular.SLDASM, 90 degree both parallel.SLDASM, Caster Wheel.SLDPRT, MOBILE PLATFORM FRAME.SLDASM, PLATFORM WITH WHEELS.SLDASM, PLATFORM WITH WHEELS.SLDDRW, STRAIGHT BRACKET ASSEMBLY.SLDASM]
2018-10-06 COMPETED CASTER WHEEL
    [PLATFORM WITH WHEELS.SLDASM]
2018-10-06 PLATFORM WITH WHEEL AND BOX
    [PLATFORM WITH WHEELS.SLDASM]
2018-10-06 I want to murder you!
    [PLATFORM WITH WHEELS.SLDDRW]
2018-10-06 BUCKET GRABBER IN PROGRESS
    [90-DEGREE BRACKET ASSEMBLY.SLDASM, BUCKET GRABBER ASSEMBLY.SLDASM, BUCKET GRABBER EXTRUSIONS.SLDASM, Bucket Manipulator Total Assembly.SLDASM, Corrected bucketgrabber 2.SLDASM, bucketgrabber 1.SLDASM]
2018-10-06 BUCKET FRAME COMPLETE
    [BUCKET GRABBER ASSEMBLY.SLDASM, STRAIGHT BRACKET ASSEMBLY.SLDASM]
2018-10-06 UPDATE 2
    [BUCKET GRABBER ASSEMBLY.SLDASM, Bucket Manipulator Total Assembly.SLDASM, Bucket Motor Mount.SLDDRW, Bucket Motor Mount.SLDPRT, Bucket Motor Total Assembly.SLDASM]
2018-10-06 UPDATE 3
    [Bucket Motor Mount.SLDDRW, Bucket Motor Mount.SLDPRT, Bucket Motor Total Assembly.SLDASM]
2018-10-06 Update Part and Assembly Files/PLATFORM WITH WHEELS.SLDDRW
    [PLATFORM WITH WHEELS.SLDDRW]
2018-10-06 BUCKET HUB AND MOUNT
    [Bucket Arm Hub.SLDDRW, Bucket Arm Hub.SLDPRT, Bucket Manipulator Total Assembly.SLDASM, Bucket Motor Mount.SLDDRW, Bucket Motor Total Assembly.SLDASM, Hopper and Bucket Manipulator Assembly.SLDASM]
2018-10-08 EVERYTHING WITHOUT BM
    [PLATFORM WITH WHEELS.SLDASM]
2018-10-08 PLATFORM WITH OTHERS
    [10-24 x 3-8 Socket Screw for Mount.SLDPRT, PLATFORM WITH WHEELS.SLDASM, Platform Wheels Box Hopper Bucket Assembly.SLDDRW]
2018-10-08 PDF UPDATED
    [BUCKET GRABBER ASSEMBLY.SLDASM, Bucket Manipulator Total Assembly.SLDDRW, Corrected bucketgrabber 2.SLDDRW, HOPPER AND BUCKET ASSEMBLY.SLDDRW, Hopper and Bucket Manipulator Assembly.SLDASM, Platform Wheels Box Hopper Bucket Assembly.SLDDRW]
2018-10-08 PDF UPDATE
    [90 degree both parallel.SLDDRW, Corrected bucketgrabber 2.SLDDRW]
2018-10-08 MINI UPDATE
    [80-20 90 Degree Angle Bracket.SLDDRW, BM Claw SUBASM.SLDASM, BM MASTER ASM.SLDASM]
2018-10-08 FINAL UPDATE BEFORE DIN
    [80-20 90 Degree Angle Bracket.SLDDRW, 80-20 Extrusion 8 inch (simplified).SLDPRT, 80-20 Extrusion 8.5 inch (simplified).SLDPRT, 80-20 Straight Bracket.SLDDRW, 80-20 Straight Degree Bracket Assy.SLDDRW, BUCKET GRABBER EXTRUSIONS.SLDASM, BUCKET GRABBER EXTRUSIONS.SLDDRW, Corrected bucketgrabber 2.SLDDRW]
2018-10-09 A13 DONE
    [A013 HOPPER ASSEMBLY.SLDASM, hopper assembly.SLDDRW]
2018-10-09 0018 DONE
    [0019 BALL HOPPER.SLDDRW, the hopper - folded.SLDDRW, the hopper - unfolded.SLDDRW]
2018-10-09 0019 FINISHED
    [10-inch AL tube assembly - with motor holes.SLDASM, 11-inch AL tube - with motor hole.SLDDRW, 11-inch AL tube assembly - no motor hole.SLDASM, 11-inch AL tube assembly - with motor hole.SLDASM]
2018-10-09 0021 DONE
    [10-inch AL tube - with motor holes.SLDDRW, 10-inch AL tube - with motor holes.SLDPRT]
2018-10-09 0022 DONE
    [10-inch AL tube - no motor holes.SLDDRW, 10-inch AL tube - no motor holes.SLDPRT]
2018-10-09 0023 DONE
    [10-24 Thread 1.5 Length Socket Head Screw.SLDPRT, 10-24 Thread 2 Length Socket Head Screw.SLDPRT, 11-inch AL tube - no motor hole.SLDDRW, 11-inch AL tube - no motor hole.SLDPRT, hopper assembly.SLDDRW]
2018-10-09 A15 DONE
    [PLATFORM WITH WHEELS.SLDASM, Platform with Wheels and Control Box.SLDDRW, WASHER.SLDPRT]
2018-10-09 0017 DONE
    [Control Box.SLDDRW]
2018-10-09 did mates
    [10-24 Thread 1.25 Length Socket Screw.SLDPRT, 4.5 RPM Globe Gear Motor Face Hub.SLDPRT, GM ASM.SLDASM, Linear Actuator Mount (10-24).SLDPRT]
2018-10-09 WHEEL HUB
    [M8 x 1.25 mm HEX NUT.SLDPRT, PLATFORM WITH WHEELS.SLDASM, Template for Bill of Materials.SLDDRW, Wheel Hub Assembly.SLDASM, Wheel and Motor Total Assembly.SLDASM]
2018-10-09 fixing allen's mistakes
    [80-20 Linear Slide.SLDPRT, 90272A539_ZINC-PLTD STL PAN HEAD PHILLIPS MACHINE SCREW.SLDPRT, 90272A540_ZINC-PLTD STL PAN HEAD PHILLIPS MACHINE SCREW.SLDPRT, 91306A281_ZINC-PLATED ALLOY STEEL BUTTON-HEAD CAP SCREW.SLDPRT, BM 4.5in CLAW.SLDPRT, BM Drawings.SLDDRW, BM MASTER ASM.SLDASM, GM ASM.SLDASM]
2018-10-09 doing more drawings
    [30 IPM Spal Linear Actuator.SLDDRW, 80-20 Linear Slide.SLDDRW, Linear Actuaor Mount (10-24).SLDDRW]
2018-10-10 finally done with everything
    [0.25-20 Button Head Cap Screw (BHCS).SLDPRT, 0013 10-24 x 1.25 in PHILIPS HEAD SCREW.SLDPRT, 0019 BALL HOPPER.SLDDRW, 0019 BALL HOPPER.SLDPRT, 10 Inch Wheel.SLDPRT, 10-24 HEX NUT.SLDPRT, 10-24 Thread 0.25 Length Set Screw for Bucket Motor Shaft.SLDPRT, 10-24 Thread 0.5 Inch Length Screw for Motor Hub.SLDPRT]
2018-10-10 i hate life
    [BM MASTER ASM.SLDASM, FINAL TOTAL ASSEMBLY - STRETCH.SLDDRW, GM ASM.SLDASM]
2019-02-16 Update 11-inch AL tube - no motor hole.SLDPRT
    i changed thickness
    [11-inch AL tube - no motor hole.SLDPRT]
2019-02-22 Revert "Update 11-inch AL tube - no motor hole.SLDPRT"
    This reverts commit bde37eb420f122296dfe277fe5b48bf9cb0773bf.
    [11-inch AL tube - no motor hole.SLDPRT]
